tanboga20/turboprop-from-turboshaft/docs/figures/step310/access_en.png

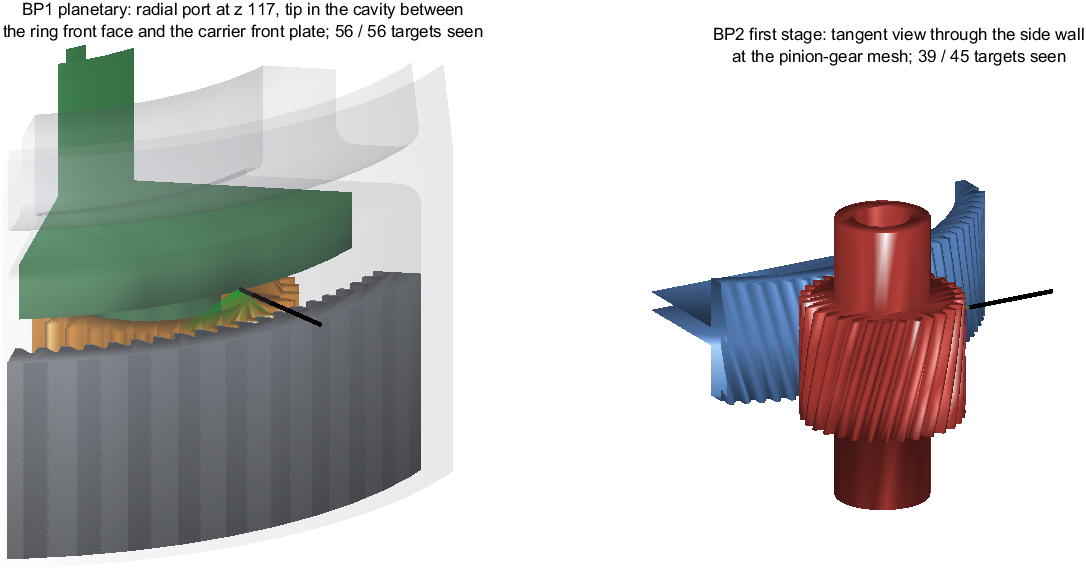
docs/figures/step310/access_en.png
