tanboga20/turboprop-from-turboshaft/cad/img/parts_strip.png

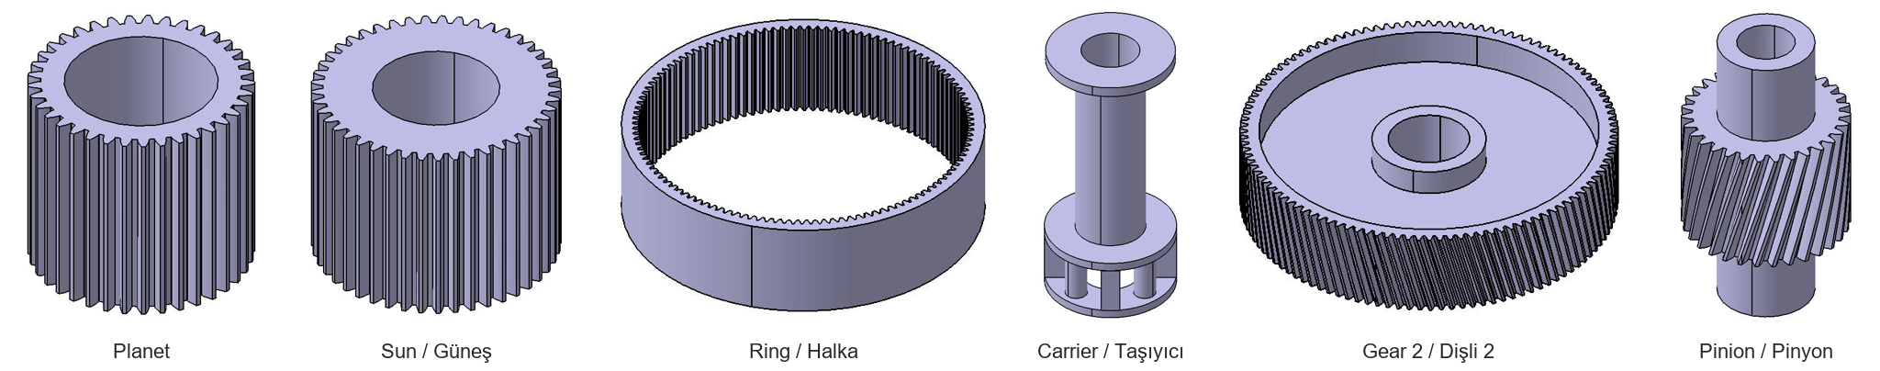
cad/img/parts_strip.png
