tanboga20/turboprop-from-turboshaft/safety/README.md

**EN.** Safety tables of step 3.7 (Phase 3): the fault tree of propeller release (SAF-01, CS-E 510), the FMEA of the RGB and its oil system, the critical parts list (SAF-02, CS-E 515), the damage tolerance results and the fire assessment (SAF-05, CS-E 130). `calc/safety/run_step37.m` writes the computed tables here; the FMEA is written by hand and checked by `calc/safety/sf_fmea.m`. The basis is Section 3.7 of the Phase 3 report.

| File | Content |
| --- | --- |
| `fta_cutsets_v1.csv` | Minimal cut sets of propeller release with their probability per engine flight hour (dual paths) or their kind (critical part, multi-fastener joint), the probability if the standby paths were never inspected and whether their inspection is an Airworthiness Limitations item |
| `fta_sensitivity_v1.csv` | Sensitivity of the fault tree: each assumed rate and demand failure x10 one at a time; the largest cut set and the inspection interval of the standby path that restores 1e-8 |
| `fta_common_cause_v1.csv` | Common-cause and zonal items with the design feature that covers each and why the independent product of the fault tree still holds (or the beta term that covers it) |
| `fta_lip_v1.csv` | Nose cover P116 with the catcher lip: LD-04 sizing of the lip (clamped annular plate) and bolts, mass, the 2-D run-down rub (shared and one-sided contact) against the hot yield, R7; the G1b QJ1024 follow-up (sf_qj): thrust floor, NJ1024 ratings, limp thrust, end play, the R4 branches, E7 p, the SYS-06 roll-up with and without the 3.9 offsets |
| `fta_e7_phases_v1.csv` | Total loss of oil (E7): the three phases (mist run, run-down to feathered, feathered) with the load path, load, QJ1024 state and probability |
| `ica_items_v1.csv` | Instructions for continued airworthiness that step 3.7 relies on (the 3.10 list): Airworthiness Limitations items, engine-manual items (CS-E 510(e)(1)) and maintenance tasks with their intervals |
| `fta_tube_check_v1.csv` | Retention tube P114 in the post-failure phase (axial anchors, no torque): stress at 1.5 x the limit thrust, and a bound with the propeller weight and the gyroscopic moment, with the reserve factors |
| `coupling_options_v1.csv`, `coupling_alignment_stack_v1.csv` | Diaphragm coupling options (H4) with the step 2.2 rules and the D4 result at the thinnest section, and the angular misalignment stack of the adopted option |
| `protection_coverage_v1.csv` | Shaft-break and load-loss protection: for each break location of the drive chain, the speed signal that detects it (3% mismatch of the core PT-rotor Np against Nr, or the absolute Np trip with a confirming cue), the PT-side inertia, the time to a closed fuel valve and the peak PT speed |
| `fta2_sensitivity_v1.csv`, `fta2_allowances_v1.csv` | D1b one-at-a-time x10 sensitivity, and the allowances (each from its own cut set) with the lowest value over the x10 cases |
| `fta2_cutsets_v1.csv` | Two dual-failure trees from the FMEA: PT overspeed (drive-chain break with the overspeed protection failed) and loss of propeller overspeed protection (PCU drive with the OSG drive failed; common cause gear 2 / intermediate shaft) |
| `fmea_v1.csv` | FMEA of the RGB and its oil system (written by hand): item, function, failure mode, cause, local / RGB / engine effect, CS-E 510 class with the design features and before them, critical part, design feature, detection, mitigation, 3.10 / 3.11 item, owner |
| `fmea_summary_v1.csv` | Failure modes per item group and class (written by `sf_fmea`) |
| `fmea_hazardous_v1.csv` | Failure modes hazardous before mitigation with the critical part or design feature that covers each |
| `fmea_major_rates_v1.csv` | Major engine effects (CS-E 510(a)(2), (a)(4)) with the FMEA rows, a rate per engine flight hour (TBR) and its source, against Remote (1e-5) |
| `critical_parts_v1.csv` | Critical parts (SAF-02, CS-E 515) and the parts judged not critical with the reason; D4 location, approved life and its basis, anomaly life, failure size on the initial shape (a/c = 1), the end point (a, c) of the growth from the governing NDT size, inspection interval, embedded-flaw margin, plan items (process controls, NDT at manufacture and at TBO, damage limits, recording loop, fixed processes, validation, life tracking, 3.11 tests) |
| `dt_v1.csv` | Damage tolerance per location (EASA CM-PIFS-007): crack plane, stress cycles on it, K at the initial flaw, threshold, anomaly life (growth from the first cycle), HCF threshold size, critical size, NDT method, the crack reached from the governing NDT size, inspection interval and NDT margin; base case and the sensitivity on C, the threshold, K_IC and a steel threshold of 2.0 at every R (reported) |
| `dt_thread_options_v1.csv` | P103 KM24 thread root: the drawing thread and the options (MJ thread, local 95 mm bore, both) against the rule a_HCF >= 1.25 x the NDT depth, with the added mass and the option adopted |
| `dt_carrier_boss_v1.csv` | P103 carrier pin bore: a_HCF, inspection interval and mass against the rim ligament with local bosses |
| `dt_m1p_v1.csv` | 1P moment sensitivity of the P103 seat, the thread, the case flange junction and the shoulder-ring groove (ICD-10 note) |
| `open_items_37.csv` | Open items of step 3.7 at the scope freeze: id, item, why open, carried to, status |
| `fire_joint_v1.csv` | The P101 / F201 joint in the fire (2-D r-z, with and without the partition): bolt-head seat on P101, insert in F201, F201 face, O-ring groove on both sides, hottest P101 and F201 temperatures; O-ring rating, hot yield at the seat and the insert, residual preload with and without the steel washer, residual clamp against the operating joint load |
| `fire_v1.csv` | Fire assessment of the A357 walls (cylindrical 1-D) in the ISO 2685 flame at its upper tolerance from the hot sink (170 degC): oil-side h of the drain film at the lowest flow (or the no-film value), 5 min with flow then the zero-flow phase; flame-side, mean and oil-side temperatures (molten: NaN), film rise, hot yield against the operating stress, secondary thermal stress, smallest passing h, oil-side temperature against the flash point and auto-ignition, times to the loss of strength and to the solidus after the flow stops |
| `nr_verification_v1.csv` | Newman-Raju K equations against the published finite-element values (NASA TP-1578 Table I, NASA TM-85793 Table 2, NASA TM-89070 Table 1) |

**TR.** 3.7 adımının (Faz 3) emniyet tabloları: pervanenin ayrılmasının hata ağacı (SAF-01, CS-E 510), RGB ve yağ sisteminin FMEA'sı, kritik parça listesi (SAF-02, CS-E 515), hasar toleransı sonuçları ve yangın değerlendirmesi (SAF-05, CS-E 130). `calc/safety/run_step37.m` hesaplanan tabloları buraya yazar; FMEA elle yazılır ve `calc/safety/sf_fmea.m` ile kontrol edilir. Esas, Faz 3 raporunun 3.7 bölümüdür.

| Dosya | İçerik |
| --- | --- |
| `fta_cutsets_v1.csv` | Pervanenin ayrılmasının en küçük kesim kümeleri; çift yollar için motor uçuş saati başına olasılık, diğerleri için türü (kritik parça, çok cıvatalı bağlantı), yedek yollar hiç muayene edilmeseydi olasılık ve muayenenin Uçuşa Elverişlilik Sınırlamaları maddesi olup olmadığı |
| `fta_sensitivity_v1.csv` | Hata ağacının duyarlılığı: her varsayılan oran ve devreye girme hasarı tek tek 10 kat; en büyük kesim kümesi ve 1e-8'i geri getiren yedek yol muayene aralığı |
| `fta_common_cause_v1.csv` | Ortak neden ve bölgesel maddeler, her birini karşılayan tasarım özelliği ve hata ağacının bağımsız çarpımının neden geçerli kaldığı (veya onu karşılayan beta terimi) |
| `fta_lip_v1.csv` | Yakalama dudaklı burun kapağı P116: dudağın (ankastre halka plak) ve cıvataların LD-04 boyutlandırması, kütle, sıcak akmaya karşı 2-B yavaşlama sürtünmesi (ortak ve tek taraflı temas), R7; G1b QJ1024 takibi (sf_qj): itki tabanı, NJ1024 kapasiteleri, topal mod itkisi, eksenel boşluk, R4 dalları, E7 p, 3.9 dengelemeleriyle ve dengelemesiz SYS-06 toplamı |
| `fta_e7_phases_v1.csv` | Tüm yağın kaybı (E7): üç evre (sis çalışması, tüylenene kadar yavaşlama, tüylenmiş) yük yolu, yük, QJ1024 durumu ve olasılıkla |
| `ica_items_v1.csv` | 3.7 adımının dayandığı sürekli uçuşa elverişlilik talimatları (3.10 listesi): Uçuşa Elverişlilik Sınırlamaları maddeleri, motor el kitabı maddeleri (CS-E 510(e)(1)) ve bakım görevleri, aralıklarıyla |
| `fta_tube_check_v1.csv` | Birincil hasardan sonra tutma tüpü P114 (eksenel bağlantılar, tork yok): 1,5 x sınır itkisinde gerilme ve pervane ağırlığı ile jiroskopik momenti de içeren üst sınır, emniyet katsayılarıyla |
| `coupling_options_v1.csv`, `coupling_alignment_stack_v1.csv` | Diyafram kavrama seçenekleri (H4), adım 2.2 kuralları ve en ince kesitte D4 sonucu, seçilen seçeneğin açısal kaçıklık zinciri |
| `protection_coverage_v1.csv` | Mil kopması ve yük kaybı koruması: tahrik zincirindeki her kırılma yeri için onu algılayan hız sinyali (çekirdek PT rotoru Np'sinin Nr ile %3 farkı veya teyitli mutlak Np kesmesi), PT tarafı ataleti, yakıt vanasının kapanma süresi ve PT tepe devri |
| `fta2_sensitivity_v1.csv`, `fta2_allowances_v1.csv` | D1b tek tek x10 duyarlılığı ve paylar (her biri kendi kesim kümesinden), x10 durumlarındaki en düşük değerle |
| `fta2_cutsets_v1.csv` | FMEA'dan iki çift hata ağacı: PT aşırı devri (tahrik zinciri kopması ve aşırı devir korumasının arızası) ve pervane aşırı devir korumasının kaybı (PCU tahriki ve OSG tahriki arızası; ortak neden dişli 2 / ara mil) |
| `fmea_v1.csv` | RGB ve yağ sisteminin FMEA'sı (elle yazılır): parça, işlev, hata modu, neden, yerel / RGB / motor etkisi, tasarım özellikleriyle ve onlarsız CS-E 510 sınıfı, kritik parça, tasarım özelliği, algılama, önlem, 3.10 / 3.11 maddesi, sahibi (İngilizce metin; madde ve mod adları Türkçe de var) |
| `fmea_summary_v1.csv` | Parça grubu ve sınıfa göre hata modu sayıları (`sf_fmea` yazar) |
| `fmea_hazardous_v1.csv` | Önlemsiz tehlikeli hata modları ve her birini karşılayan kritik parça veya tasarım özelliği |
| `fmea_major_rates_v1.csv` | Büyük motor etkileri (CS-E 510(a)(2), (a)(4)): FMEA satırları, motor uçuş saati başına oran (TBR) ve kaynağı, Remote (1e-5) sınırına göre |
| `critical_parts_v1.csv` | Kritik parçalar (SAF-02, CS-E 515) ve kritik sayılmayanlar ile gerekçesi; D4 konumu, onaylı ömür ve esası, kusur ömrü, ilk şekilde (a/c = 1) hasar boyu, belirleyici NDT boyundan büyümenin uç noktası (a, c), muayene aralığı, gömülü kusur payı, plan maddeleri (süreç kontrolleri, üretimde ve TBO'da NDT, hasar sınırları, kayıt döngüsü, sabit süreçler, doğrulama, ömür takibi, 3.11 deneyleri) |
| `dt_v1.csv` | Konum başına hasar toleransı (EASA CM-PIFS-007): çatlak düzlemi, o düzlemdeki gerilme çevrimleri, ilk kusurda K, eşik, kusur ömrü (ilk çevrimden büyüme), HCF eşik boyu, kritik boy, NDT yöntemi, belirleyici NDT boyundan ulaşılan çatlak, muayene aralığı ve NDT payı; temel durum ve C, eşik, K_IC ile her R'de 2,0 çelik eşiği (bilgi) duyarlılığı |
| `dt_thread_options_v1.csv` | P103 KM24 diş dibi: resimdeki diş ve seçenekler (MJ diş, yerel 95 mm delik, ikisi birden), a_HCF >= 1,25 x NDT derinliği kuralına göre; eklenen kütle ve seçilen seçenek |
| `dt_carrier_boss_v1.csv` | P103 taşıyıcı pim deliği: yerel çıkıntılarla dış bağ kalınlığına göre a_HCF, muayene aralığı ve kütle |
| `dt_m1p_v1.csv` | P103 yuvası, diş, gövde flanş birleşimi ve omuz halkası kanalının 1P momenti duyarlılığı (ICD-10 notu) |
| `open_items_37.csv` | 3.7'nin kapsam dondurmadaki açık maddeleri: kimlik, madde, neden açık, taşındığı yer, durum |
| `fire_joint_v1.csv` | Yangında P101 / F201 birleşimi (2-B r-z, bölmeli ve bölmesiz): P101'de cıvata başı yuvası, F201'de insert, F201 yüzü, iki taraftaki O-ring kanalı, en sıcak P101 ve F201 sıcaklıkları; O-ring sınırı, yuva ve insertte sıcak akma, çelik pulla ve pulsuz kalan ön yük, işletme bağlantı yüküne karşı kalan sıkma |
| `fire_v1.csv` | A357 duvarlarının (silindirik 1-B) üst toleranstaki ISO 2685 alevinde, sıcak batmadan (170 °C) yangın değerlendirmesi: en düşük akışta boşaltma filminin (ya da filmsiz değerin) yağ tarafı h'si, 5 dk akışla ve ardından akışsız evre; alev tarafı, ortalama ve yağ tarafı sıcaklıkları (eriyik: NaN), film ısınması, işletme gerilmesine karşı sıcak akma, ikincil ısıl gerilme, geçen en küçük h, yağ tarafı sıcaklığının parlama ve kendiliğinden tutuşma noktalarına göre durumu, akış durduktan sonra dayanım kaybına ve katılaşmaya kadar süreler |
| `nr_verification_v1.csv` | Newman-Raju K denklemlerinin yayımlanmış sonlu eleman değerleriyle karşılaştırması (NASA TP-1578 Tablo I, NASA TM-85793 Tablo 2, NASA TM-89070 Tablo 1) |

FMEA notes. Installation fire assumptions: the designated fire zone, fire detection and extinguishing are aircraft items declared under CS-E 30; the fuel shut-off at the firewall is the aircraft's; the RGB has no oil shut-off. Every row marked latent cites an ICA task with its interval (`ica_items_v1.csv`); the maintenance-error group names its error-proofing or ICA procedure.

FMEA notları. Kurulum yangın kabulleri: tanımlı yangın bölgesi, yangın algılama ve söndürme CS-E 30 kapsamında beyan edilen uçak maddeleri; güvenlik duvarındaki yakıt kesme uçağın; RGB'de yağ kesme valfi yok. Gizli işaretli her satır aralığıyla bir KTT görevine dayanır (`ica_items_v1.csv`); bakım hatası grubu hata önleyici tasarımını veya KTT prosedürünü belirtir.
