tanboga20/turboprop-from-turboshaft/docs/notes/phase3.md

# Phase notes: Phase 3 (manufacturing documents, verification)

- 3.1 Complete CATIA model: 57 instances, 3 modules, clash 0 interference (83 intended contacts); first CAD roll-up 114.6 kg; lightening package A -> 107.7 kg; SYS-06 limit raised to 110 kg TBR (author decision). Layout: first-stage gear centre z -76, offset 146 mm (PT axis below), accessory angles generator 43 deg, PCU 124 deg.
- 3.2 Oil hardware in CATIA, network re-solved: regulating valve 550 kPa, 32 jets 536-557 kPa (1.13-6.5 x design flow), idle 296 kPa (LUB-03 >= 34.5); -40 C start: jets dry until oil ~11 C (~9 min idle) -> minimum oil temperature before power; tank within 150 mm, 32 mm suction; pump inlet 50.3 kPa abs at 45,000 ft; neg-g 11 s. LUB-07 decision: >= 6 min at 75% MCP with emergency air-oil mist (2.78 kg); analysis 6.3-6.6 min. Mass 111.1 kg.
- 3.3 ICD v1: 34 items (aircraft 9, nacelle 3, propeller 5, core 10, suppliers 6, own 1); 7 watch items (planet bearing speed 0.997 at 110%, generator dia <= 201.6 mm, PT stop >= 0.22 s, bleed air <= ~180 C, mount stiffness >= 2.1e8, neg-g <= 11 s, 1P <= 4,900 N m). Oil decision: MIL-PRF-23699 only + ground preheat (Type I at 100 C inlet gives planet L10m 5,740 h < 12,000). SYS-11 input drive <= 6 kg (5.46 kg).
- 3.4 Materials/processes/BOM 78 lines: Pyrowear 53 carburized gears (case 0.5-0.7 mm, planet ring-side needs 0.43 at LD-02), nitrided 32CrMoV13 ring, AISI 4340 carrier + 120/100 shaft, separate carburized M50NiL planet pins, Ti-6Al-4V tube, A357-T6 cases; superfinish Ra <= 0.15 um; steel seat liners; manufacturing routes for planet, carrier, planetary case.
- 3.5 3-D FE (MATLAB PDE Toolbox, quadratic tets, CATIA STEP): planetary case limit 36 MPa (yield SF 5.4 incl casting factor), seat 1.0e8 N/m, 1P fatigue 5.2; carrier LD-08 yield 3.1 (2.53 with 10 mm plates); findings: PT-axis mount puts prop load through 6 mm first-stage walls (653 MPa, SF 0.29) -> mounts moved to planetary-case flange (author decision, mount card A, ICD-24) + rear wall 16 mm; flange 30 x M6 slip safety 0.52 -> 6 x d10 dowels; NU1024 boss +3.8 mm; 2.8 load-direction error corrected. Mass card B: carrier plates 10 mm -> roll-up 108.45 kg. Sun-planet S_H 1.28.
- 3.6 Forced response: TE design values 0.5/0.15/0.1 um planetary (STR-11 TE2 <= 0.15), planet modes 3,309/4,008/6,658/7,370 Hz (corrects 2.8), K_v,FE 1.11/1.37/1.14, S_F >= 1.55; planetary case coupled to planets (ring-seat receptance), steady 16.7 MPa + 12.2 MPa alternating, Goodman >= 1.19 at flange junction (hot 1.21) -> DYN-03 met TBR; design change flange PCD 290 -> 308, OD 325, R10/R5 fillets; first-stage gear web: friction damping ring 8 x 4 mm, 0.164 kg (rule s <= 0.6); first-stage case Goodman 2.54. Axisymmetric harmonic FE models (low RAM). Mass 109.24 kg.
- 3.7 Safety: FTA (AC 33.75-1A) propeller separation largest cut set 2.1e-9/h, sum 3.3e-9/h; FMEA 100 modes: 13 hazardous, 44 major, 43 minor (51 hazardous without features); 7 critical parts (PT output shaft, RGB input shaft, P103 carrier/prop shaft, P111 bearing housing, planetary case, P117 shoulder ring, two diaphragm couplings); damage tolerance CM-PIFS-007 (0.762 x 0.381 mm anomaly, Newman-Raju): shortest life 7,195 cycles vs 3,000 target; 3 locations rely on process control (HIP, CT/RT, 0.5 mm pores); fire ISO 2685 1100 C 116 kW/m2: oil-wetted walls pass 5 min, dry walls/O-rings/zero-flow open (SAF-05 open). Nose cover P116 catcher lip, NJ1024 standby, thrust floor CTL-04. 18 open items. Mass 110.10 -> 109.95 with 3.9 scallops.
- 3.8 Tolerances ASME Y14.5-2018, ISO 286, ISO 1328-1:2013 gear class, ISO 4156 splines; 5 thermal states; Monte Carlo stacks (+-3 sigma): K_gamma P99 1.257 (limit 1.35); backlash positive in cold start; ring seat closed to LD-02; 72 callouts; lip gap conflict -> 0.80-1.00 mm at 20 C on drawing (3.9).
- 3.9 Representative drawing set: planet P107, carrier/prop shaft P103, planetary case P101, RGB assembly (89-line parts list); 114-row drawing checklist; views from Phase 2 model (OI-16), tables govern.
- 3.10 HUMS synthetic signal; FM4/NA4 alarm at crack a 0.05; ENV at spall b 0.5 m/s2; SER weak (sequential phasing cancels order 45); thresholds log-normal pfa 1e-3/1e-6 from 50 records; borescope BP1 56/56, BP2 39/45; maintenance tasks: RGB off 2.6 h + on 4.7 h = 7.3 h; MNT-01 8 h TBR.
- 3.11 Verification: 69 reqs, 39 need test; 25 tests (2 coupon, 1 inspection, 11 rig, 10 engine, 1 demonstration); water-brake test cell 9 measuring point groups; 6-stage sequence.
- 3.12 Comparison (TCDS): ratio 12.93 vs 15.90 (CT7-9) vs 17.58 (PT6A-67A); gearbox mass derived CT7-9 170.5 kg (upper bound), PT6A-67A 57-72 kg; ours 109.95 at top of CT7-9 scaled band 95-110; 8.14 kW/kg vs 7.65; planetary module 66.4 kg in PT6A band; engine ~315 kg dry, +85.5 kg vs PT6A-67A (3.2% of 2,700 kg payload).
- v4: 69 req (3 new SYS-11, STR-11, CTL-04; 10 changed); Agreed 28 / TBR 34 / TBD 7; compliance met 34, partial 19, open 7, tbd 9, risk 0; closure test 52, shown 19, ICD 26.
- Scan findings (honest limits): mass margin 0.05 kg; OI-15 mount reaction 7.45-7.49 kN m vs 6.4 kN m in ICD-24 (flange clamp margin ~2.5x, not rechecked); SAF-05 fire seals; CAD still Phase 2 geometry for later changes (OI-16).
