tanboga20/turboprop-from-turboshaft/cad/assy/clash_report.csv

first | second | type | value_mm
i1_case | i2_ring | contact | 0.000
i1_case | i14_brg_NU1024 | contact | 0.000
i1_case | i15_brg_NU1024 | contact | 0.000
i1_case | i16_brg_QJ1024 | contact | 0.000
i1_case | i17_qj_housing | contact | 0.000
i1_case | i22_fs_case | contact | 0.000
i1_case | i1014_oil_jet_060 | clash | -9.833
i1_case | i1015_oil_jet_060 | clash | -9.833
i1_case | i1035_oil_route_11 | clash | -36.203
i1_case | i1036_oil_route_12 | clash | -71.106
i1_case | i1037_oil_transfer_sleeve | contact | 0.000
i1_case | i1043_oil_chip_detector | clash | -14.568
i2_ring | i6_planet | contact | 0.000
i2_ring | i8_planet | contact | 0.000
i2_ring | i10_planet | contact | 0.000
i2_ring | i12_planet | contact | 0.000
i3_carrier | i7_planet_rollers | contact | 0.000
i3_carrier | i9_planet_rollers | contact | 0.000
i3_carrier | i11_planet_rollers | contact | 0.000
i3_carrier | i13_planet_rollers | contact | 0.000
i3_carrier | i14_brg_NU1024 | contact | 0.000
i3_carrier | i15_brg_NU1024 | contact | 0.000
i3_carrier | i16_brg_QJ1024 | contact | 0.000
i3_carrier | i18_nut_KM24 | contact | 0.000
i3_carrier | i21_prop_flange | contact | 0.000
i3_carrier | i1017_oil_jet_066 | clash | -7.706
i3_carrier | i1018_oil_jet_066 | clash | -7.706
i3_carrier | i1019_oil_jet_066 | clash | -7.706
i3_carrier | i1020_oil_jet_066 | clash | -7.706
i3_carrier | i1021_oil_jet_066 | clash | -7.706
i3_carrier | i1022_oil_jet_066 | clash | -7.706
i3_carrier | i1023_oil_jet_066 | clash | -7.706
i3_carrier | i1024_oil_jet_066 | clash | -7.706
i3_carrier | i1036_oil_route_12 | clash | -53.103
i3_carrier | i1037_oil_transfer_sleeve | contact | 0.000
i4_sun | i5_sun_quill | contact | 0.000
i4_sun | i6_planet | contact | 0.000
i4_sun | i8_planet | contact | 0.000
i4_sun | i10_planet | contact | 0.000
i4_sun | i12_planet | contact | 0.000
i5_sun_quill | i25_mid_shaft | contact | 0.000
i6_planet | i7_planet_rollers | contact | 0.000
i7_planet_rollers | i1036_oil_route_12 | contact | 0.000
i8_planet | i9_planet_rollers | contact | 0.000
i9_planet_rollers | i1036_oil_route_12 | contact | 0.000
i10_planet | i11_planet_rollers | contact | 0.000
i11_planet_rollers | i1036_oil_route_12 | contact | 0.000
i12_planet | i13_planet_rollers | contact | 0.000
i13_planet_rollers | i1036_oil_route_12 | contact | 0.000
i14_brg_NU1024 | i1014_oil_jet_060 | contact | 0.000
i15_brg_NU1024 | i1015_oil_jet_060 | contact | 0.000
i16_brg_QJ1024 | i17_qj_housing | contact | 0.000
i16_brg_QJ1024 | i18_nut_KM24 | contact | 0.000
i16_brg_QJ1024 | i1016_oil_jet_060 | contact | 0.000
i17_qj_housing | i19_seal_prop | contact | 0.000
i17_qj_housing | i1016_oil_jet_060 | clash | -7.424
i17_qj_housing | i1035_oil_route_11 | clash | -14.073
i22_fs_case | i26_brg_NU2210 | contact | 0.000
i22_fs_case | i27_brg_NU2209 | contact | 0.000
i22_fs_case | i28_brg_NU2210 | contact | 0.000
i22_fs_case | i29_brg_NU2209 | contact | 0.000
i22_fs_case | i30_brg_QJ210 | contact | 0.000
i22_fs_case | i31_brg_QJ209 | contact | 0.000
i22_fs_case | i35_acc_cover | contact | 0.000
i22_fs_case | i38_gen_cartridge | contact | 0.000
i22_fs_case | i39_brg_6305 | contact | 0.000
i22_fs_case | i44_osg_adapter | contact | 0.000
i22_fs_case | i45_brg_6202 | contact | 0.000
i22_fs_case | i50_brg_6203 | contact | 0.000
i22_fs_case | i1003_oil_jet_084 | clash | -9.883
i22_fs_case | i1004_oil_jet_084 | clash | -9.883
i22_fs_case | i1005_oil_jet_084 | clash | -9.883
i22_fs_case | i1006_oil_jet_060 | clash | -8.600
i22_fs_case | i1007_oil_jet_060 | clash | -8.600
i22_fs_case | i1008_oil_jet_060 | clash | -8.600
i22_fs_case | i1012_oil_jet_060 | clash | -8.577
i22_fs_case | i1025_oil_route_01 | clash | -27.041
i22_fs_case | i1026_oil_route_02 | clash | -65.237
i22_fs_case | i1027_oil_route_03 | clash | -4.516
i22_fs_case | i1028_oil_route_04 | clash | -74.029
i22_fs_case | i1029_oil_route_05 | clash | -47.915
i22_fs_case | i1030_oil_route_06 | clash | -34.949
i22_fs_case | i1032_oil_route_08 | clash | -38.672
i22_fs_case | i1033_oil_route_09 | contact | 0.000
i22_fs_case | i1042_oil_chip_detector | clash | -14.419
i22_fs_case | i1045_oil_sample_valve | clash | -15.652
i23_gear2 | i24_pinion | contact | 0.000
i23_gear2 | i25_mid_shaft | contact | 0.000
i23_gear2 | i36_gen_gear | contact | 0.000
i24_pinion | i27_brg_NU2209 | contact | 0.000
i24_pinion | i29_brg_NU2209 | contact | 0.000
i24_pinion | i31_brg_QJ209 | contact | 0.000
i24_pinion | i33_nut_KM9 | contact | 0.000
i24_pinion | i34_seal_input | contact | 0.000
i25_mid_shaft | i26_brg_NU2210 | contact | 0.000
i25_mid_shaft | i28_brg_NU2210 | contact | 0.000
i25_mid_shaft | i30_brg_QJ210 | contact | 0.000
i25_mid_shaft | i32_nut_KM10 | contact | 0.000
i25_mid_shaft | i48_pcu_gear | contact | 0.000
i25_mid_shaft | i54_quill_pump | contact | 0.000
i26_brg_NU2210 | i1006_oil_jet_060 | contact | 0.000
i27_brg_NU2209 | i1003_oil_jet_084 | contact | 0.000
i27_brg_NU2209 | i1042_oil_chip_detector | contact | 0.000
i28_brg_NU2210 | i30_brg_QJ210 | contact | 0.000
i28_brg_NU2210 | i1007_oil_jet_060 | contact | 0.000
i29_brg_NU2209 | i31_brg_QJ209 | contact | 0.000
i29_brg_NU2209 | i1004_oil_jet_084 | contact | 0.000
i30_brg_QJ210 | i32_nut_KM10 | contact | 0.000
i30_brg_QJ210 | i1008_oil_jet_060 | contact | 0.000
i31_brg_QJ209 | i33_nut_KM9 | contact | 0.000
i31_brg_QJ209 | i1005_oil_jet_084 | contact | 0.000
i35_acc_cover | i49_pcu_adapter | contact | 0.000
i35_acc_cover | i51_brg_6203 | contact | 0.000
i35_acc_cover | i53_pump_pack | contact | 0.000
i35_acc_cover | i1031_oil_route_07 | clash | -22.037
i35_acc_cover | i1033_oil_route_09 | contact | 0.000
i35_acc_cover | i1034_oil_route_10 | clash | -16.805
i36_gen_gear | i37_gen_shaft | contact | 0.000
i37_gen_shaft | i39_brg_6305 | contact | 0.000
i37_gen_shaft | i40_brg_6305 | contact | 0.000
i37_gen_shaft | i42_quill_gen | contact | 0.000
i37_gen_shaft | i43_osg_gear | contact | 0.000
i38_gen_cartridge | i40_brg_6305 | contact | 0.000
i38_gen_cartridge | i55_unit_generator | contact | 0.000
i38_gen_cartridge | i1013_oil_jet_060 | clash | -9.850
i38_gen_cartridge | i1032_oil_route_08 | clash | -11.612
i38_gen_cartridge | i1033_oil_route_09 | clash | -7.565
i39_brg_6305 | i1012_oil_jet_060 | contact | 0.000
i40_brg_6305 | i1013_oil_jet_060 | contact | 0.000
i43_osg_gear | i45_brg_6202 | contact | 0.000
i43_osg_gear | i46_brg_6202 | contact | 0.000
i43_osg_gear | i47_quill_osg | contact | 0.000
i44_osg_adapter | i46_brg_6202 | contact | 0.000
i44_osg_adapter | i56_unit_OSG | contact | 0.000
i48_pcu_gear | i50_brg_6203 | contact | 0.000
i48_pcu_gear | i51_brg_6203 | contact | 0.000
i48_pcu_gear | i52_quill_pcu | contact | 0.000
i49_pcu_adapter | i51_brg_6203 | contact | 0.000
i49_pcu_adapter | i57_unit_PCU | contact | 0.000
i53_pump_pack | i54_quill_pump | contact | 0.000
i53_pump_pack | i1034_oil_route_10 | contact | 0.000
i55_unit_generator | i1033_oil_route_09 | contact | 0.000
i1001_oil_jet_102 | i1025_oil_route_01 | contact | 0.000
i1002_oil_jet_155 | i1026_oil_route_02 | contact | 0.000
i1003_oil_jet_084 | i1027_oil_route_03 | contact | 0.000
i1004_oil_jet_084 | i1027_oil_route_03 | contact | 0.000
i1005_oil_jet_084 | i1027_oil_route_03 | contact | 0.000
i1006_oil_jet_060 | i1028_oil_route_04 | contact | 0.000
i1007_oil_jet_060 | i1028_oil_route_04 | contact | 0.000
i1008_oil_jet_060 | i1028_oil_route_04 | contact | 0.000
i1009_oil_jet_060 | i1029_oil_route_05 | contact | 0.000
i1010_oil_jet_060 | i1030_oil_route_06 | contact | 0.000
i1011_oil_jet_060 | i1031_oil_route_07 | contact | 0.000
i1012_oil_jet_060 | i1032_oil_route_08 | contact | 0.000
i1013_oil_jet_060 | i1032_oil_route_08 | contact | 0.000
i1014_oil_jet_060 | i1035_oil_route_11 | contact | 0.000
i1015_oil_jet_060 | i1035_oil_route_11 | contact | 0.000
i1016_oil_jet_060 | i1035_oil_route_11 | clash | -3.498
i1017_oil_jet_066 | i1036_oil_route_12 | clash | -1.824
i1018_oil_jet_066 | i1036_oil_route_12 | clash | -1.824
i1019_oil_jet_066 | i1036_oil_route_12 | clash | -1.824
i1020_oil_jet_066 | i1036_oil_route_12 | clash | -1.824
i1021_oil_jet_066 | i1036_oil_route_12 | clash | -1.824
i1022_oil_jet_066 | i1036_oil_route_12 | clash | -1.824
i1023_oil_jet_066 | i1036_oil_route_12 | clash | -1.824
i1024_oil_jet_066 | i1036_oil_route_12 | clash | -1.824
i1025_oil_route_01 | i1026_oil_route_02 | clash | -7.800
i1025_oil_route_01 | i1027_oil_route_03 | clash | -7.447
i1025_oil_route_01 | i1028_oil_route_04 | clash | -7.424
i1025_oil_route_01 | i1029_oil_route_05 | clash | -7.447
i1025_oil_route_01 | i1030_oil_route_06 | clash | -7.447
i1025_oil_route_01 | i1031_oil_route_07 | contact | 0.000
i1025_oil_route_01 | i1032_oil_route_08 | clash | -7.447
i1025_oil_route_01 | i1033_oil_route_09 | contact | 0.000
i1025_oil_route_01 | i1034_oil_route_10 | contact | 0.000
i1025_oil_route_01 | i1035_oil_route_11 | clash | -7.353
i1025_oil_route_01 | i1036_oil_route_12 | clash | -7.353
i1025_oil_route_01 | i1039_oil_prv | clash | -3.594
i1026_oil_route_02 | i1027_oil_route_03 | clash | -7.471
i1026_oil_route_02 | i1028_oil_route_04 | clash | -7.424
i1026_oil_route_02 | i1029_oil_route_05 | clash | -7.400
i1026_oil_route_02 | i1030_oil_route_06 | clash | -7.424
i1026_oil_route_02 | i1031_oil_route_07 | contact | 0.000
i1026_oil_route_02 | i1032_oil_route_08 | clash | -7.447
i1026_oil_route_02 | i1033_oil_route_09 | contact | 0.000
i1026_oil_route_02 | i1034_oil_route_10 | contact | 0.000
i1026_oil_route_02 | i1035_oil_route_11 | clash | -7.353
i1026_oil_route_02 | i1036_oil_route_12 | clash | -7.353
i1026_oil_route_02 | i1039_oil_prv | clash | -3.594
i1027_oil_route_03 | i1028_oil_route_04 | clash | -7.400
i1027_oil_route_03 | i1029_oil_route_05 | clash | -7.400
i1027_oil_route_03 | i1030_oil_route_06 | clash | -7.447
i1027_oil_route_03 | i1031_oil_route_07 | contact | 0.000
i1027_oil_route_03 | i1032_oil_route_08 | clash | -7.377
i1027_oil_route_03 | i1033_oil_route_09 | contact | 0.000
i1027_oil_route_03 | i1034_oil_route_10 | contact | 0.000
i1027_oil_route_03 | i1035_oil_route_11 | clash | -7.330
i1027_oil_route_03 | i1036_oil_route_12 | clash | -7.330
i1027_oil_route_03 | i1039_oil_prv | clash | -3.498
i1027_oil_route_03 | i1040_oil_thermostat | clash | -3.594
i1028_oil_route_04 | i1029_oil_route_05 | clash | -7.377
i1028_oil_route_04 | i1030_oil_route_06 | clash | -7.377
i1028_oil_route_04 | i1031_oil_route_07 | contact | 0.000
i1028_oil_route_04 | i1032_oil_route_08 | clash | -7.306
i1028_oil_route_04 | i1033_oil_route_09 | contact | 0.000
i1028_oil_route_04 | i1034_oil_route_10 | contact | 0.000
i1028_oil_route_04 | i1035_oil_route_11 | clash | -7.235
i1028_oil_route_04 | i1036_oil_route_12 | clash | -7.235
i1028_oil_route_04 | i1039_oil_prv | clash | -3.450
i1028_oil_route_04 | i1040_oil_thermostat | clash | -3.450
i1029_oil_route_05 | i1030_oil_route_06 | clash | -7.424
i1029_oil_route_05 | i1031_oil_route_07 | contact | 0.000
i1029_oil_route_05 | i1032_oil_route_08 | clash | -7.400
i1029_oil_route_05 | i1033_oil_route_09 | contact | 0.000
i1029_oil_route_05 | i1034_oil_route_10 | contact | 0.000
i1029_oil_route_05 | i1035_oil_route_11 | clash | -7.377
i1029_oil_route_05 | i1036_oil_route_12 | clash | -7.377
i1029_oil_route_05 | i1039_oil_prv | clash | -3.594
i1030_oil_route_06 | i1031_oil_route_07 | contact | 0.000
i1030_oil_route_06 | i1032_oil_route_08 | clash | -7.447
i1030_oil_route_06 | i1033_oil_route_09 | contact | 0.000
i1030_oil_route_06 | i1034_oil_route_10 | contact | 0.000
i1030_oil_route_06 | i1035_oil_route_11 | clash | -7.377
i1030_oil_route_06 | i1036_oil_route_12 | clash | -7.377
i1030_oil_route_06 | i1039_oil_prv | clash | -3.498
i1030_oil_route_06 | i1040_oil_thermostat | clash | -3.594
i1031_oil_route_07 | i1032_oil_route_08 | contact | 0.000
i1031_oil_route_07 | i1033_oil_route_09 | clash | -7.353
i1031_oil_route_07 | i1034_oil_route_10 | clash | -7.471
i1031_oil_route_07 | i1035_oil_route_11 | contact | 0.000
i1031_oil_route_07 | i1036_oil_route_12 | contact | 0.000
i1031_oil_route_07 | i1039_oil_prv | clash | -3.450
i1031_oil_route_07 | i1041_oil_filter | clash | -3.594
i1032_oil_route_08 | i1033_oil_route_09 | contact | 0.000
i1032_oil_route_08 | i1034_oil_route_10 | contact | 0.000
i1032_oil_route_08 | i1035_oil_route_11 | clash | -7.377
i1032_oil_route_08 | i1036_oil_route_12 | clash | -7.377
i1032_oil_route_08 | i1039_oil_prv | clash | -3.498
i1032_oil_route_08 | i1040_oil_thermostat | clash | -3.594
i1033_oil_route_09 | i1034_oil_route_10 | clash | -7.400
i1033_oil_route_09 | i1035_oil_route_11 | contact | 0.000
i1033_oil_route_09 | i1036_oil_route_12 | contact | 0.000
i1033_oil_route_09 | i1039_oil_prv | clash | -3.498
i1033_oil_route_09 | i1041_oil_filter | clash | -3.594
i1034_oil_route_10 | i1035_oil_route_11 | contact | 0.000
i1034_oil_route_10 | i1036_oil_route_12 | contact | 0.000
i1034_oil_route_10 | i1039_oil_prv | clash | -3.450
i1034_oil_route_10 | i1041_oil_filter | clash | -3.546
i1035_oil_route_11 | i1036_oil_route_12 | clash | -7.612
i1035_oil_route_11 | i1039_oil_prv | clash | -3.498
i1035_oil_route_11 | i1040_oil_thermostat | clash | -3.642
i1036_oil_route_12 | i1037_oil_transfer_sleeve | clash | -12.106
i1036_oil_route_12 | i1039_oil_prv | clash | -3.498
i1036_oil_route_12 | i1040_oil_thermostat | clash | -3.642
i1039_oil_prv | i1041_oil_filter | contact | 0.000
i1039_oil_prv | i1049_lub07_lines | clash | -2.634
i1047_lub07_valve | i1049_lub07_lines | clash | -20.028
i1048_lub07_accumulator | i1049_lub07_lines | contact | 0.000
