tanboga20/turboprop-from-turboshaft/cad/img/acc_cover_back.png

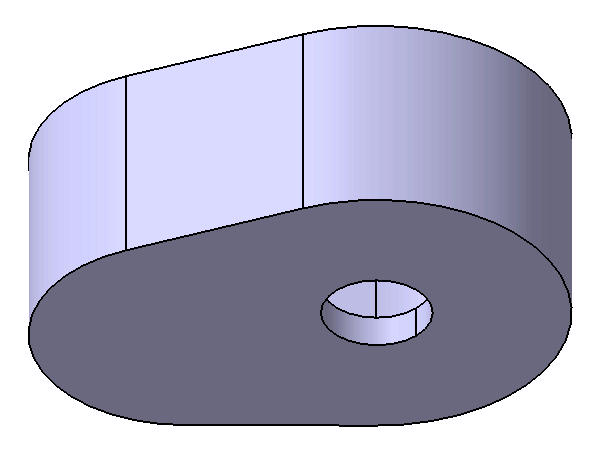
cad/img/acc_cover_back.png
