tanboga20/turboprop-from-turboshaft/cad/img/acc_cover_iso.png

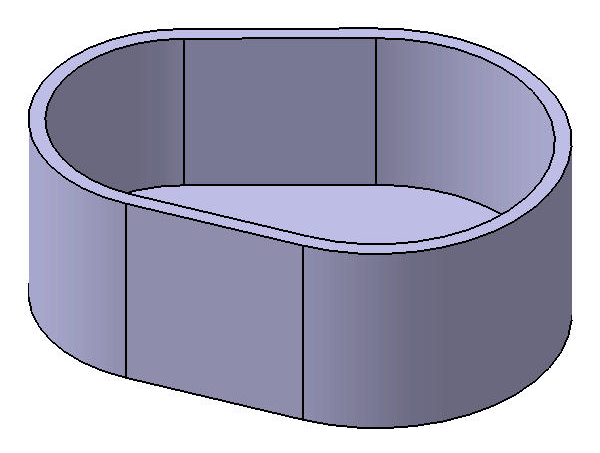
cad/img/acc_cover_iso.png
