tanboga20/turboprop-from-turboshaft/cad/img/carrier_iso.png

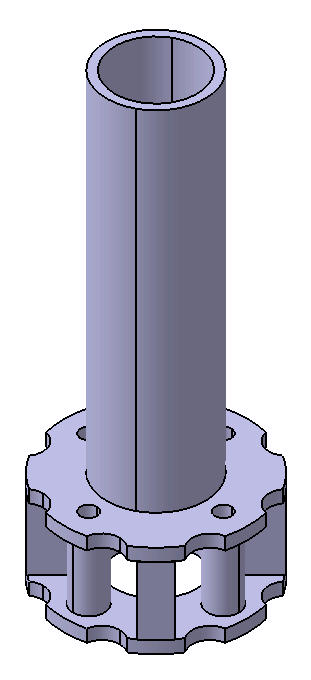
cad/img/carrier_iso.png
