tanboga20/turboprop-from-turboshaft/cad/img/case_back.png

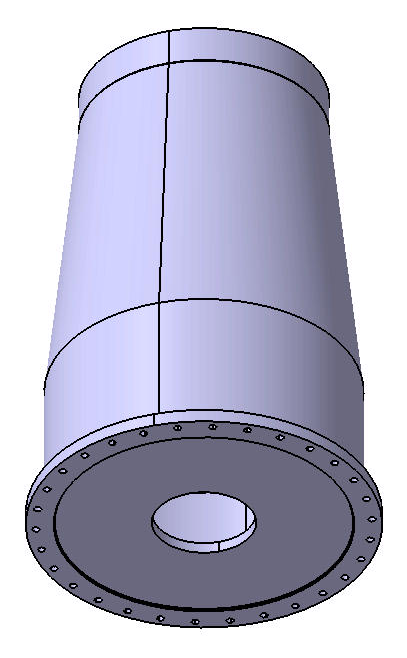
cad/img/case_back.png
