tanboga20/turboprop-from-turboshaft/cad/img/case_iso.png

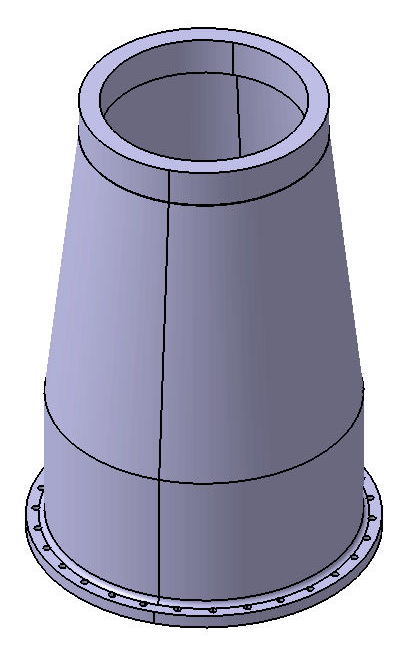
cad/img/case_iso.png
