tanboga20/turboprop-from-turboshaft/cad/img/case_side.png

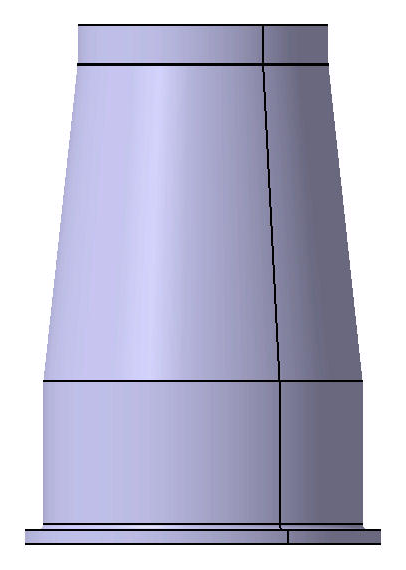
cad/img/case_side.png
