tanboga20/turboprop-from-turboshaft/cad/img/fs_case_back.png

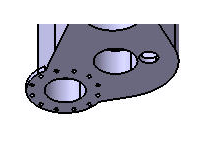
cad/img/fs_case_back.png
