tanboga20/turboprop-from-turboshaft/cad/img/fs_case_iso.png

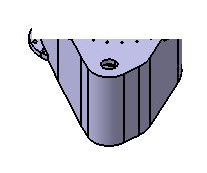
cad/img/fs_case_iso.png
