tanboga20/turboprop-from-turboshaft/cad/img/gear2_iso.png

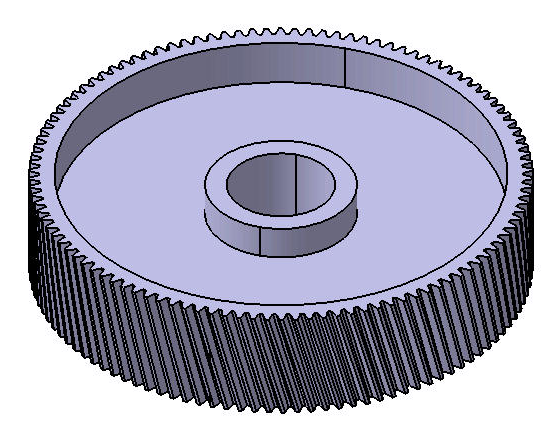
cad/img/gear2_iso.png
