tanboga20/turboprop-from-turboshaft/cad/img/gen_gear_iso.png

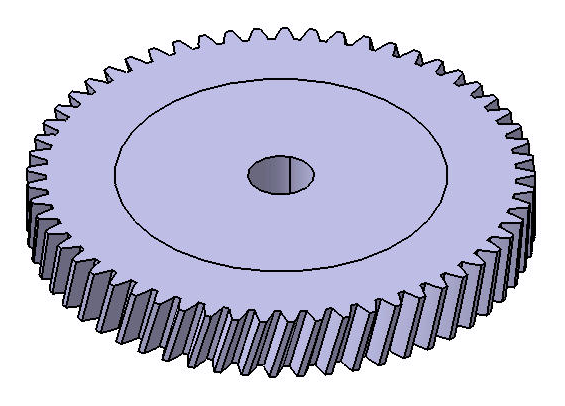
cad/img/gen_gear_iso.png
