tanboga20/turboprop-from-turboshaft/cad/img/pinion_iso.png

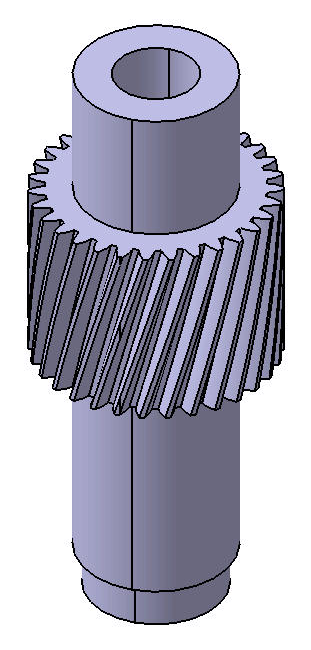
cad/img/pinion_iso.png
