tanboga20/turboprop-from-turboshaft/cad/img/planet_iso.png

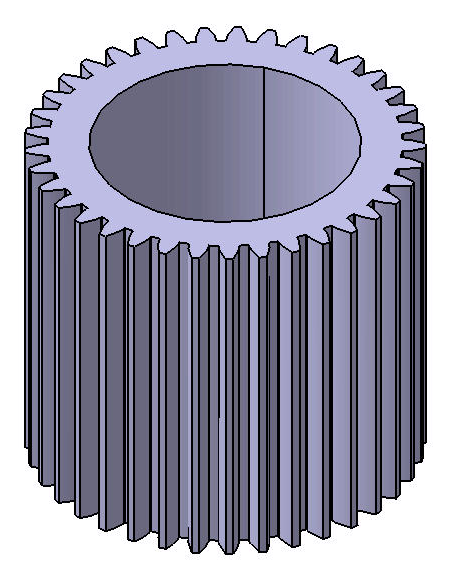
cad/img/planet_iso.png
