tanboga20/turboprop-from-turboshaft/cad/img/rgb3_back.png

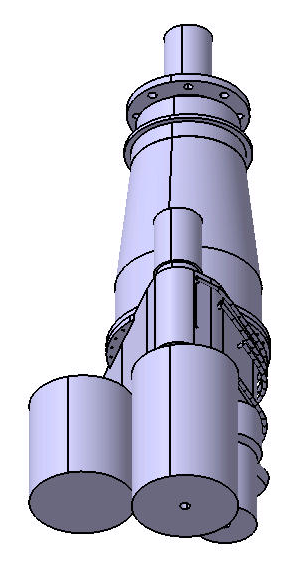
cad/img/rgb3_back.png
