tanboga20/turboprop-from-turboshaft/cad/img/rgb3_internals_back.png

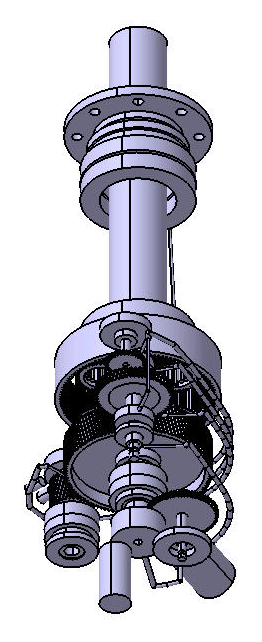
cad/img/rgb3_internals_back.png
