tanboga20/turboprop-from-turboshaft/cad/img/rgb3_internals_iso.png

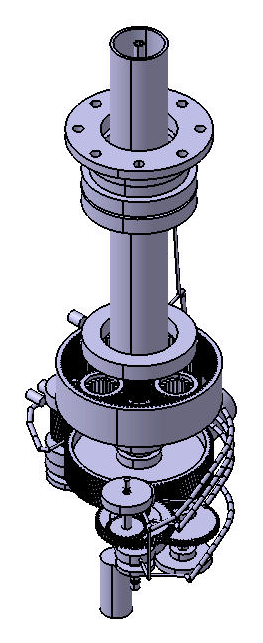
cad/img/rgb3_internals_iso.png
