tanboga20/turboprop-from-turboshaft/cad/img/rgb3_internals_side.png

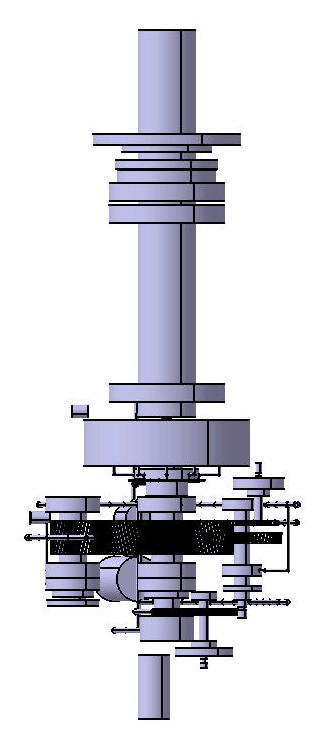
cad/img/rgb3_internals_side.png
