tanboga20/turboprop-from-turboshaft/cad/img/rgb3_iso.png

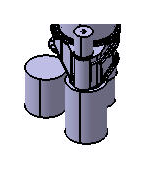
cad/img/rgb3_iso.png
