tanboga20/turboprop-from-turboshaft/cad/img/rgb3_noequip_front.png

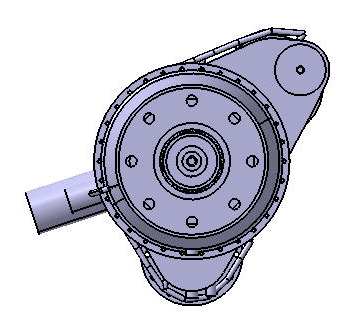
cad/img/rgb3_noequip_front.png
