tanboga20/turboprop-from-turboshaft/cad/img/rgb3_noequip_iso.png

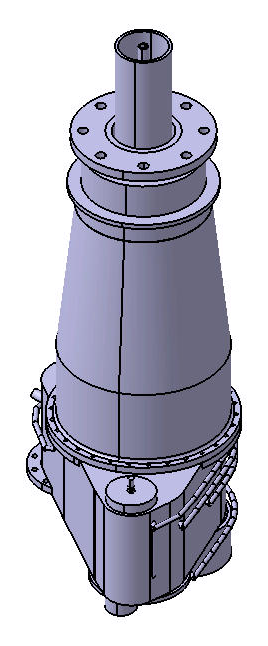
cad/img/rgb3_noequip_iso.png
