tanboga20/turboprop-from-turboshaft/cad/img/rgb3_noequip_side.png

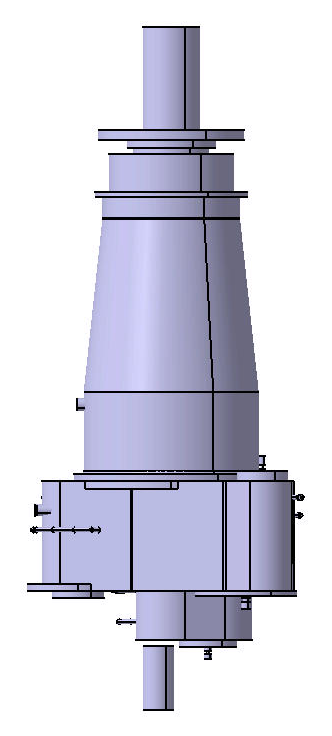
cad/img/rgb3_noequip_side.png
