tanboga20/turboprop-from-turboshaft/cad/img/ring_iso.png

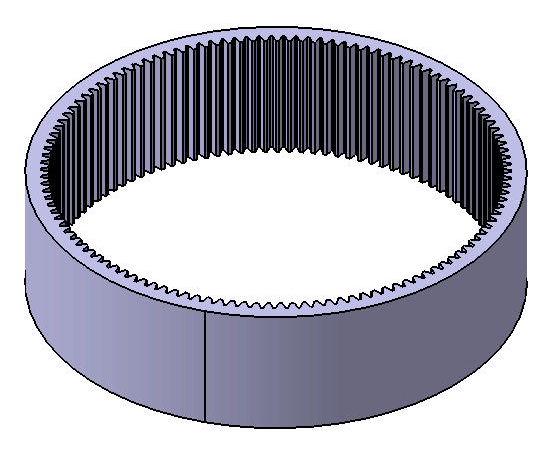
cad/img/ring_iso.png
