tanboga20/turboprop-from-turboshaft/cad/img/sun_iso.png

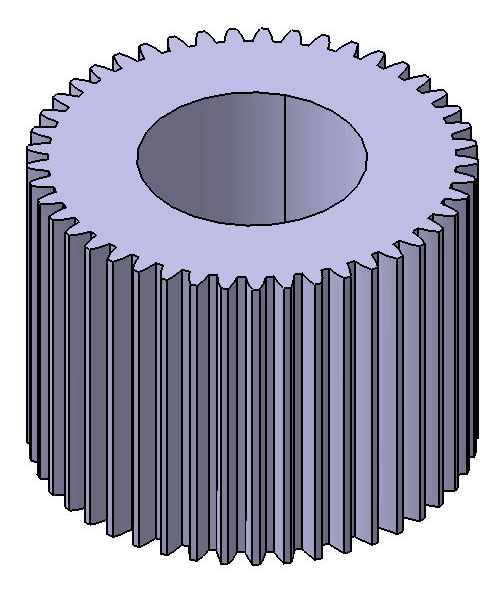
cad/img/sun_iso.png
