tanboga20/turboprop-from-turboshaft/docs/figures/overview/compliance_en.png

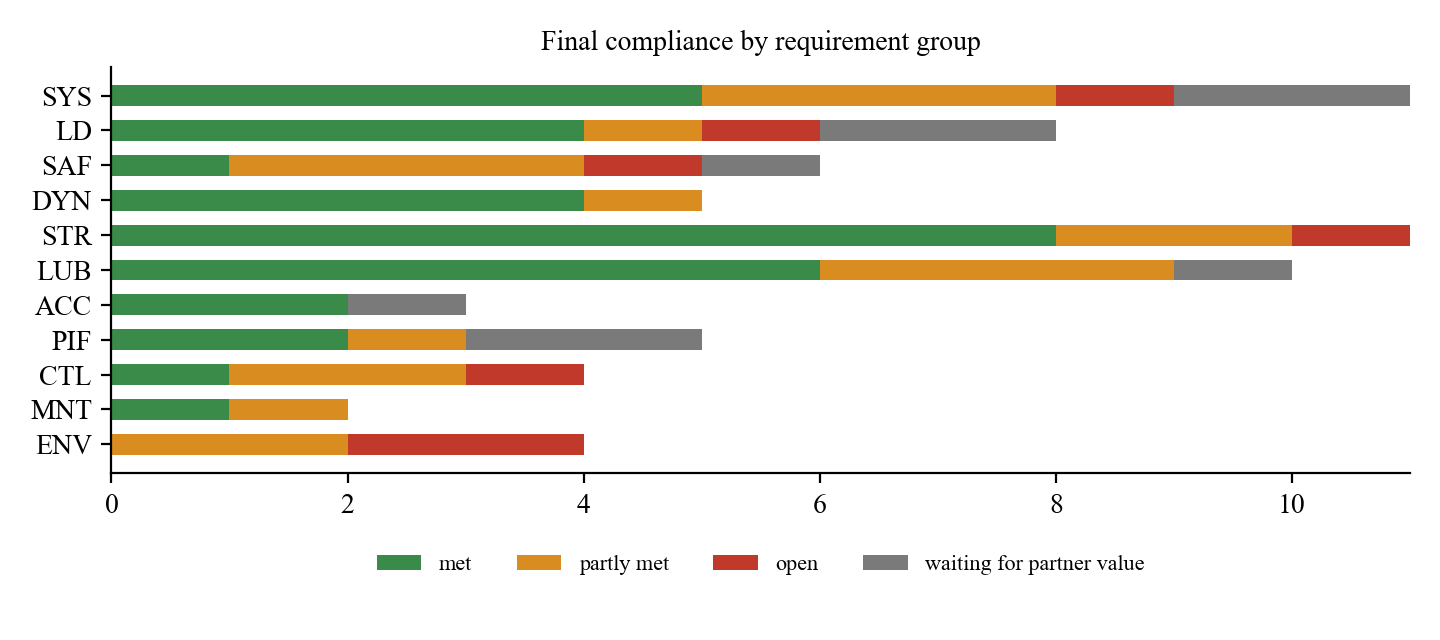
docs/figures/overview/compliance_en.png
