tanboga20/turboprop-from-turboshaft/docs/figures/overview/masshist_tr.png

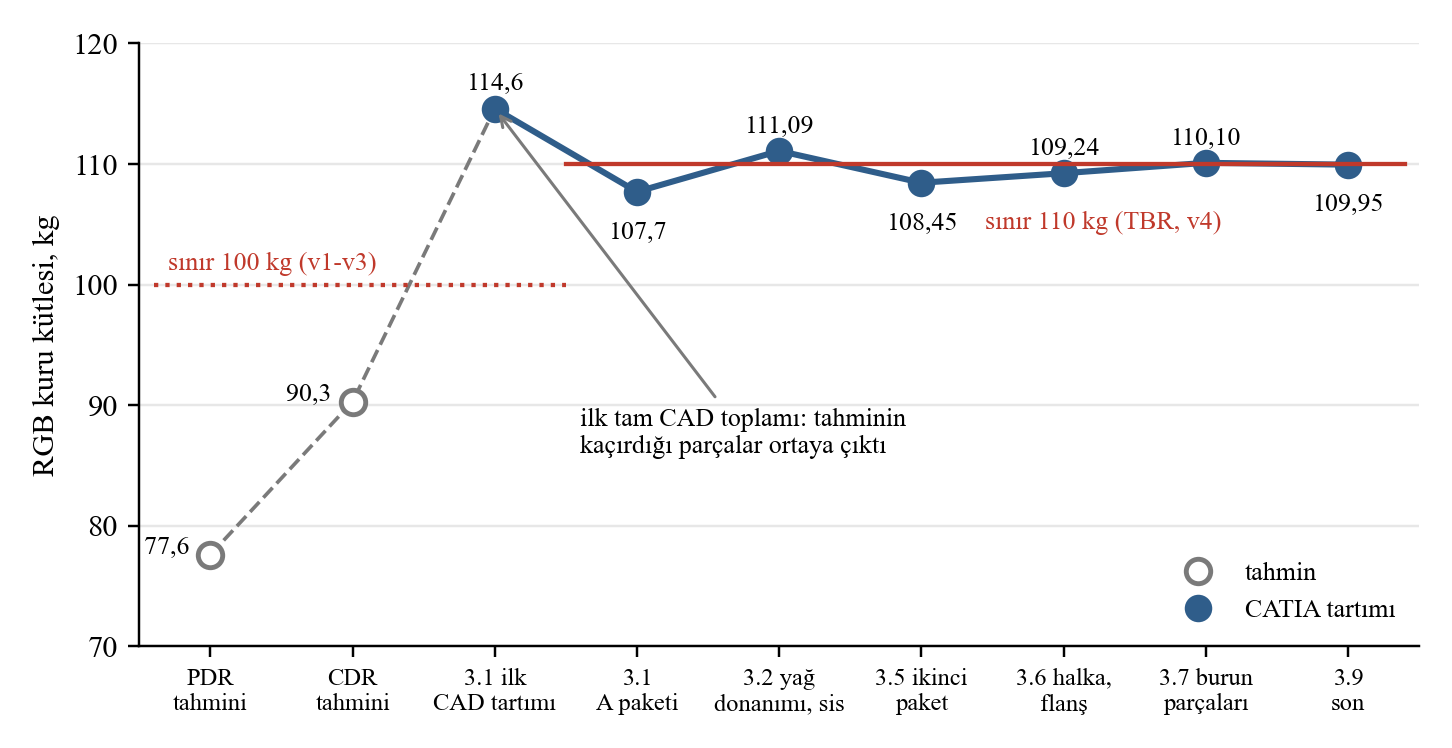
docs/figures/overview/masshist_tr.png
