tanboga20/turboprop-from-turboshaft/docs/figures/phases/en/p0_cert_chain.png

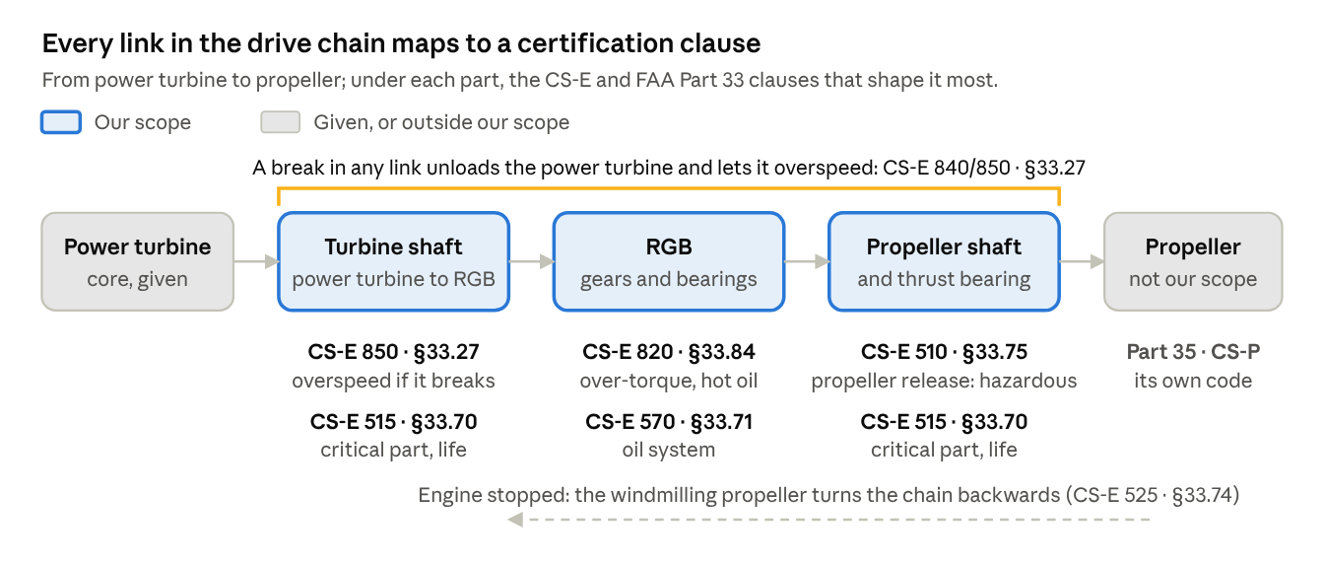
docs/figures/phases/en/p0_cert_chain.png
