tanboga20/turboprop-from-turboshaft/docs/figures/phases/en/p1_loss_range.png

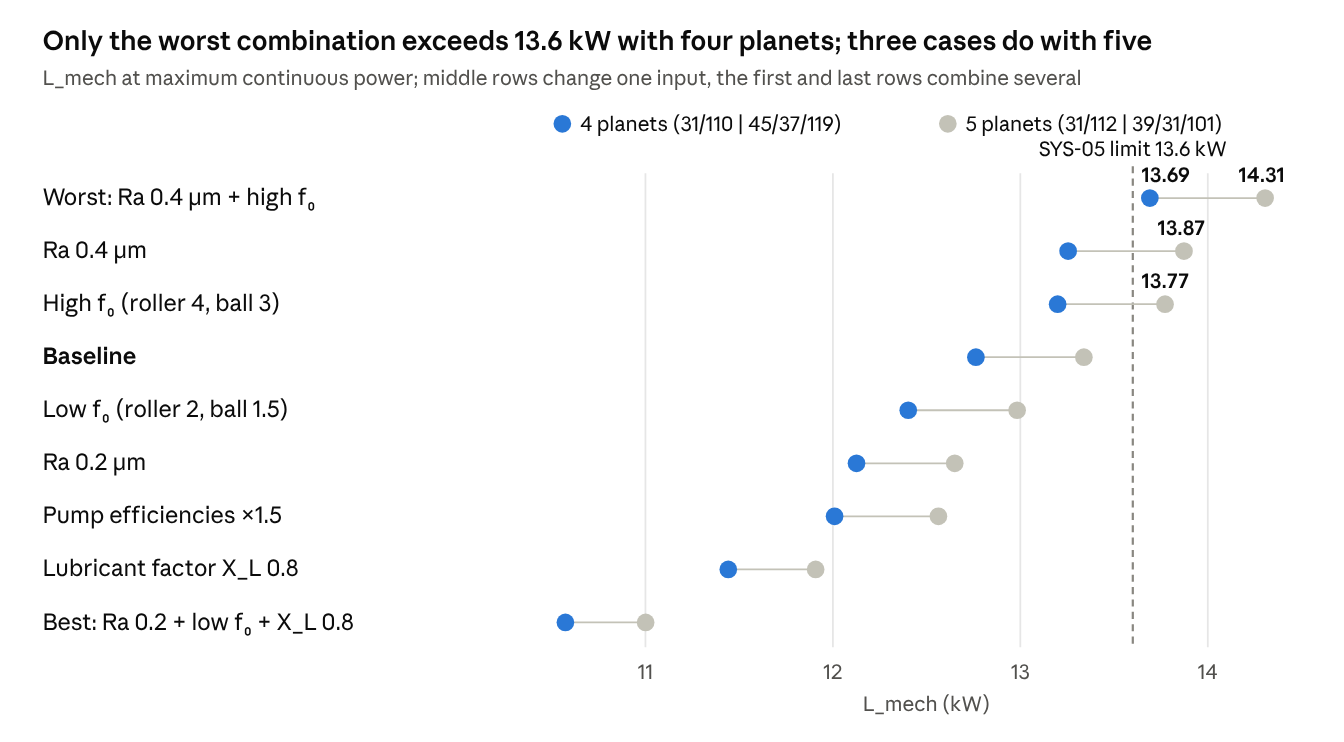
docs/figures/phases/en/p1_loss_range.png
