tanboga20/turboprop-from-turboshaft/docs/figures/phases/en/p1_pads.png

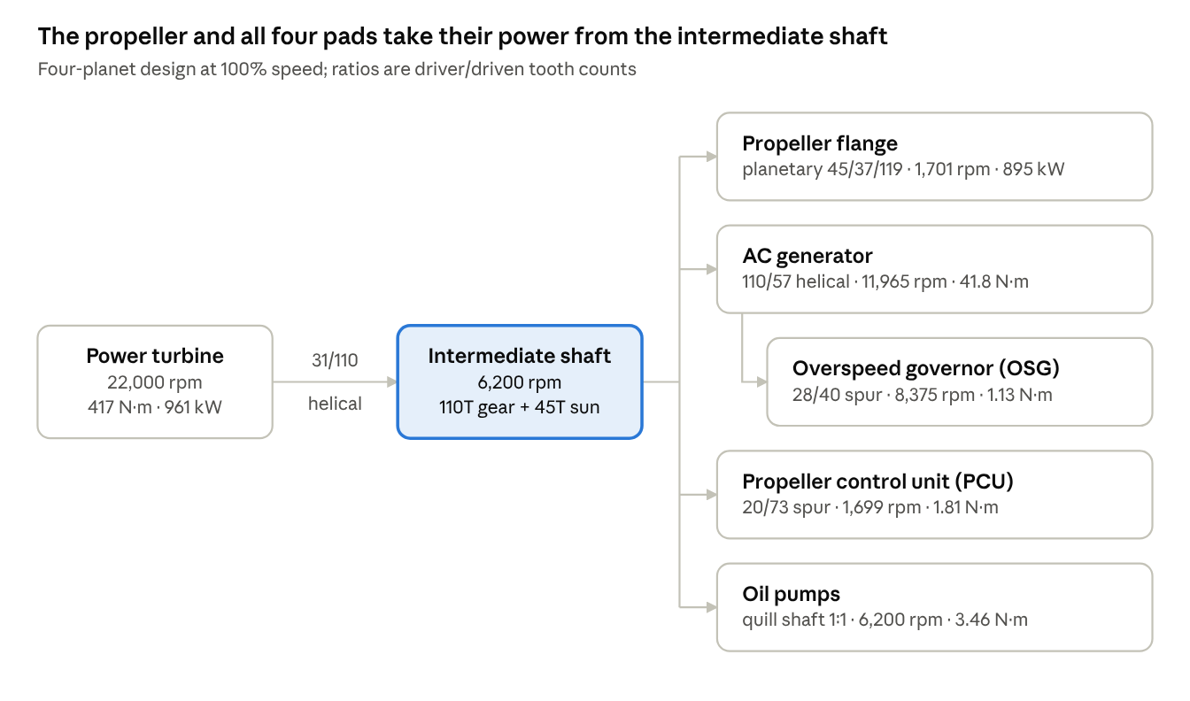
docs/figures/phases/en/p1_pads.png
