tanboga20/turboprop-from-turboshaft/docs/figures/phases/en/p2_dyn04.png

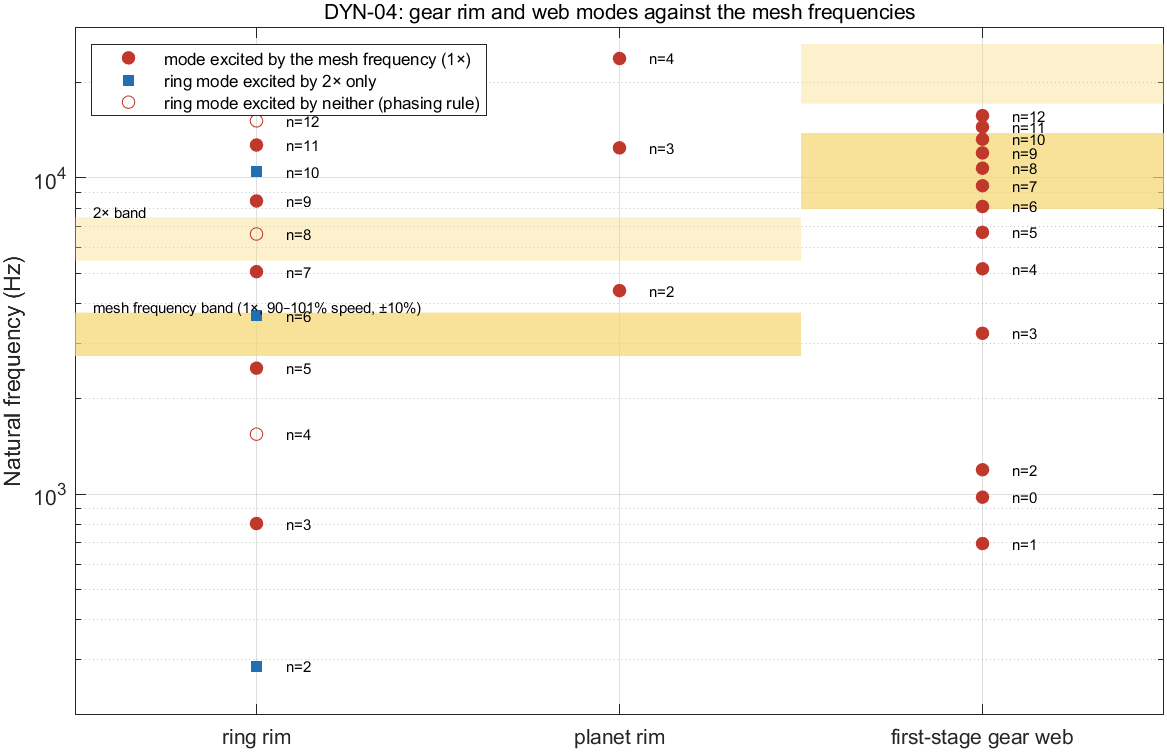
docs/figures/phases/en/p2_dyn04.png
