tanboga20/turboprop-from-turboshaft/docs/figures/phases/en/p2_gear_sf.png

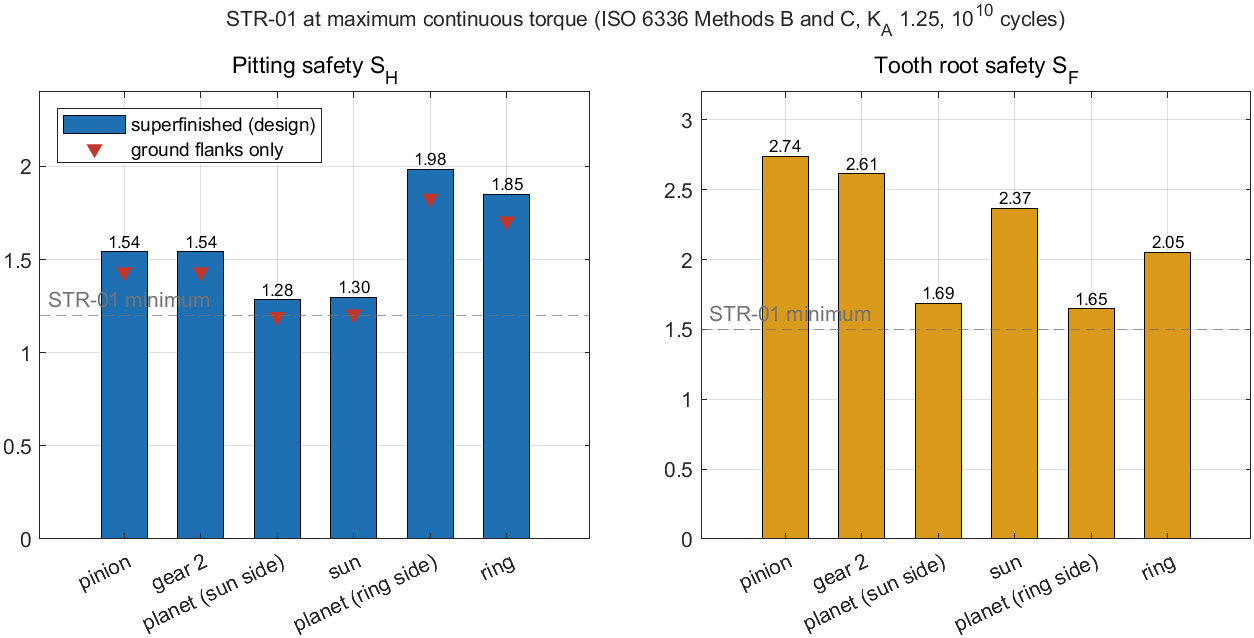
docs/figures/phases/en/p2_gear_sf.png
