tanboga20/turboprop-from-turboshaft/docs/figures/phases/en/p2_options.png

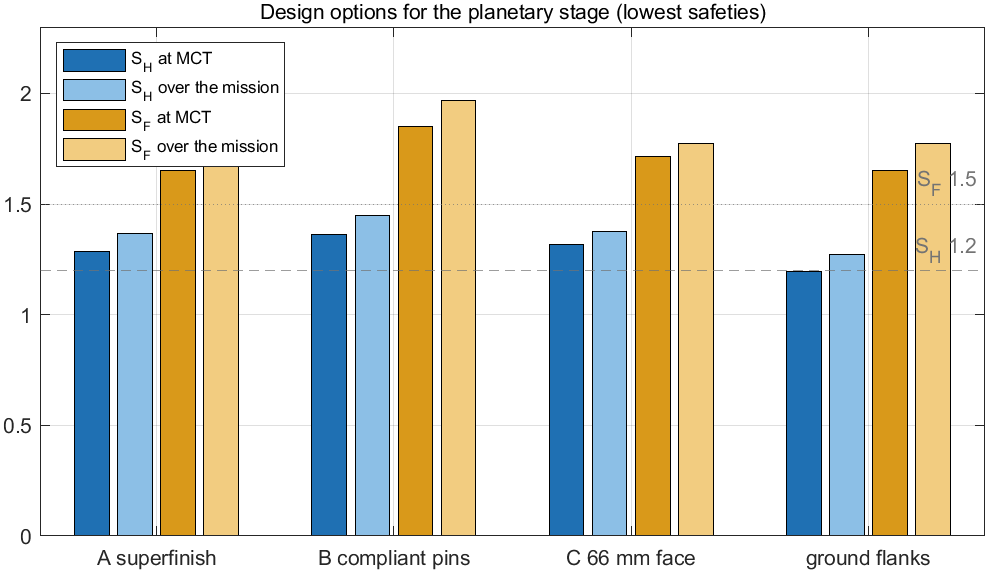
docs/figures/phases/en/p2_options.png
