tanboga20/turboprop-from-turboshaft/docs/figures/phases/en/p2_planet_mode.png

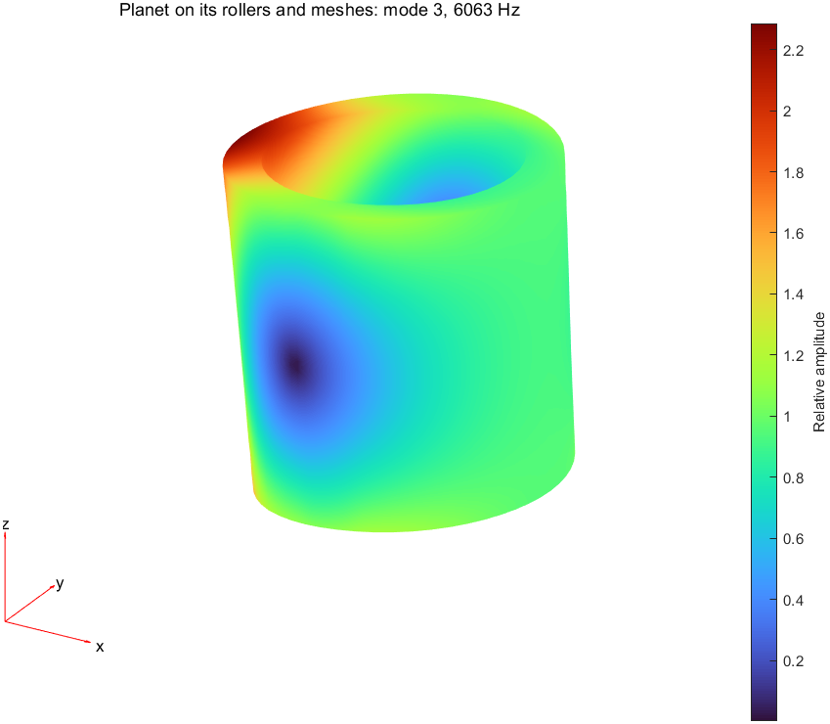
docs/figures/phases/en/p2_planet_mode.png
