tanboga20/turboprop-from-turboshaft/docs/figures/phases/en/p2_scuffing.png

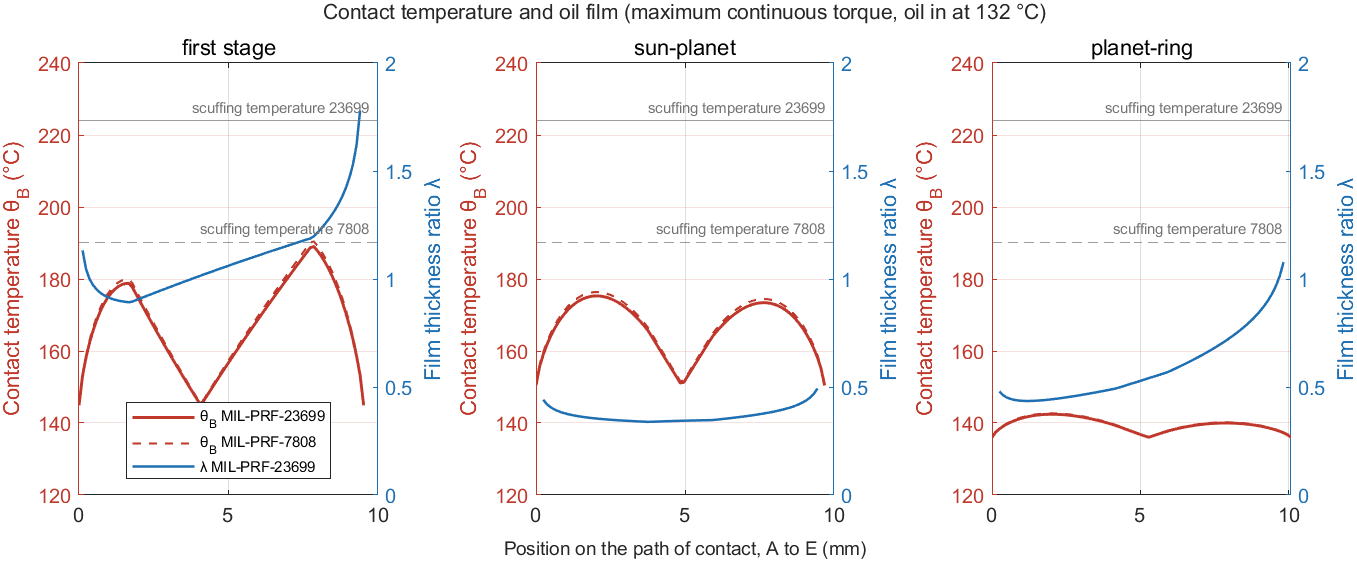
docs/figures/phases/en/p2_scuffing.png
