tanboga20/turboprop-from-turboshaft/docs/figures/phases/en/p2_sensors.png

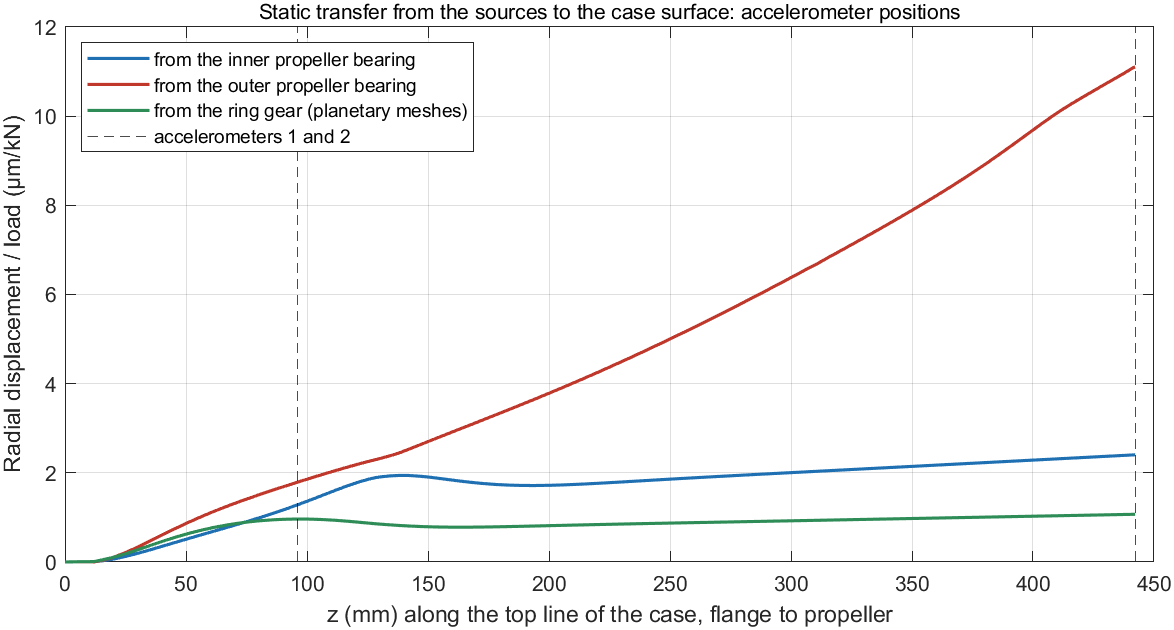
docs/figures/phases/en/p2_sensors.png
