tanboga20/turboprop-from-turboshaft/docs/figures/phases/en/p2_web_modes.png

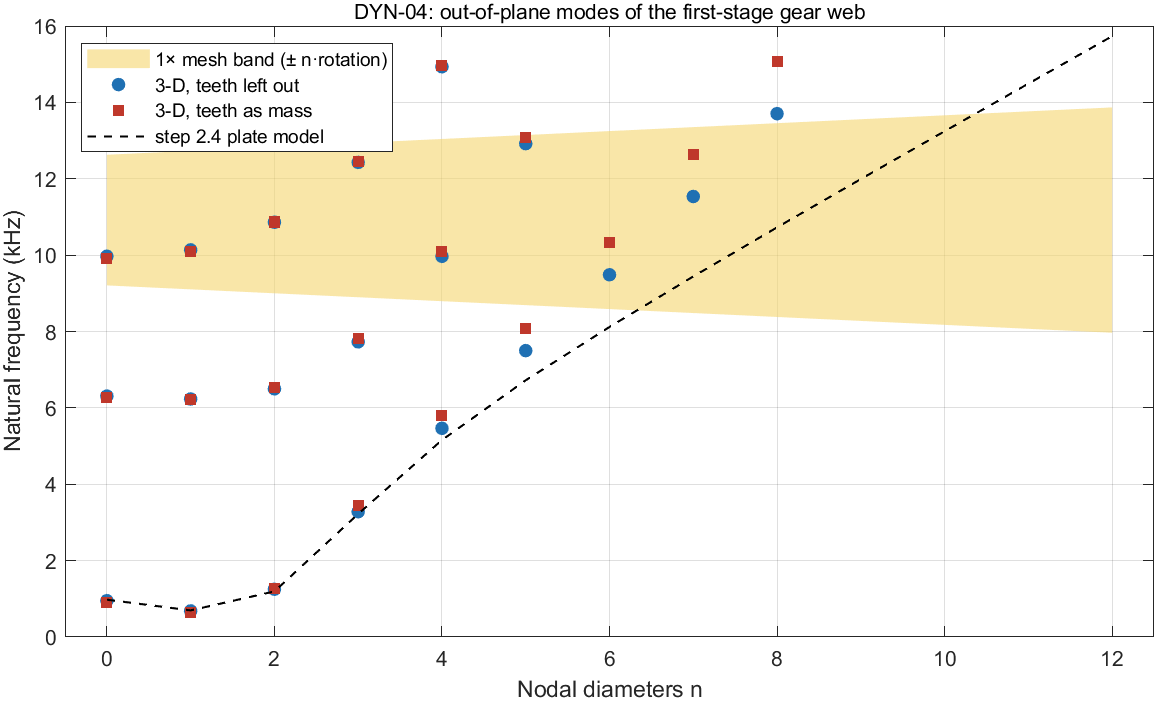
docs/figures/phases/en/p2_web_modes.png
