tanboga20/turboprop-from-turboshaft/docs/figures/phases/en/p3_layout.png

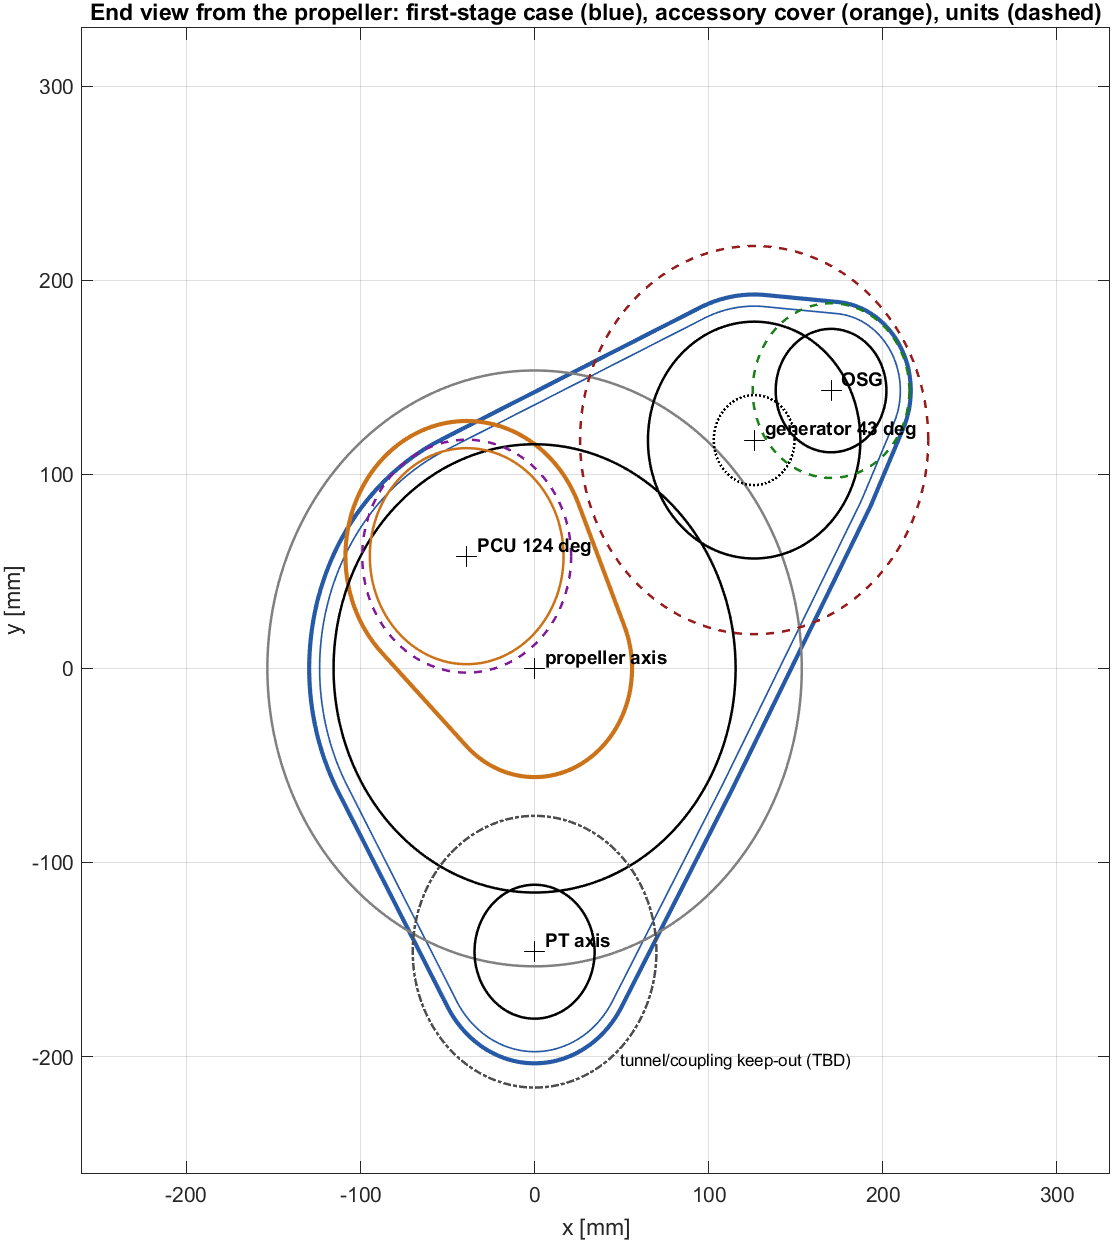
docs/figures/phases/en/p3_layout.png
