tanboga20/turboprop-from-turboshaft/docs/figures/phases/en/p3_rgb_render.png

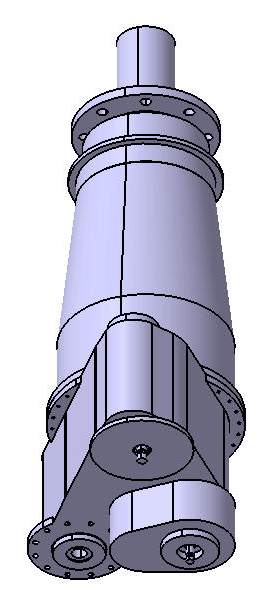
docs/figures/phases/en/p3_rgb_render.png
