tanboga20/turboprop-from-turboshaft/docs/figures/phases/tr/p0_cert_chain.png

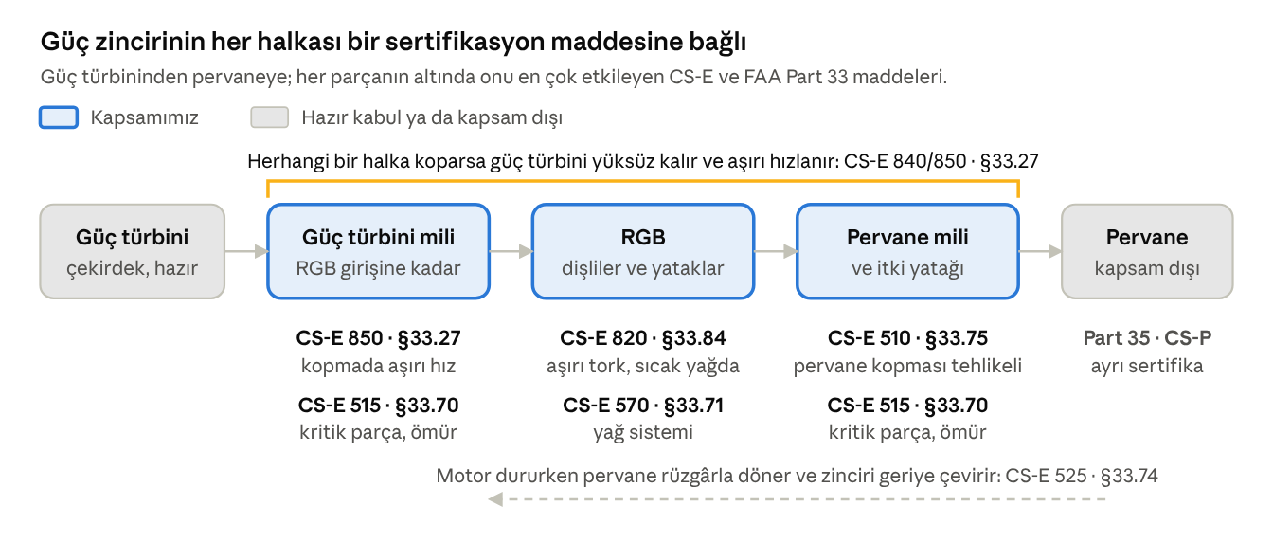
docs/figures/phases/tr/p0_cert_chain.png
