tanboga20/turboprop-from-turboshaft/docs/figures/phases/tr/p0_t700.png

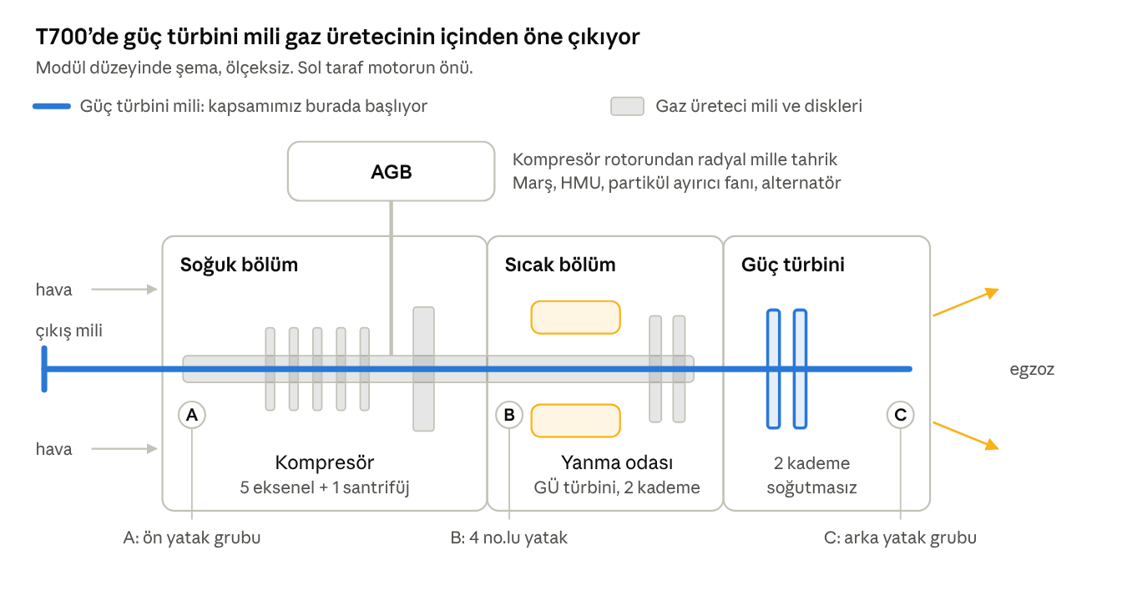
docs/figures/phases/tr/p0_t700.png
