tanboga20/turboprop-from-turboshaft/docs/figures/phases/tr/p1_loss_range.png

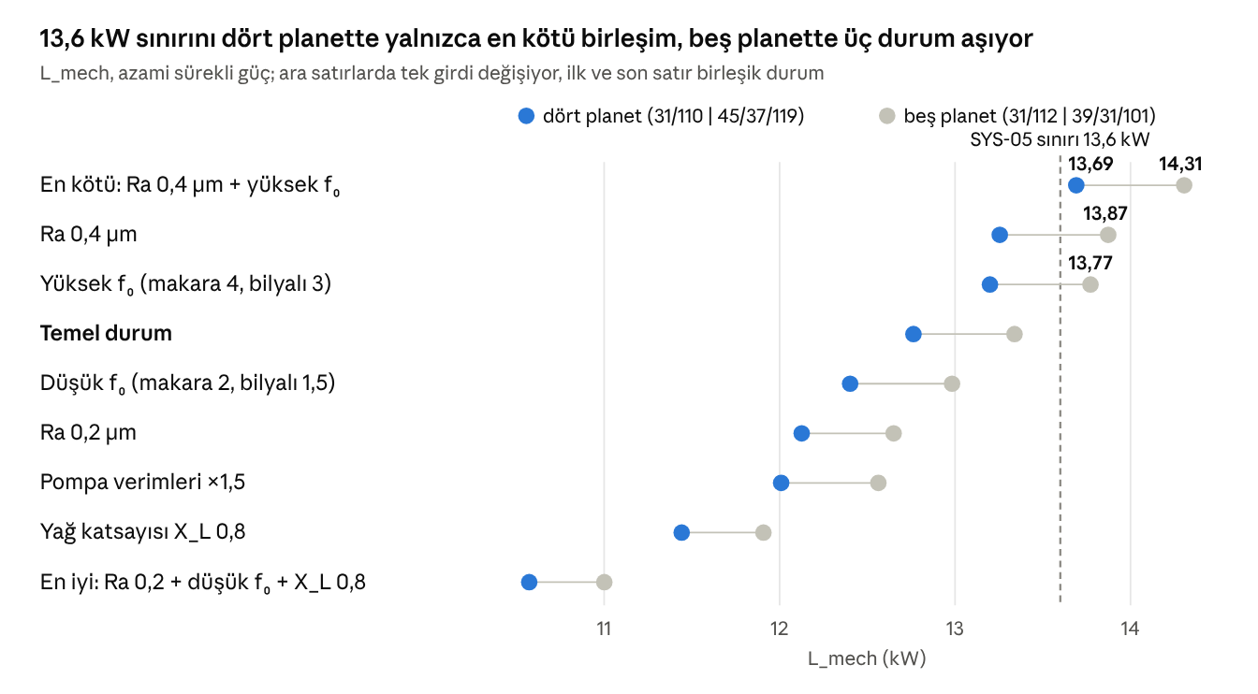
docs/figures/phases/tr/p1_loss_range.png
