tanboga20/turboprop-from-turboshaft/docs/figures/phases/tr/p1_pads.png

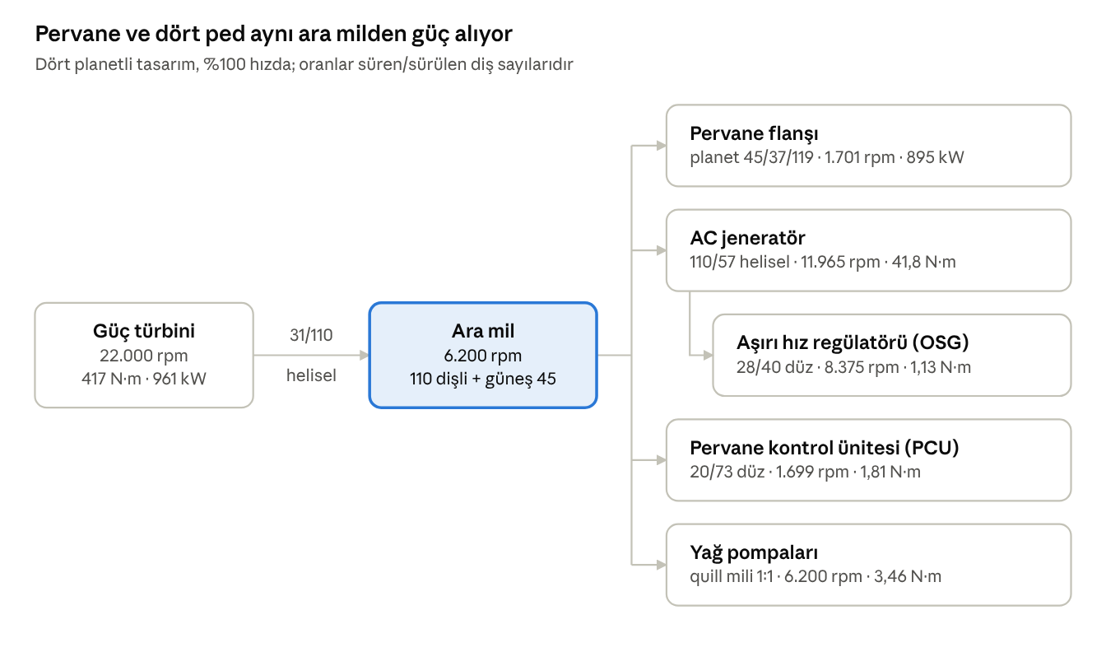
docs/figures/phases/tr/p1_pads.png
