tanboga20/turboprop-from-turboshaft/docs/figures/phases/tr/p2_scuffing.png

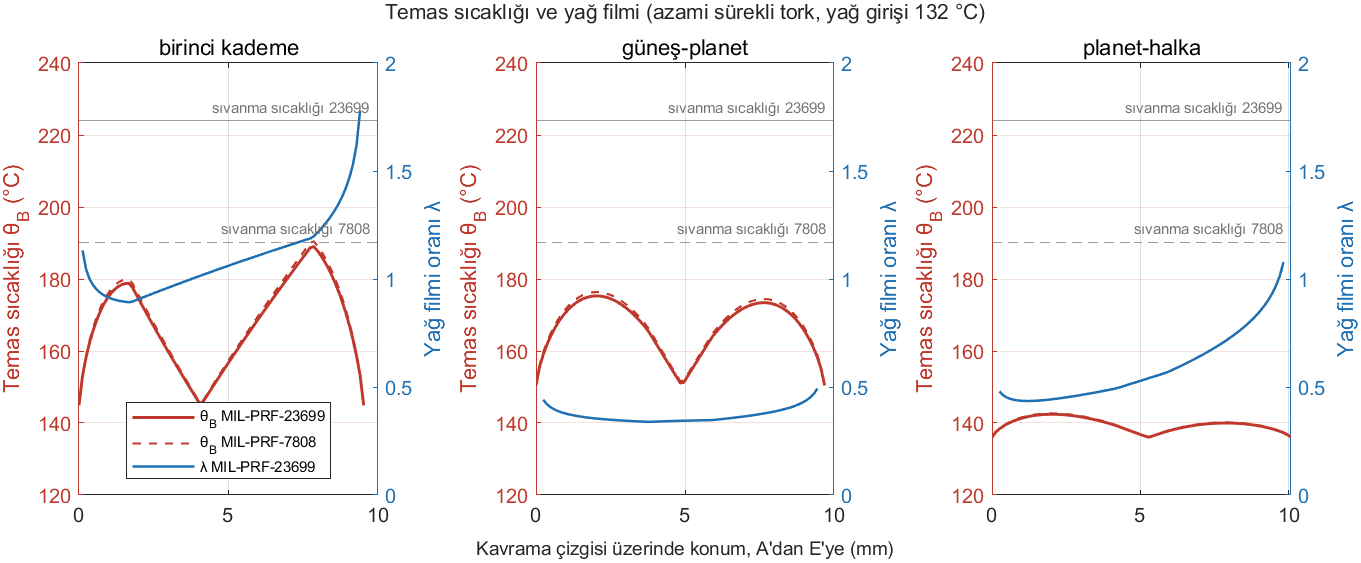
docs/figures/phases/tr/p2_scuffing.png
