tanboga20/turboprop-from-turboshaft/docs/figures/phases/tr/p2_shafts.png

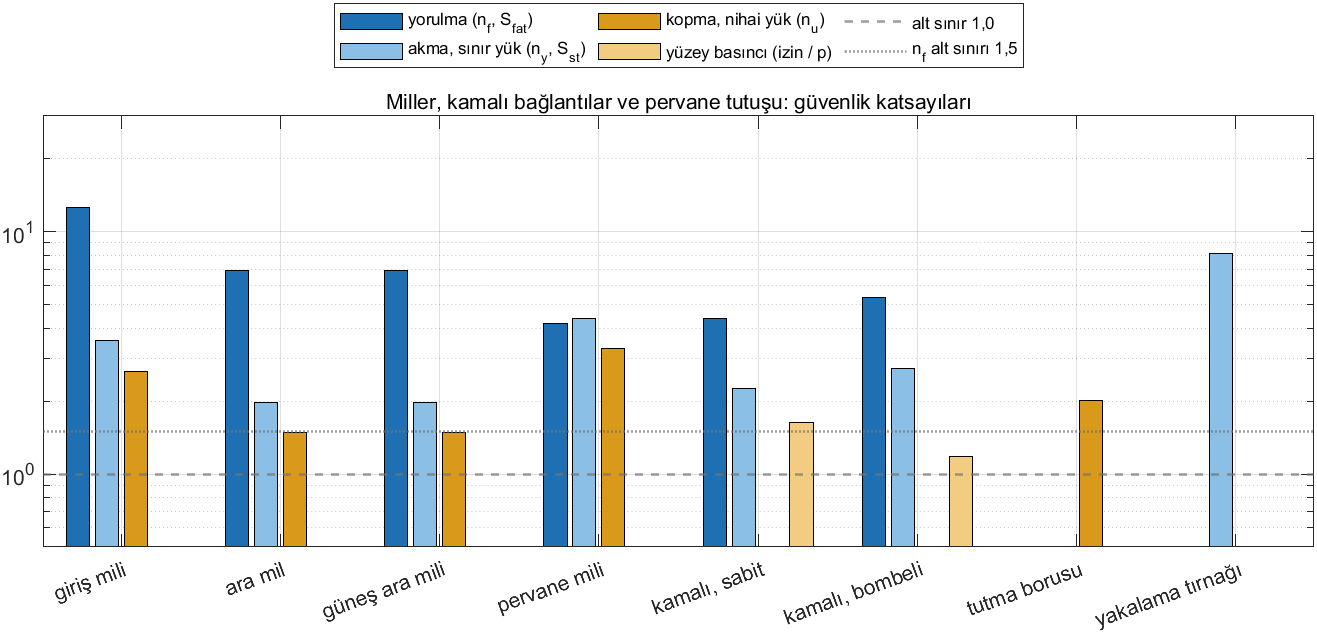
docs/figures/phases/tr/p2_shafts.png
