tanboga20/turboprop-from-turboshaft/docs/figures/phases/tr/p3_layout.png

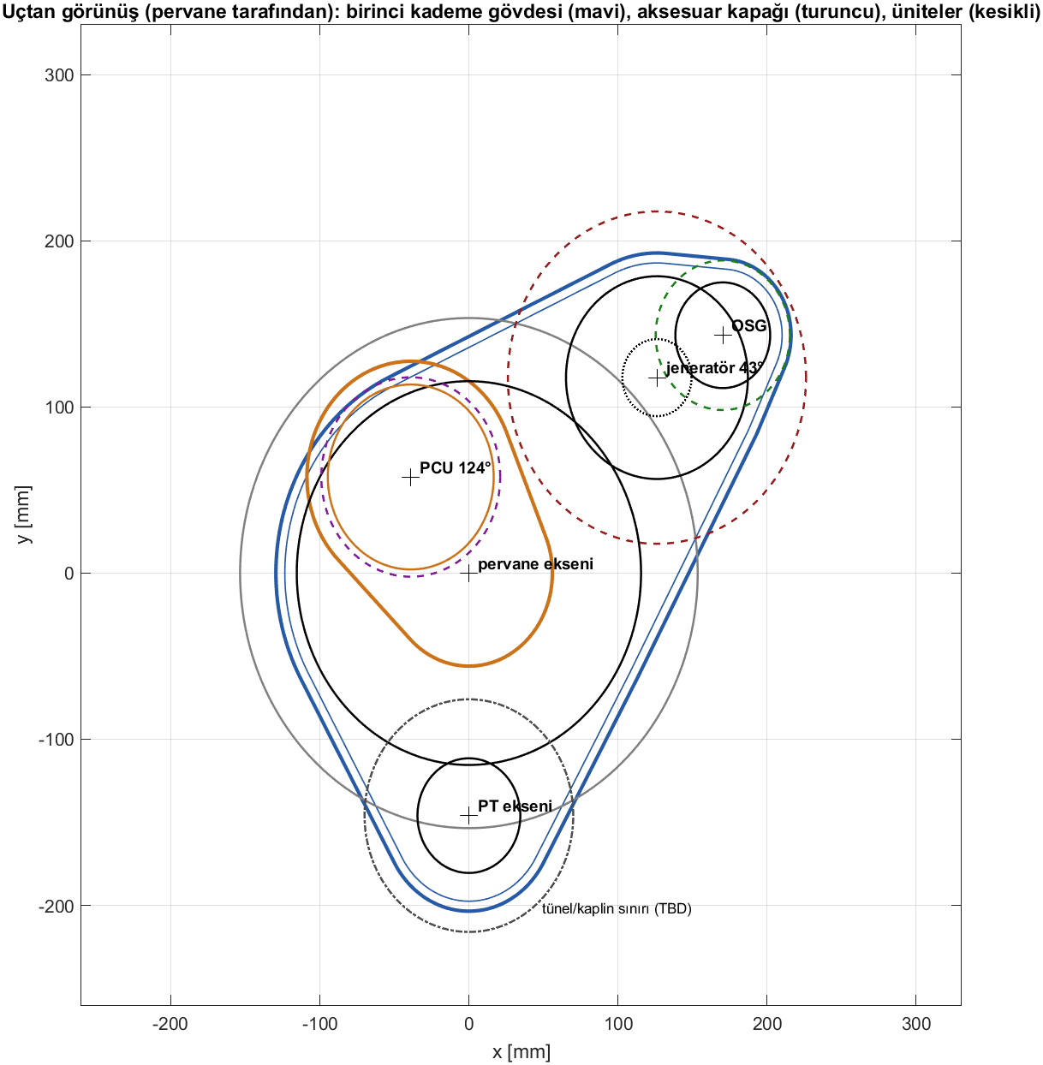
docs/figures/phases/tr/p3_layout.png
