tanboga20/turboprop-from-turboshaft/docs/figures/step37/dt_design_en.png

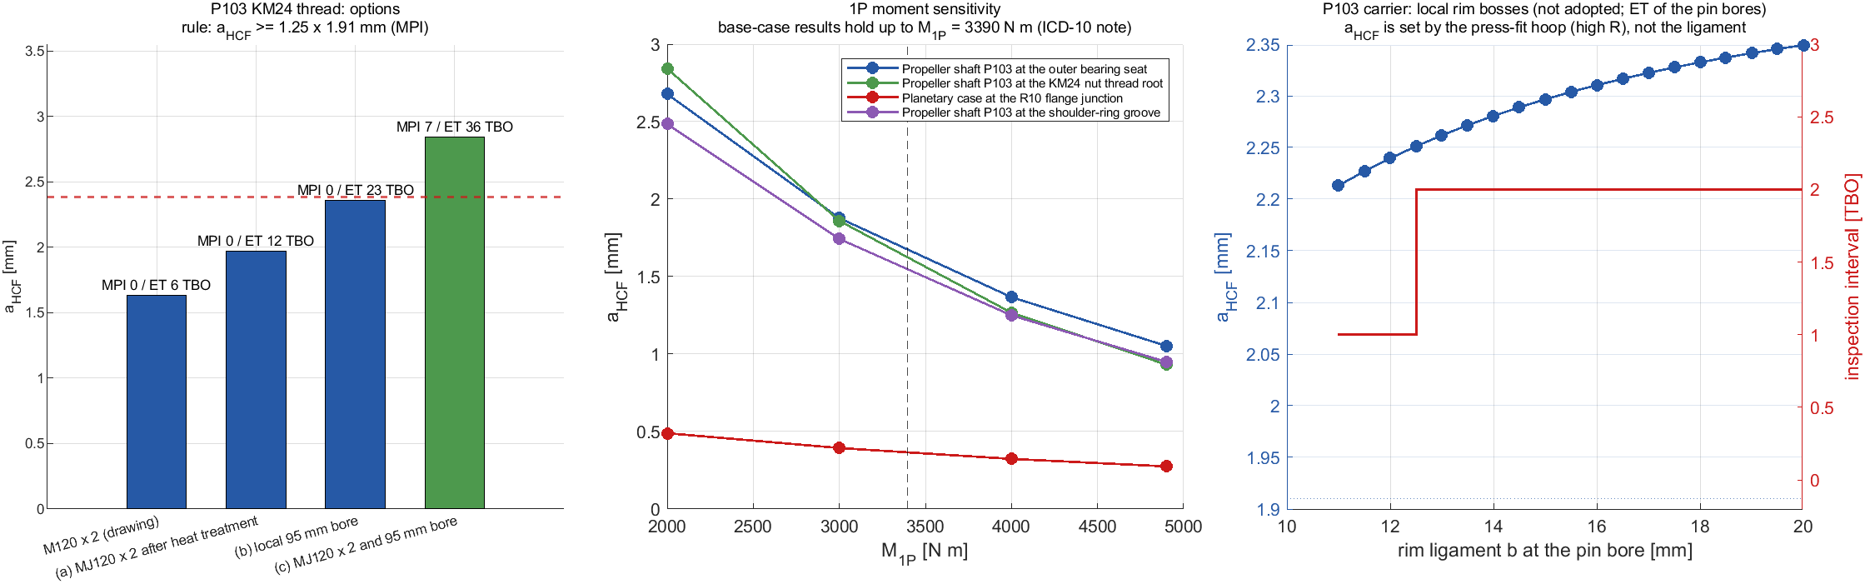
docs/figures/step37/dt_design_en.png
