tanboga20/turboprop-from-turboshaft/manufacturing/components_v1.csv

id | component_en | component_tr | requirement | key_values | status
C-01 | Rolling bearings (NU1024 x2, QJ1024, NU2209 x2, NU2210 x2, QJ209, QJ210, 6305 x2, 6202 x2, 6203 x2) and the planet roller sets | Rulmanlar (NU1024 x2, QJ1024, NU2209 x2, NU2210 x2, QJ209, QJ210, 6305 x2, 6202 x2, 6203 x2) ve planet makara setleri | STR-02 | aerospace grade, M50 VIM-VAR (AMS 6491) rings and rolling elements, M50NiL (AMS 6278) for the propeller bearings (hoop stress of the fits); silver-plated machined cages; the internal geometry of step 2.5; planet set speed limit at least 6,020 rpm at 110% (ICD) | TBR (supplier)
C-02 | Carbon face seals: propeller shaft, input, generator pad | Karbon yüz contaları: pervane mili, giriş, jeneratör pedi | ENV-03, LUB-05 | mating ring with a hard coating (tungsten carbide, HVOF, TBR); dust excluder lip on the propeller seal (ENV-03); leakage at most 2 cm3/h (TBR) | TBR (supplier)
C-03 | O-rings | O-halkalar | LUB-01, ENV-01 | low-temperature fluorocarbon (AMS 7287 type, -40 degC with MIL-PRF-23699), AS568 sizes | TBR
C-04 | Magnetic chip detectors (2) with self-closing valves and electrical indication | Kendinden kapanan valfli ve elektrik uyarılı manyetik talaş dedektörleri (2) | LUB-05, MNT-02 | in the planetary and first-stage sumps, reachable without removing the RGB | TBR
C-05 | Speed pickups: Np x2 on the input pinion (control and cross-check), Nr x2 on the propeller shaft P103 at z 400 (TBR), with two phonic wheels; the protection Np is the core PT-rotor signal (ICD-36) | Hız algılayıcılar: giriş pinyonunda Np x2 (kontrol ve çapraz kontrol), pervane mili P103 üzerinde z 400'de Nr x2 (TBR), iki dişli tekerle; koruma Np'si çekirdeğin PT rotoru sinyali (ICD-36) | CTL-02, SAF-03 | variable reluctance; separate connectors and harness routes for the control and protection channels; control and protection read different phonic wheels; phonic wheels in 4340 (TBR); qualified with the harness for EMI and lightning (14 CFR 33.28(b)(2)) | TBR
C-06 | Condition monitoring: accelerometers A1-A3, inline oil debris monitor, oil pressure and temperature, filter differential pressure, the PT-shaft tunnel air temperature sensor (step 2.2) | Durum izleme: A1-A3 ivmeölçerleri, hat içi yağ talaş izleyicisi, yağ basıncı ve sıcaklığı, filtre fark basıncı, PT mili tüneli hava sıcaklığı algılayıcısı (adım 2.2) | CTL-03, LUB-05 | positions of step 2.10; tunnel sensor of step 2.2 | TBR
C-07 | Thermostatic valve at the RGB inlet | RGB girişindeki termostatik valf | LUB-02, LUB-04 | modulating (wax element), starts to open at 60 degC and full flow through the cooler by about 70 degC (band TBR); it sets the inlet on cold days (about 60 degC at -20 and -40 degC ambient at maximum continuous power); the 3.2 model treats it as on/off, so a valve with a stated band is required; fails to the cooler-open position | TBR
C-08 | Oil filter 3 um with bypass valve (170 kPa) and impending-bypass indication (120 kPa) | 3 um yağ filtresi, baypas valfi (170 kPa) ve tıkanma öncesi uyarısı (120 kPa) | LUB-05 | clean drop 35 kPa at 30 L/min, 100 degC (step 3.2) | TBR (supplier)
C-09 | Pressure regulating valve (550 kPa) and pump relief valve (1100 kPa) | Basınç ayar valfi (550 kPa) ve pompa emniyet valfi (1100 kPa) | LUB-03 | step 3.2 values | TBR
C-10 | Low-oil-pressure switch: opens the mist valve and sends the 75% MCP limit to the FADEC | Düşük yağ basıncı anahtarı: sis valfini açar ve FADEC'e %75 MCP sınırını gönderir | LUB-07 | set point TBR (3.10); redundant contacts (TBR) | TBR
C-11 | Mist shut-off and mixing valve | Sis kesme ve karışım valfi | LUB-07 | opened by the C-10 switch; bleed air 10-20 SCFM at <= 100 degC | TBR (supplier)
C-12 | Fasteners and inserts | Bağlantı elemanları ve insertler | STR-04 | 170 fasteners in 12 joints, 1.31 kg bottom-up (A286; 1.96 kg with x1.5) against the 5.21 kg allowance; self-locking helical coil inserts (NASM21209) in the castings; lockwire or self-locking nuts | TBR (3.9)
C-13 | Steel seat liners for the bearing outer rings in the castings | Dökümlerde rulman dış bilezikleri için çelik yuva gömlekleri | STR-04, DYN-05 | 13 liners, +1.28 kg not in the roll-up; the shrink fit loosens by 0.19 mm (NU1024 liner) from 20 to 132 degC and tightens by 0.10 mm at -40 degC: fit and hoop stress in 3.5 | TBR (3.5)
C-14 | External hoses to the cooler | Soğutucuya giden dış hortumlar | SAF-05 | PTFE hose with CRES braid and fire sleeve, fire resistant (AS1055) | TBR
C-15 | Oil tank (airframe side) | Yağ tankı (uçak tarafı) | SAF-05, LUB-06 | fireproof by construction (CRES or titanium sheet) or by a fire blanket; 6.8 L | TBR
