tanboga20/turboprop-from-turboshaft/safety/critical_parts_v1.csv

part | critical | reason_en | reason_tr | governing_location | material | s_lcf_MPa | s_lcf_min_MPa | N_lcf_min | approved_life_cycles | N_anomaly_cycles | a_fail_initial_shape_mm | a_end_det_mm | c_end_det_mm | interval_tbo | embedded_hcf_margin | life_limit | process_controls | ndt_manufacture | ndt_tbo | damage_limits | recording_loop | fixed_processes | process_validation | life_tracking | tests_311
PT output shaft F212 | yes | SAF-02; a primary failure unloads the PT (overspeed; SAF-03 limits it) and the shaft flails in the tunnel (FMEA FM29) | SAF-02; birincil hasar PT'yi yüksüz bırakır (aşırı devir; SAF-03 sınırlar) | PT output shaft at the tube-to-flange transition | AISI 4340 (1240 MPa) | 112.643492210442 | 0 | 6.03010991318459e+16 | 20000 | 292945.179348836 | 1.2 | 1.20058877319548 | 2.85404155470043 | 7 | 6.03537881259046 | 20,000 flight cycles declared; basis: the GAG stress range at each governing feature is below the -3 sigma crack-initiation endurance of that material and process (cited data; A357: validated casting quality) | PT output shaft F212: integral flanges machined from a forged hollow (no welds), VAR 4340, Q&T, finish machine, shot peen the tube-to-flange transitions (PR-04), zinc-nickel outside | UT of the forged hollow (AMS 2630 class AA), eddy current of the tube and the tube-to-flange transitions (ET, NASA-STD-5009C sizes); open NDE item: demonstration of the ET procedure on a 1.5 mm wall (3.10) | ET of the tube-to-flange transitions at each TBO (the 1.27 x 1.27 mm pair is a through crack in the 1.5 mm wall); NDT at TBO after stripping the coating (NASA-STD-5009C sizes credited only under NER 12, 13 and 21, otherwise a demonstrated POD) | serviceable and repairable damage limits by zone (the D4 locations and the rest) and damage type (nicks, dents, scratches, corrosion pits, fretting) in the ICA (3.10) | every finding recorded against the part serial number and assessed by the type certificate holder (the recording and assessment loop); fleet findings feed the D4 inputs | fixed-process designation of the melt, forging or casting (foundry and technique for P101), heat treatment, peening, finishing and NDT, with change control | process validation on first articles: microstructure, properties, residual stress and NDT capability | serial number on the part, flight cycles and hours counted by the engine monitoring unit (1 cycle per flight, plus each LD-01 exceedance), life limit in the ICA airworthiness limitations section | 3.11: specimen fatigue (-3 sigma endurance) of each material and process at the GAG ratio, 4340 threshold (ASTM E647, R 0.1-0.9, two heats), MJ120 x 2 thread-root fatigue, coupling diaphragm fatigue, A357 HIP coupons and pore-seeded specimens, component tests of P103 and the couplings
RGB input shaft | yes | SAF-02; a primary failure unloads the PT (overspeed; SAF-03 limits it) | SAF-02; birincil hasar PT'yi yüksüz bırakır (aşırı devir; SAF-03 sınırlar) | RGB input shaft at the bearing seat shoulder | Pyrowear 53 core | 91.9880055560113 | 0 | 9.43380844526839e+17 | 20000 | 979463.167581839 | 3.67287738519081 | 3.51458173095759 | 4.74136924383086 | 23 | 3.55077752640394 | 20,000 flight cycles declared; basis: the GAG stress range at each governing feature is below the -3 sigma crack-initiation endurance of that material and process (cited data; A357: validated casting quality) | Pyrowear 53 VIM-VAR (AMS 6308), carburize, harden and temper (PR-01), temper etch (PR-06), case-depth and core coupons per heat-treat lot, no coating; the D4 shoulder of the input shaft is masked from carburizing (core properties at the fillet) and shot peened (PR-04 extended to the shoulder) | UT of the bar or forging (AMS 2630 class AA), MPI after final machining (wet fluorescent, NER 21) | MPI (NER 21) of the bearing seat shoulder and the coupling end at each TBO; NDT at TBO after stripping the coating (NASA-STD-5009C sizes credited only under NER 12, 13 and 21, otherwise a demonstrated POD) | serviceable and repairable damage limits by zone (the D4 locations and the rest) and damage type (nicks, dents, scratches, corrosion pits, fretting) in the ICA (3.10) | every finding recorded against the part serial number and assessed by the type certificate holder (the recording and assessment loop); fleet findings feed the D4 inputs | fixed-process designation of the melt, forging or casting (foundry and technique for P101), heat treatment, peening, finishing and NDT, with change control | process validation on first articles: microstructure, properties, residual stress and NDT capability | serial number on the part, flight cycles and hours counted by the engine monitoring unit (1 cycle per flight, plus each LD-01 exceedance), life limit in the ICA airworthiness limitations section | 3.11: specimen fatigue (-3 sigma endurance) of each material and process at the GAG ratio, 4340 threshold (ASTM E647, R 0.1-0.9, two heats), MJ120 x 2 thread-root fatigue, coupling diaphragm fatigue, A357 HIP coupons and pore-seeded specimens, component tests of P103 and the couplings
RGB input shaft | yes | SAF-02; a primary failure unloads the PT (overspeed; SAF-03 limits it) | SAF-02; birincil hasar PT'yi yüksüz bırakır (aşırı devir; SAF-03 sınırlar) | RGB input shaft at the coupling end | Pyrowear 53 core | 78.1439068011861 | 0 | 8.5363413633353e+18 | 20000 | 1689783.45740302 | 6.4 | 6.40864829610282 | 9.14888468037855 | 65 | 7.77056817835713 | 20,000 flight cycles declared; basis: the GAG stress range at each governing feature is below the -3 sigma crack-initiation endurance of that material and process (cited data; A357: validated casting quality) | Pyrowear 53 VIM-VAR (AMS 6308), carburize, harden and temper (PR-01), temper etch (PR-06), case-depth and core coupons per heat-treat lot, no coating; the D4 shoulder of the input shaft is masked from carburizing (core properties at the fillet) and shot peened (PR-04 extended to the shoulder) | UT of the bar or forging (AMS 2630 class AA), MPI after final machining (wet fluorescent, NER 21) | MPI (NER 21) of the bearing seat shoulder and the coupling end at each TBO; NDT at TBO after stripping the coating (NASA-STD-5009C sizes credited only under NER 12, 13 and 21, otherwise a demonstrated POD) | serviceable and repairable damage limits by zone (the D4 locations and the rest) and damage type (nicks, dents, scratches, corrosion pits, fretting) in the ICA (3.10) | every finding recorded against the part serial number and assessed by the type certificate holder (the recording and assessment loop); fleet findings feed the D4 inputs | fixed-process designation of the melt, forging or casting (foundry and technique for P101), heat treatment, peening, finishing and NDT, with change control | process validation on first articles: microstructure, properties, residual stress and NDT capability | serial number on the part, flight cycles and hours counted by the engine monitoring unit (1 cycle per flight, plus each LD-01 exceedance), life limit in the ICA airworthiness limitations section | 3.11: specimen fatigue (-3 sigma endurance) of each material and process at the GAG ratio, 4340 threshold (ASTM E647, R 0.1-0.9, two heats), MJ120 x 2 thread-root fatigue, coupling diaphragm fatigue, A357 HIP coupons and pore-seeded specimens, component tests of P103 and the couplings
P103 | yes | critical by decision (design decision, delegated by Hamit), not by the derivation rule (its FMEA rows are major with the tube and lip): conservative; the D1 E1 rate (1e-7 per hour) and the G2 coverage table rely on the CS-E 515 programme; the major class of its FMEA rows relies on the tube and lip with their TBO inspection | karar gereği kritik (tasarım kararı, Hamit'in yetkisiyle), türetme kuralıyla değil (FMEA satırları tüp ve dudakla büyük): emniyetli; D1 E1 oranı (saatte 1e-7) ve G2 kapsama tablosu CS-E 515 programına dayanır; FMEA satırlarının büyük sınıfı tüp, dudak ve onların TBO muayenesine dayanır | Propeller shaft P103 at the outer bearing seat | AISI 4340 (1240 MPa) | 100.753502689682 | 0 | 2.7477845035911e+17 | 20000 | 707519.50105525 | 2.6780277560425 | 2.63364051221044 | 2.93020269053529 | 32 | 3.03952982932402 | 20,000 flight cycles declared; basis: the GAG stress range at each governing feature is below the -3 sigma crack-initiation endurance of that material and process (cited data; A357: validated casting quality) | VAR melt, forging with grain flow along the shaft, Q&T to AMS 2759/1, shot peen of the D4 locations (PR-04), no grinding burns (temper etch PR-06), zinc-nickel with bake outside (PR-14); KM24 thread MJ120 x 2 (ISO 5855) rolled after heat treatment, local 95 mm bore under it | UT of the forging (AMS 2630 class AA), MPI after final machining as the general surface check (NER 21); eddy current (ET, NASA-STD-5009C sizes) of the bearing seat, the thread root and the pin bore corners | ET of the bearing seat, the thread root and the pin bore corners at each TBO; the pin bores with the pins pressed out (new pins fitted after) or by a face-corner procedure with the pins in place; open NDE item: demonstration of the procedures, probability of detection at the thread root and the pin bore corners (3.10, 3.11); NDT at TBO after stripping the coating (NASA-STD-5009C sizes credited only under NER 12, 13 and 21, otherwise a demonstrated POD) | serviceable and repairable damage limits by zone (the D4 locations and the rest) and damage type (nicks, dents, scratches, corrosion pits, fretting) in the ICA (3.10) | every finding recorded against the part serial number and assessed by the type certificate holder (the recording and assessment loop); fleet findings feed the D4 inputs | fixed-process designation of the melt, forging or casting (foundry and technique for P101), heat treatment, peening, finishing and NDT, with change control | process validation on first articles: microstructure, properties, residual stress and NDT capability | serial number on the part, flight cycles and hours counted by the engine monitoring unit (1 cycle per flight, plus each LD-01 exceedance), life limit in the ICA airworthiness limitations section | 3.11: specimen fatigue (-3 sigma endurance) of each material and process at the GAG ratio, 4340 threshold (ASTM E647, R 0.1-0.9, two heats), MJ120 x 2 thread-root fatigue, coupling diaphragm fatigue, A357 HIP coupons and pore-seeded specimens, component tests of P103 and the couplings
P103 | yes | critical by decision (design decision, delegated by Hamit), not by the derivation rule (its FMEA rows are major with the tube and lip): conservative; the D1 E1 rate (1e-7 per hour) and the G2 coverage table rely on the CS-E 515 programme; the major class of its FMEA rows relies on the tube and lip with their TBO inspection | karar gereği kritik (tasarım kararı, Hamit'in yetkisiyle), türetme kuralıyla değil (FMEA satırları tüp ve dudakla büyük): emniyetli; D1 E1 oranı (saatte 1e-7) ve G2 kapsama tablosu CS-E 515 programına dayanır; FMEA satırlarının büyük sınıfı tüp, dudak ve onların TBO muayenesine dayanır | Propeller shaft P103 at the KM24 nut thread root | AISI 4340 (1240 MPa) | 96.5490633784314 | 0 | 4.89828810185518e+17 | 20000 | 771841.881316036 | 2.84228381270714 | 2.79527548182944 | 3.11761905582645 | 36 | 3.11626413908265 | 20,000 flight cycles declared; basis: the GAG stress range at each governing feature is below the -3 sigma crack-initiation endurance of that material and process (cited data; A357: validated casting quality) | VAR melt, forging with grain flow along the shaft, Q&T to AMS 2759/1, shot peen of the D4 locations (PR-04), no grinding burns (temper etch PR-06), zinc-nickel with bake outside (PR-14); KM24 thread MJ120 x 2 (ISO 5855) rolled after heat treatment, local 95 mm bore under it | UT of the forging (AMS 2630 class AA), MPI after final machining as the general surface check (NER 21); eddy current (ET, NASA-STD-5009C sizes) of the bearing seat, the thread root and the pin bore corners | ET of the bearing seat, the thread root and the pin bore corners at each TBO; the pin bores with the pins pressed out (new pins fitted after) or by a face-corner procedure with the pins in place; open NDE item: demonstration of the procedures, probability of detection at the thread root and the pin bore corners (3.10, 3.11); NDT at TBO after stripping the coating (NASA-STD-5009C sizes credited only under NER 12, 13 and 21, otherwise a demonstrated POD) | serviceable and repairable damage limits by zone (the D4 locations and the rest) and damage type (nicks, dents, scratches, corrosion pits, fretting) in the ICA (3.10) | every finding recorded against the part serial number and assessed by the type certificate holder (the recording and assessment loop); fleet findings feed the D4 inputs | fixed-process designation of the melt, forging or casting (foundry and technique for P101), heat treatment, peening, finishing and NDT, with change control | process validation on first articles: microstructure, properties, residual stress and NDT capability | serial number on the part, flight cycles and hours counted by the engine monitoring unit (1 cycle per flight, plus each LD-01 exceedance), life limit in the ICA airworthiness limitations section | 3.11: specimen fatigue (-3 sigma endurance) of each material and process at the GAG ratio, 4340 threshold (ASTM E647, R 0.1-0.9, two heats), MJ120 x 2 thread-root fatigue, coupling diaphragm fatigue, A357 HIP coupons and pore-seeded specimens, component tests of P103 and the couplings
P103 | yes | critical by decision (design decision, delegated by Hamit), not by the derivation rule (its FMEA rows are major with the tube and lip): conservative; the D1 E1 rate (1e-7 per hour) and the G2 coverage table rely on the CS-E 515 programme; the major class of its FMEA rows relies on the tube and lip with their TBO inspection | karar gereği kritik (tasarım kararı, Hamit'in yetkisiyle), türetme kuralıyla değil (FMEA satırları tüp ve dudakla büyük): emniyetli; D1 E1 oranı (saatte 1e-7) ve G2 kapsama tablosu CS-E 515 programına dayanır; FMEA satırlarının büyük sınıfı tüp, dudak ve onların TBO muayenesine dayanır | Carrier of P103 at a pin bore edge | AISI 4340 (1240 MPa) | 304.460559594489 | 150 | 213863062534427 | 20000 | 206944.507931584 | 2.21312832421558 | 2.21305487152718 | 2.21927702518896 | 1 | 2.90464828059605 | 20,000 flight cycles declared; basis: the GAG stress range at each governing feature is below the -3 sigma crack-initiation endurance of that material and process (cited data; A357: validated casting quality) | VAR melt, forging with grain flow along the shaft, Q&T to AMS 2759/1, shot peen of the D4 locations (PR-04), no grinding burns (temper etch PR-06), zinc-nickel with bake outside (PR-14); KM24 thread MJ120 x 2 (ISO 5855) rolled after heat treatment, local 95 mm bore under it | UT of the forging (AMS 2630 class AA), MPI after final machining as the general surface check (NER 21); eddy current (ET, NASA-STD-5009C sizes) of the bearing seat, the thread root and the pin bore corners | ET of the bearing seat, the thread root and the pin bore corners at each TBO; the pin bores with the pins pressed out (new pins fitted after) or by a face-corner procedure with the pins in place; open NDE item: demonstration of the procedures, probability of detection at the thread root and the pin bore corners (3.10, 3.11); NDT at TBO after stripping the coating (NASA-STD-5009C sizes credited only under NER 12, 13 and 21, otherwise a demonstrated POD) | serviceable and repairable damage limits by zone (the D4 locations and the rest) and damage type (nicks, dents, scratches, corrosion pits, fretting) in the ICA (3.10) | every finding recorded against the part serial number and assessed by the type certificate holder (the recording and assessment loop); fleet findings feed the D4 inputs | fixed-process designation of the melt, forging or casting (foundry and technique for P101), heat treatment, peening, finishing and NDT, with change control | process validation on first articles: microstructure, properties, residual stress and NDT capability | serial number on the part, flight cycles and hours counted by the engine monitoring unit (1 cycle per flight, plus each LD-01 exceedance), life limit in the ICA airworthiness limitations section | 3.11: specimen fatigue (-3 sigma endurance) of each material and process at the GAG ratio, 4340 threshold (ASTM E647, R 0.1-0.9, two heats), MJ120 x 2 thread-root fatigue, coupling diaphragm fatigue, A357 HIP coupons and pore-seeded specimens, component tests of P103 and the couplings
P103 | yes | critical by decision (design decision, delegated by Hamit), not by the derivation rule (its FMEA rows are major with the tube and lip): conservative; the D1 E1 rate (1e-7 per hour) and the G2 coverage table rely on the CS-E 515 programme; the major class of its FMEA rows relies on the tube and lip with their TBO inspection | karar gereği kritik (tasarım kararı, Hamit'in yetkisiyle), türetme kuralıyla değil (FMEA satırları tüp ve dudakla büyük): emniyetli; D1 E1 oranı (saatte 1e-7) ve G2 kapsama tablosu CS-E 515 programına dayanır; FMEA satırlarının büyük sınıfı tüp, dudak ve onların TBO muayenesine dayanır | Propeller shaft P103 at the shoulder-ring groove | AISI 4340 (1240 MPa) | 113.275751794115 | 0 | 5.58740684535258e+16 | 20000 | 500604.416625501 | 2.48452623851627 | 2.44094774596313 | 2.70490760586312 | 21 | 2.93574679457751 | 20,000 flight cycles declared; basis: the GAG stress range at each governing feature is below the -3 sigma crack-initiation endurance of that material and process (cited data; A357: validated casting quality) | VAR melt, forging with grain flow along the shaft, Q&T to AMS 2759/1, shot peen of the D4 locations (PR-04), no grinding burns (temper etch PR-06), zinc-nickel with bake outside (PR-14); KM24 thread MJ120 x 2 (ISO 5855) rolled after heat treatment, local 95 mm bore under it | UT of the forging (AMS 2630 class AA), MPI after final machining as the general surface check (NER 21); eddy current (ET, NASA-STD-5009C sizes) of the bearing seat, the thread root and the pin bore corners | ET of the bearing seat, the thread root and the pin bore corners at each TBO; the pin bores with the pins pressed out (new pins fitted after) or by a face-corner procedure with the pins in place; open NDE item: demonstration of the procedures, probability of detection at the thread root and the pin bore corners (3.10, 3.11); NDT at TBO after stripping the coating (NASA-STD-5009C sizes credited only under NER 12, 13 and 21, otherwise a demonstrated POD) | serviceable and repairable damage limits by zone (the D4 locations and the rest) and damage type (nicks, dents, scratches, corrosion pits, fretting) in the ICA (3.10) | every finding recorded against the part serial number and assessed by the type certificate holder (the recording and assessment loop); fleet findings feed the D4 inputs | fixed-process designation of the melt, forging or casting (foundry and technique for P101), heat treatment, peening, finishing and NDT, with change control | process validation on first articles: microstructure, properties, residual stress and NDT capability | serial number on the part, flight cycles and hours counted by the engine monitoring unit (1 cycle per flight, plus each LD-01 exceedance), life limit in the ICA airworthiness limitations section | 3.11: specimen fatigue (-3 sigma endurance) of each material and process at the GAG ratio, 4340 threshold (ASTM E647, R 0.1-0.9, two heats), MJ120 x 2 thread-root fatigue, coupling diaphragm fatigue, A357 HIP coupons and pore-seeded specimens, component tests of P103 and the couplings
P111 | yes | single load path of the thrust from the QJ to the case nose: a primary failure releases the propeller (D1 C2) | itkinin QJ'den gövde burnuna tek yük yolu: birincil hasar pervaneyi bırakır (D1 C2) | Bearing housing P111 at the flange fillet | Ti-6Al-4V annealed | 120 | 0 | 393736457512.565 | 20000 | 309172.623824506 | 6.4 | 5.27723690140747 | 12.5469780998909 | 12 | 4.51319267591682 | 20,000 flight cycles declared; basis: the GAG stress range at each governing feature is below the -3 sigma crack-initiation endurance of that material and process (cited data; A357: validated casting quality) | premium (rotating-grade) Ti-6Al-4V for P111: triple VAR or cold hearth plus VAR, AMS 4928 forging, annealed, machined; anodized fits and threads | UT of the forging (AMS 2631 class AA), FPI level 4 after etch (NER 12, 13; ASTM E1417) | FPI level 4 of the flange fillet at each TBO after etch (NER 13); NDT at TBO after stripping the coating (NASA-STD-5009C sizes credited only under NER 12, 13 and 21, otherwise a demonstrated POD) | serviceable and repairable damage limits by zone (the D4 locations and the rest) and damage type (nicks, dents, scratches, corrosion pits, fretting) in the ICA (3.10) | every finding recorded against the part serial number and assessed by the type certificate holder (the recording and assessment loop); fleet findings feed the D4 inputs | fixed-process designation of the melt, forging or casting (foundry and technique for P101), heat treatment, peening, finishing and NDT, with change control | process validation on first articles: microstructure, properties, residual stress and NDT capability | serial number on the part, flight cycles and hours counted by the engine monitoring unit (1 cycle per flight, plus each LD-01 exceedance), life limit in the ICA airworthiness limitations section | 3.11: specimen fatigue (-3 sigma endurance) of each material and process at the GAG ratio, 4340 threshold (ASTM E647, R 0.1-0.9, two heats), MJ120 x 2 thread-root fatigue, coupling diaphragm fatigue, A357 HIP coupons and pore-seeded specimens, component tests of P103 and the couplings
planetary case | yes | carries the propeller loads to the mounts on its flange (mount card A): a primary failure of the nose or mount flange releases the propeller and RGB (D1 C3) | pervane yüklerini flanşındaki bağlantılara taşır (bağlantı kartı A): burun veya bağlantı flanşının birincil hasarı pervaneyi ve RGB'yi bırakır (D1 C3) | Planetary case at the R10 flange junction | A357.0-T6 sand casting (HIP) | 45.4125 | 0 | 48705018256.1074 | 20000 | 13515504.1241783 | 0.489230210409364 | 0.64 | 3.18 | 0 | 1.26847784540444 | 20,000 flight cycles declared; basis: the GAG stress range at each governing feature is below the -3 sigma crack-initiation endurance of that material and process (cited data; A357: validated casting quality) | premium-quality A357-T6 casting (AMS-A-21180) from a fixed foundry and technique, chills at the critical zones, HIP of the whole casting, T6 (AMS 2771), test bars and coupons per melt; critical-zone pore limit 0.5 mm diameter (0.8 mm elsewhere); zone note on the 3.9 drawing | critical zones of every P101 casting (R10 flange junction, nose, mount flange and pads) at the 0.5 mm pore limit by CT (preferred) or radiography at quality level 1-2T or better (ASTM E1742 with E1025 IQIs, POD of 0.5 mm demonstrated); elsewhere 100% radiography at 0.8 mm (PR-10); FPI level 3 after etch (NER 12, 13) | FPI and visual of the flange junction and the nose at each TBO; HUMS A1 trend; NDT at TBO after stripping the coating (NASA-STD-5009C sizes credited only under NER 12, 13 and 21, otherwise a demonstrated POD) | serviceable and repairable damage limits by zone (the D4 locations and the rest) and damage type (nicks, dents, scratches, corrosion pits, fretting) in the ICA (3.10) | every finding recorded against the part serial number and assessed by the type certificate holder (the recording and assessment loop); fleet findings feed the D4 inputs | fixed-process designation of the melt, forging or casting (foundry and technique for P101), heat treatment, peening, finishing and NDT, with change control | process validation on first articles: microstructure, properties, residual stress and NDT capability | serial number on the part, flight cycles and hours counted by the engine monitoring unit (1 cycle per flight, plus each LD-01 exceedance), life limit in the ICA airworthiness limitations section | 3.11: specimen fatigue (-3 sigma endurance) of each material and process at the GAG ratio, 4340 threshold (ASTM E647, R 0.1-0.9, two heats), MJ120 x 2 thread-root fatigue, coupling diaphragm fatigue, A357 HIP coupons and pore-seeded specimens, component tests of P103 and the couplings
planetary case | yes | carries the propeller loads to the mounts on its flange (mount card A): a primary failure of the nose or mount flange releases the propeller and RGB (D1 C3) | pervane yüklerini flanşındaki bağlantılara taşır (bağlantı kartı A): burun veya bağlantı flanşının birincil hasarı pervaneyi ve RGB'yi bırakır (D1 C3) | Planetary case nose at the NJ1024 thermocouple boss | A357.0-T6 sand casting (HIP) | 60.2083333333333 | 0 | 2416312486.11923 | 20000 | 3152109.81823702 | 0.391520907437839 | 0.64 | 3.18 | 0 | 1.13320819975926 | 20,000 flight cycles declared; basis: the GAG stress range at each governing feature is below the -3 sigma crack-initiation endurance of that material and process (cited data; A357: validated casting quality) | premium-quality A357-T6 casting (AMS-A-21180) from a fixed foundry and technique, chills at the critical zones, HIP of the whole casting, T6 (AMS 2771), test bars and coupons per melt; critical-zone pore limit 0.5 mm diameter (0.8 mm elsewhere); zone note on the 3.9 drawing | critical zones of every P101 casting (R10 flange junction, nose, mount flange and pads) at the 0.5 mm pore limit by CT (preferred) or radiography at quality level 1-2T or better (ASTM E1742 with E1025 IQIs, POD of 0.5 mm demonstrated); elsewhere 100% radiography at 0.8 mm (PR-10); FPI level 3 after etch (NER 12, 13) | FPI and visual of the flange junction and the nose at each TBO; HUMS A1 trend; NDT at TBO after stripping the coating (NASA-STD-5009C sizes credited only under NER 12, 13 and 21, otherwise a demonstrated POD) | serviceable and repairable damage limits by zone (the D4 locations and the rest) and damage type (nicks, dents, scratches, corrosion pits, fretting) in the ICA (3.10) | every finding recorded against the part serial number and assessed by the type certificate holder (the recording and assessment loop); fleet findings feed the D4 inputs | fixed-process designation of the melt, forging or casting (foundry and technique for P101), heat treatment, peening, finishing and NDT, with change control | process validation on first articles: microstructure, properties, residual stress and NDT capability | serial number on the part, flight cycles and hours counted by the engine monitoring unit (1 cycle per flight, plus each LD-01 exceedance), life limit in the ICA airworthiness limitations section | 3.11: specimen fatigue (-3 sigma endurance) of each material and process at the GAG ratio, 4340 threshold (ASTM E647, R 0.1-0.9, two heats), MJ120 x 2 thread-root fatigue, coupling diaphragm fatigue, A357 HIP coupons and pore-seeded specimens, component tests of P103 and the couplings
P117 QJ pull-out shoulder ring | yes | critical by decision: it carries the primary pull-out from P103 to the QJ1024 (a split ring in a P103 groove with a retaining sleeve, G1b); its failure leaves the lip to catch the collar (D1 E8 + E5) | karar gereği kritik: birincil çekme yükünü P103'ten QJ1024'e taşır (P103 kanalında bölünmüş halka ve tutucu kovan, G1b); hasarında yakayı dudak yakalar (D1 E8 + E5) | D4 in 3.9 (solid ring in shear) |  | NaN | NaN | NaN | NaN | NaN | NaN | NaN | NaN | NaN | NaN | 20,000 flight cycles declared; basis: the GAG stress range at each governing feature is below the -3 sigma crack-initiation endurance of that material and process (cited data; A357: validated casting quality) | VAR melt, forging with grain flow along the shaft, Q&T to AMS 2759/1, shot peen of the D4 locations (PR-04), no grinding burns (temper etch PR-06), zinc-nickel with bake outside (PR-14) | UT of the forging (AMS 2630 class AA), MPI after final machining (ASTM E1444, wet fluorescent, continuous or multidirectional: NER 21) | MPI (NER 21) or ET of the D4 locations at each TBO; visual and dimensional check of seats and threads; NDT at TBO after stripping the coating (NASA-STD-5009C sizes credited only under NER 12, 13 and 21, otherwise a demonstrated POD) | serviceable and repairable damage limits by zone (the D4 locations and the rest) and damage type (nicks, dents, scratches, corrosion pits, fretting) in the ICA (3.10) | every finding recorded against the part serial number and assessed by the type certificate holder (the recording and assessment loop); fleet findings feed the D4 inputs | fixed-process designation of the melt, forging or casting (foundry and technique for P101), heat treatment, peening, finishing and NDT, with change control | process validation on first articles: microstructure, properties, residual stress and NDT capability | serial number on the part, flight cycles and hours counted by the engine monitoring unit (1 cycle per flight, plus each LD-01 exceedance), life limit in the ICA airworthiness limitations section | 3.11: specimen fatigue (-3 sigma endurance) of each material and process at the GAG ratio, 4340 threshold (ASTM E647, R 0.1-0.9, two heats), MJ120 x 2 thread-root fatigue, coupling diaphragm fatigue, A357 HIP coupons and pore-seeded specimens, component tests of P103 and the couplings
P115 propeller flange and bolts | no | backed by the retention tube P114 anchored in the propeller hub (D1 E6 + E2) | pervane hubına bağlanan tutma tüpü P114 ile yedekli (D1 E6 + E2) |  |  | NaN | NaN | NaN | NaN | NaN | NaN | NaN | NaN | NaN | NaN
P114 retention tube | no | standby path, no load in normal running; latent failure covered in D1 (inspected at each TBO, Airworthiness Limitations item) | yedek yol, normal çalışmada yüksüz; gizli hasarı D1'de (her TBO'da muayene, Uçuşa Elverişlilik Sınırlamaları maddesi) |  |  | NaN | NaN | NaN | NaN | NaN | NaN | NaN | NaN | NaN | NaN
P112 KM24 nut | no | outboard of the QJ1024: carries only the push-in thrust, not in the pull-out path (D1, FMEA FM24: a failure leads to gear damage, not release); locking and thread safety in 3.9 | QJ1024'ün dışında: yalnız itme yönündeki itkiyi taşır, çekme yolunda değil (D1, FMEA FM24: hasarı dişli hasarına yol açar, ayrılmaya değil); kilitleme ve diş emniyeti 3.9'da |  |  | NaN | NaN | NaN | NaN | NaN | NaN | NaN | NaN | NaN | NaN
P116 nose cover with the catcher lip | no | standby path, no load in normal running; latent failure covered in D1 (inspected at each TBO, Airworthiness Limitations item) | yedek yol, normal çalışmada yüksüz; gizli hasarı D1'de (her TBO'da muayene, Uçuşa Elverişlilik Sınırlamaları maddesi) |  |  | NaN | NaN | NaN | NaN | NaN | NaN | NaN | NaN | NaN | NaN
P104 planet pins | no | outside the propeller retention path: a failure jams the drive (loss of power, LD-08), not a release | pervane tutma yolunun dışında: hasar tahriki kilitler (güç kaybı, LD-08), bırakma değil |  |  | NaN | NaN | NaN | NaN | NaN | NaN | NaN | NaN | NaN | NaN
Diaphragm couplings F213, F214 | yes | CS-E 515 critical (design decision, delegated by Hamit; CS-E 850 and CM-PIFS-017 Table 1 name torque-coupling features): a diaphragm crack lets the PT shaft flail in the tunnel (FMEA FM30) | CS-E 515 kritik (tasarım kararı, Hamit'in yetkisiyle; CS-E 850 ve CM-PIFS-017 Tablo 1 tork kavrama unsurlarını sayar): diyafram çatlağı PT milinin tünelde savrulmasına yol açar (FMEA FM30) | Diaphragm coupling at the thinnest section (hub radius) | 15-5PH H1025 sheet and forging | 431.16902625335 | 0 | 45563222.546871 | 20000 | 7195.39160499418 | 0.935043764040195 | 0.3 | 2.54 | 0 | 2.40162862043424 | 20,000 flight cycles declared; basis: the GAG stress range at each governing feature is below the -3 sigma crack-initiation endurance of that material and process (cited data; A357: validated casting quality) | Diaphragm couplings F213, F214: 15-5PH (AMS 5659) H1025, diaphragms from controlled sheet with polished faces and peened hub transitions, fixed supplier and process | FPI level 4 of every diaphragm after etch (NER 12, 13), dimensional and flatness check | FPI of the diaphragms and ET of the hub transitions at each TBO, alignment check at installation; NDT at TBO after stripping the coating (NASA-STD-5009C sizes credited only under NER 12, 13 and 21, otherwise a demonstrated POD) | serviceable and repairable damage limits by zone (the D4 locations and the rest) and damage type (nicks, dents, scratches, corrosion pits, fretting) in the ICA (3.10) | every finding recorded against the part serial number and assessed by the type certificate holder (the recording and assessment loop); fleet findings feed the D4 inputs | fixed-process designation of the melt, forging or casting (foundry and technique for P101), heat treatment, peening, finishing and NDT, with change control | process validation on first articles: microstructure, properties, residual stress and NDT capability | serial number on the part, flight cycles and hours counted by the engine monitoring unit (1 cycle per flight, plus each LD-01 exceedance), life limit in the ICA airworthiness limitations section | 3.11: specimen fatigue (-3 sigma endurance) of each material and process at the GAG ratio, 4340 threshold (ASTM E647, R 0.1-0.9, two heats), MJ120 x 2 thread-root fatigue, coupling diaphragm fatigue, A357 HIP coupons and pore-seeded specimens, component tests of P103 and the couplings
Diaphragm couplings F213, F214 | yes | CS-E 515 critical (design decision, delegated by Hamit; CS-E 850 and CM-PIFS-017 Table 1 name torque-coupling features): a diaphragm crack lets the PT shaft flail in the tunnel (FMEA FM30) | CS-E 515 kritik (tasarım kararı, Hamit'in yetkisiyle; CS-E 850 ve CM-PIFS-017 Tablo 1 tork kavrama unsurlarını sayar): diyafram çatlağı PT milinin tünelde savrulmasına yol açar (FMEA FM30) | Diaphragm coupling at the hub transition | 15-5PH H1025 sheet and forging | 70.7118641750807 | 0 | 1.44810222297875e+18 | 20000 | 1335095.72749167 | 2.4 | 2.40178540767564 | 2.96652031594656 | 51 | 8.58727969635103 | 20,000 flight cycles declared; basis: the GAG stress range at each governing feature is below the -3 sigma crack-initiation endurance of that material and process (cited data; A357: validated casting quality) | Diaphragm couplings F213, F214: 15-5PH (AMS 5659) H1025, diaphragms from controlled sheet with polished faces and peened hub transitions, fixed supplier and process | FPI level 4 of every diaphragm after etch (NER 12, 13), dimensional and flatness check | FPI of the diaphragms and ET of the hub transitions at each TBO, alignment check at installation; NDT at TBO after stripping the coating (NASA-STD-5009C sizes credited only under NER 12, 13 and 21, otherwise a demonstrated POD) | serviceable and repairable damage limits by zone (the D4 locations and the rest) and damage type (nicks, dents, scratches, corrosion pits, fretting) in the ICA (3.10) | every finding recorded against the part serial number and assessed by the type certificate holder (the recording and assessment loop); fleet findings feed the D4 inputs | fixed-process designation of the melt, forging or casting (foundry and technique for P101), heat treatment, peening, finishing and NDT, with change control | process validation on first articles: microstructure, properties, residual stress and NDT capability | serial number on the part, flight cycles and hours counted by the engine monitoring unit (1 cycle per flight, plus each LD-01 exceedance), life limit in the ICA airworthiness limitations section | 3.11: specimen fatigue (-3 sigma endurance) of each material and process at the GAG ratio, 4340 threshold (ASTM E647, R 0.1-0.9, two heats), MJ120 x 2 thread-root fatigue, coupling diaphragm fatigue, A357 HIP coupons and pore-seeded specimens, component tests of P103 and the couplings
Intermediate shaft, sun quill | no | a failure unloads the PT like any drive-chain break; SAF-03 / SAF-06 limit the overspeed (FMEA FM31, FM18) | hasar, her tahrik zinciri kopması gibi PT'yi yüksüz bırakır; aşırı devri SAF-03 / SAF-06 sınırlar (FMEA FM31, FM18) |  |  | NaN | NaN | NaN | NaN | NaN | NaN | NaN | NaN | NaN | NaN
Bolted joints (P111 to nose, mounts, case flange) | no | multiple fasteners: one lost is not hazardous (D1 M1); preload, locking, torque check | çok cıvatalı: birinin kaybı tehlikeli değil (D1 M1); ön yük, kilitleme, tork kontrolü |  |  | NaN | NaN | NaN | NaN | NaN | NaN | NaN | NaN | NaN | NaN
First-stage case F201 | no | not in the propeller load path (mounts on the planetary case flange); a crack leaks oil (major, D5) | pervane yük yolunda değil (bağlantılar planet gövdesi flanşında); çatlak yağ kaçırır (büyük, D5) |  |  | NaN | NaN | NaN | NaN | NaN | NaN | NaN | NaN | NaN | NaN
