tanboga20/turboprop-from-turboshaft/maintenance/mnt_tasks_v1.csv

task | task_en | task_tr | level | step | step_en | step_tr | fasteners | connectors | lines | remove_min | install_min | people | rgb_installed | ica | requirement
T01 | RGB module removal and installation on the engine (MNT-01) | RGB modülünün motordan sökülüp takılması (MNT-01) | line | 1 | Open cowls, drain RGB oil system | Kaportaları aç, RGB yağ sistemini boşalt | 0 | 0 | 0 | 50.0 | 0.0 | 1 | yes |  | MNT-01
T01 | RGB module removal and installation on the engine (MNT-01) | RGB modülünün motordan sökülüp takılması (MNT-01) | line | 2 | Disconnect the RGB harness (chip detectors, ODM, pressure, temperature, filter, switch, mist valve) and the 3 accelerometer leads (7 connectors, TBD) | RGB kablo demetini (talaş dedektörleri, ODM, basınç, sıcaklık, filtre, anahtar, sis valfi) ve 3 ivmeölçer kablosunu ayır (7 konektör, TBD) | 0 | 7 | 0 | 7.0 | 21.0 | 1 | yes |  | MNT-01
T01 | RGB module removal and installation on the engine (MNT-01) | RGB modülünün motordan sökülüp takılması (MNT-01) | line | 3 | Disconnect the oil lines (cooler in and out, tank supply, tank vent, PT rear sump scavenge) and the mist bleed-air line (6 lines) | Yağ hatlarını (soğutucu giriş ve çıkış, tank besleme, tank havalandırma, PT arka karter emiş) ve sis hava hattını ayır (6 hat) | 0 | 0 | 6 | 30.0 | 60.0 | 1 | yes |  | MNT-01
T01 | RGB module removal and installation on the engine (MNT-01) | RGB modülünün motordan sökülüp takılması (MNT-01) | line | 4 | Fit the core support cradle and rig the RGB hoist (the engine mounts are on the RGB flange, ICD-24) | Çekirdek destek beşiğini tak, RGB vincini bağla (motor bağlantıları RGB flanşında, ICD-24) | 0 | 0 | 0 | 35.0 | 35.0 | 2 | yes |  | MNT-01
T01 | RGB module removal and installation on the engine (MNT-01) | RGB modülünün motordan sökülüp takılması (MNT-01) | line | 5 | Disconnect the input drive at the RGB-end diaphragm coupling (8 bolts, TBR) | Giriş tahrikini RGB tarafı diyafram kaplinden ayır (8 cıvata, TBR) | 8 | 0 | 0 | 4.0 | 12.0 | 1 | yes |  | MNT-01
T01 | RGB module removal and installation on the engine (MNT-01) | RGB modülünün motordan sökülüp takılması (MNT-01) | line | 6 | Release the aircraft mount links at the RGB flange (3 bolts, TBD airframer) and the RGB to PT-tunnel flange (12 bolts, TBD core maker) | RGB flanşındaki uçak bağlantı çubuklarını (3 cıvata, TBD) ve RGB-PT tüneli flanşını (12 cıvata, TBD) çöz | 15 | 0 | 0 | 7.5 | 22.5 | 2 | yes |  | MNT-01
T01 | RGB module removal and installation on the engine (MNT-01) | RGB modülünün motordan sökülüp takılması (MNT-01) | line | 7 | Draw the RGB forward on the hoist and set it on its stand (about 110 kg) | RGB'yi vinçle öne çek ve sehpasına koy (yaklaşık 110 kg) | 0 | 0 | 0 | 25.0 | 25.0 | 2 | yes |  | MNT-01
T01 | RGB module removal and installation on the engine (MNT-01) | RGB modülünün motordan sökülüp takılması (MNT-01) | line | 8 | Measure and set the coupling pre-stretch with the selective shim (0.75 mm) | Kaplin ön gerdirmesini seçmeli şimle ölç ve ayarla (0,75 mm) | 0 | 0 | 0 | 0.0 | 30.0 | 1 | yes | ICA-22 | MNT-01
T01 | RGB module removal and installation on the engine (MNT-01) | RGB modülünün motordan sökülüp takılması (MNT-01) | line | 9 | Independent inspection of the coupling, mount and flange joints; fill oil, check level | Kaplin, bağlantı ve flanş birleşimlerinin bağımsız muayenesi; yağ doldur, seviyeyi kontrol et | 0 | 0 | 0 | 0.0 | 45.0 | 2 | yes | ICA-06 | MNT-01
T01 | RGB module removal and installation on the engine (MNT-01) | RGB modülünün motordan sökülüp takılması (MNT-01) | line | 10 | Ground run: leak check, HUMS baseline record, chip detectors clean | Yer çalıştırması: kaçak kontrolü, HUMS temel kaydı, talaş dedektörleri temiz | 0 | 0 | 0 | 0.0 | 30.0 | 2 | yes | ICA-14 | MNT-01, CTL-03
T02 | Planetary module change (shop) | Planet modülü değişimi (atölye) | shop | 1 | Remove the propeller bearing housing from the nose (12 x M6) and the nose cover (8 x M5) | Pervane yatak yuvasını burundan (12 x M6) ve burun kapağını (8 x M5) sök | 20 | 0 | 0 | 40.0 | 60.0 | 1 | no | ICA-02, ICA-04 | MNT-01
T02 | Planetary module change (shop) | Planet modülü değişimi (atölye) | shop | 2 | Separate the planetary case from the first-stage case at the flange (30 x M6, 6 dowels) and lift the planetary module off (sun stays on its quill) | Planet gövdesini birinci kademe gövdesinden flanştan ayır (30 x M6, 6 pim) ve planet modülünü kaldır (güneş milinde kalır) | 30 | 0 | 0 | 50.0 | 80.0 | 2 | no |  | MNT-01
T02 | Planetary module change (shop) | Planet modülü değişimi (atölye) | shop | 3 | Withdraw the carrier with the planets from the ring and case (ring retention plate 12 x M6); inspect planet bearings and the ring | Taşıyıcıyı planetlerle halkadan ve gövdeden çek (halka tutma plakası 12 x M6); planet rulmanlarını ve halkayı muayene et | 12 | 0 | 0 | 66.0 | 78.0 | 2 | no | ICA-07 | STR-05
T03 | First-stage and accessory module (shop) | Birinci kademe ve aksesuar modülü (atölye) | shop | 1 | Remove the accessory cover from the first-stage case (24 x M5) and the pump pack (4 x M6) | Aksesuar kapağını birinci kademe gövdesinden (24 x M5) ve pompa paketini (4 x M6) sök | 28 | 0 | 0 | 44.0 | 72.0 | 1 | no |  | MNT-01
T03 | First-stage and accessory module (shop) | Birinci kademe ve aksesuar modülü (atölye) | shop | 2 | Remove the generator cartridge (8 x M6) and draw out the intermediate and input shafts with their bearings; inspect gear 2, its damping ring and the shear necks | Jeneratör kartuşunu (8 x M6) sök, ara ve giriş millerini rulmanlarıyla çek; dişli 2'yi, sönüm halkasını ve kesme boyunlarını muayene et | 8 | 0 | 0 | 79.0 | 87.0 | 2 | no | ICA-09, ICA-15 | STR-05
T04 | Line tasks with the RGB installed (MNT-02) | RGB takılıyken hat görevleri (MNT-02) | line | 1 | Borescope the ring-planet mesh through port BP1 (z 117), turning the propeller by hand to bring each planet under the port, and the pinion-gear mesh through BP2 | BP1 deliğinden (z 117) halka-planet kavramasını, pervaneyi elle çevirip her planeti deliğin altına getirerek, ve BP2'den pinyon-dişli kavramasını boroskopla incele | 2 | 0 | 0 | 71.0 | 73.0 | 2 | yes | ICA-04 | MNT-02
T04 | Line tasks with the RGB installed (MNT-02) | RGB takılıyken hat görevleri (MNT-02) | line | 2 | Pull and check the chip detectors (self-closing valves), take the oil sample | Talaş dedektörlerini çıkar ve kontrol et (kendinden kapanan valfler), yağ numunesi al | 0 | 2 | 0 | 22.0 | 26.0 | 1 | yes | ICA-14 | MNT-02
T04 | Line tasks with the RGB installed (MNT-02) | RGB takılıyken hat görevleri (MNT-02) | line | 3 | Change the filter element, test the bypass valve and the impending-bypass indicator | Filtre elemanını değiştir, baypas valfini ve baypas öncesi göstergesini test et | 0 | 1 | 0 | 31.0 | 33.0 | 1 | yes | ICA-13 | MNT-02
T04 | Line tasks with the RGB installed (MNT-02) | RGB takılıyken hat görevleri (MNT-02) | line | 4 | Check the oil level, the mist accumulator pre-charge and the low-oil-pressure switch | Yağ seviyesini, sis akümülatörü ön dolumunu ve düşük yağ basıncı anahtarını kontrol et | 0 | 1 | 0 | 31.0 | 33.0 | 1 | yes | ICA-17, ICA-19 | MNT-02, LUB-07
T04 | Line tasks with the RGB installed (MNT-02) | RGB takılıyken hat görevleri (MNT-02) | line | 5 | Replace an accelerometer or the ODM sensor (2 x M5 each) | Bir ivmeölçeri ya da ODM algılayıcısını değiştir (her biri 2 x M5) | 2 | 1 | 0 | 12.0 | 16.0 | 1 | yes |  | MNT-02, CTL-03
T04 | Line tasks with the RGB installed (MNT-02) | RGB takılıyken hat görevleri (MNT-02) | line | 6 | Replace the generator on its pad (6 stud nuts, 3 connectors), OSG (8) or PCU (10) | Jeneratörü pedinde (6 saplama somunu, 3 konektör), OSG'yi (8) ya da PCU'yu (10) değiştir | 6 | 3 | 0 | 36.0 | 48.0 | 2 | yes | ICA-11 | MNT-02
