tanboga20/turboprop-from-turboshaft/requirements/test_cell_v1.csv

id | location_en | location_tr | quantity | sensor | rate | tests
MP-01 | PT shaft torque meter (phase shift) and dynamometer load cell | PT mili tork ölçer (faz kayması) ve dinamometre yük hücresi | torque | engine torque meter + dyno load cell (reference) | 1 kHz | ET-02;ET-03;ET-04;RT-09
MP-02 | Np (two protection probes) and Nr (two pickups), once-per-rev tachometers on the intermediate shaft and the carrier | Np (iki koruma algılayıcısı) ve Nr (iki algılayıcı), ara mil ve taşıyıcıda tur başına bir darbeli takometreler | speed, phase | magnetic pickups | 100 kHz (pulse timing) | ET-01;ET-03;ET-04;ET-09
MP-03 | Accelerometers: case wall over the ring gear (z 96), outer propeller bearing boss (z 442), first-stage case at the input bearings | İvmeölçerler: halka dişli üstü gövde duvarı (z 96), dış pervane yatağı göbeği (z 442), giriş yatakları yanında birinci kademe gövdesi | acceleration | triaxial ICP accelerometers, 0-25 kHz | 51.2 kHz | ET-01;ET-03;RT-09
MP-04 | Strain gauges: gear 2 web (telemetry), ring gear roots, P101 R10 flange junction and the 3.5 / 3.6 hot spots | Gerinim ölçerler: dişli 2 gövdesi (telemetri), halka dişli dip noktaları, P101 R10 flanş birleşimi ve 3.5 / 3.6 sıcak noktaları | strain | foil gauges; slip ring or telemetry on rotating parts | 20 kHz | ET-01;ET-02
MP-05 | Oil: pressure at the manifold and two jets, pump inlet, scavenge; temperature in and out of the RGB and of the cooler; flow | Yağ: manifold ve iki memede basınç, pompa girişi, emiş; RGB ve soğutucu giriş-çıkış sıcaklığı; debi | pressure, temperature, flow | transducers, RTDs, turbine flow meter | 10 Hz | ET-03;ET-05;ET-06;ET-08
MP-06 | Bearing outer rings: NJ1024, QJ1024, planet pins (telemetry), input QJ; P116 skirt | Rulman dış bilezikleri: NJ1024, QJ1024, planet pimleri (telemetri), giriş QJ; P116 eteği | temperature | thermocouples type K | 10 Hz | ET-03;ET-06;RT-07
MP-07 | Chip detectors, oil debris monitor, filter delta-p, oil samples every 10 h | Talaş dedektörleri, yağ kalıntısı izleyicisi, filtre basınç farkı, her 10 saatte yağ numunesi | debris | engine sensors + spectrometric oil analysis | event / 1 Hz | ET-03;ET-06
MP-08 | Pitch oil pressure at the transfer sleeve, feather solenoid, mist valve and accumulator pressure | Transfer manşonunda hatve yağı basıncı, tüyleme solenoidi, sis valfi ve akümülatör basıncı | pressure, discrete | transducers, FADEC data bus | 100 Hz | ET-05;ET-06;ET-07;ET-09;ET-10
MP-09 | Cell: inlet air temperature and pressure, cold-soak chamber, altitude cell pressure | Hücre: giriş havası sıcaklığı ve basıncı, soğuk bekletme odası, irtifa hücresi basıncı | ambient | cell instrumentation | 1 Hz | ET-03;ET-08
