tanboga20/turboprop-from-turboshaft/requirements/test_plan_v1.csv

id | sequence | level_en | level_tr | name_en | name_tr | rule | article | measured | pass_criterion_en | pass_criterion_tr | requirements | measuring_points
CT-01 | 1 | coupon | numune | A357-T6 coupons: hot yield and fatigue | A357-T6 numuneleri: sıcak akma ve yorulma | CS-E 70; CS-E 515 | test bars cut from the first P101 / F201 castings | yield at 20-350 degC (1/2 h), S-N at R = -1 and 0.1 | casting factor 1.25 and the 3.7 hot yield shown | 1,25 döküm katsayısı ve 3.7 sıcak akma değerleri gösterildi | STR-10;SAF-05
CT-02 | 1 | coupon | numune | Damping ring friction coupon | Sönüm halkası sürtünme numunesi | - | ring segment on an A357 groove coupon, oil-wetted | friction coefficient, wear | mu >= 0.15 (3.6 basis) | mu >= 0,15 (3.6 esası) | DYN-03
IN-01 | 2 | inspection | muayene | First article inspection | İlk parça muayenesi | CS-E 515; AS9102 | first P101, F201, P103, gears | CMM to the 3.8 callouts, CT / RT of castings, case depth coupons, Ra | all callouts of tolerances_v1.csv met; pores <= 0.5 mm in critical zones | tolerances_v1.csv'deki bütün işaretler sağlandı; kritik bölgelerde gözenek <= 0,5 mm | STR-06;STR-09;STR-10;SAF-02
RT-01 | 3 | rig | düzenek | Back-to-back gear rig (stage 1 + planetary) | Sırt sırta dişli test düzeneği (1. kademe + planet) | AGMA 925 / ISO 6336 practice | one RGB gear set in a back-to-back rig, MIL-PRF-23699 | strain gauges at the ring roots (load sharing), loaded TE, micropitting and scuffing inspection, losses | K_gamma <= 1.35; TE2 <= 0.15 um; no scuffing at 110% torque; losses <= SYS-05 | K_gamma <= 1,35; TE2 <= 0,15 um; %110 torkta tutukluk yok; kayıplar <= SYS-05 | STR-06;STR-07;STR-11;SYS-05
RT-02 | 3 | rig | düzenek | Planet bearing speed and load rig | Planet rulmanı hız ve yük düzeneği | - | planet with its integral outer race on the M50NiL pin | outer race temperature, cage slip, vibration | no skidding damage; temperature within the 2.5 limit | kayma hasarı yok; sıcaklık 2.5 sınırı içinde | STR-02
RT-03 | 3 | rig | düzenek | Static test of the cases (limit and ultimate) | Gövdelerin statik testi (sınır ve nihai) | STANAG 4671 USAR.305, USAR.307 | first P101 + F201 with the mounts | strain gauges at the 3.5 / 3.6 hot spots, deflection at the ring seat | no yield at limit (LD-03 to LD-05, LD-08), no failure at 1.5 x limit; stiffness within 10% of the FE | sınır yükte akma yok (LD-03 - LD-05, LD-08), 1,5 x sınırda kırılma yok; direngenlik sonlu elemanın %10'u içinde | STR-04;STR-10;LD-03;LD-04;LD-05;LD-08
RT-04 | 3 | rig | düzenek | Modal tap test and damping-ring ring-down | Modal vurma testi ve sönüm halkası sönümlenme testi | - | P101 with the ring gear, gear 2 web with and without the ring | accelerometers, impact hammer | case and web modes within 5% of 3.6; damping with the ring at or above the 3.6 value | gövde ve gövde-dişli modları 3.6'nın %5'i içinde; halkayla sönüm 3.6 değerinde ya da üstünde | DYN-03;DYN-04
RT-05 | 3 | rig | düzenek | Accessory pad and shear-neck test | Aksesuar yuvası ve kesme boynu testi | CS-E 80 (equipment) | generator pad with its quill | pad torque to the shear neck, overhung moment | shear neck fails within its band; pad holds 1.5 x limit | kesme boynu kendi bandında kırılır; yuva 1,5 x sınırı taşır | ACC-01;ACC-03
RT-06 | 3 | rig | düzenek | Fire test of F201 and the P101 / F201 joint | F201 ve P101 / F201 birleşiminin yangın testi | ISO 2685; AC 20-135 / AS6826; CS-E 130 | F201 with the joint and seals, oil flowing at the lowest flow | flame calibration, wall and seal temperatures, leakage | fire resistant 5 min with no leak that feeds the fire (SAF-05) | 5 dk yangına dayanıklı, yangını besleyen sızıntı yok (SAF-05) | SAF-05
RT-07 | 3 | rig | düzenek | NJ1024 standby rib test | NJ1024 yedek kenar testi | - | NJ1024 in the nose housing, push-in load | outer ring thermocouples, rib wear | carries the limp thrust (3.0 kN) to landing; thermocouple alert works | topal itkiyi (3,0 kN) inişe kadar taşır; termokupl uyarısı çalışır | SAF-01;CTL-04 | MP-06
RT-08 | 3 | rig | düzenek | Catcher-lip rub test (Ti on 4340) | Yakalama dudağı sürtünme testi (4340 üzerinde Ti) | - | P116 lip segment against a 4340 collar | temperature, wear depth | lip holds the run-down and feathered drag (3.7 basis) | dudak, dönüp durmayı ve tüylenmiş sürüklemeyi taşır (3.7 esası) | SAF-01
RT-09 | 3 | rig | düzenek | Torque meter calibration and HUMS baseline | Tork ölçer kalibrasyonu ve HUMS temel çizgisi | - | torque meter on a calibrated rig; HUMS on the first engine | torque signal against a reference, vibration baselines | torque error within the CTL-01 limit; HUMS baselines recorded | tork hatası CTL-01 sınırı içinde; HUMS temel kayıtları alındı | CTL-01;CTL-03 | MP-01;MP-03
RT-10 | 3 | rig | düzenek | Sand, dust and salt fog | Kum, toz ve tuz sisi | MIL-STD-810H 509, 510 | seals, breather and the nose air gap | ingress, corrosion, seal leakage | no ingress past the seals; no corrosion beyond the limits | keçeleri geçen giriş yok; sınırların ötesinde korozyon yok | ENV-03
RT-11 | 3 | rig | düzenek | Spline wear: crowned sun spline and accessory quills | Kama aşınması: bombeli güneş kaması ve aksesuar milleri | - | sun quill P106 in the intermediate shaft with the 3.8 misalignment; generator quill | wear depth and pattern, oil flow at the spline | wear after the TBO equivalent within the 3.8 spline fit allowance; lubricated contact pattern | TBO eşdeğerinden sonra aşınma 3.8 kama geçmesi payı içinde; yağlanmış temas izi | STR-05;ACC-03
ET-01 | 4 | engine | motor | Vibration survey | Titreşim taraması | CS-E 650; 14 CFR 33.83 | engine on a water-brake dynamometer (no propeller), then with the propeller | strain gauges on the case and the gear 2 web, accelerometers, speed sweep | all stresses within the endurance limits with margin (DYN-01 to DYN-05) | bütün gerilmeler yorulma sınırlarının altında, payla (DYN-01 - DYN-05) | DYN-01;DYN-02;DYN-03;DYN-04;DYN-05;ENV-04 | MP-02;MP-03;MP-04
ET-02 | 4 | engine | motor | Over-torque and transient torque | Aşırı tork ve geçici tork | CS-E 820; 14 CFR 33.84 | engine on the dynamometer | torque, speed, case strain | LD-01 transient and LD-02 over-torque run without damage; teardown clean | LD-01 geçici ve LD-02 aşırı tork hasarsız; sökümde temiz | LD-01;LD-02;SYS-08 | MP-01;MP-04
ET-04 | 4 | engine | motor | Overspeed and 110% transient speed | Aşırı hız ve %110 geçici hız | CS-E 830 | engine on the dynamometer | speeds, vibration | 110% transient run without damage | %110 geçici hız hasarsız | SYS-04 | MP-01;MP-02
ET-05 | 4 | engine | motor | Oil system: attitude and negative g | Yağ sistemi: duruş açısı ve negatif g | CS-E 570; 14 CFR 33.71 (lubrication system) | RGB oil system on a tilt rig, then the engine | pressures at the jets, scavenge, pitch oil pressure | jet pressure held at the attitudes and for the negative-g time | duruş açılarında ve negatif g süresince meme basıncı tutuldu | LUB-03;LUB-08;PIF-02 | MP-05;MP-08
ET-09 | 4 | engine | motor | Shaft-break protection (FADEC hardware-in-the-loop + engine trip) | Mil kopması koruması (FADEC donanım döngüsü + motor kesme) | CS-E 510; AMC E 510 | FADEC on a hardware-in-the-loop bench, then engine trips | detection time, valve closure time, peak PT speed | detection and closure within SAF-03; peak PT speed below the burst margin | algılama ve kapanma SAF-03 içinde; en yüksek PT hızı patlama payının altında | SAF-03;SAF-06;CTL-02;CTL-04 | MP-02;MP-08
ET-03 | 5 | engine | motor | Endurance test and teardown | Dayanıklılık testi ve söküm | CS-E 740; 14 CFR 33.87, 33.93 | engine on the dynamometer, 150 h schedule | power, losses, oil temperatures and pressures, chips, HUMS | rated power held; oil limits met; no distress at teardown | anma gücü tutuldu; yağ sınırları sağlandı; sökümde hasar yok | SYS-01;SYS-03;SYS-05;LUB-02;LUB-03;LUB-05;LUB-09;LUB-10;STR-06;CTL-03 | MP-01;MP-02;MP-03;MP-05;MP-06;MP-07;MP-09
ET-06 | 5 | engine | motor | Loss-of-oil run with the emergency mist | Acil sisle yağsız çalışma | LUB-07 (Hamit's decision) | engine on the dynamometer at 75% MCP | bearing and gear temperatures, mist flow | >= 6 min at 75% MCP after total oil-pressure loss | toplam yağ basıncı kaybından sonra %75 MCP'de >= 6 dk | LUB-07 | MP-05;MP-06;MP-07;MP-08
ET-07 | 5 | engine | motor | Windmilling | Rüzgârla dönme | CS-E 525 | engine with propeller, motored by the propeller | oil pressure, temperatures | lubrication held while windmilling (intact drive chain) | rüzgârla dönerken yağlama sürdü (sağlam tahrik zinciri) | SAF-04 | MP-08
ET-08 | 5 | engine | motor | Cold start and altitude | Soğuk kalkış ve irtifa | test cell (cold soak, altitude) | engine cold-soaked to -40 degC; altitude cell | oil temperature rise, jet pressure, pump inlet pressure | start and power within the 3.2 limits; no pump cavitation at altitude | kalkış ve güç 3.2 sınırları içinde; irtifada pompa kavitasyonu yok | ENV-01;ENV-02;LUB-02 | MP-05;MP-09
ET-10 | 5 | engine | motor | Feathering and propeller overspeed governor | Tüyleme ve pervane aşırı devir regülatörü | CS-P (propeller) with the propeller maker | engine with propeller | pitch oil pressure, propeller speed, feather time | feathers on loss of pitch oil; overspeed governor holds the limit | pervane yağı kaybında tüyler; aşırı devir regülatörü sınırı tutar | PIF-02;PIF-03;PIF-05 | MP-08
MD-01 | 6 | demonstration | gösterim | Maintenance demonstration | Bakım gösterimi | - | RGB modules (3.10) | removal and installation times | MNT-01 and MNT-02 met | MNT-01 ve MNT-02 sağlandı | MNT-01;MNT-02
