tanboga20/turboprop-from-turboshaft/cad/step/rgb_assembly.stp

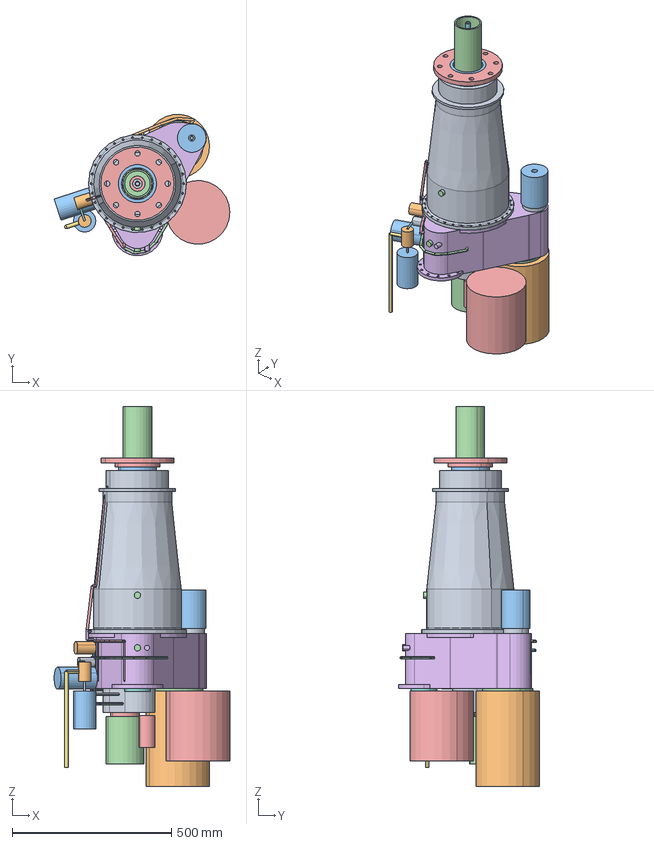
[picture p199: CAD file, 2026-11-03]
cad/step/rgb_assembly.stp
551.4 x 442.5 x 1192.0 mm
