tanboga20/turboprop-from-turboshaft/cad/step/oil_prv.stp

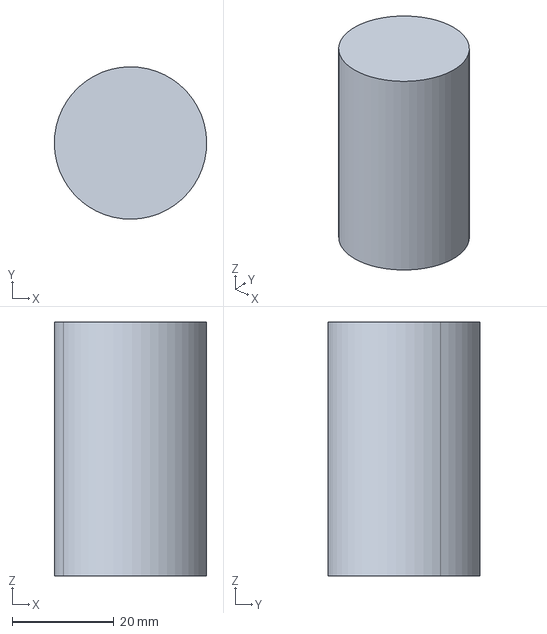
[picture p200: CAD file, 2026-11-03]
cad/step/oil_prv.stp
30.0 x 30.0 x 50.0 mm
