tanboga20/turboprop-from-turboshaft/cad/step/gen_cartridge.stp

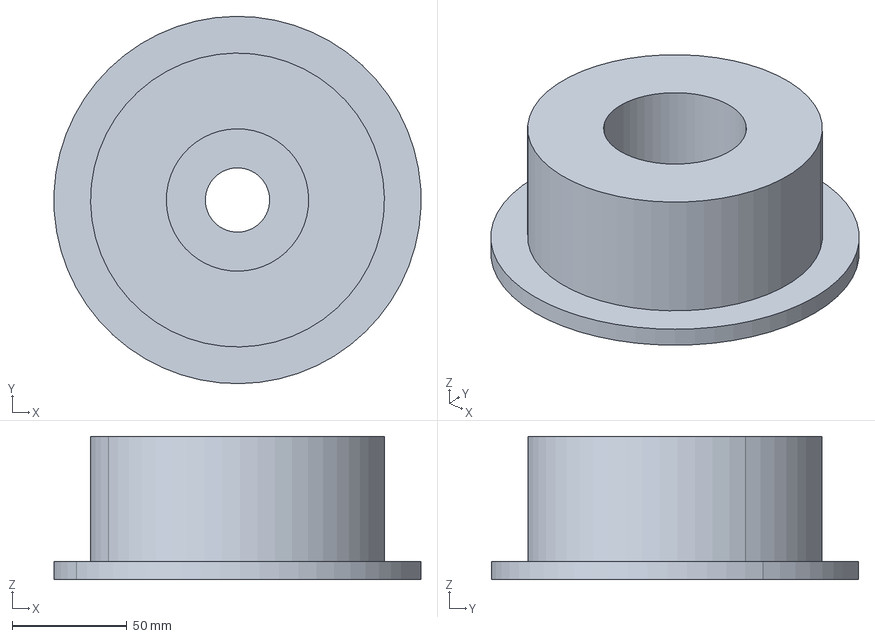
[picture p201: CAD file, 2026-11-03]
cad/step/gen_cartridge.stp
159.9 x 160.0 x 62.5 mm
