tanboga20/turboprop-from-turboshaft/cad/step/pcu_gear.stp

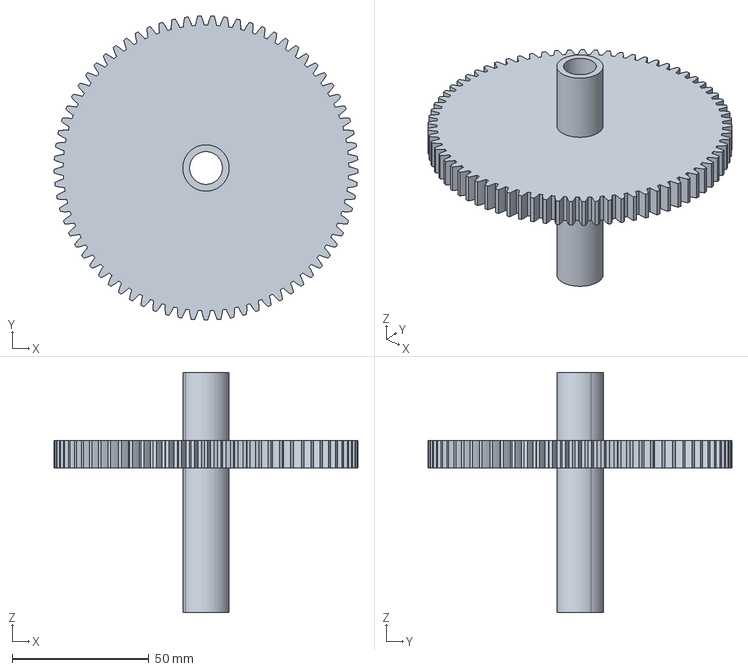
[picture p202: CAD file, 2026-11-03]
cad/step/pcu_gear.stp
111.3 x 111.3 x 88.0 mm
