tanboga20/turboprop-from-turboshaft/cad/step/planet_rollers.stp

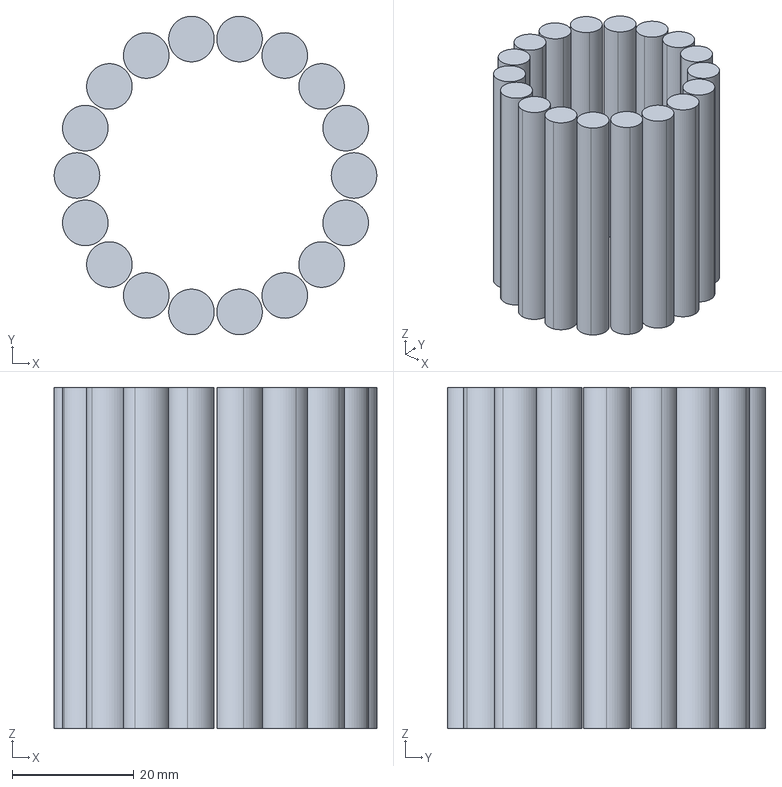
[picture p203: CAD file, 2026-11-03]
cad/step/planet_rollers.stp
53.0 x 52.3 x 56.0 mm
