tanboga20/turboprop-from-turboshaft/cad/step/gear2.stp

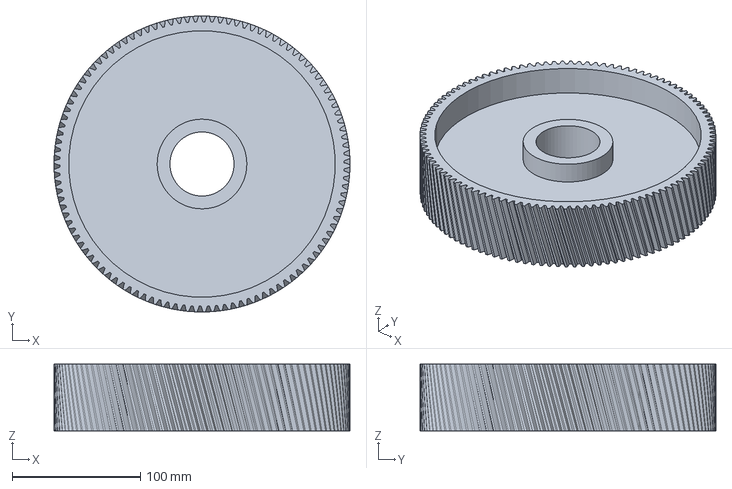
[picture p204: CAD file, 2026-11-03]
cad/step/gear2.stp
231.0 x 231.0 x 52.0 mm
