tanboga20/turboprop-from-turboshaft/cad/step/prop_flange.stp

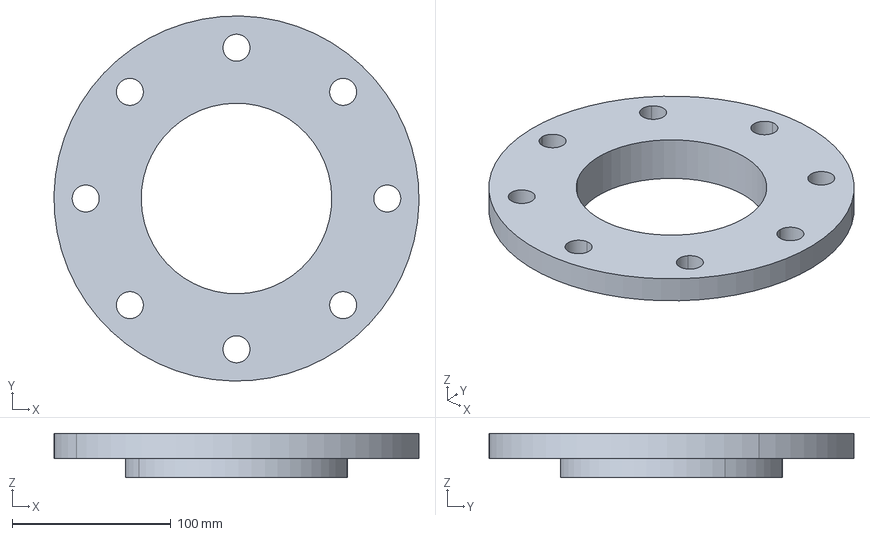
[picture p205: CAD file, 2026-11-03]
cad/step/prop_flange.stp
229.9 x 229.9 x 28.0 mm
