tanboga20/turboprop-from-turboshaft/cad/step/pinion.stp

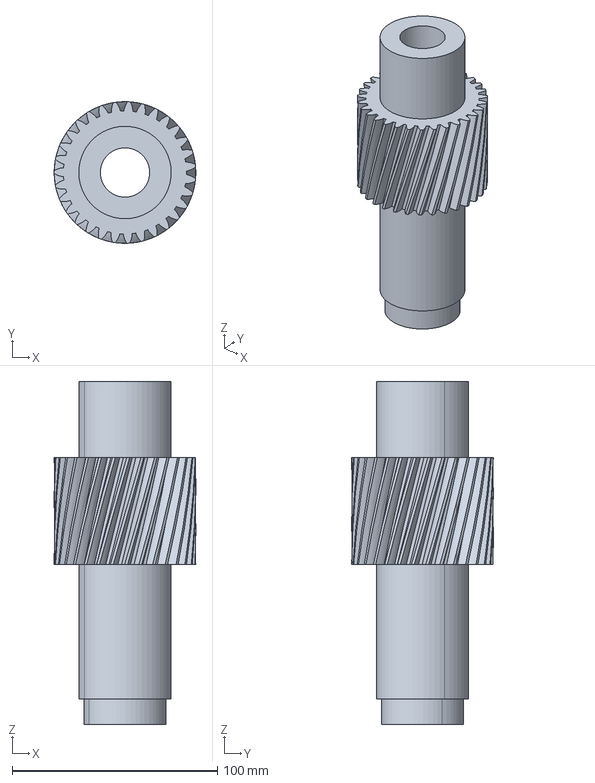
[picture p206: CAD file, 2026-11-03]
cad/step/pinion.stp
69.0 x 69.0 x 167.0 mm
