tanboga20/turboprop-from-turboshaft/cad/step/oil_route_07.stp

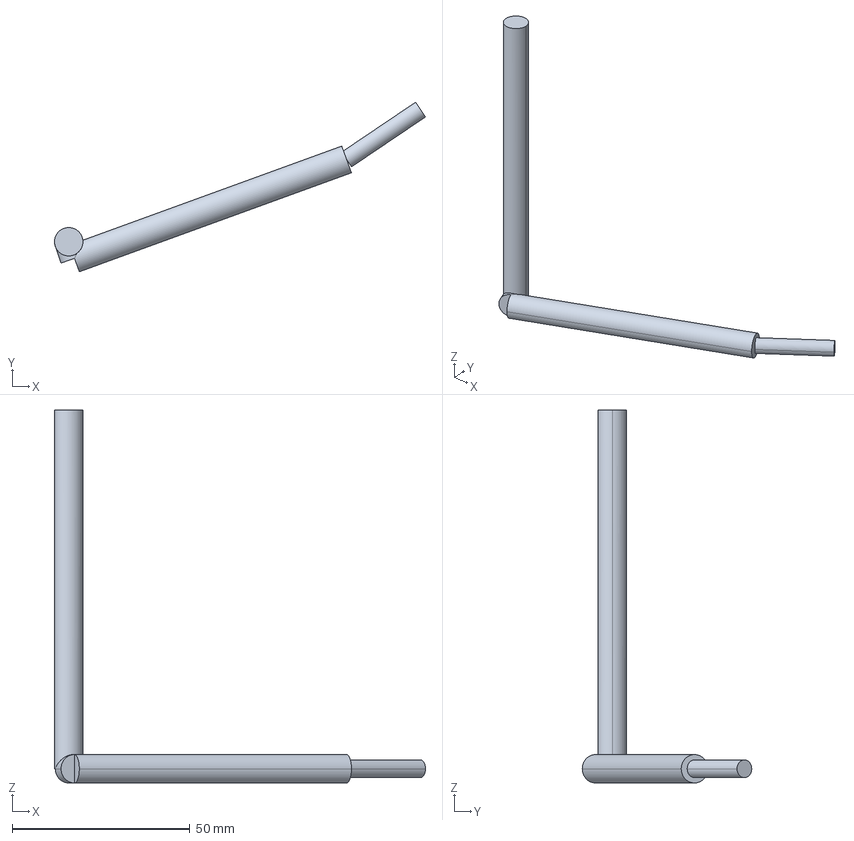
[picture p207: CAD file, 2026-11-03]
cad/step/oil_route_07.stp
104.5 x 47.7 x 105.0 mm
