tanboga20/turboprop-from-turboshaft/cad/step/pump_pack.stp

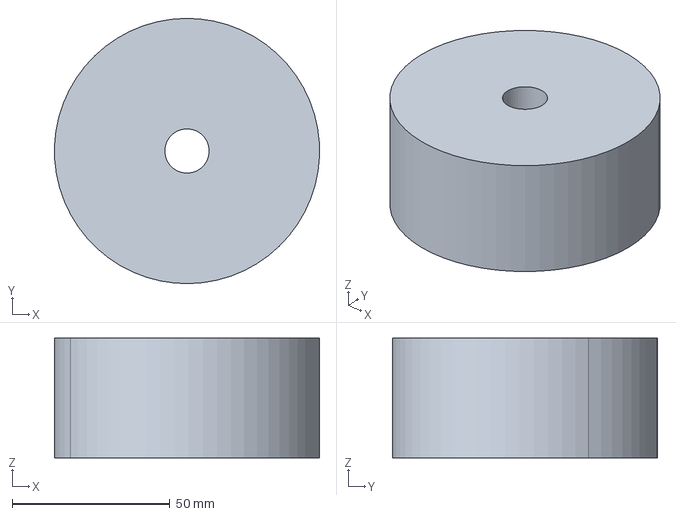
[picture p208: CAD file, 2026-11-03]
cad/step/pump_pack.stp
83.9 x 84.0 x 38.0 mm
