tanboga20/turboprop-from-turboshaft/cad/step/quill_osg.stp

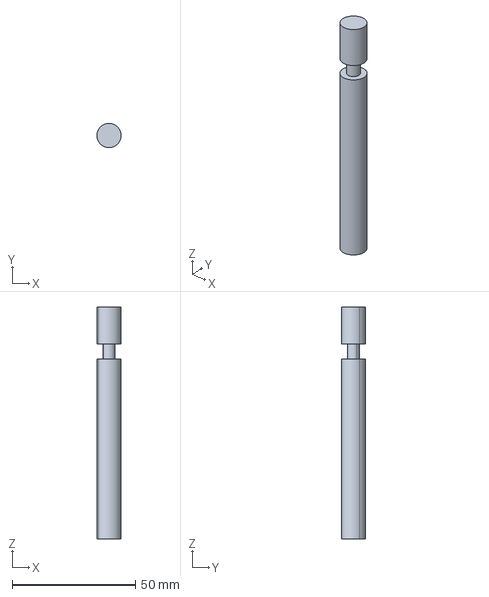
[picture p209: CAD file, 2026-11-03]
cad/step/quill_osg.stp
9.80 x 9.80 x 94.0 mm
