tanboga20/turboprop-from-turboshaft/cad/step/oil_filter.stp

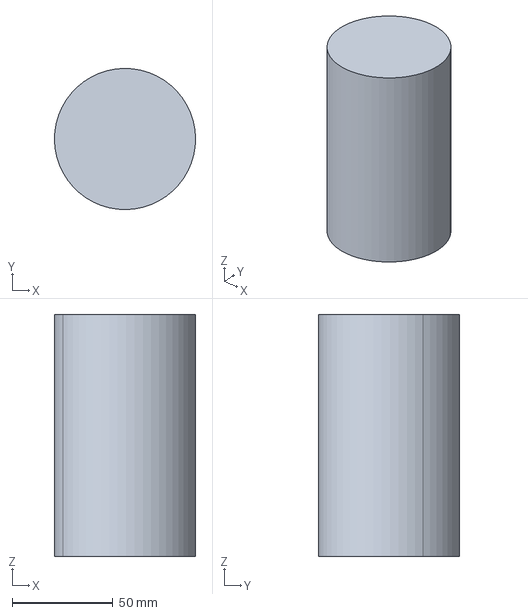
[picture p210: CAD file, 2026-11-03]
cad/step/oil_filter.stp
70.0 x 70.0 x 120.0 mm
