tanboga20/turboprop-from-turboshaft/cad/step/oil_route_05.stp

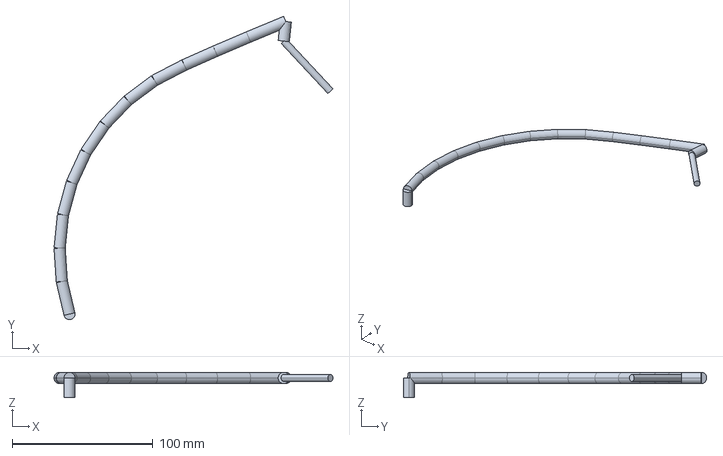
[picture p211: CAD file, 2026-11-03]
cad/step/oil_route_05.stp
198.3 x 215.6 x 18.0 mm
