tanboga20/turboprop-from-turboshaft/cad/step/seal_input.stp

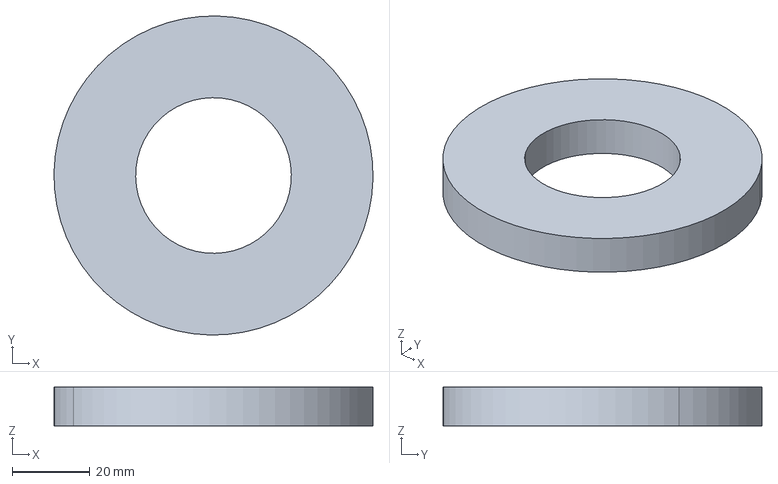
[picture p212: CAD file, 2026-11-03]
cad/step/seal_input.stp
82.0 x 82.0 x 10.0 mm
