tanboga20/turboprop-from-turboshaft/cad/step/oil_pitch_tube.stp

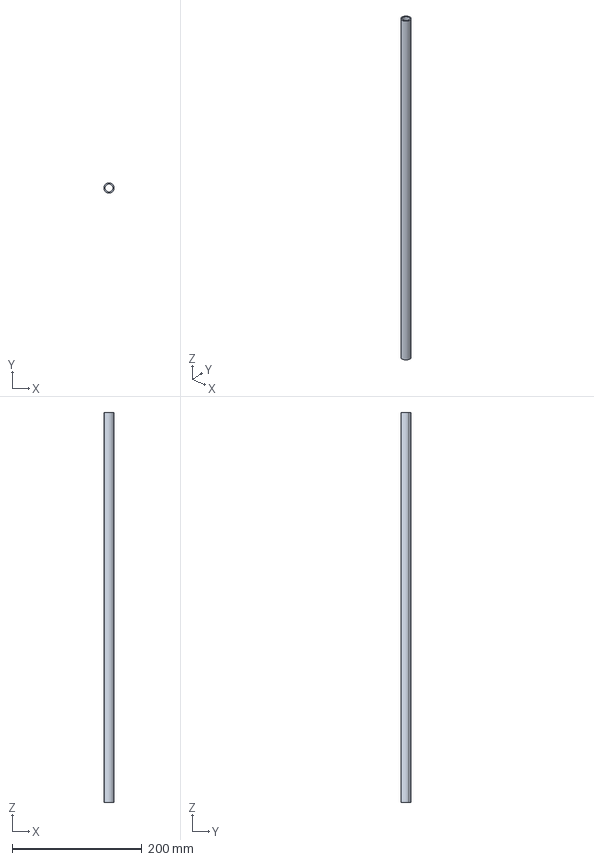
[picture p213: CAD file, 2026-11-03]
cad/step/oil_pitch_tube.stp
16.0 x 16.0 x 602.0 mm
