tanboga20/turboprop-from-turboshaft/cad/step/acc_cover.stp

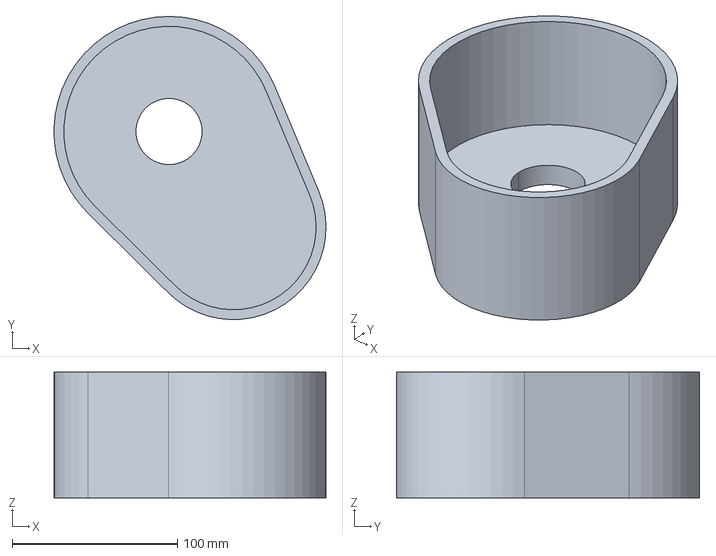
[picture p215: CAD file, 2026-11-03]
cad/step/acc_cover.stp
164.6 x 183.4 x 76.0 mm
