tanboga20/turboprop-from-turboshaft/cad/step/oil_route_08.stp

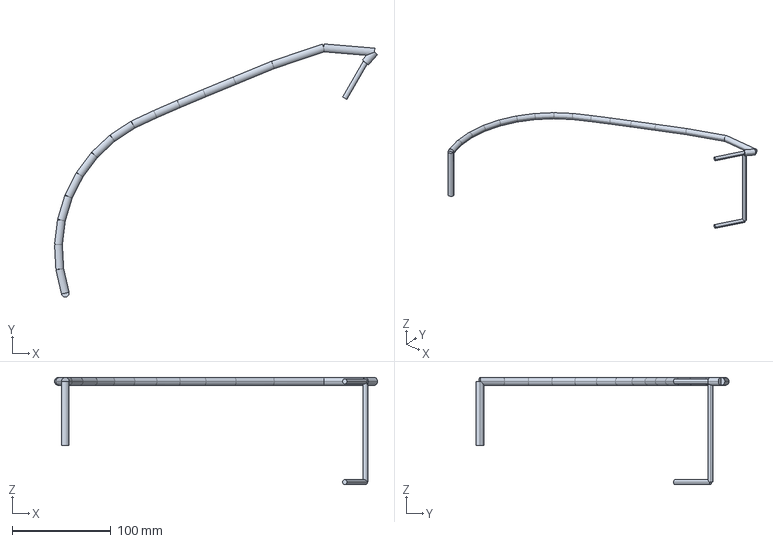
[picture p216: CAD file, 2026-11-03]
cad/step/oil_route_08.stp
327.2 x 256.4 x 108.5 mm
