tanboga20/turboprop-from-turboshaft/cad/step/pcu_adapter.stp

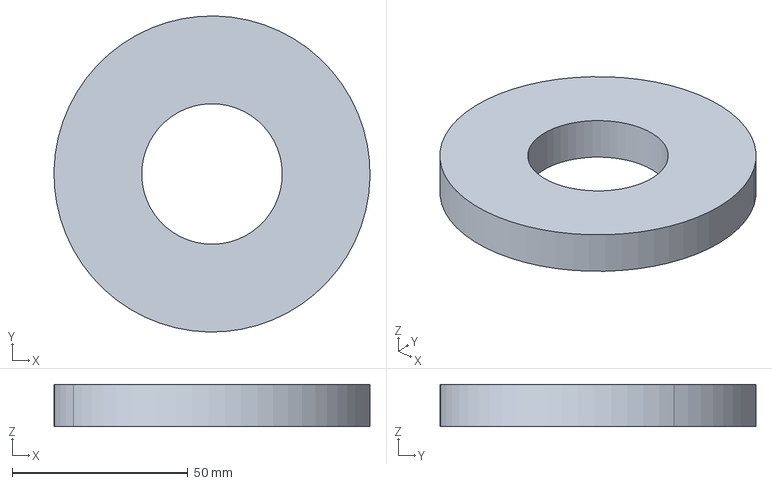
[picture p217: CAD file, 2026-11-03]
cad/step/pcu_adapter.stp
90.0 x 90.0 x 12.0 mm
