tanboga20/turboprop-from-turboshaft/cad/step/oil_route_03.stp

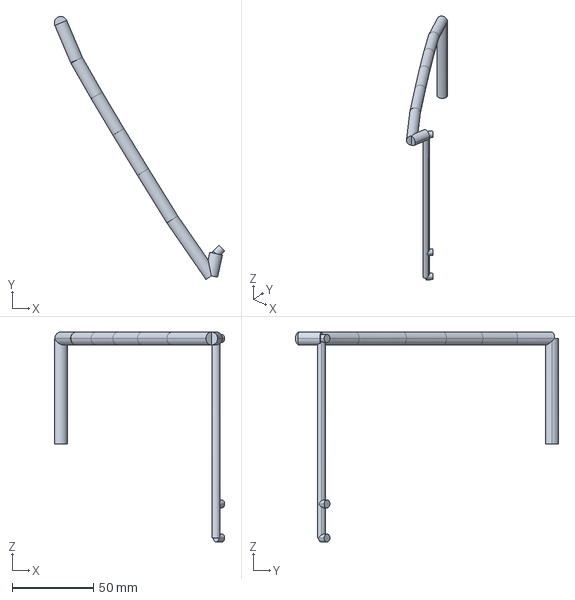
[picture p218: CAD file, 2026-11-03]
cad/step/oil_route_03.stp
105.1 x 162.2 x 129.5 mm
