tanboga20/turboprop-from-turboshaft/cad/step/brg_QJ1024.stp

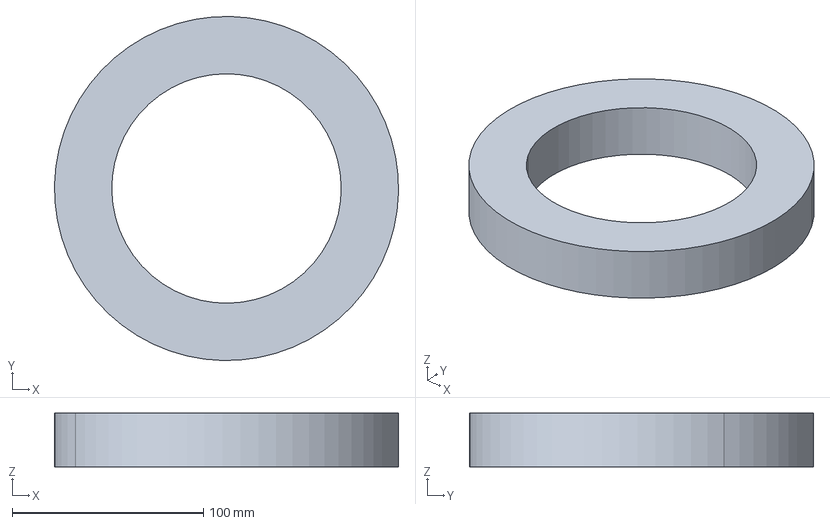
[picture p220: CAD file, 2026-11-03]
cad/step/brg_QJ1024.stp
179.9 x 179.9 x 28.0 mm
