tanboga20/turboprop-from-turboshaft/cad/step/ring.stp

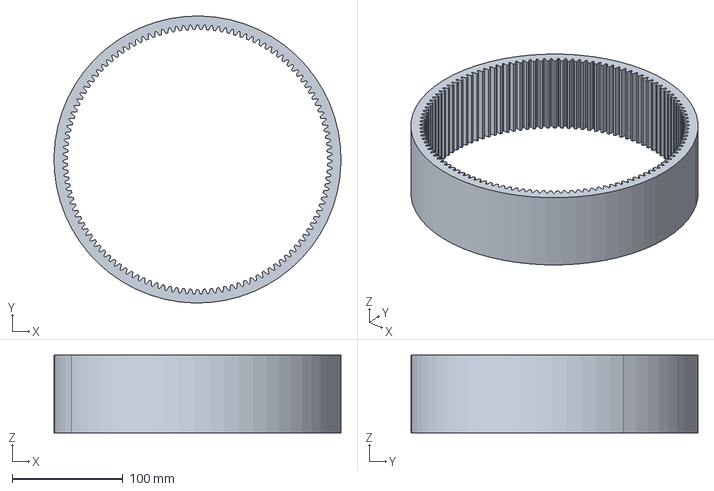
[picture p221: CAD file, 2026-11-03]
cad/step/ring.stp
258.9 x 258.9 x 70.0 mm
