tanboga20/turboprop-from-turboshaft/cad/step/quill_pump.stp

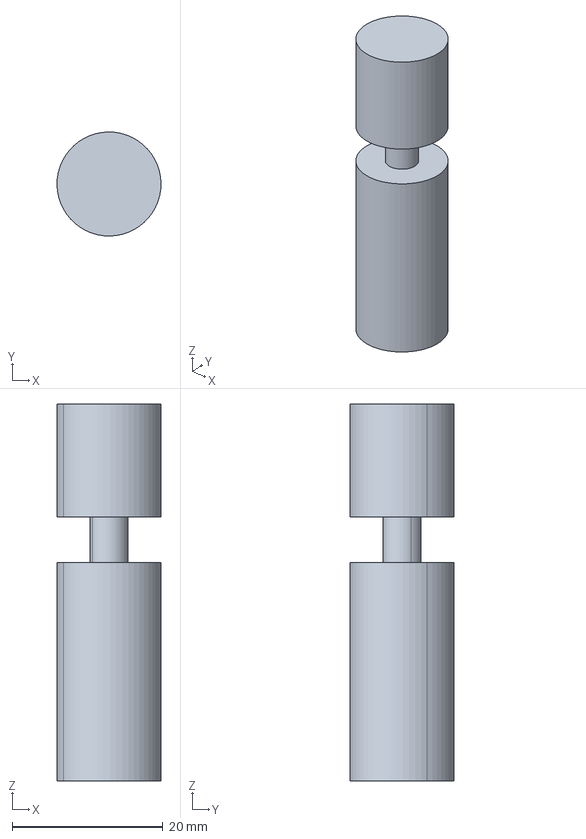
[picture p223: CAD file, 2026-11-03]
cad/step/quill_pump.stp
13.8 x 13.8 x 50.0 mm
