tanboga20/turboprop-from-turboshaft/cad/step/case.stp

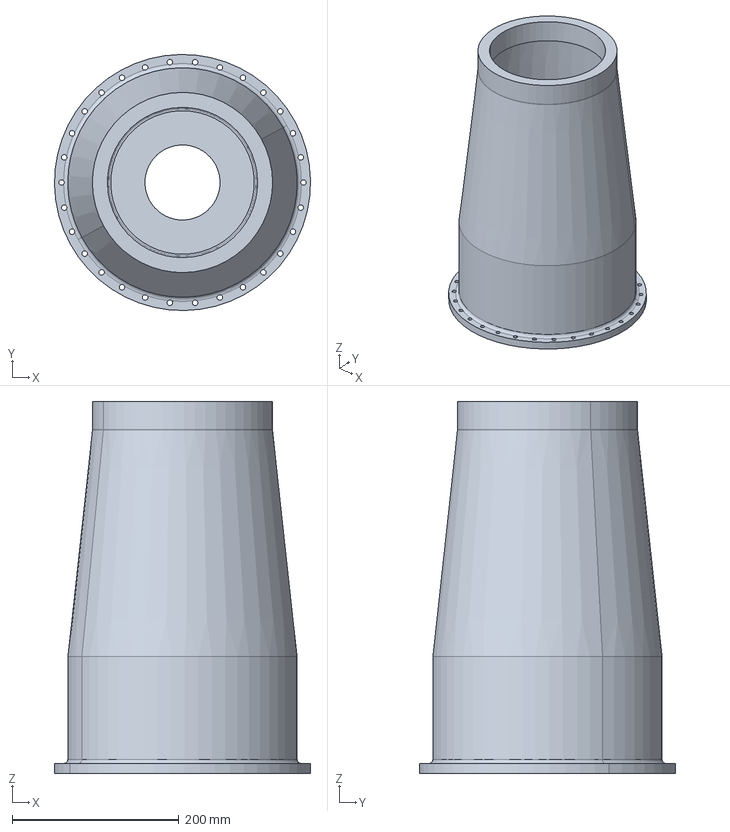
[picture p224: CAD file, 2026-11-03]
cad/step/case.stp
307.0 x 307.0 x 446.0 mm
