tanboga20/turboprop-from-turboshaft/cad/step/osg_gear.stp

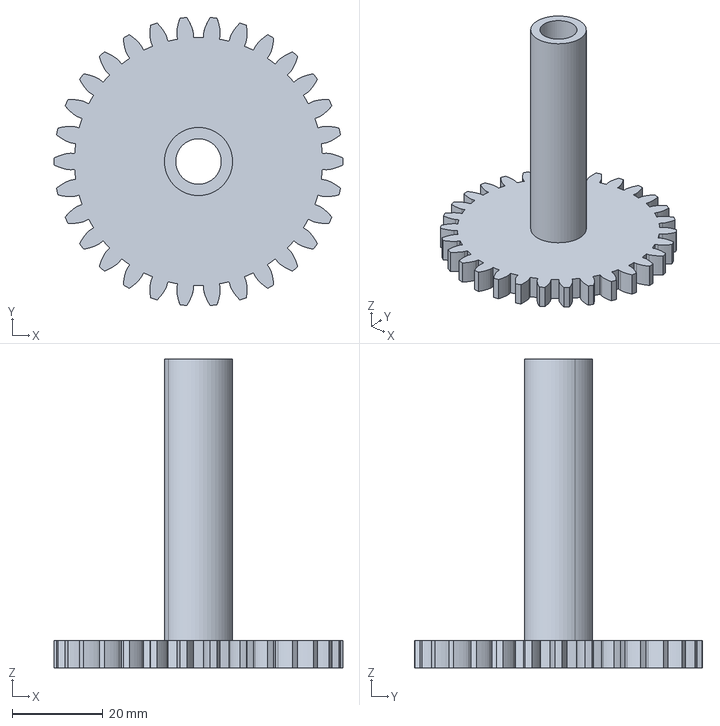
[picture p225: CAD file, 2026-11-03]
cad/step/osg_gear.stp
63.6 x 63.4 x 68.0 mm
