tanboga20/turboprop-from-turboshaft/cad/step/unit_generator.stp

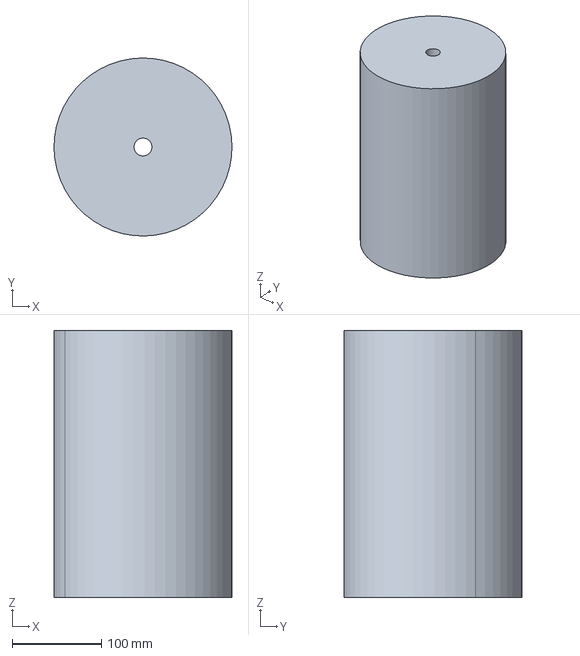
[picture p226: CAD file, 2026-11-03]
cad/step/unit_generator.stp
200.0 x 200.0 x 300.0 mm
