tanboga20/turboprop-from-turboshaft/cad/step/brg_QJ210.stp

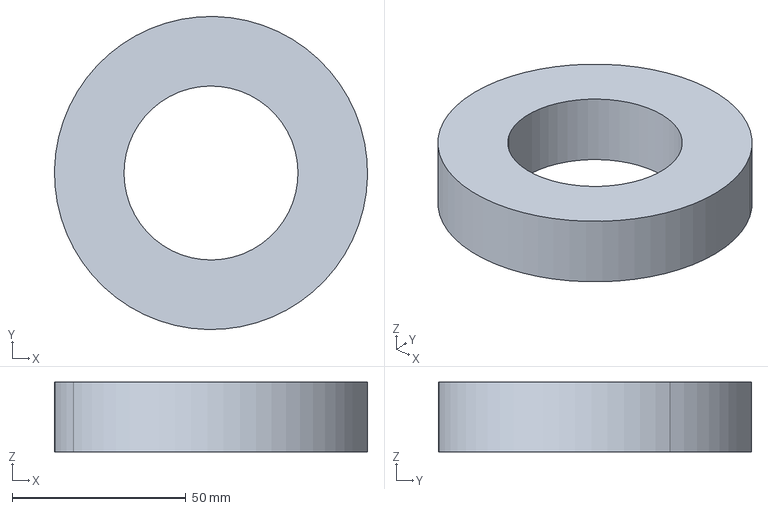
[picture p227: CAD file, 2026-11-03]
cad/step/brg_QJ210.stp
90.0 x 90.0 x 20.0 mm
