tanboga20/turboprop-from-turboshaft/cad/step/mid_shaft.stp

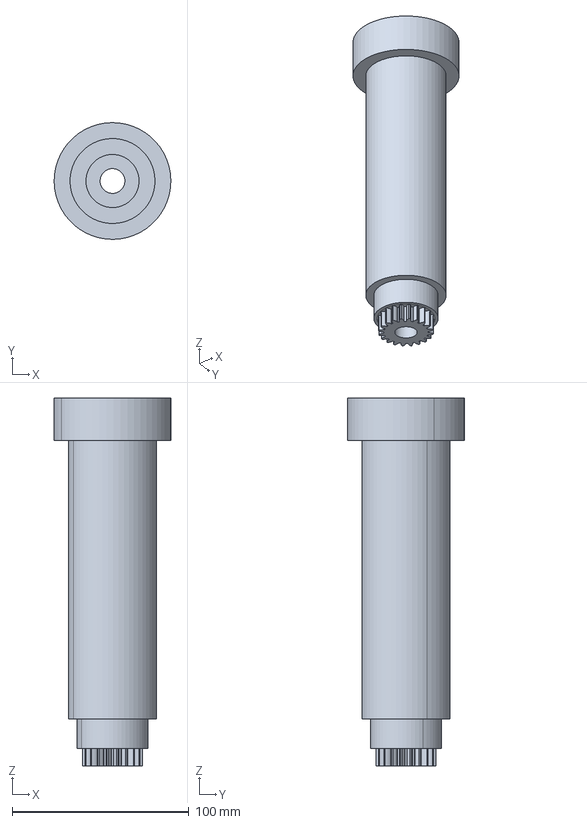
[picture p228: CAD file, 2026-11-03]
cad/step/mid_shaft.stp
66.0 x 66.0 x 208.0 mm
