tanboga20/turboprop-from-turboshaft/cad/step/oil_route_02.stp

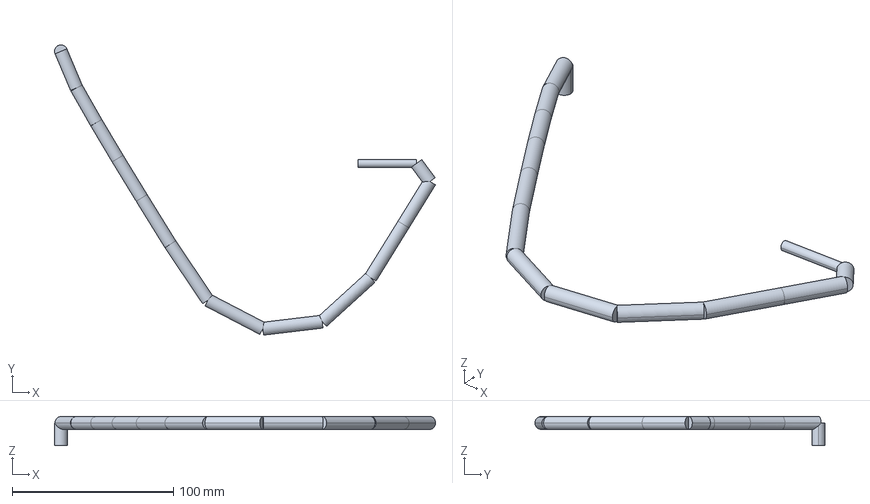
[picture p229: CAD file, 2026-11-03]
cad/step/oil_route_02.stp
236.5 x 180.1 x 18.0 mm
