tanboga20/turboprop-from-turboshaft/cad/step/osg_adapter.stp

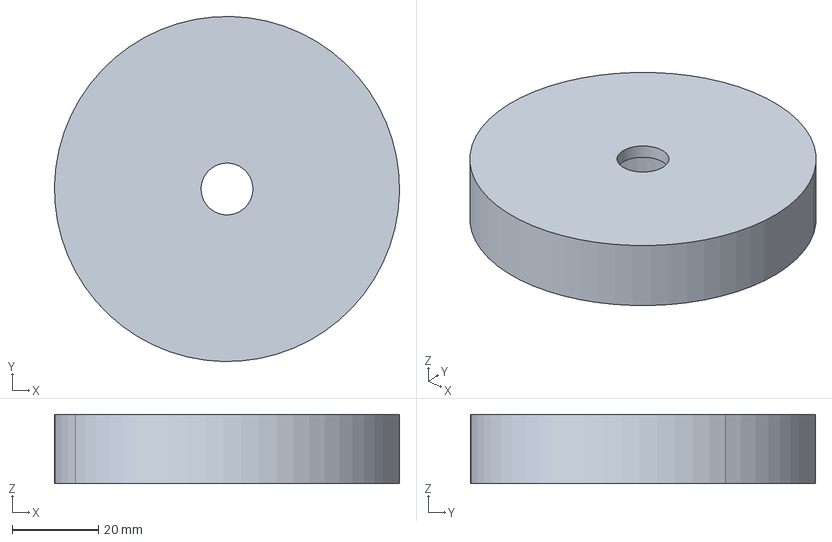
[picture p230: CAD file, 2026-11-03]
cad/step/osg_adapter.stp
80.0 x 80.0 x 16.0 mm
