tanboga20/turboprop-from-turboshaft/cad/step/brg_NU2210.stp

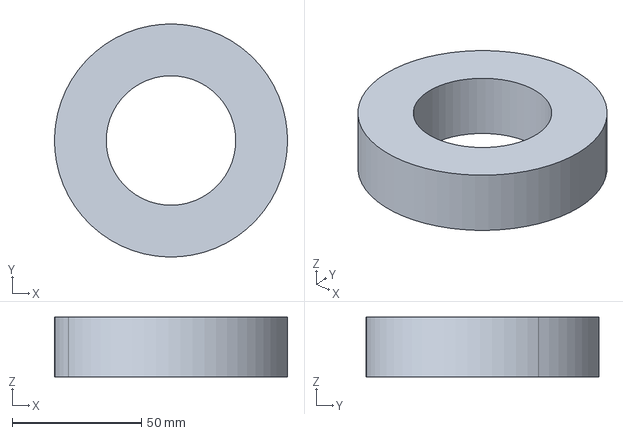
[picture p231: CAD file, 2026-11-03]
cad/step/brg_NU2210.stp
90.0 x 90.0 x 23.0 mm
