tanboga20/turboprop-from-turboshaft/cad/step/oil_transfer_sleeve.stp

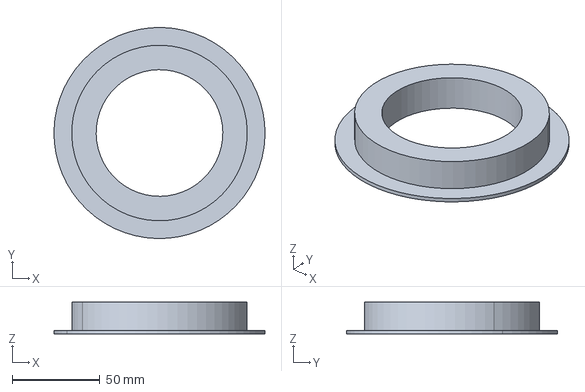
[picture p232: CAD file, 2026-11-03]
cad/step/oil_transfer_sleeve.stp
120.0 x 120.0 x 18.0 mm
