tanboga20/turboprop-from-turboshaft/cad/step/unit_OSG.stp

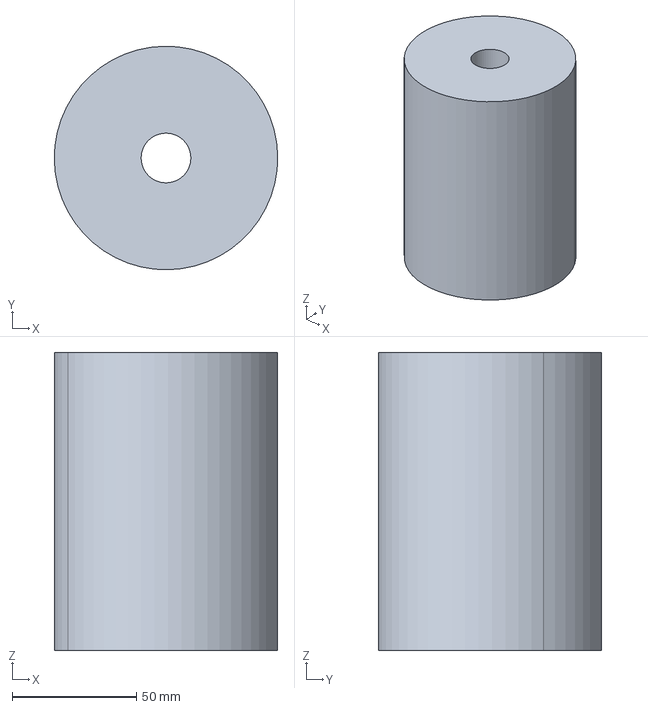
[picture p233: CAD file, 2026-11-03]
cad/step/unit_OSG.stp
90.0 x 90.0 x 120.0 mm
