tanboga20/turboprop-from-turboshaft/cad/step/oil_thermostat.stp

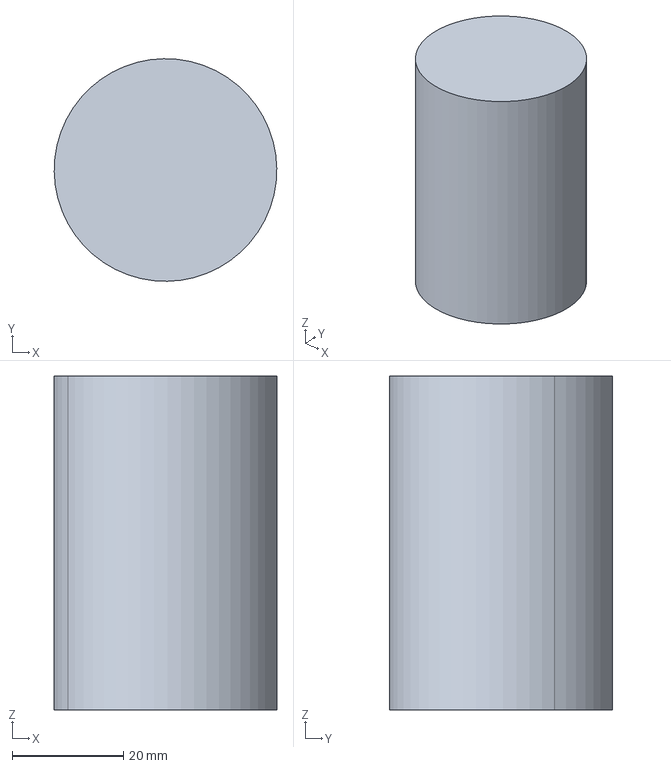
[picture p234: CAD file, 2026-11-03]
cad/step/oil_thermostat.stp
40.0 x 40.0 x 60.0 mm
