tanboga20/turboprop-from-turboshaft/cad/step/seal_gen.stp

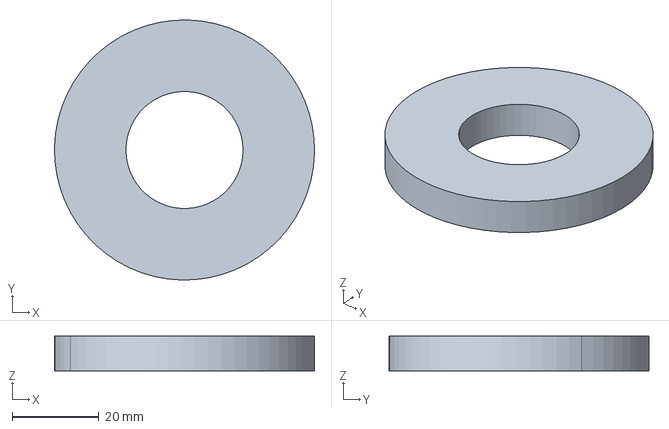
[picture p235: CAD file, 2026-11-03]
cad/step/seal_gen.stp
60.0 x 60.0 x 8.00 mm
