tanboga20/turboprop-from-turboshaft/cad/step/oil_jet_102.stp

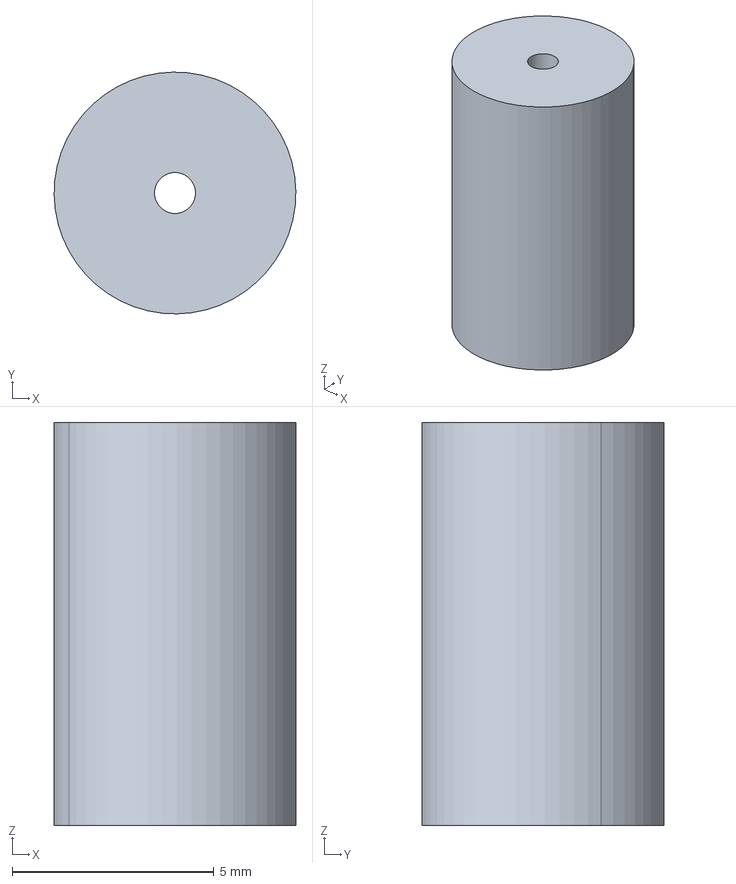
[picture p236: CAD file, 2026-11-03]
cad/step/oil_jet_102.stp
6.00 x 6.00 x 10.0 mm
