tanboga20/turboprop-from-turboshaft/cad/step/oil_route_10.stp

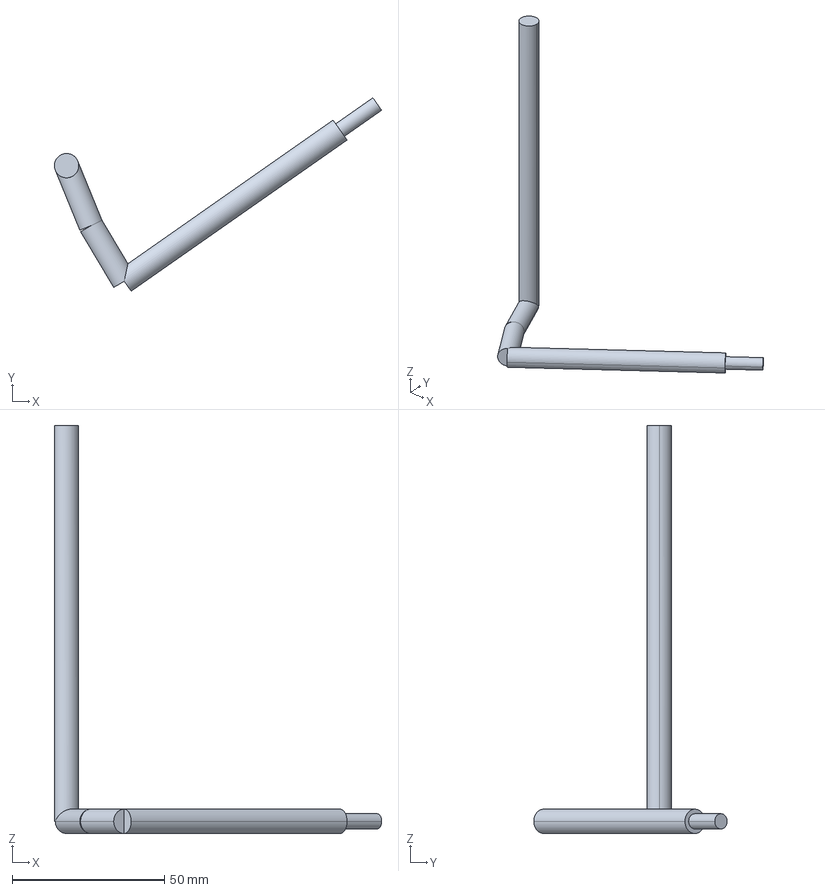
[picture p237: CAD file, 2026-11-03]
cad/step/oil_route_10.stp
107.5 x 63.5 x 134.0 mm
