tanboga20/turboprop-from-turboshaft/cad/step/oil_route_11.stp

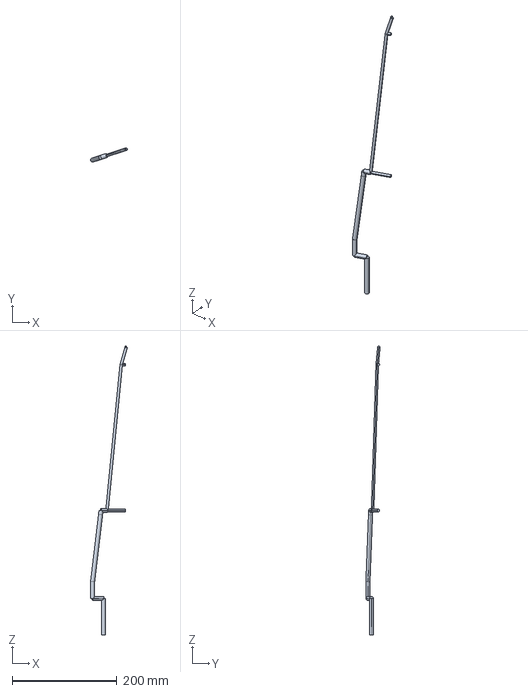
[picture p238: CAD file, 2026-11-03]
cad/step/oil_route_11.stp
70.6 x 27.3 x 552.5 mm
