tanboga20/turboprop-from-turboshaft/cad/step/brg_6202.stp

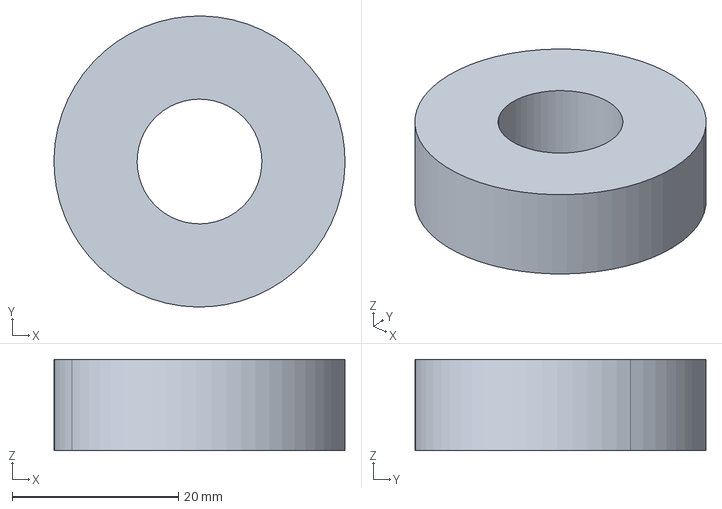
[picture p239: CAD file, 2026-11-03]
cad/step/brg_6202.stp
35.0 x 35.0 x 11.0 mm
