tanboga20/turboprop-from-turboshaft/cad/step/qj_housing.stp

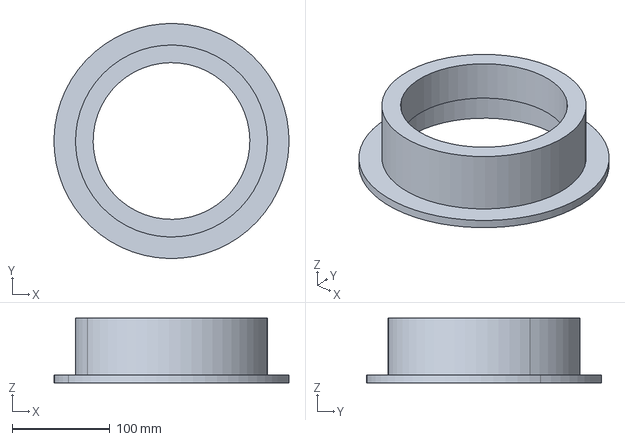
[picture p240: CAD file, 2026-11-03]
cad/step/qj_housing.stp
239.9 x 239.9 x 66.0 mm
