tanboga20/turboprop-from-turboshaft/cad/step/gen_gear.stp

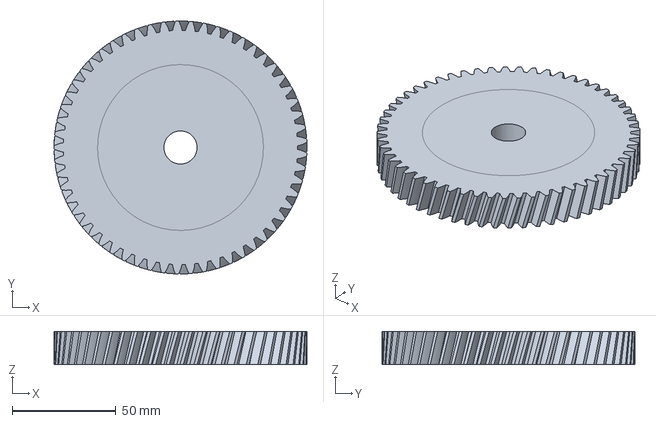
[picture p241: CAD file, 2026-11-03]
cad/step/gen_gear.stp
122.0 x 122.0 x 16.0 mm
