tanboga20/turboprop-from-turboshaft/cad/step/brg_QJ209.stp

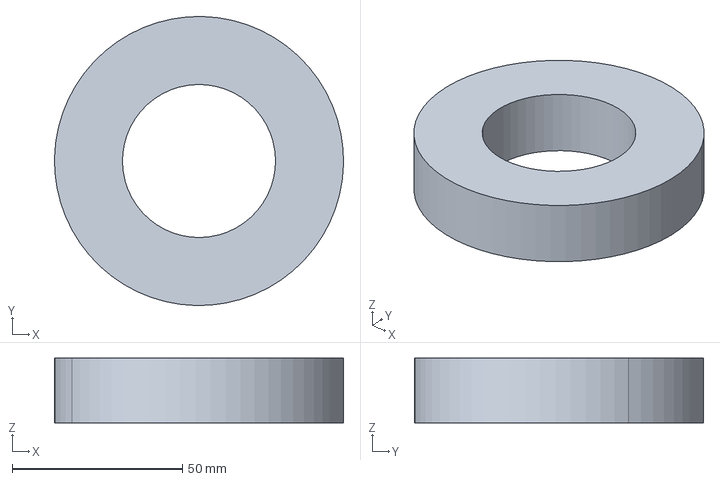
[picture p242: CAD file, 2026-11-03]
cad/step/brg_QJ209.stp
85.0 x 85.0 x 19.0 mm
