tanboga20/turboprop-from-turboshaft/cad/step/unit_PCU.stp

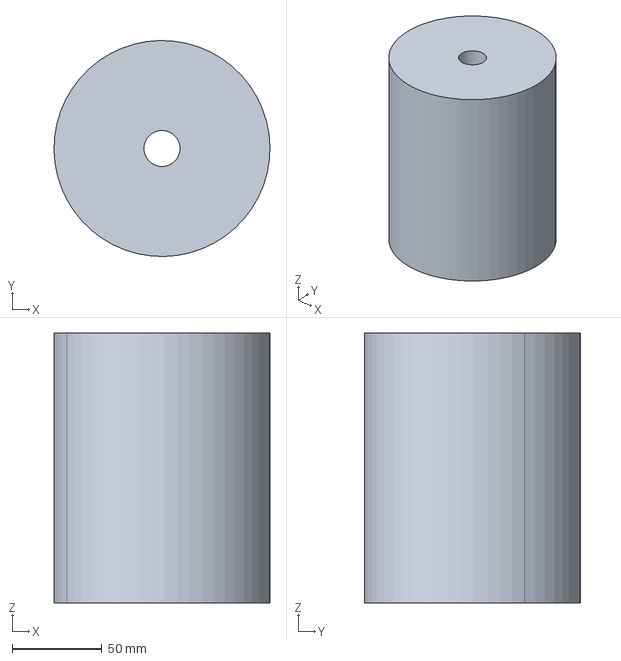
[picture p243: CAD file, 2026-11-03]
cad/step/unit_PCU.stp
120.0 x 120.0 x 150.0 mm
