tanboga20/turboprop-from-turboshaft/cad/step/brg_6203.stp

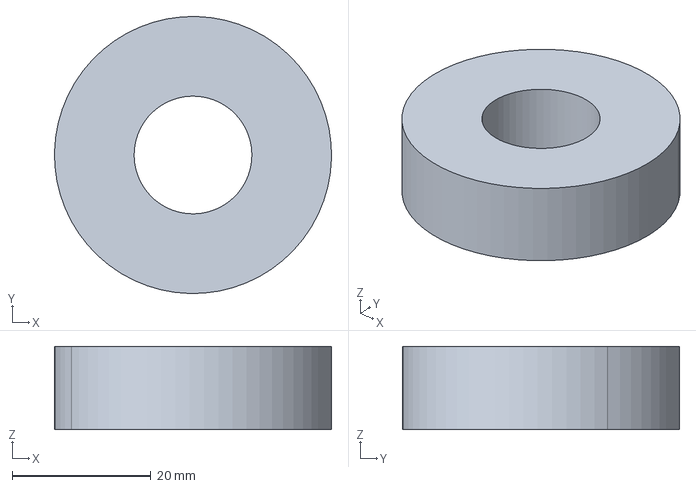
[picture p244: CAD file, 2026-11-03]
cad/step/brg_6203.stp
40.0 x 40.0 x 12.0 mm
