tanboga20/turboprop-from-turboshaft/cad/step/oil_route_12.stp

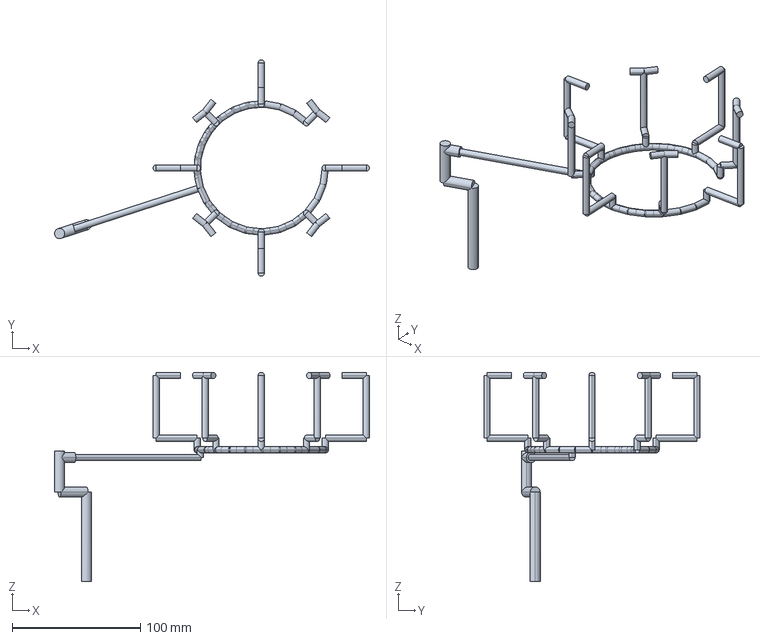
[picture p245: CAD file, 2026-11-03]
cad/step/oil_route_12.stp
245.9 x 169.0 x 163.5 mm
