tanboga20/turboprop-from-turboshaft/cad/step/oil_route_01.stp

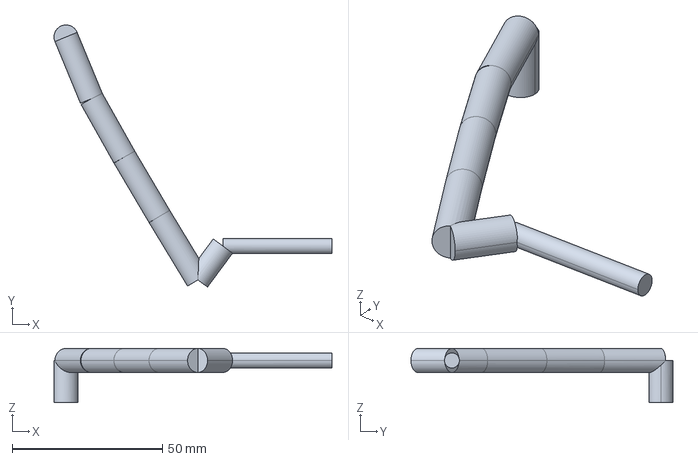
[picture p246: CAD file, 2026-11-03]
cad/step/oil_route_01.stp
92.5 x 87.2 x 18.0 mm
