tanboga20/turboprop-from-turboshaft/cad/step/brg_6305.stp

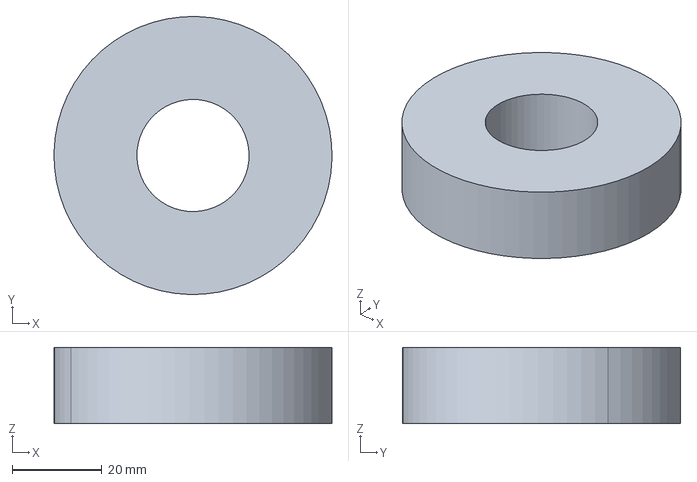
[picture p247: CAD file, 2026-11-03]
cad/step/brg_6305.stp
62.0 x 62.0 x 17.0 mm
