tanboga20/turboprop-from-turboshaft/cad/step/brg_NU2209.stp

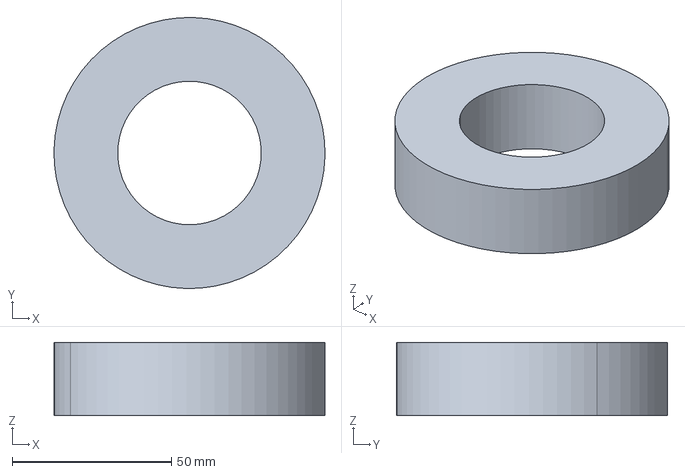
[picture p248: CAD file, 2026-11-03]
cad/step/brg_NU2209.stp
85.0 x 85.0 x 23.0 mm
