tanboga20/turboprop-from-turboshaft/cad/step/quill_pcu.stp

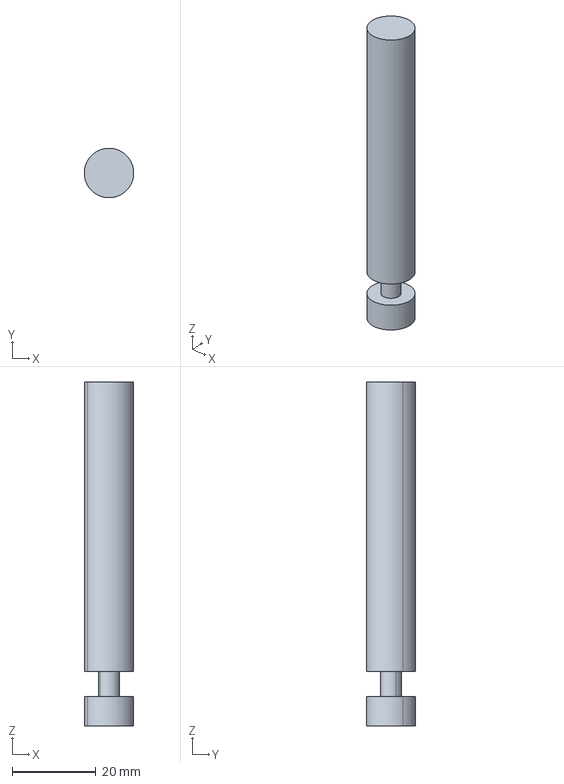
[picture p249: CAD file, 2026-11-03]
cad/step/quill_pcu.stp
11.8 x 11.8 x 82.0 mm
