tanboga20/turboprop-from-turboshaft/cad/step/carrier.stp

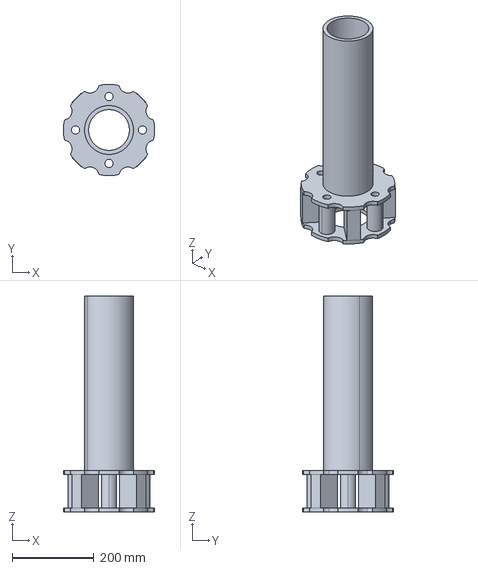
[picture p250: CAD file, 2026-11-03]
cad/step/carrier.stp
224.0 x 224.0 x 530.0 mm
