tanboga20/turboprop-from-turboshaft/cad/step/gen_shaft.stp

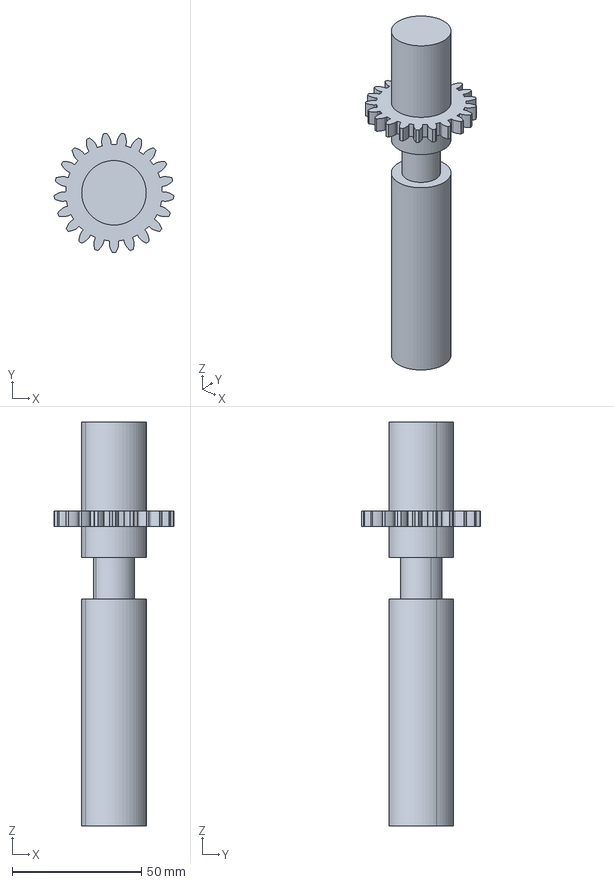
[picture p251: CAD file, 2026-11-03]
cad/step/gen_shaft.stp
46.4 x 46.2 x 156.5 mm
