tanboga20/turboprop-from-turboshaft/cad/step/quill_gen.stp

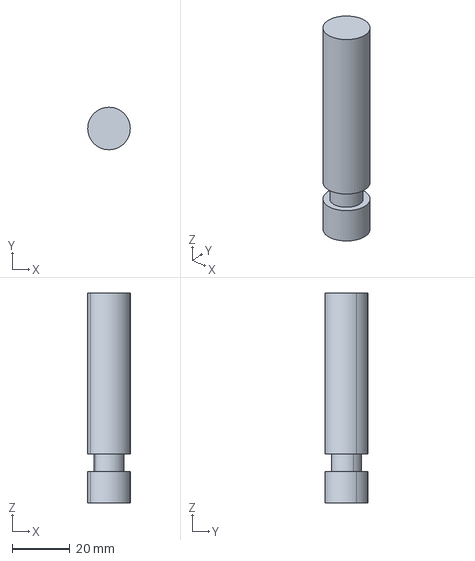
[picture p252: CAD file, 2026-11-03]
cad/step/quill_gen.stp
14.8 x 14.8 x 73.0 mm
