tanboga20/turboprop-from-turboshaft/cad/step/oil_tank.stp

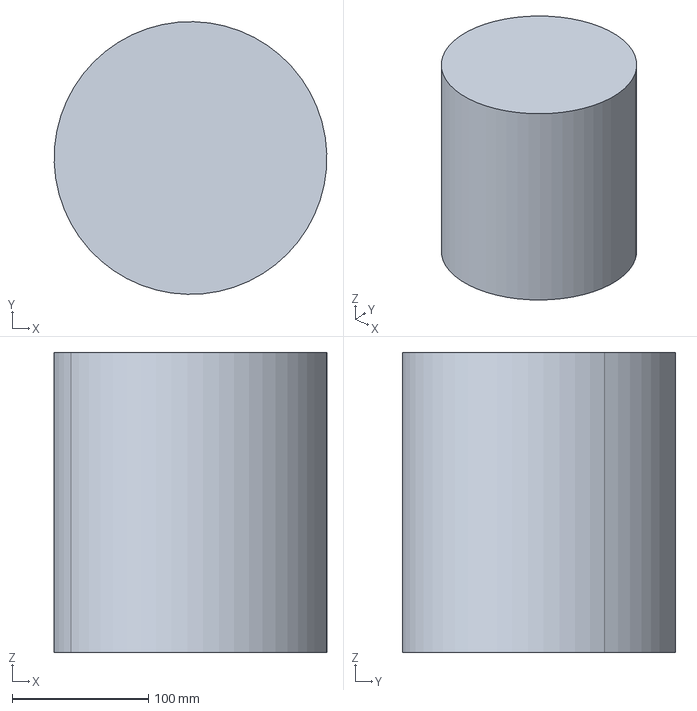
[picture p253: CAD file, 2026-11-03]
cad/step/oil_tank.stp
199.9 x 199.9 x 220.0 mm
