tanboga20/turboprop-from-turboshaft/cad/step/planet.stp

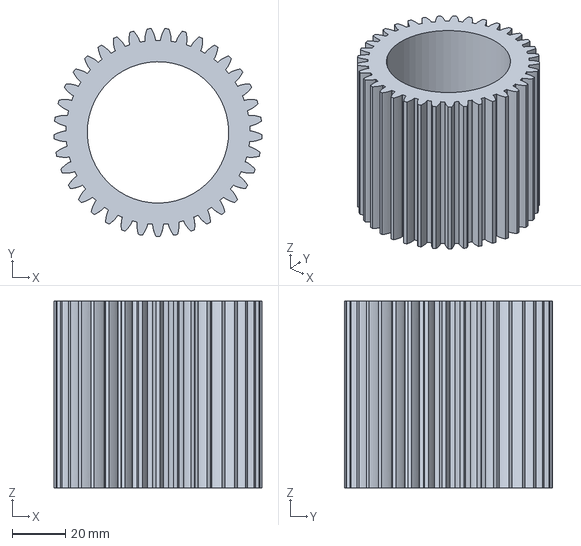
[picture p254: CAD file, 2026-11-03]
cad/step/planet.stp
78.0 x 77.9 x 70.0 mm
