tanboga20/turboprop-from-turboshaft/cad/step/ret_tube.stp

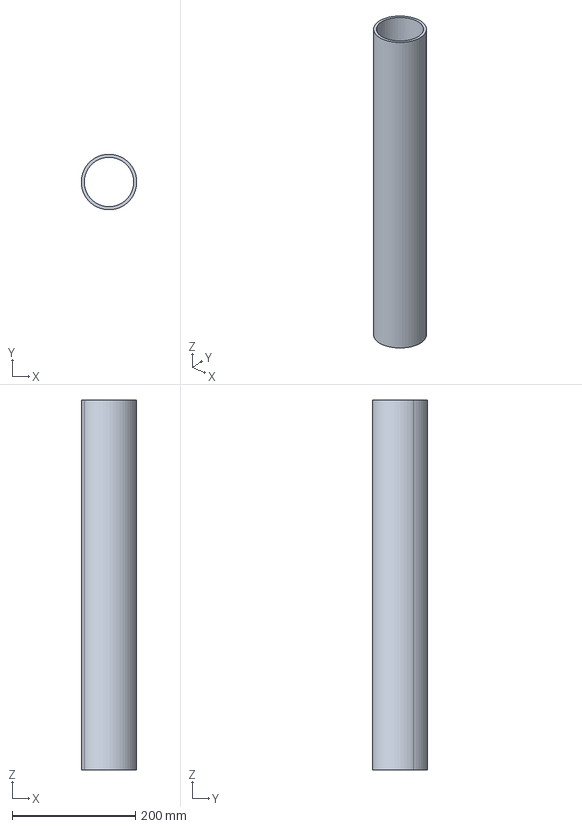
[picture p255: CAD file, 2026-11-03]
cad/step/ret_tube.stp
90.0 x 90.0 x 600.0 mm
