tanboga20/turboprop-from-turboshaft/cad/step/sun.stp

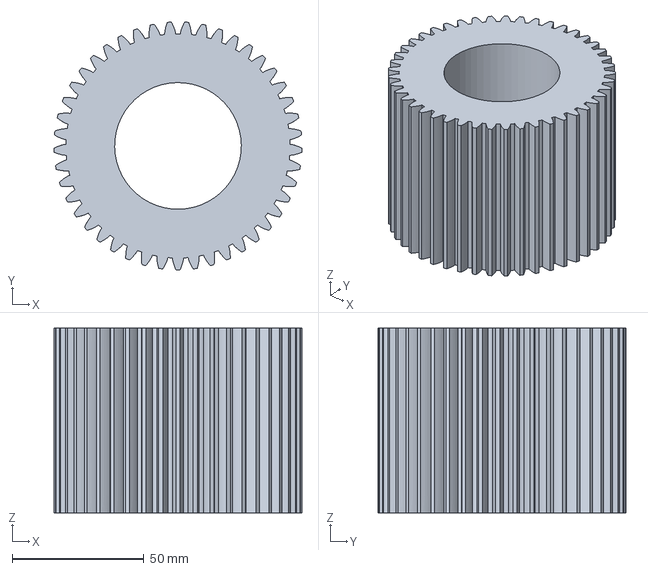
[picture p256: CAD file, 2026-11-03]
cad/step/sun.stp
94.0 x 93.9 x 70.0 mm
