tanboga20/turboprop-from-turboshaft/cad/step/oil_route_06.stp

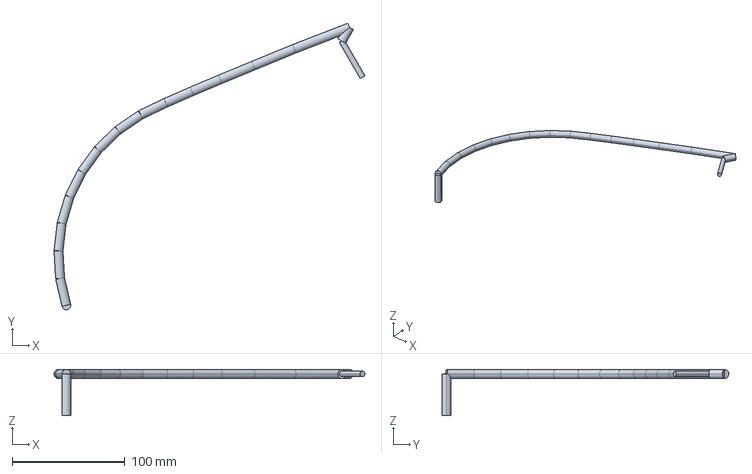
[picture p257: CAD file, 2026-11-03]
cad/step/oil_route_06.stp
276.4 x 254.7 x 41.0 mm
