tanboga20/turboprop-from-turboshaft/cad/step/oil_chip_detector.stp

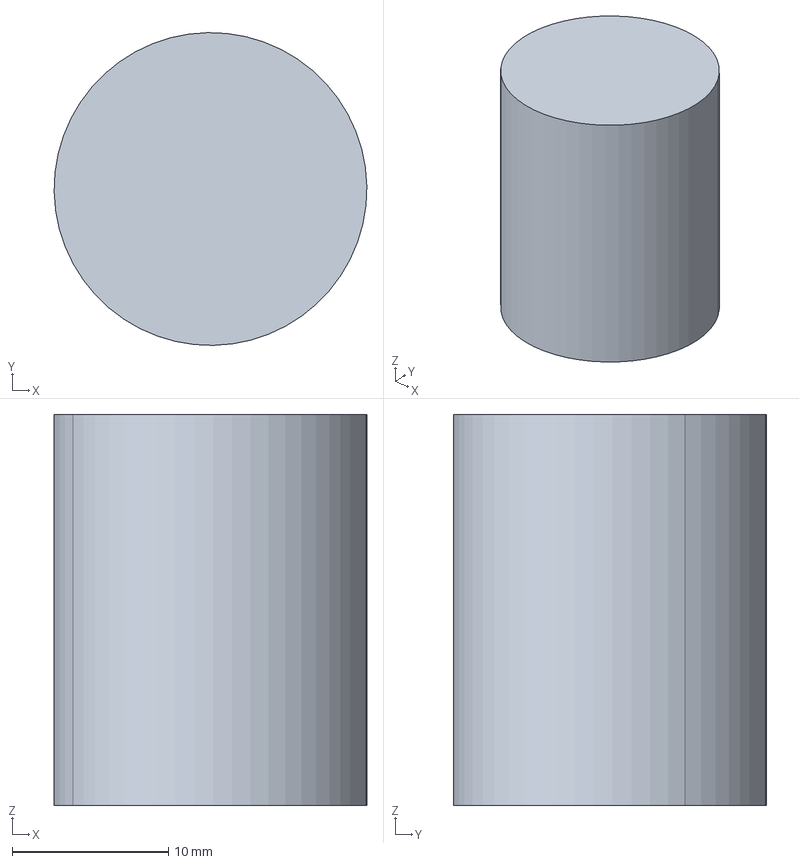
[picture p258: CAD file, 2026-11-03]
cad/step/oil_chip_detector.stp
20.0 x 20.0 x 25.0 mm
