tanboga20/turboprop-from-turboshaft/cad/step/oil_route_09.stp

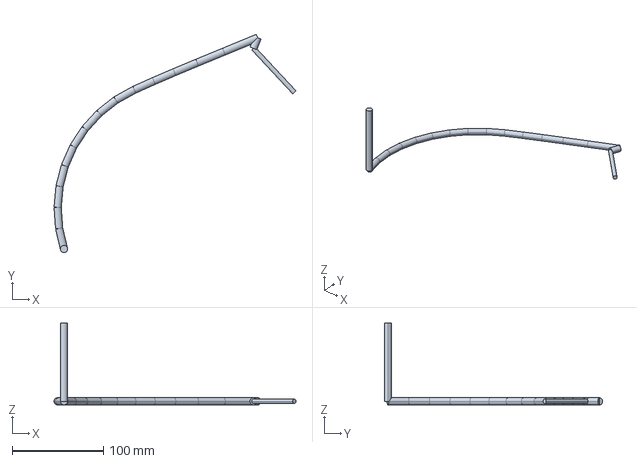
[picture p259: CAD file, 2026-11-03]
cad/step/oil_route_09.stp
265.9 x 239.9 x 90.0 mm
