tanboga20/turboprop-from-turboshaft/cad/step/oil_odm.stp

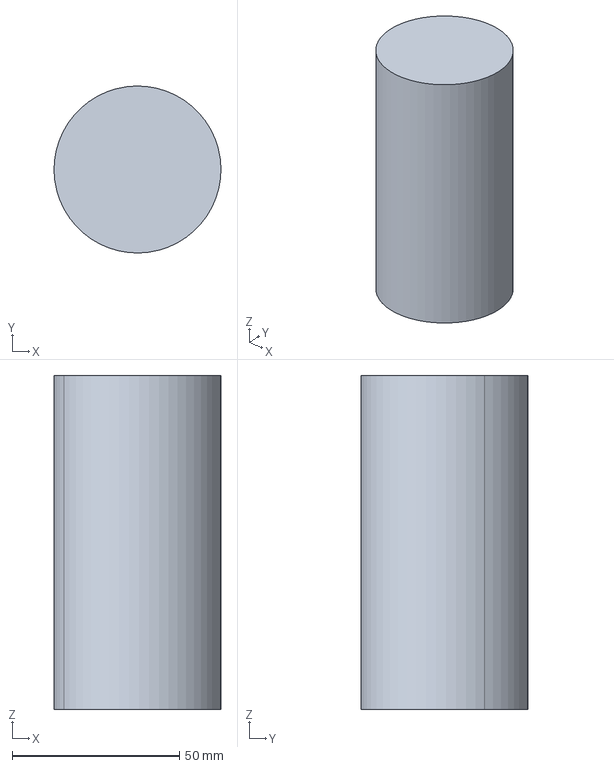
[picture p260: CAD file, 2026-11-03]
cad/step/oil_odm.stp
50.0 x 50.0 x 100.0 mm
