tanboga20/turboprop-from-turboshaft/cad/step/oil_route_04.stp

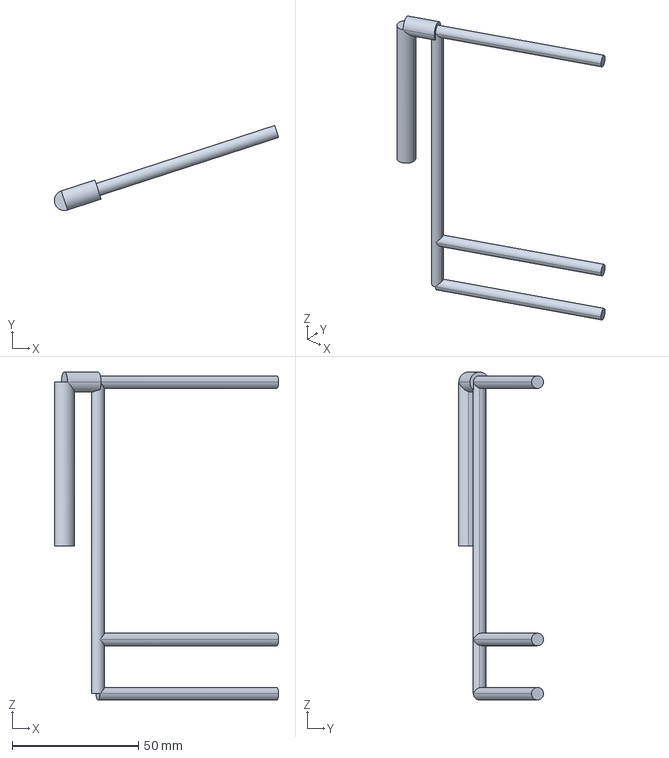
[picture p261: CAD file, 2026-11-03]
cad/step/oil_route_04.stp
88.9 x 33.7 x 130.0 mm
