tanboga20/turboprop-from-turboshaft/cad/step/seal_prop.stp

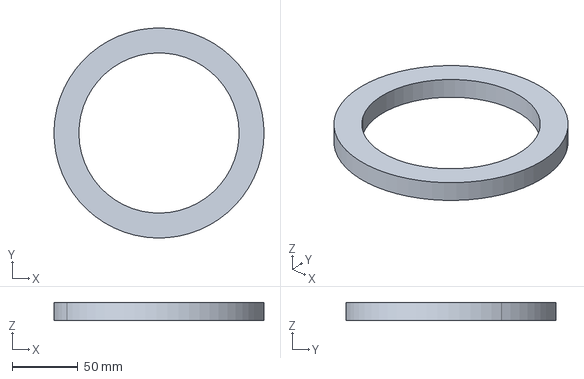
[picture p262: CAD file, 2026-11-03]
cad/step/seal_prop.stp
160.0 x 160.0 x 14.0 mm
