tanboga20/turboprop-from-turboshaft/cad/step/sun_quill.stp

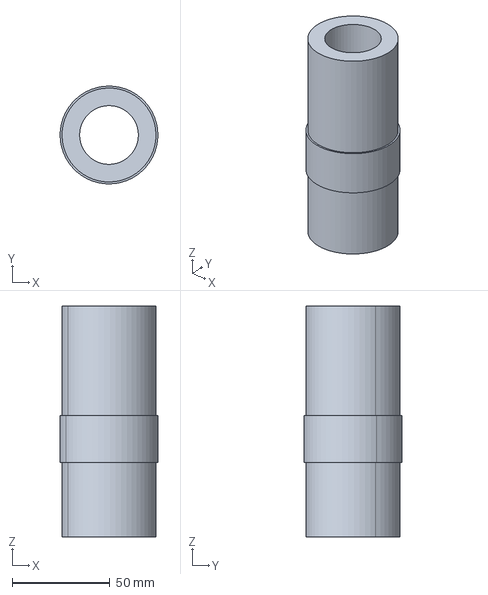
[picture p263: CAD file, 2026-11-03]
cad/step/sun_quill.stp
50.0 x 50.0 x 118.0 mm
