tanboga20/turboprop-from-turboshaft/cad/step/oil_sample_valve.stp

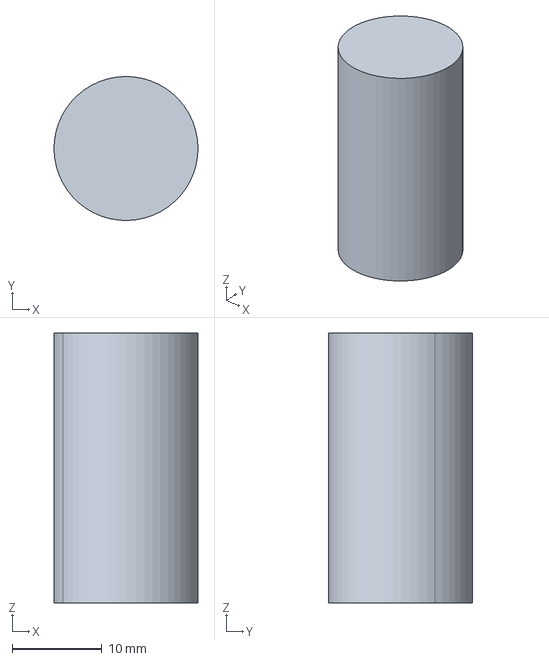
[picture p264: CAD file, 2026-11-03]
cad/step/oil_sample_valve.stp
16.0 x 16.0 x 30.0 mm
