tanboga20/turboprop-from-turboshaft/cad/step/lub07_lines.stp

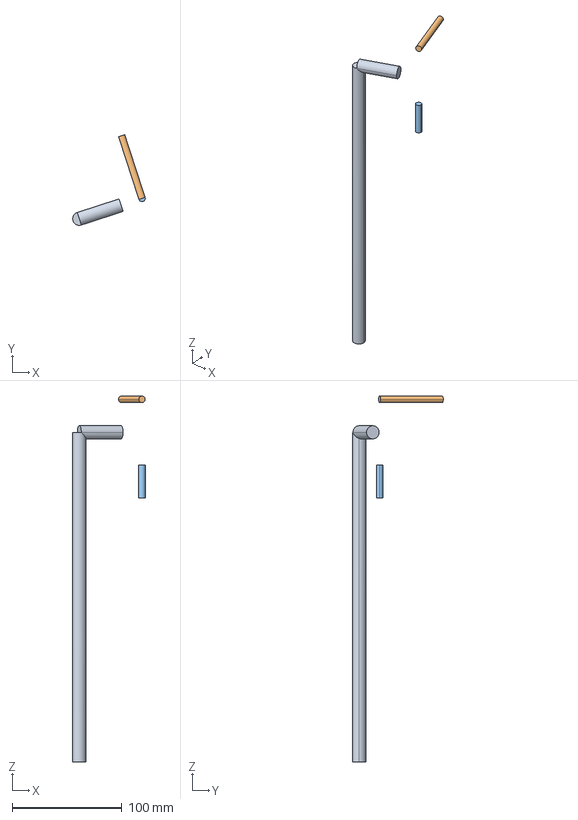
[picture p265: CAD file, 2026-11-03]
cad/step/lub07_lines.stp
66.1 x 82.5 x 333.0 mm
