tanboga20/turboprop-from-turboshaft/cad/step/fs_case.stp

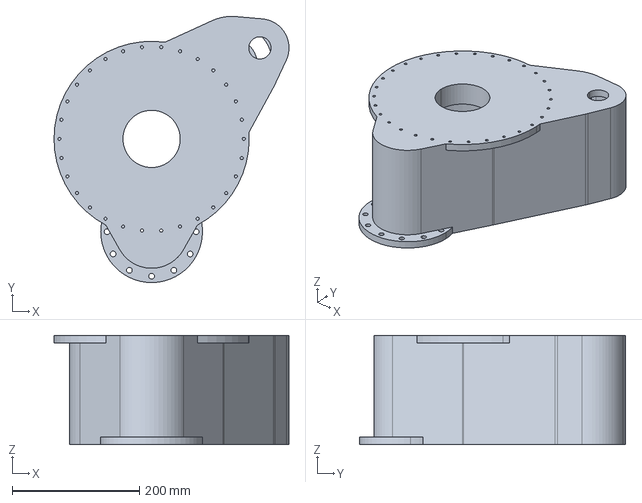
[picture p266: CAD file, 2026-11-03]
cad/step/fs_case.stp
369.6 x 418.6 x 172.0 mm
