tanboga20/turboprop-from-turboshaft/(list of files, cad)

Other CAD files:
cad/step/oil_jet_060.stp
cad/step/lub07_valve.stp
cad/step/lub07_accumulator.stp
cad/step/brg_NU1024.stp
cad/assy/mod_accessories.CATProduct
cad/assy/mod_equipment.CATProduct
cad/assy/mod_first_stage.CATProduct
cad/assy/mod_lub07_mist.CATProduct
cad/assy/mod_lubrication.CATProduct
cad/assy/mod_planetary.CATProduct
cad/assy/rgb_assembly.CATProduct
cad/parts/acc_cover.CATPart
cad/parts/brg_6202.CATPart
cad/parts/brg_6203.CATPart
cad/parts/brg_6305.CATPart
cad/parts/brg_NU1024.CATPart
cad/parts/brg_NU2209.CATPart
cad/parts/brg_NU2210.CATPart
cad/parts/brg_QJ1024.CATPart
cad/parts/brg_QJ209.CATPart
cad/parts/brg_QJ210.CATPart
cad/parts/carrier.CATPart
cad/parts/case.CATPart
cad/parts/fs_case.CATPart
cad/parts/gear2.CATPart
cad/parts/gen_cartridge.CATPart
cad/parts/gen_gear.CATPart
cad/parts/gen_shaft.CATPart
cad/parts/lub07_accumulator.CATPart
cad/parts/lub07_lines.CATPart
cad/parts/lub07_valve.CATPart
cad/parts/mid_shaft.CATPart
cad/parts/nut_KM10.CATPart
cad/parts/nut_KM24.CATPart
cad/parts/nut_KM9.CATPart
cad/parts/oil_chip_detector.CATPart
cad/parts/oil_filter.CATPart
cad/parts/oil_jet_060.CATPart
cad/parts/oil_jet_066.CATPart
cad/parts/oil_jet_084.CATPart
cad/parts/oil_jet_102.CATPart
cad/parts/oil_jet_155.CATPart
cad/parts/oil_odm.CATPart
cad/parts/oil_pitch_tube.CATPart
cad/parts/oil_prv.CATPart
cad/parts/oil_route_01.CATPart
cad/parts/oil_route_02.CATPart
cad/parts/oil_route_03.CATPart
cad/parts/oil_route_04.CATPart
cad/parts/oil_route_05.CATPart
cad/parts/oil_route_06.CATPart
cad/parts/oil_route_07.CATPart
cad/parts/oil_route_08.CATPart
cad/parts/oil_route_09.CATPart
cad/parts/oil_route_10.CATPart
cad/parts/oil_route_11.CATPart
cad/parts/oil_route_12.CATPart
cad/parts/oil_sample_valve.CATPart
cad/parts/oil_tank.CATPart
cad/parts/oil_thermostat.CATPart
cad/parts/oil_transfer_sleeve.CATPart
cad/parts/osg_adapter.CATPart
cad/parts/osg_gear.CATPart
cad/parts/pcu_adapter.CATPart
cad/parts/pcu_gear.CATPart
cad/parts/pinion.CATPart
cad/parts/planet.CATPart
cad/parts/planet_rollers.CATPart
cad/parts/prop_flange.CATPart
cad/parts/pump_pack.CATPart
cad/parts/qj_housing.CATPart
cad/parts/quill_gen.CATPart
cad/parts/quill_osg.CATPart
cad/parts/quill_pcu.CATPart
cad/parts/quill_pump.CATPart
cad/parts/ret_tube.CATPart
cad/parts/ring.CATPart
cad/parts/seal_gen.CATPart
cad/parts/seal_input.CATPart
cad/parts/seal_prop.CATPart
cad/parts/sun.CATPart
cad/parts/sun_quill.CATPart
cad/parts/unit_OSG.CATPart
cad/parts/unit_PCU.CATPart
cad/parts/unit_generator.CATPart
cad/step/nut_KM10.stp
cad/step/nut_KM24.stp
cad/step/nut_KM9.stp
