tanboga20/turboprop-from-turboshaft/cad/params/assembly.txt

# assembly: written by calc/cad_export/cx_export.m (calc/assembly/as_export.m), do not edit
# i<k> = part module rotation[deg] x y z [mm]
n = 57
i1 = case planetary 0 0 0 0
i2 = ring planetary 0.756 0 0 36
i3 = carrier planetary 0 0 0 20
i4 = sun planetary 2 0 0 36
i5 = sun_quill planetary 0 0 0 0
i6 = planet planetary 2.432 82 0 36
i7 = planet_rollers planetary 0 82 0 36
i8 = planet planetary 7.29686 0 82 36
i9 = planet_rollers planetary 0 0 82 36
i10 = planet planetary 2.432 -82 0 36
i11 = planet_rollers planetary 0 -82 0 36
i12 = planet planetary 7.29686 0 -82 36
i13 = planet_rollers planetary 0 0 -82 36
i14 = brg_NU1024 planetary 0 0 0 134
i15 = brg_NU1024 planetary 0 0 0 413
i16 = brg_QJ1024 planetary 0 0 0 446
i17 = qj_housing planetary 0 0 0 0
i18 = nut_KM24 planetary 0 0 0 474
i19 = seal_prop planetary 0 0 0 496
i20 = ret_tube planetary 0 0 0 0
i21 = prop_flange planetary 0 0 0 0
i22 = fs_case first_stage 0 0 0 0
i23 = gear2 first_stage 0 0 0 -102
i24 = pinion first_stage 5.80645 0 -145.974 -102
i25 = mid_shaft first_stage 0 0 0 0
i26 = brg_NU2210 first_stage 0 0 0 -36.5
i27 = brg_NU2209 first_stage 0 0 -145.974 -36.5
i28 = brg_NU2210 first_stage 0 0 0 -138.5
i29 = brg_NU2209 first_stage 0 0 -145.974 -138.5
i30 = brg_QJ210 first_stage 0 0 0 -158.5
i31 = brg_QJ209 first_stage 0 0 -145.974 -157.5
i32 = nut_KM10 first_stage 0 0 0 -169.5
i33 = nut_KM9 first_stage 0 0 -145.974 -167.5
i34 = seal_input first_stage 0 0 -145.974 -182
i35 = acc_cover accessories 0 0 0 0
i36 = gen_gear accessories -0.387258 126.15 117.636 -84
i37 = gen_shaft accessories -0.387258 126.15 117.636 0
i38 = gen_cartridge accessories 0 126.15 117.636 0
i39 = brg_6305 accessories 0 126.15 117.636 -33.5
i40 = brg_6305 accessories 0 126.15 117.636 -135.5
i41 = seal_gen accessories 0 126.15 117.636 -158.5
i42 = quill_gen accessories 0 126.15 117.636 0
i43 = osg_gear accessories 0.271081 170.317 143.136 0
i44 = osg_adapter accessories 0 170.317 143.136 0
i45 = brg_6202 accessories 0 170.317 143.136 -11.5
i46 = brg_6202 accessories 0 170.317 143.136 2
i47 = quill_osg accessories 0 170.317 143.136 0
i48 = pcu_gear accessories 3.86301 -39.0037 57.8254 0
i49 = pcu_adapter accessories 0 -39.0037 57.8254 0
i50 = brg_6203 accessories 0 -39.0037 57.8254 -172
i51 = brg_6203 accessories 0 -39.0037 57.8254 -248
i52 = quill_pcu accessories 0 -39.0037 57.8254 0
i53 = pump_pack accessories 0 0 0 0
i54 = quill_pump accessories 0 0 0 0
i55 = unit_generator equipment 0 126.15 117.636 0
i56 = unit_OSG equipment 0 170.317 143.136 0
i57 = unit_PCU equipment 0 -39.0037 57.8254 0
