tanboga20/turboprop-from-turboshaft/cad/params/oil_assembly.txt

# oil_assembly: written by calc/oil_system/os_export.m, do not edit
# i<k> = part module rotation x y z, then the part axes X, Y, Z in the RGB frame
n = 49
i1 = oil_jet_102 lubrication 0 -48 -113.88 -76 0 -1 0 0 0 -1 1 0 0
i2 = oil_jet_155 lubrication 0 48 -113.88 -76 0 1 -0 -0 0 -1 -1 0 0
i3 = oil_jet_084 lubrication 0 -37.1231 -183.097 -25 0.707107 -0.707107 0 0 0 -1 0.707107 0.707107 0
i4 = oil_jet_084 lubrication 0 -37.1231 -183.097 -127 0.707107 -0.707107 0 0 0 -1 0.707107 0.707107 0
i5 = oil_jet_084 lubrication 0 -37.1231 -183.097 -148 0.707107 -0.707107 0 0 0 -1 0.707107 0.707107 0
i6 = oil_jet_060 lubrication 0 -52.3081 -16.9959 -25 0.309017 -0.951057 0 0 0 -1 0.951057 0.309017 0
i7 = oil_jet_060 lubrication 0 -52.3081 -16.9959 -127 0.309017 -0.951057 0 0 0 -1 0.951057 0.309017 0
i8 = oil_jet_060 lubrication 0 -52.3081 -16.9959 -148.5 0.309017 -0.951057 0 0 0 -1 0.951057 0.309017 0
i9 = oil_jet_060 lubrication 0 48.9926 114.053 -76 -0.731354 -0.681998 0 0 -0 -1 0.681998 -0.731354 0
i10 = oil_jet_060 lubrication 0 126.836 158.447 -53 -0.866025 -0.5 0 0 -0 -1 0.5 -0.866025 0
i11 = oil_jet_060 lubrication 0 -37.4042 -7.13619 -191 0.559193 -0.829038 0 0 0 -1 0.829038 0.559193 0
i12 = oil_jet_060 lubrication 0 146.65 153.143 -25 -0.866025 0.5 0 -0 0 -1 -0.5 -0.866025 0
i13 = oil_jet_060 lubrication 0 146.65 153.143 -127 -0.866025 0.5 0 -0 0 -1 -0.5 -0.866025 0
i14 = oil_jet_060 lubrication 0 -95.1057 -30.9017 148 0.309017 -0.951057 0 0 0 -1 0.951057 0.309017 0
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
i46 = oil_tank equipment 0 190 -90 -400 1 0 0 0 1 0 0 0 1
i47 = lub07_valve lub07_mist 0 -165.469 -116.852 -150 1 0 0 0 1 0 0 0 1
i48 = lub07_accumulator lub07_mist 0 -165.469 -116.852 -300 1 0 0 0 1 0 0 0 1
i49 = lub07_lines lub07_mist 0 0 0 0 1 0 0 0 1 0 0 0 1
