tanboga20/turboprop-from-turboshaft/cad/img/assembly_back.png

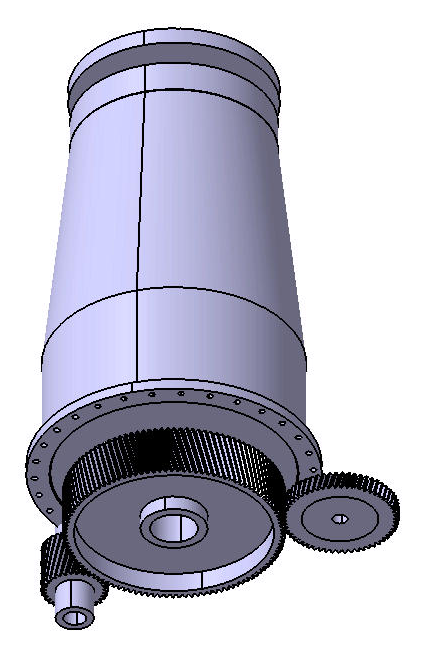
cad/img/assembly_back.png
