tanboga20/turboprop-from-turboshaft/cad/img/assembly_iso.png

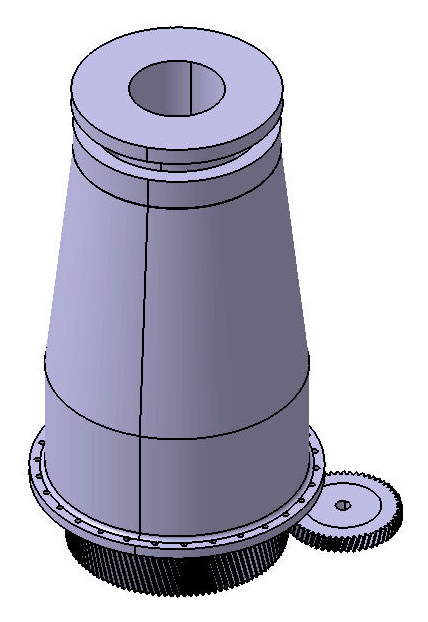
cad/img/assembly_iso.png
