tanboga20/turboprop-from-turboshaft/docs/figures/step37/fire_en.png

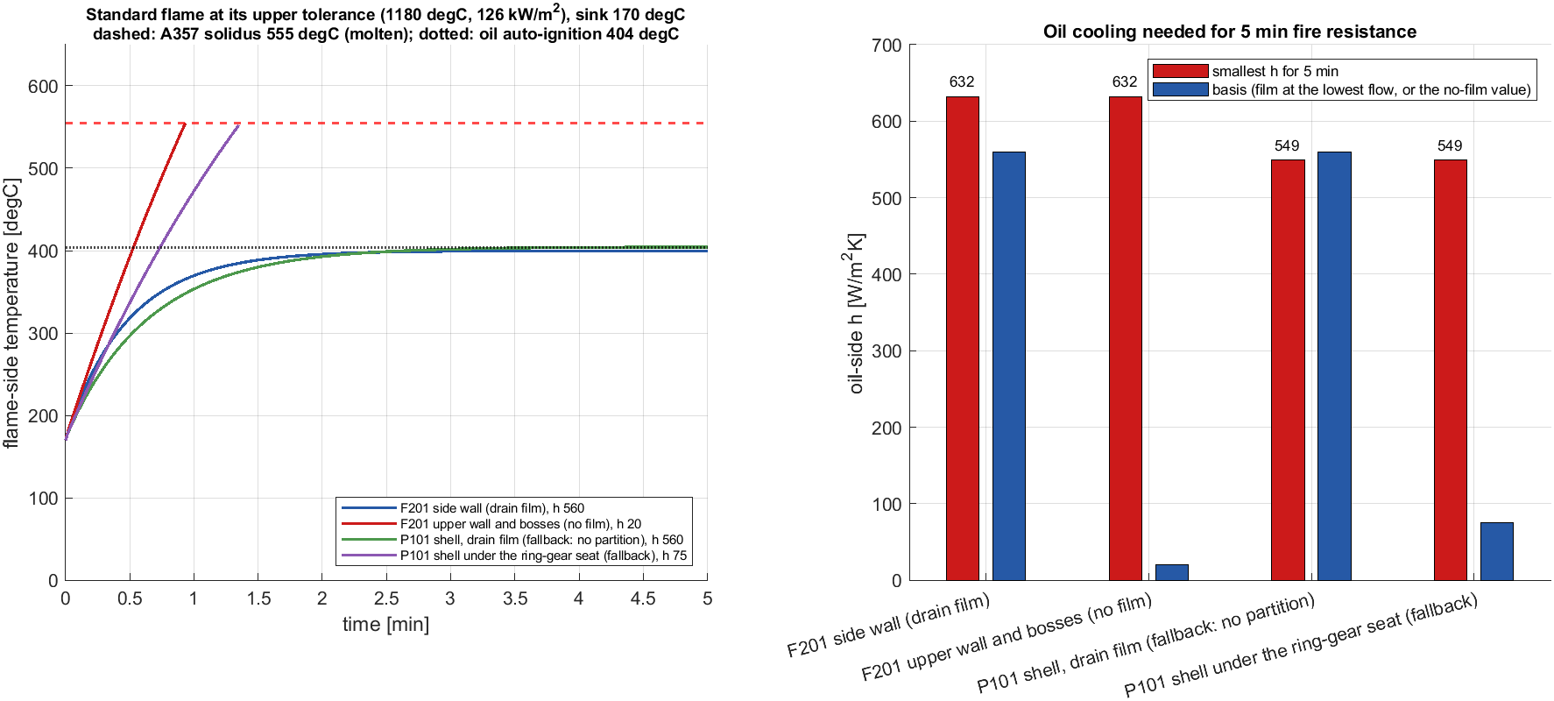
docs/figures/step37/fire_en.png
