tanboga20/turboprop-from-turboshaft/docs/figures/step37/fta2_en.png

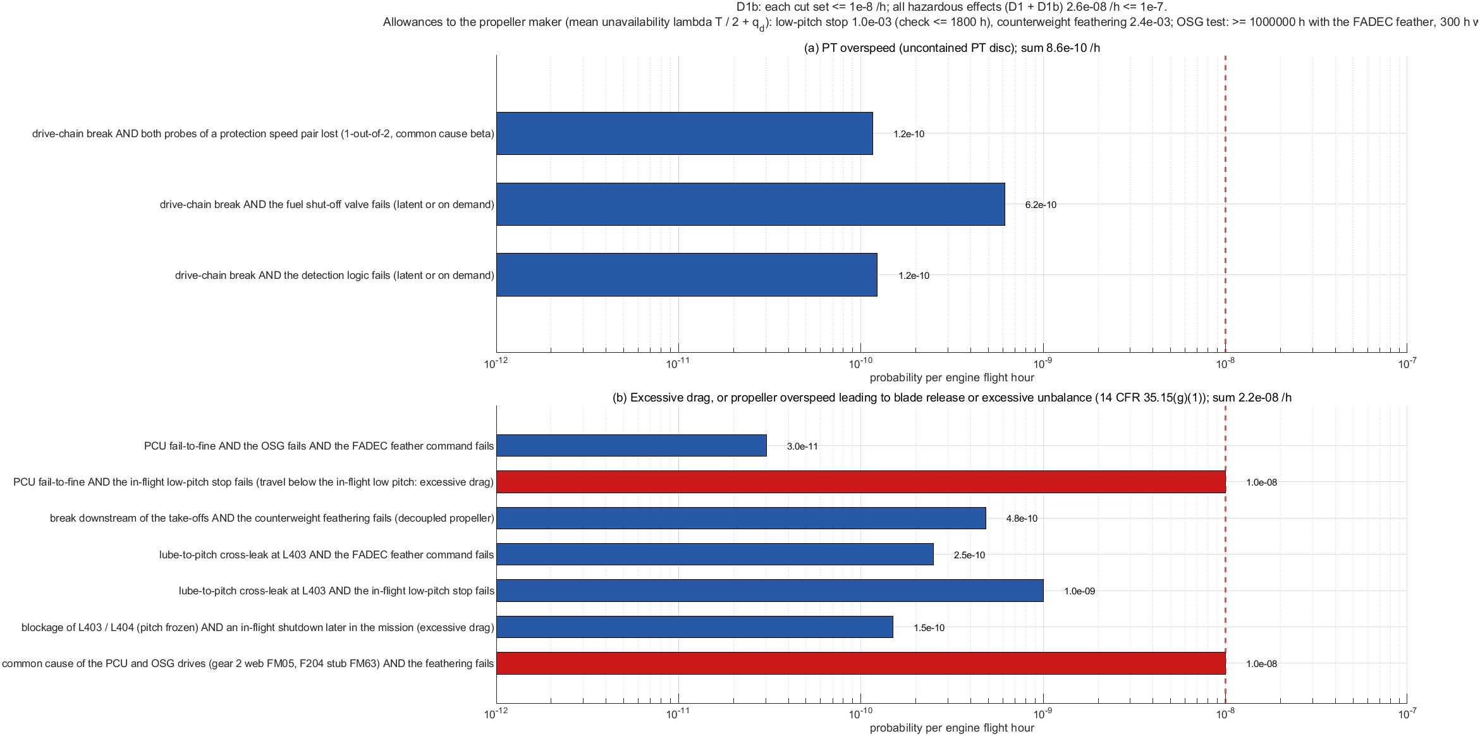
docs/figures/step37/fta2_en.png
