tanboga20/turboprop-from-turboshaft/docs/figures/step38/fits_tr.png

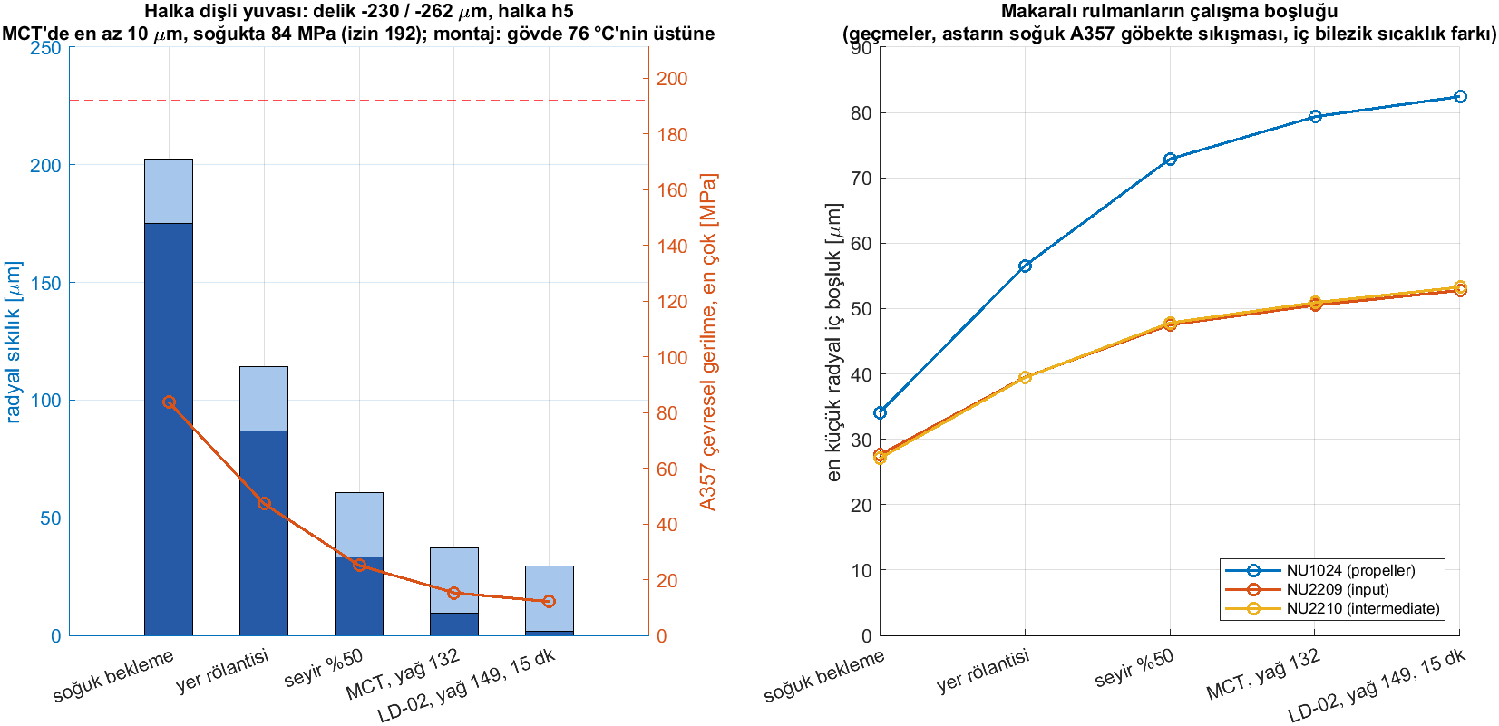
docs/figures/step38/fits_tr.png
