tanboga20/turboprop-from-turboshaft/docs/figures/step38/stack_tr.png

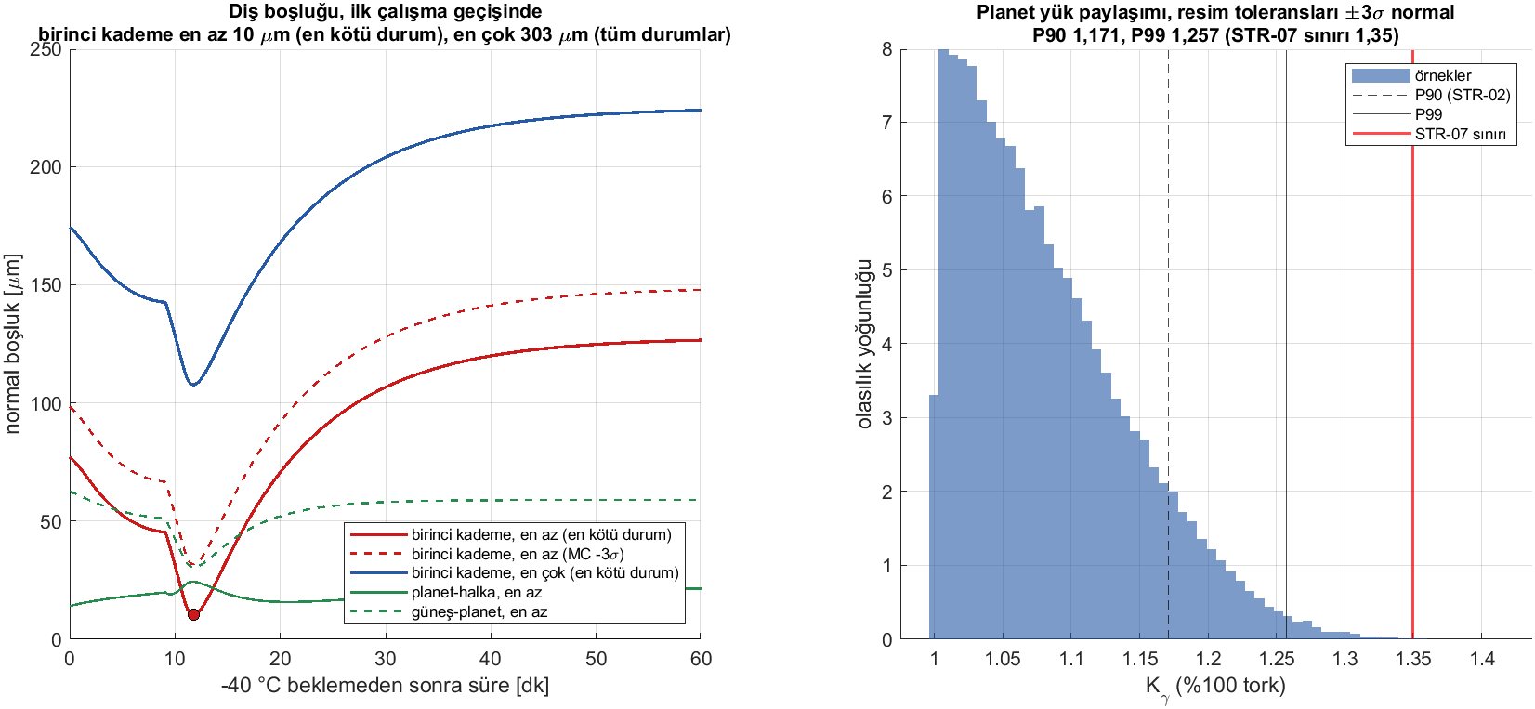
docs/figures/step38/stack_tr.png
