tanboga20/turboprop-from-turboshaft/docs/figures/step38/thermal_en.png

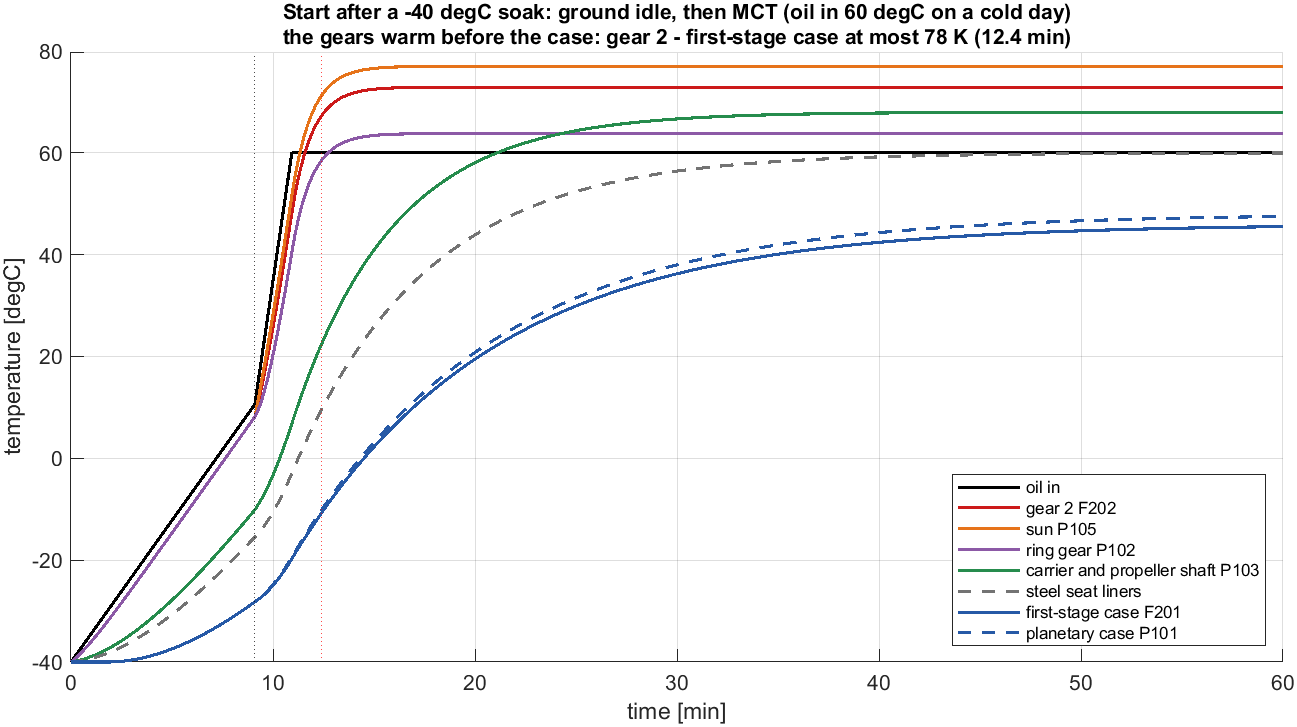
docs/figures/step38/thermal_en.png
