tanboga20/turboprop-from-turboshaft/requirements/verification_v1.csv

id | group | title_en | title_tr | methods | planned_tests | status_after_phase3 | evidence_en | evidence_tr | phase3_steps
SYS-01 | SYS | Power delivery | Güç iletimi | A;T | ET-03 | met | The RGB gears, shafts and bearings (2.4–2.6) and the power turbine output shaft with its diaphragm couplings (2.2) are shown at 895 kW. Power and efficiency test in Phase 3. | RGB'nin dişlileri, milleri ve yatakları (2.4–2.6) ve güç türbini çıkış mili ile diyafram kaplinleri (2.2) 895 kW için gösterildi. Güç ve verim testi Faz 3'te. | -
SYS-02 | SYS | Speeds and ratio | Hızlar ve oran | A;I |  | met | i = 12.932: error −0.07% (limit ±0.5%); the tooth numbers did not change in Phase 2. | i = 12,932: hata −%0,07 (sınır ±%0,5); Faz 2'de diş sayıları değişmedi. | -
SYS-03 | SYS | Steady speed range | Sürekli hız aralığı | A;T | ET-03 | partial | All dynamic checks (DYN-01, DYN-02, DYN-04, DYN-05) used the 90–101% range; running over it is shown in the Phase 3 test. | Bütün dinamik kontroller (DYN-01, DYN-02, DYN-04, DYN-05) %90–101 aralığında yapıldı; aralıkta çalışma Faz 3 testinde gösterilecek. | -
SYS-04 | SYS | 110% transient speed | %110 geçici hız | A;T | ET-04 | partial | At 110% the first-stage pitch-line velocity is 81 m/s (STR-08) and the hoop stress of the power turbine shaft at the post-break peak speed 152.6 MPa. The full-complement planet bearing runs at the speed limit of a similar catalogue bearing (6,000 rpm) at 110%: to be confirmed with the bearing maker. | %110'da birinci kademe çevre hızı 81 m/s (STR-08), güç türbini milinin mil kopmasındaki tepe hızda çevresel gerilmesi 152,6 MPa. Tam dolu makaralı planet yatağı %110'da benzer katalog yatağının hız sınırında (6.000 rpm): yatak üreticisiyle doğrulanacak. | -
SYS-05 | SYS | RGB losses | RGB kayıpları | A;T | RT-01;ET-03 | met | Losses at maximum continuous power 12.39 kW (limit 13.6 kW, efficiency 98.71%), with superfinishing (STR-09). Efficiency test in Phase 3. | Azami sürekli güçte kayıplar 12,39 kW (sınır 13,6 kW, verim %98,71); süper bitirme koşuluyla (STR-09). Verim testi Faz 3'te. | -
SYS-06 | SYS | RGB mass | RGB kütlesi | A |  | met | 109.95 kg against 110 kg TBR (3.7, with the 3.9 P115 hub scallops) | 110 kg TBR sınırına karşı 109,95 kg (3.7, 3.9'daki P115 göbek oyuklarıyla) | 3.1;3.5;3.6;3.7
SYS-07 | SYS | Propeller rotation | Pervane dönüş yönü | I |  | tbd | In the base design the propeller turns opposite to the power turbine; the other hand needs two idlers (offset at least 153 mm). The direction comes from the aircraft maker. | Temel tasarımda pervane güç türbininin tersine dönüyor; diğer yön iki avara dişliyle (eksen kaçıklığı en az 153 mm). Yön uçak üreticisinden gelecek. | -
SYS-08 | SYS | Rating definition and torque limit | Güç tanımı ve tork sınırı | A;T | ET-02 | open | The definition was set at the PDR; torque limiting uses the CTL-01 torque meter. Control logic and test in Phase 3. | Tanım PDR'de kondu; tork sınırlaması CTL-01 tork ölçeriyle yapılıyor. Kontrol mantığı ve test Faz 3'te. | -
SYS-09 | SYS | Propeller axis position | Pervane ekseninin konumu | I |  | tbd | Offset about 146 mm; its direction and agreement come from the aircraft maker. | Kaçıklık yaklaşık 146 mm; yönü ve kabulü uçak üreticisinden gelecek. | -
SYS-10 | SYS | Exhaust duct interface | Egzoz kanalı arayüzü | A;I |  | partial | The shaft tunnel is designed (2.2): with 15 mm of insulation and 7.5 g/s of buffer air the shaft stays at or below 124.5 °C. Interface condition: at most 0.60 m from diaphragm to diaphragm. Exhaust duct dimensions and temperatures come from the core maker. | Mil tüneli tasarlandı (2.2): 15 mm yalıtım ve 7,5 g/s tampon havayla mil en fazla 124,5 °C. Arayüz koşulu: diyaframdan diyaframa en fazla 0,60 m. Egzoz kanalı ölçüleri ve sıcaklıkları çekirdek üreticisinden. | -
LD-01 | LD | Transient torque 137.5% | Geçici tork %137,5 | A;T | ET-02 | met | The static check of the gears, the yield check of the shafts and the power turbine shaft with its couplings (shear stress 124.9 MPa at LD-01, static safety 1.17) pass. | Dişlilerin statik kontrolü, millerin akma kontrolü ve güç türbini mili ile kaplinler (LD-01'de kayma gerilmesi 124,9 MPa, statik güvenlik 1,17) geçiyor. | -
LD-02 | LD | Over-torque test | Aşırı tork testi | A;T | ET-02 | open | The design uses the LD-01 torque; the overtorque test is in Phase 3. | Tasarım LD-01 torkunu kullanıyor; aşırı tork testi Faz 3'te. | -
LD-03 | LD | Positive thrust | Pozitif itki | A | RT-03 | met | With 20 kN of thrust the four-point contact bearing of the propeller shaft reaches 35,000 h (STR-02) and the case stays at or below 81 MPa at limit load (2.8). | 20 kN itkiyle pervane milinin dört noktalı bilyalı yatağı 35.000 saat (STR-02) ve gövde sınır yükte en fazla 81 MPa (2.8). | -
LD-04 | LD | Negative thrust, retention | Negatif itki, tutuş | A | RT-03 | met | The four-point contact bearing carries load in both directions; as a second load path there is a titanium retention tube inside the propeller shaft and a catcher lip in the nose cover (Decision 4, SAF-01). | Dört noktalı bilyalı yatak iki yönde de yük taşıyor; ikinci yük yolu olarak pervane milinin içinde titanyum tutma borusu ve burun kapağında yakalama dudağı var (Karar 4, SAF-01). | -
LD-05 | LD | Gyroscopic load | Jiroskobik yük | A | RT-03 | met | The propeller shaft (PDR), the bearings (2.5, static safety and life) and the case (2.8: most loaded fillet 81 MPa, 165 MPa allowed) carry the gyroscopic limit load. | Pervane mili (PDR), yataklar (2.5, statik güvenlik ve ömür) ve gövde (2.8: en yüklü yuvarlatma 81 MPa, izin verilen 165 MPa) jiroskopik sınır yükü taşıyor. | -
LD-06 | LD | Manoeuvre loads | Manevra yükleri | A |  | tbd | The vertical load factors are used (generator pad at 3.17 g); the lateral and fore-aft factors come from the aircraft maker. | Düşey yük katsayıları kullanıldı (jeneratör pedi 3,17 g'de); yanal ve ileri-geri katsayılar uçak üreticisinden gelecek. | -
LD-07 | LD | 1P and nP moments | 1P ve nP momentleri | A |  | tbd | The values come from the propeller maker; the housing fatigue check uses them in Phase 3. | Değerler pervane üreticisinden gelecek; gövde yorulması bu değerlerle Faz 3'te hesaplanacak. | -
LD-08 | LD | Sudden stoppage | Ani durma | A | RT-03 | partial | The gears take 24,386 N·m at the propeller; condition: the power turbine takes at least 0.22 s to stop (interface condition on the core maker). | Dişliler pervanede 24.386 N·m taşıyor; koşul, güç türbininin en az 0,22 s'de durması (çekirdek üreticisine arayüz koşulu). | -
SAF-01 | SAF | Propeller release | Pervane ayrılması | A | RT-07;RT-08 | met | fault tree: largest cut set 2.1e-9 /h, sum 3.3e-9 /h (3.7) | hata ağacı: en büyük kesim kümesi 2,1e-9 /sa, toplam 3,3e-9 /sa (3.7) | 3.7;3.8;3.9
SAF-02 | SAF | Critical parts | Kritik parçalar | A;I | IN-01 | partial | 7 critical parts with plans; lives TBR (3.7) | planlarıyla 7 kritik parça; ömürler TBR (3.7) | 3.7
SAF-03 | SAF | Shaft-failure overspeed | Mil kopmasında aşırı hız | A;T | ET-09 | partial | all break locations detected; peak speed TBR (3.7) | bütün kopma yerleri algılanıyor; en yüksek hız TBR (3.7) | 3.7
SAF-04 | SAF | Windmilling | Rüzgârla dönme | A;T | ET-07 | partial | met for an intact drive chain only (3.7) | yalnız sağlam tahrik zinciri için sağlanıyor (3.7) | 3.7
SAF-05 | SAF | Fire protection | Yangın | A;T | CT-01;RT-06 | open | oil-wetted walls pass; dry walls, seals, zero flow open (3.7) | yağla ıslanan duvarlar geçiyor; kuru duvarlar, keçeler, sıfır debi açık (3.7) | 3.7
SAF-06 | SAF | Core torque decay | Çekirdeğin tork sönümü | A;T | ET-09 | tbd | Passed to the core maker. | Çekirdek üreticisine aktarıldı. | -
DYN-01 | DYN | Bending critical speeds (forward whirl) | Eğilme kritik hızları (ileri yönlü) | A;T | ET-01 | met | Power turbine shaft 34,443 rpm (limit 26,640 rpm); RGB shafts as at the PDR; the forward-whirl criticals of the 120/100 mm propeller shaft lie above 110% (2.1). | Güç türbini mili 34.443 rpm (sınır 26.640 rpm); RGB milleri PDR'deki gibi; 120/100 mm pervane milinin ileri yönlü kritik hızları %110'un üstünde (2.1). | -
DYN-02 | DYN | Torsional vibration | Burulma titreşimi | A;T | ET-01 | met | The torsional modes stay at least 11.7% away from every excitation order (2.3); updated when the propeller blade flexibility is known. | Burulma modları uyarı mertebelerinden en az %11,7 ayrık (2.3); pervane kanadının esnekliği gelince güncellenecek. | -
DYN-03 | DYN | Vibration survey | Titreşim taraması | A;T | CT-02;RT-04;ET-01 | met | planetary case Goodman 1.19 at the R10 flange junction (3.6) | planet gövdesi R10 flanş birleşiminde Goodman 1,19 (3.6) | 3.6;3.8
DYN-04 | DYN | Gear mesh frequencies | Kavrama frekansları | A;T | RT-04;ET-01 | partial | Ring and planet rims and the accessory gears are clear (at least 63%). Planet: 1× band clear by 27%, its third mode at the edge of the 2× band (open). First-stage gear web in the band: damping ring, test in Phase 3. Housing panels: forced response in Phase 3 (v3 text). | Halka ve planet jantları ile aksesuar dişlileri açık (en az %63). Planet: 1× bandı %27 açık, 3. mod 2× bandın kıyısında (açık). Birinci kademe dişlisinin gövdesi bantta: sönüm halkası, test Faz 3'te. Gövde panelleri: zorlanmış titreşim cevabı Faz 3'te (v3 metni). | 3.6
DYN-05 | DYN | Backward whirl and support anisotropy | Geri yönlü modlar ve yatak anizotropisi | A;T | ET-01 | met | Without a damper the ratio is 1.67 in the worst case (limit 2.5), on condition of at least 5×10⁷ N/m in every direction at the seats (2.1). The case gives 5.04×10⁸ N/m at the inner seat and 9.47×10⁷ N/m at the outer seat, still 6.56×10⁷ N/m with an opened bolted joint (2.8). The PDR risk is removed. | Sönümleyicisiz pervane milinde oran en kötü durumda 1,67 (sınır 2,5), koşulu yuvalarda her yönde en az 5×10⁷ N/m (2.1). Gövde iç yuvada 5,04×10⁸, dış yuvada 9,47×10⁷ N/m veriyor; cıvatalı bağlantı açılsa bile 6,56×10⁷ N/m (2.8). PDR'deki risk kalktı. | -
STR-01 | STR | Gear rating | Dişli dayanımı | A |  | met | By ISO 6336 Methods B and C the lowest S_H is 1.34 and the lowest S_F 1.77 (after 2.5); the static check at overtorque passes. Scuffing by the published form of the ISO/TS 6336-20 method gives S_S ≥ 1.61 with MIL-PRF-23699 (TBR). | ISO 6336 Yöntem B ve C ile en düşük S_H 1,34, S_F 1,77 (2.5'ten sonra); aşırı torkta statik kontrol geçiyor. Sıvanma, ISO/TS 6336-20'nin yayımlanmış yöntemiyle MIL-PRF-23699'da S_S ≥ 1,61 (TBR). | 3.8
STR-02 | STR | Bearing life | Yatak ömrü | A | RT-02 | met | Every bearing is above 12,000 h at 110 °C: the lowest is the planet bearing at 14,500 h, among the main bearings the four-point contact bearing of the propeller shaft at 35,000 h, and the accessory bearings are above too. b_m, e_C and the a_ISO coefficients are TBR until ISO 281 is available. | Bütün yataklar 110 °C'de 12.000 saatin üstünde: en düşüğü planet yatağı 14.500 saat, ana yataklarda pervane milinin dört noktalı yatağı 35.000 saat, aksesuar yatakları da üstünde. b_m, e_C ve a_ISO katsayıları ISO 281 gelene kadar TBR. | 3.8
STR-03 | STR | Shaft strength | Mil dayanımı | A |  | met | The shafts and splines meet it (2.5); power turbine shaft fatigue safety 7.32 (2.2). The spline pressure limits are TBR until the Phase 3 wear tests. | Miller ve kamalı bağlantılar sağlıyor (2.5); güç türbini mili yorulma güvenliği 7,32 (2.2). Kamalı bağlantı basınç sınırları Faz 3 aşınma testlerine kadar TBR. | -
STR-04 | STR | Housing stiffness | Gövde rijitliği | A | RT-03 | partial | The seat stiffness is met: inner seat 5.04×10⁸, outer seat 9.47×10⁷ N/m, 6.56×10⁷ N/m with an opened bolted joint (2.8). The misalignment of the ring gear under load and the engine-side flexibility follow in Phase 3. | Yuva direngenliği sağlanıyor: iç yuva 5,04×10⁸, dış yuva 9,47×10⁷ N/m, cıvatalı bağlantı açıldığında 6,56×10⁷ N/m (2.8). Halka dişlinin yük altındaki eksen kaçıklığı ve motor tarafının esnekliği Faz 3'te. | -
STR-05 | STR | TBO and service life | TBO ve hizmet ömrü | A | RT-11 | met | The calculations use this basis: gears for 10¹⁰ cycles, shafts for infinite life, bearings for 3 × TBO. | Hesaplar bu esasa göre: dişliler 10¹⁰ çevrim, miller sonsuz ömür, yataklar 3 × TBO. | -
STR-06 | STR | Gear materials | Dişli malzemeleri | I;T | IN-01;RT-01;ET-03 | partial | Gears in carburized Pyrowear 53 (AMS 6308), the ring in nitrided 32CrMoV13 (2.4); material specifications and hardness checks with the drawings in Phase 3. | Dişliler Pyrowear 53 (AMS 6308) sementasyon, halka 32CrMoV13 nitrürleme (2.4); malzeme şartnameleri ve sertlik kontrolleri teknik resimlerle Faz 3'te. | -
STR-07 | STR | Planetary load sharing | Planet kademesinde yük paylaşımı | A;T | RT-01 | met | K_gamma P99 1.257 with the drawing tolerances (3.8) | resim toleranslarıyla K_gamma P99 1,257 (3.8) | 3.8
STR-08 | STR | First stage | Birinci kademe | A;I |  | met | The helix corrections and tip reliefs of the first stage were set by 3D load distribution (2.4); pitch-line velocity at 110% 81 m/s (limit 100 m/s). | Birinci kademenin helis düzeltmeleri ve uç kırmaları 3B yük dağılımıyla belirlendi (2.4); %110'da çevre hızı 81 m/s (sınır 100 m/s). | -
STR-09 | STR | Flank roughness (superfinishing) | Diş yüzeyi pürüzlülüğü (süper bitirme) | I | IN-01 | met | All gears are superfinished (Decision 1); written on the drawings, inspection in Phase 3. | Bütün dişliler süper bitirme (Karar 1); teknik resimlere yazıldı, muayene Faz 3'te. | -
STR-10 | STR | Housing casting | Gövde dökümü | A;I | CT-01;IN-01;RT-03 | met | A357-T6 case with the 1.25 casting factor: most loaded fillet 81 MPa at limit load (165 MPa allowed), 128 MPa with a spring-supported flange (2.8). Radiographic inspection class TBR. | A357-T6 gövde 1,25 döküm katsayısıyla: en yüklü yuvarlatma sınır yükte 81 MPa (izin 165 MPa), yaylı flanşta 128 MPa (2.8). Radyografik muayene sınıfı TBR. | 3.9
LUB-01 | LUB | Oil type | Yağ tipi | I |  | met | The calculations use MIL-PRF-23699 oil; the temperature limit for MIL-PRF-7808 is in LUB-02. | Hesaplar MIL-PRF-23699 yağıyla; MIL-PRF-7808 için sıcaklık sınırı LUB-02'de. | 3.3
LUB-02 | LUB | Oil temperature | Yağ sıcaklığı | A;T | ET-03;ET-08 | partial | The gears and bearings are rated at 132 °C oil inlet; in normal operation the cooler holds the oil at 100 °C (2.7). 15 minutes at 149 °C and cold starts in Phase 3. | 132 °C yağ girişinde dişliler ve yataklar hesaplandı; normal çalışmada soğutucu yağı 100 °C'de tutuyor (2.7). 15 dakika 149 °C ve soğuk çalıştırma Faz 3'te. | 3.3
LUB-03 | LUB | Oil pressure | Yağ basıncı | A;T | ET-03;ET-05 | partial | Jets at 400 kPa, supply at 550 kPa, both inside 172–965 kPa. Pressure at ground idle in Phase 3. | Memeler 400 kPa, besleme 550 kPa: ikisi de 172–965 kPa içinde. Rölantide basınç Faz 3'te. | -
LUB-04 | LUB | Heat rejection | Isı atımı | A |  | met | Heat into the oil 14.9 kW (PT rear sump included); the cooler is sized for 18 kW on a 53 °C day (2.7). | Yağa giren ısı 14,9 kW (PT arka yatak bölmesi dahil); soğutucu 53 °C'lik günde 18 kW için boyutlandı (2.7). | -
LUB-05 | LUB | Filter, chip detector | Filtre, talaş dedektörü | I;T | ET-03 | partial | 3 µm filter and two chip detectors in the circuit; last-chance strainers for the 0.6 mm jets TBR. Part selection in Phase 3. | 3 µm filtre ve iki talaş dedektörü devrede; 0,6 mm memeler için son çare süzgeçleri TBR. Parça seçimi Faz 3'te. | -
LUB-06 | LUB | Tank and oil quantity | Tank ve yağ miktarı | A;I |  | met | 6.8 L tank (2.7): usable oil, 10% expansion space and the feathering reserve included. | 6,8 L tank (2.7): kullanılabilir yağ, %10 genleşme payı ve tüy açma rezervi dahil. | 3.7
LUB-07 | LUB | Run-dry (goal) | Yağsız çalışma (hedef) | A;T | ET-06 | met | 6.3-6.6 min at 75% MCP with the emergency mist, by analysis (3.2) | acil sisle %75 MCP'de 6,3-6,6 dk, analizle (3.2) | 3.2
LUB-08 | LUB | Attitude and negative g | Duruş ve negatif g | A;T | ET-05 | tbd | The negative-g duration comes from the aircraft maker; Phase 3. | Negatif g süresi uçak üreticisinden gelecek; Faz 3'te. | -
LUB-09 | LUB | Cooling air | Soğutma havası | A;T | ET-03 | met | Closed by Decision 5: an electric fan on the ground (about 0.5 kW), ram air in flight. | Karar 5 ile kapandı: yerde elektrikli fan (yaklaşık 0,5 kW), uçuşta dinamik hava. | -
LUB-10 | LUB | Rear bearing lubrication | Arka yatağın yağlanması | A;T | ET-03 | met | The PT rear sump is fed by two jets and scavenged by its own element; 1.27 L/min (2.2, 2.7). | PT arka yatak bölmesi iki memeyle besleniyor, kendi emme elemanıyla boşaltılıyor; 1,27 L/dk (2.2, 2.7). | -
ACC-01 | ACC | Starter-generator pad | Marş-jeneratör pedi | A;T | RT-05 | tbd | Interface requirement on the core supplier; starting time TBD. | Çekirdek tedarikçisine arayüz gereksinimi; marş süresi TBD. | -
ACC-02 | ACC | RGB accessory pads | RGB aksesuar pedleri | A;I |  | met | The four pads (generator, OSG, PCU, oil pump) are designed with their torques and speeds (2.6). | Dört ped (jeneratör, OSG, PCU, yağ pompası) torkları ve hızlarıyla tasarlandı (2.6). | -
ACC-03 | ACC | Pad safety | Ped emniyeti | A;T | RT-05;RT-11 | met | Fatigue at 1.5 times the torque, the shear necks and necks that break before the gears are shown (2.6). The generator's short-circuit torque is compared with the bottom of the shear band (169 N·m) once the generator is chosen (TBR). | 1,5 kat torkta yorulma, kesme boyunları ve boyunların dişlilerden önce koptuğu gösterildi (2.6). Jeneratörün kısa devre torku seçimden sonra kesme bandının altıyla (169 N·m) karşılaştırılacak (TBR). | -
PIF-01 | PIF | Propeller flange | Pervane flanşı | I |  | tbd | The flange dimensions come from the propeller maker; the CATIA model has a placeholder flange. | Flanş ölçüleri pervane üreticisinden gelecek; CATIA modelinde yer tutucu flanş var. | 3.7
PIF-02 | PIF | Pitch oil transfer | Hatve yağı aktarımı | A;T | ET-05;ET-10 | tbd | The route is through the 100 mm bore of the propeller shaft (2.1); flow and pressure come from the propeller maker. | Yol, 100 mm delikli pervane milinin içinden (2.1); debi ve basınç pervane üreticisinden gelecek. | -
PIF-03 | PIF | Feathering | Tüyleme | T | ET-10 | met | counterweight feathering, by design (3.7) | karşı ağırlıkla tüyleme, tasarımla (3.7) | 3.7
PIF-04 | PIF | No reverse thrust | Ters itki yok | I |  | met | The design has no beta mode; the gears and bearings are not rated for reversing cycles (inspection). | Tasarımda beta modu yok; dişliler ve yataklar ters itki çevrimi için hesaplanmadı (inceleme). | -
PIF-05 | PIF | Overspeed governor | Aşırı hız regülatörü | T | ET-10 | tbd | The governor pad is there (ACC-02); the setting comes from the propeller maker. | Regülatör pedi var (ACC-02); ayar pervane üreticisinden gelecek. | 3.7
CTL-01 | CTL | Torque signal | Tork sinyali | T | RT-09 | met | The phase-shift torque meter meets ±2% with a 20 ns timing resolution and temperature correction (2.2); accuracy test in Phase 3. | Faz kaydırmalı tork ölçer 20 ns zaman çözünürlüğü ve sıcaklık düzeltmesiyle ±%2'yi sağlıyor (2.2); doğruluk testi Faz 3'te. | -
CTL-02 | CTL | Dual speed signals | Çift hız sinyali | I;T | ET-09 | partial | The places of the Np × 2 and Nr × 2 sensors are set (step 1.4); part selection and test in Phase 3. | Np × 2 ve Nr × 2 sensörlerinin yerleri belli (adım 1.4); parça seçimi ve test Faz 3'te. | 3.7
CTL-03 | CTL | Monitoring signals | İzleme sinyalleri | A;I;T | RT-09;ET-03 | partial | indicators FM4, NA4, ENV and log-normal thresholds set on a synthetic signal (3.10); baselines in RT-09 / ET-03 | FM4, NA4, ENV göstergeleri ve log-normal eşikler sentetik sinyalde kuruldu (3.10); temel kayıtlar RT-09 / ET-03'te | 3.10
MNT-01 | MNT | Modular RGB | Modüler RGB | D | MD-01 | partial | target 8 h TBR set; standard-time estimate 7.3 h (3.10); timed in MD-01 | 8 sa TBR hedefi kondu; standart zaman tahmini 7,3 sa (3.10); MD-01'de ölçülecek | 3.10
MNT-02 | MNT | Maintenance access | Bakım erişimi | I;D | MD-01 | met | borescope line of sight to both meshes and line access to the service points shown (3.10); confirmed in MD-01 | iki kavramaya boroskop görüş hattı ve servis noktalarına hat erişimi gösterildi (3.10); MD-01'de doğrulanacak | -
ENV-01 | ENV | Ambient temperature | Ortam sıcaklığı | A;T | ET-08 | partial | The cooler is sized on a 53 °C day; cold starts at −40 °C in Phase 3. | Soğutucu 53 °C'lik günde boyutlandı; −40 °C soğuk çalıştırma Faz 3'te. | -
ENV-02 | ENV | Altitude | İrtifa | A;T | ET-08 | open | Pump inlet, venting and de-aeration at altitude in Phase 3. | Yükseklikte pompa girişi, havalandırma ve hava ayırma Faz 3'te. | -
ENV-03 | ENV | Sand, dust, corrosion | Kum, toz, korozyon | A;T | RT-10 | open | The case is A357-T6 (STR-10); coatings and test methods in Phase 3. | Gövde A357-T6 (STR-10); kaplama ve test yöntemleri Faz 3'te. | -
ENV-04 | ENV | RGB thermal environment | RGB'nin ısıl ortamı | A;T | ET-01 | partial | The tunnel temperatures are computed with 700 °C gas (2.2); updated with the real gas temperatures from the core maker. | Tünel sıcaklıkları 700 °C gazla hesaplandı (2.2); gerçek gaz sıcaklıkları çekirdek üreticisinden gelince güncellenecek. | -
SYS-11 | SYS | Input drive mass | Giriş tahriki kütlesi | A;I |  | met | 5.46 kg against 6 kg TBR (3.3) | 6 kg TBR sınırına karşı 5,46 kg (3.3) | 3.3
STR-11 | STR | Loaded transmission error | Yüklü iletim hatası | A;T | RT-01 | open | TE2 <= 0.15 um set as the design value (3.6); LTCA and loaded TE test open | TE2 <= 0,15 um tasarım değeri olarak kondu (3.6); LTCA ve yüklü TE testi açık | 3.6;3.8
CTL-04 | CTL | Thrust floor and limp mode | İtki tabanı ve topal mod | A;T | RT-07;ET-09 | open | new in 3.7: thrust floor 1.5 kN and limp mode 3.0 kN, FADEC owner | 3.7'de yeni: itki tabanı 1,5 kN ve topal mod 3,0 kN, sahibi FADEC | 3.7
