tanboga20/turboprop-from-turboshaft/safety/nr_verification_v1.csv

crack | load | a_c | a_t | phi_2_pi | FE | equation | diff_pct | in_D4_range | source
surface | tension | 0.2 | 0.2 | 0 | 0.617 | 0.589999715391676 | -4.37605909373161 | 1 | TP-1578 Table I
surface | tension | 0.2 | 0.2 | 1 | 1.173 | 1.18427241501016 | 0.9609901969444 | 1 | TP-1578 Table I
surface | tension | 0.2 | 0.8 | 0 | 1.19 | 1.17214565737247 | -1.5003649266831 | 1 | TP-1578 Table I
surface | tension | 0.2 | 0.8 | 1 | 1.851 | 1.97960526390938 | 6.94788027603364 | 1 | TP-1578 Table I
surface | tension | 0.4 | 0.4 | 0 | 0.896 | 0.91073163487482 | 1.6441556779933 | 1 | TP-1578 Table I
surface | tension | 0.4 | 0.4 | 1 | 1.225 | 1.24566881633792 | 1.68725031329946 | 1 | TP-1578 Table I
surface | tension | 1 | 0.2 | 0 | 1.174 | 1.17315128518754 | -0.072292573463173 | 1 | TP-1578 Table I
surface | tension | 1 | 0.2 | 1 | 1.049 | 1.05309810160462 | 0.390667455158811 | 1 | TP-1578 Table I
surface | tension | 1 | 0.8 | 0 | 1.464 | 1.52044003791574 | 3.85519384670343 | 1 | TP-1578 Table I
surface | tension | 1 | 0.8 | 1 | 1.112 | 1.14836860869769 | 3.27055833612293 | 1 | TP-1578 Table I
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
