tanboga20/turboprop-from-turboshaft/docs/figures/phases/en/p2_benchmark.png

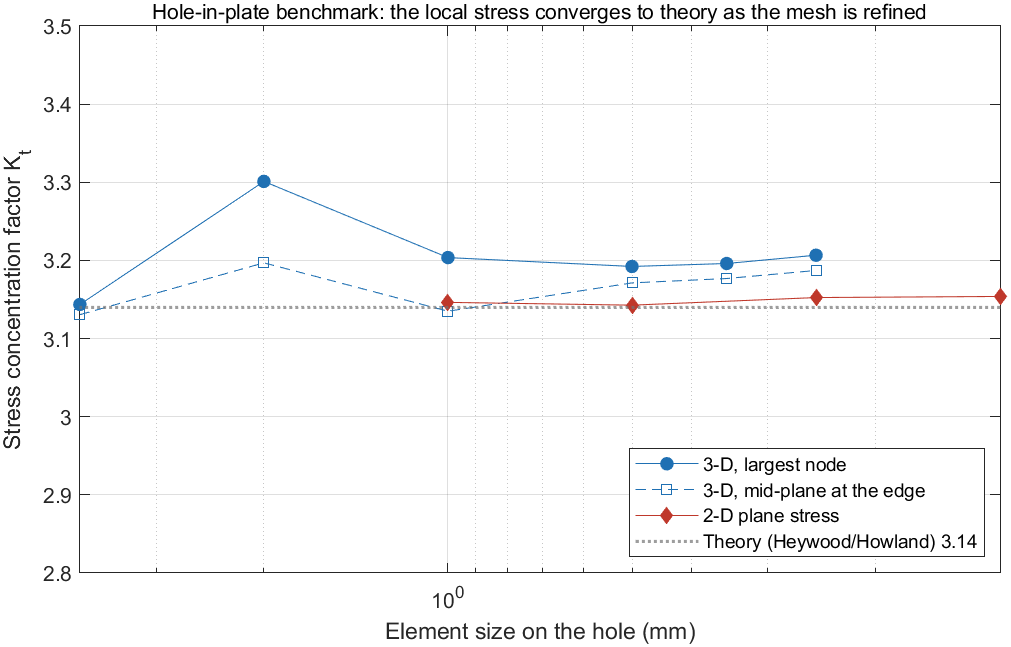
docs/figures/phases/en/p2_benchmark.png
