tanboga20/turboprop-from-turboshaft/docs/figures/phases/tr/p2_benchmark.png

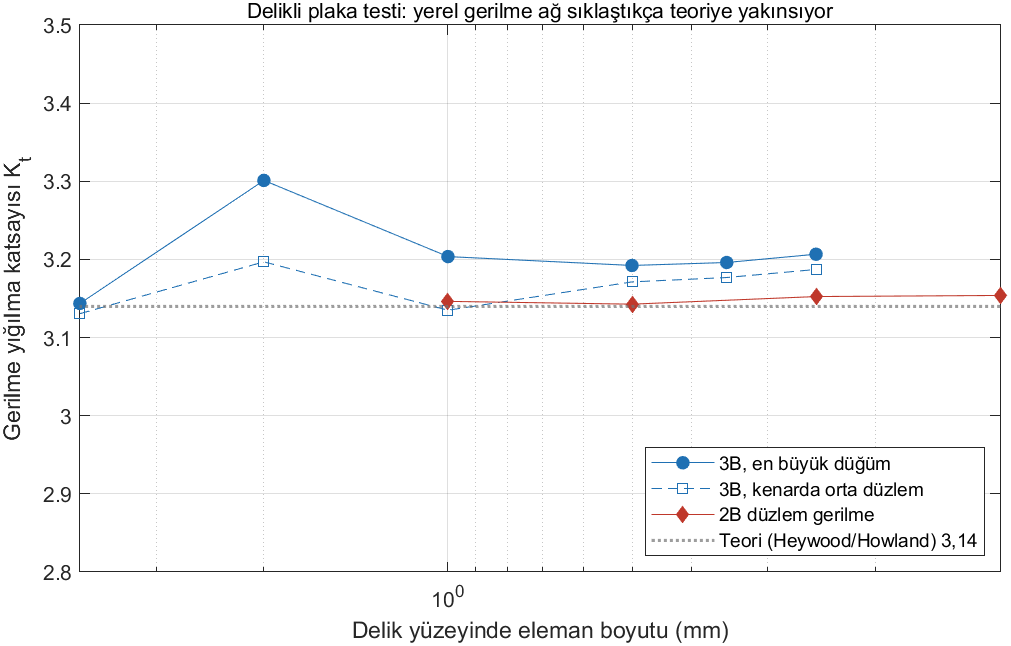
docs/figures/phases/tr/p2_benchmark.png
