tanboga20/turboprop-from-turboshaft/cad/drawings/assembly_39.pdf

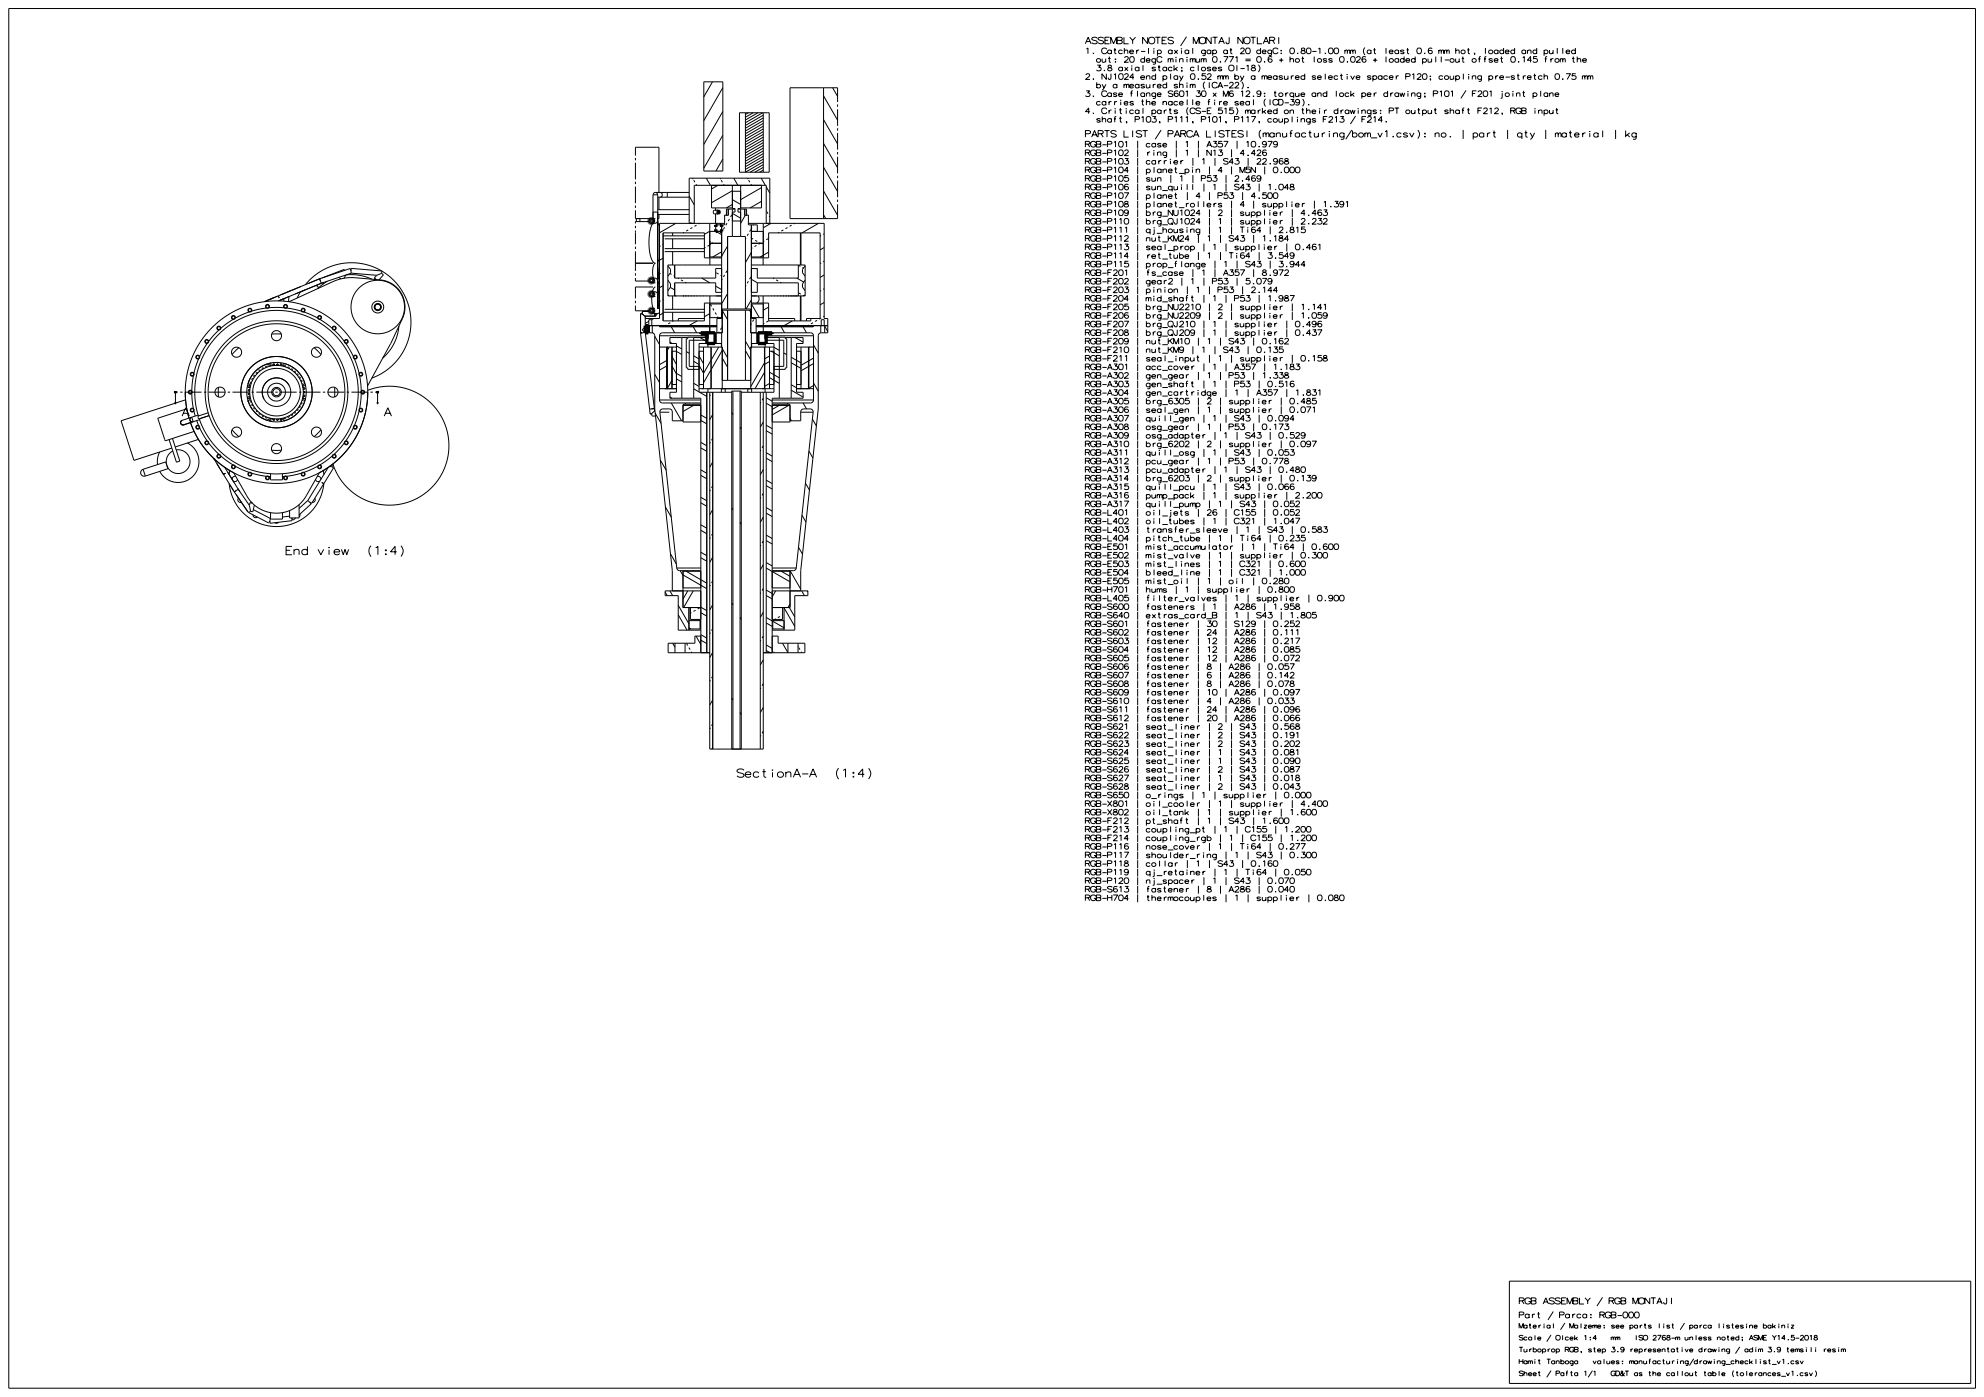
[picture p277: page 1]
