tanboga20/turboprop-from-turboshaft/cad/drawings/carrier.pdf

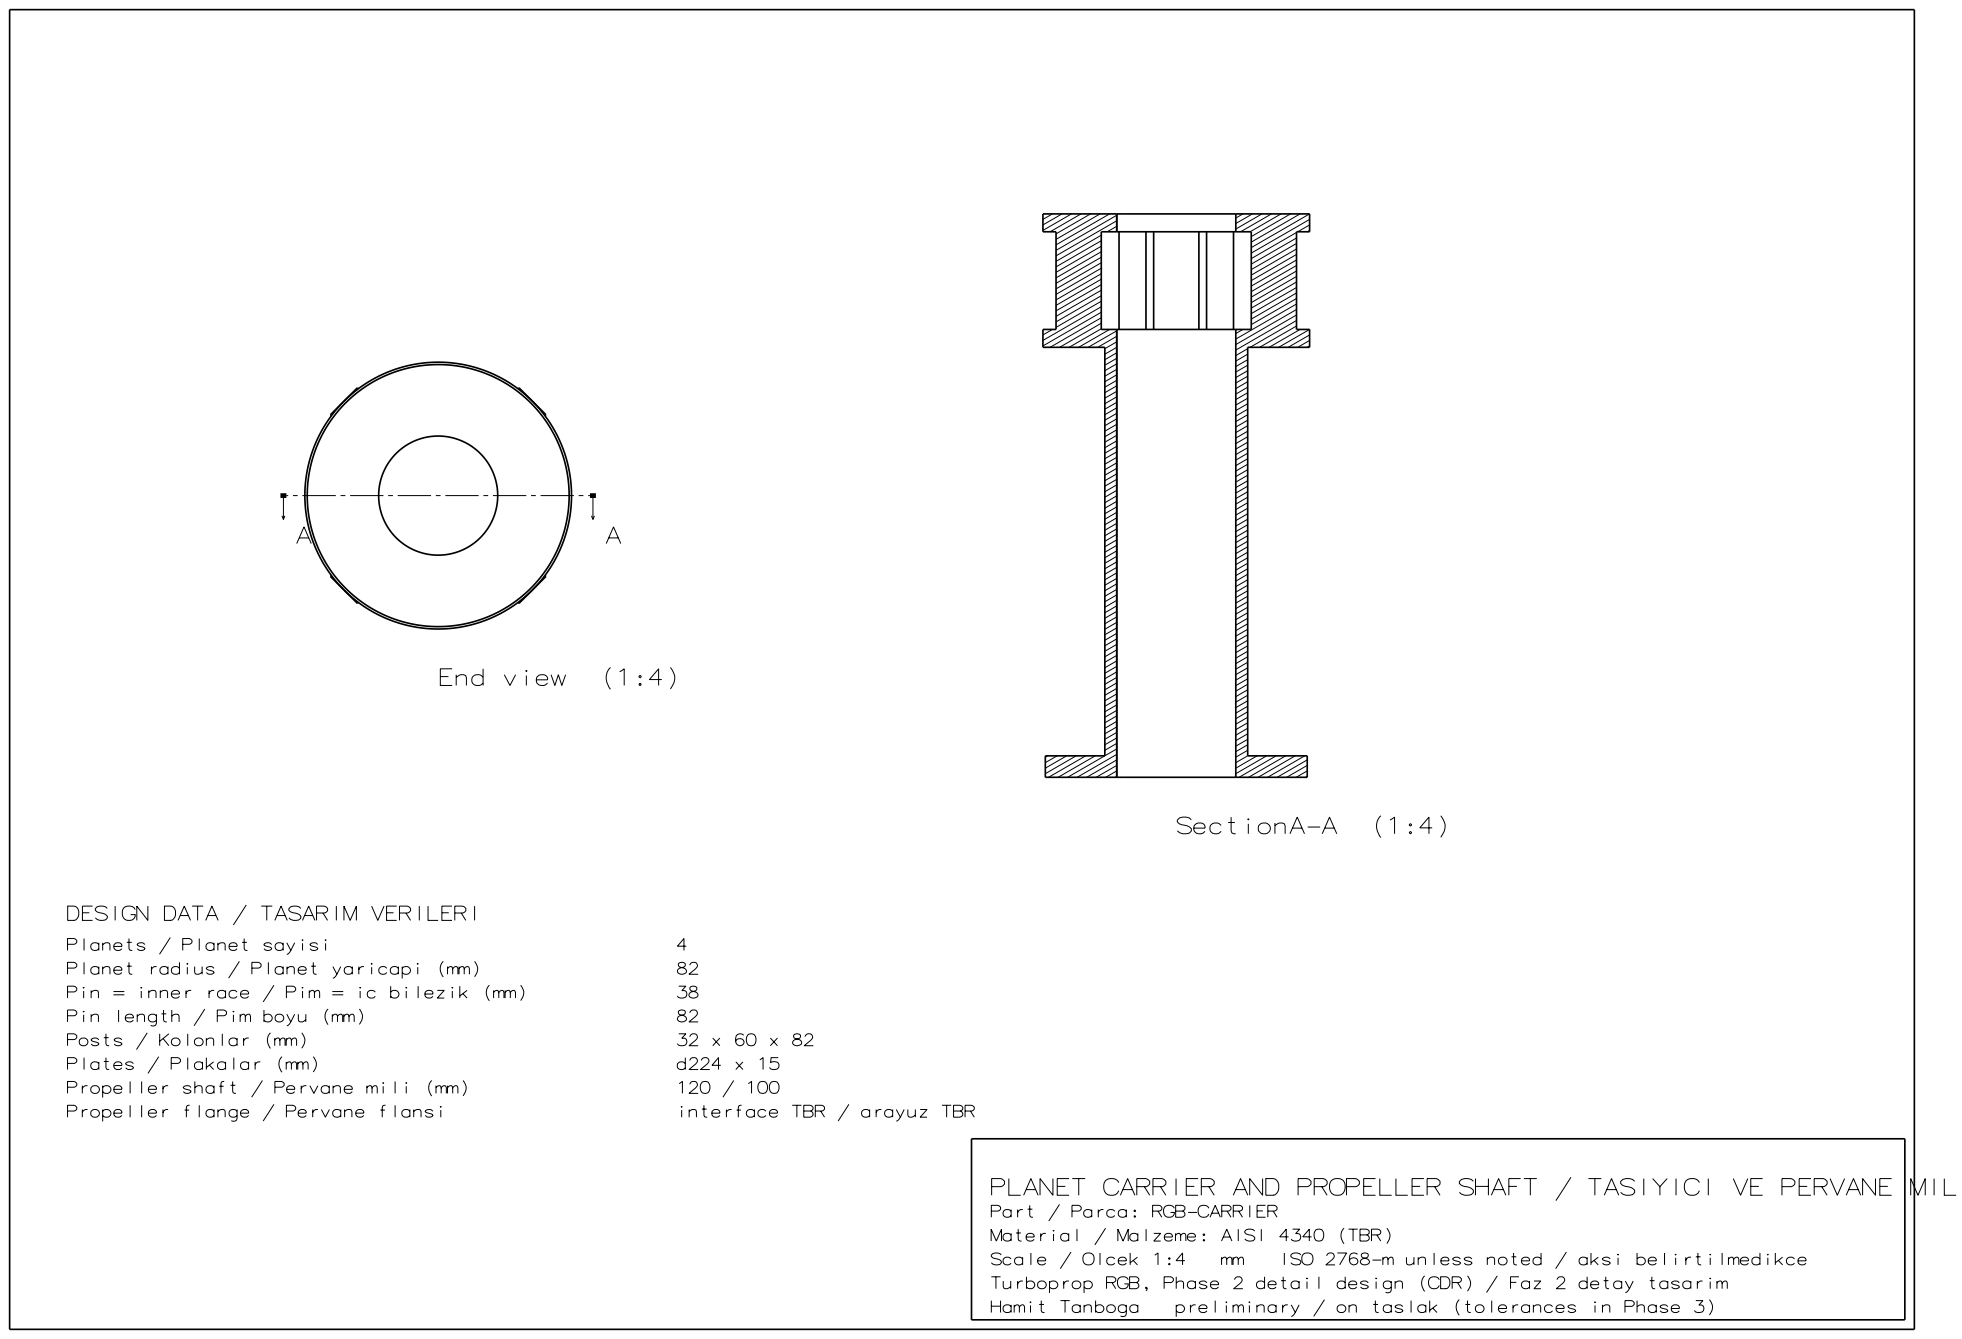
[picture p278: page 1]
