tanboga20/turboprop-from-turboshaft/cad/drawings/carrier_39.pdf

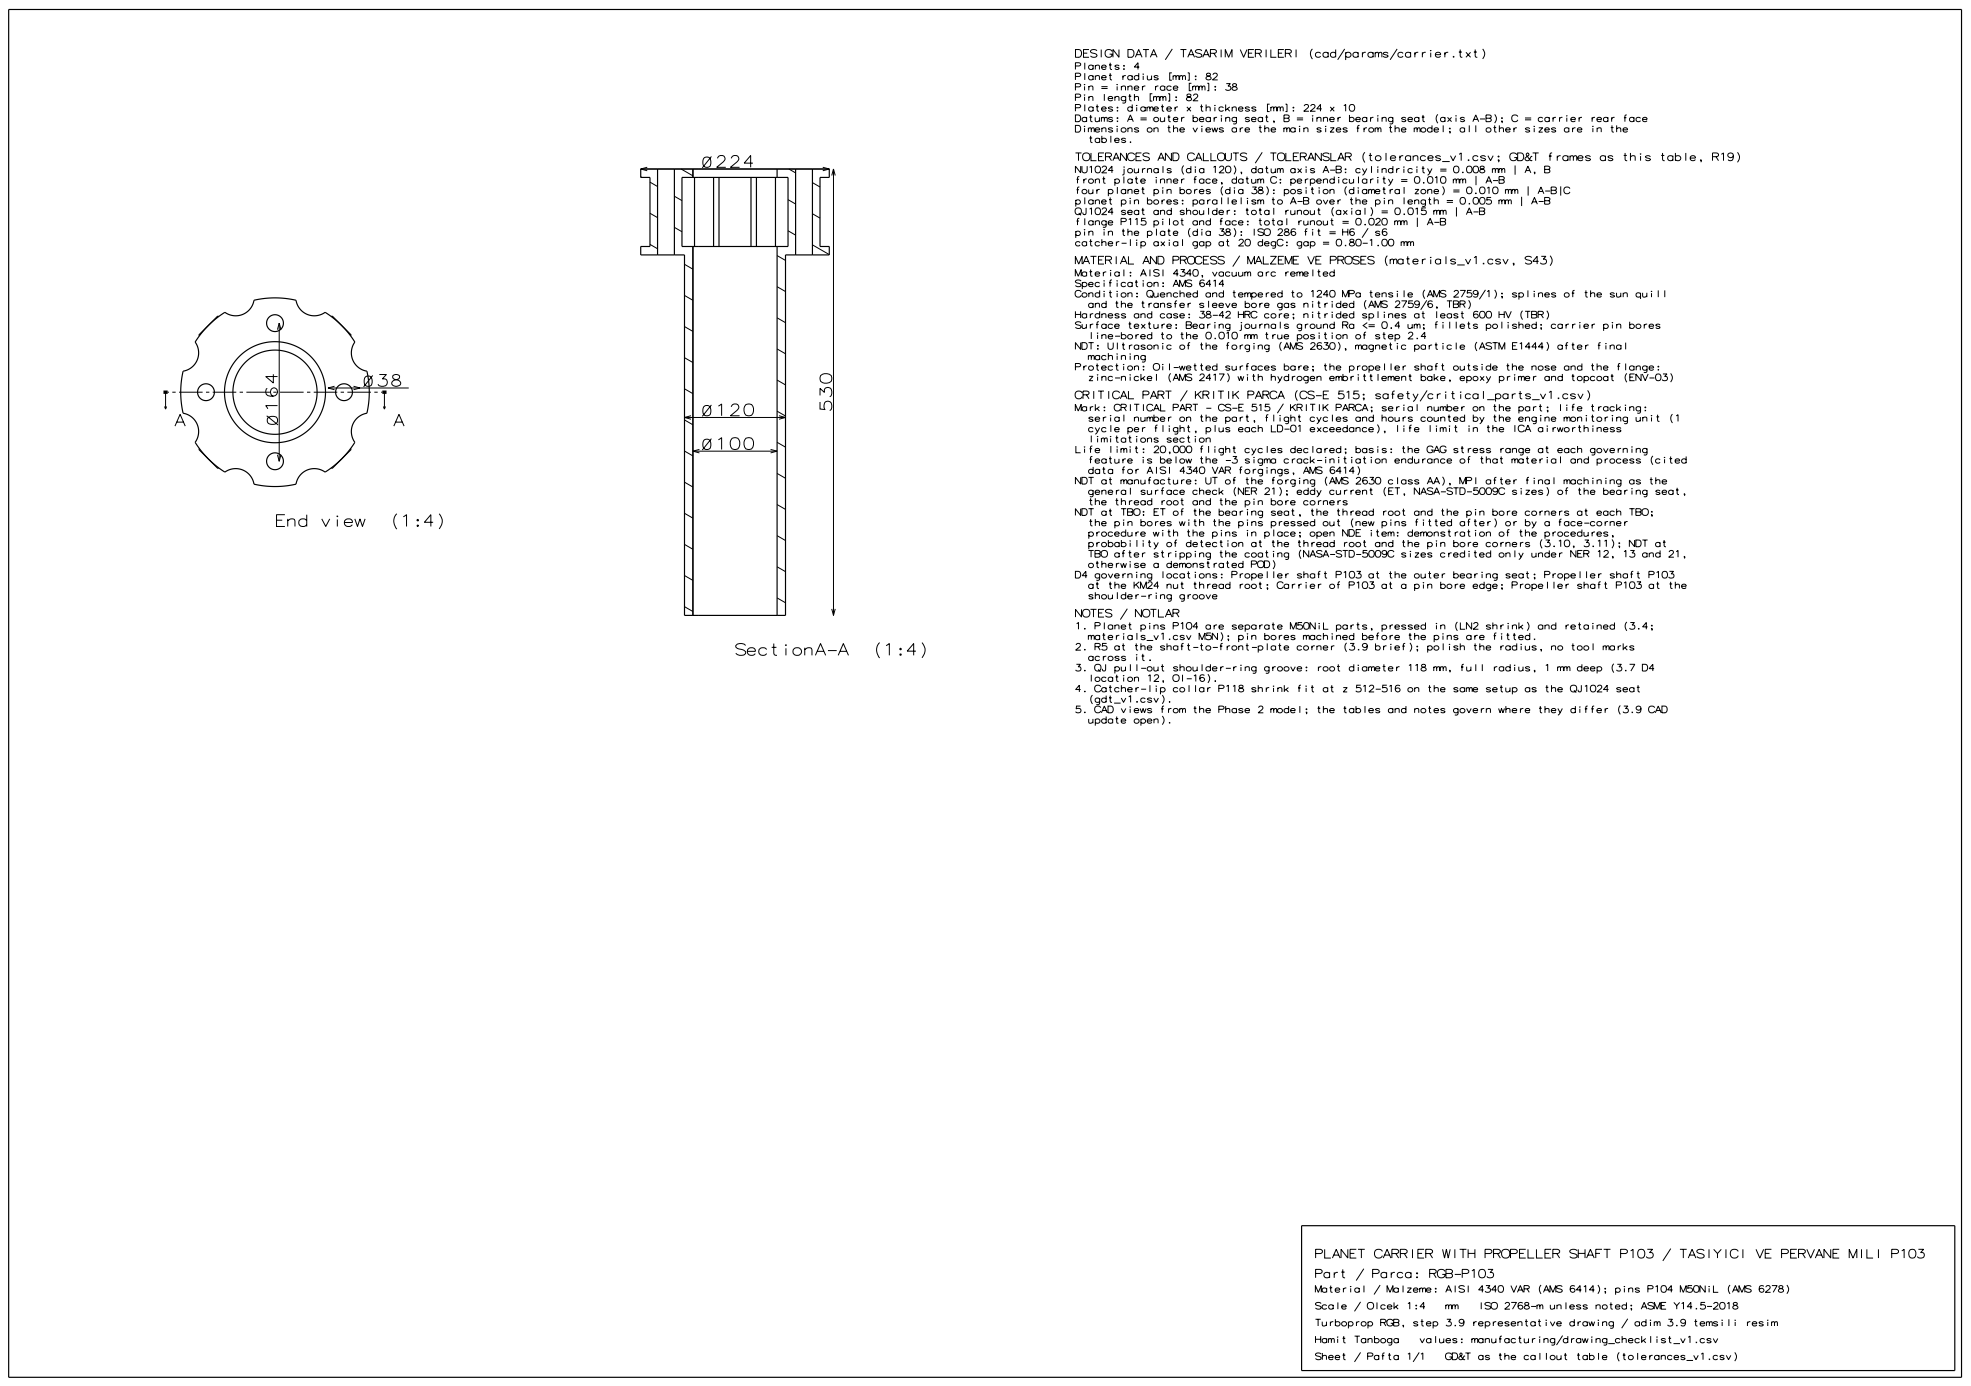
[picture p279: page 1]
