tanboga20/turboprop-from-turboshaft/cad/drawings/case.pdf

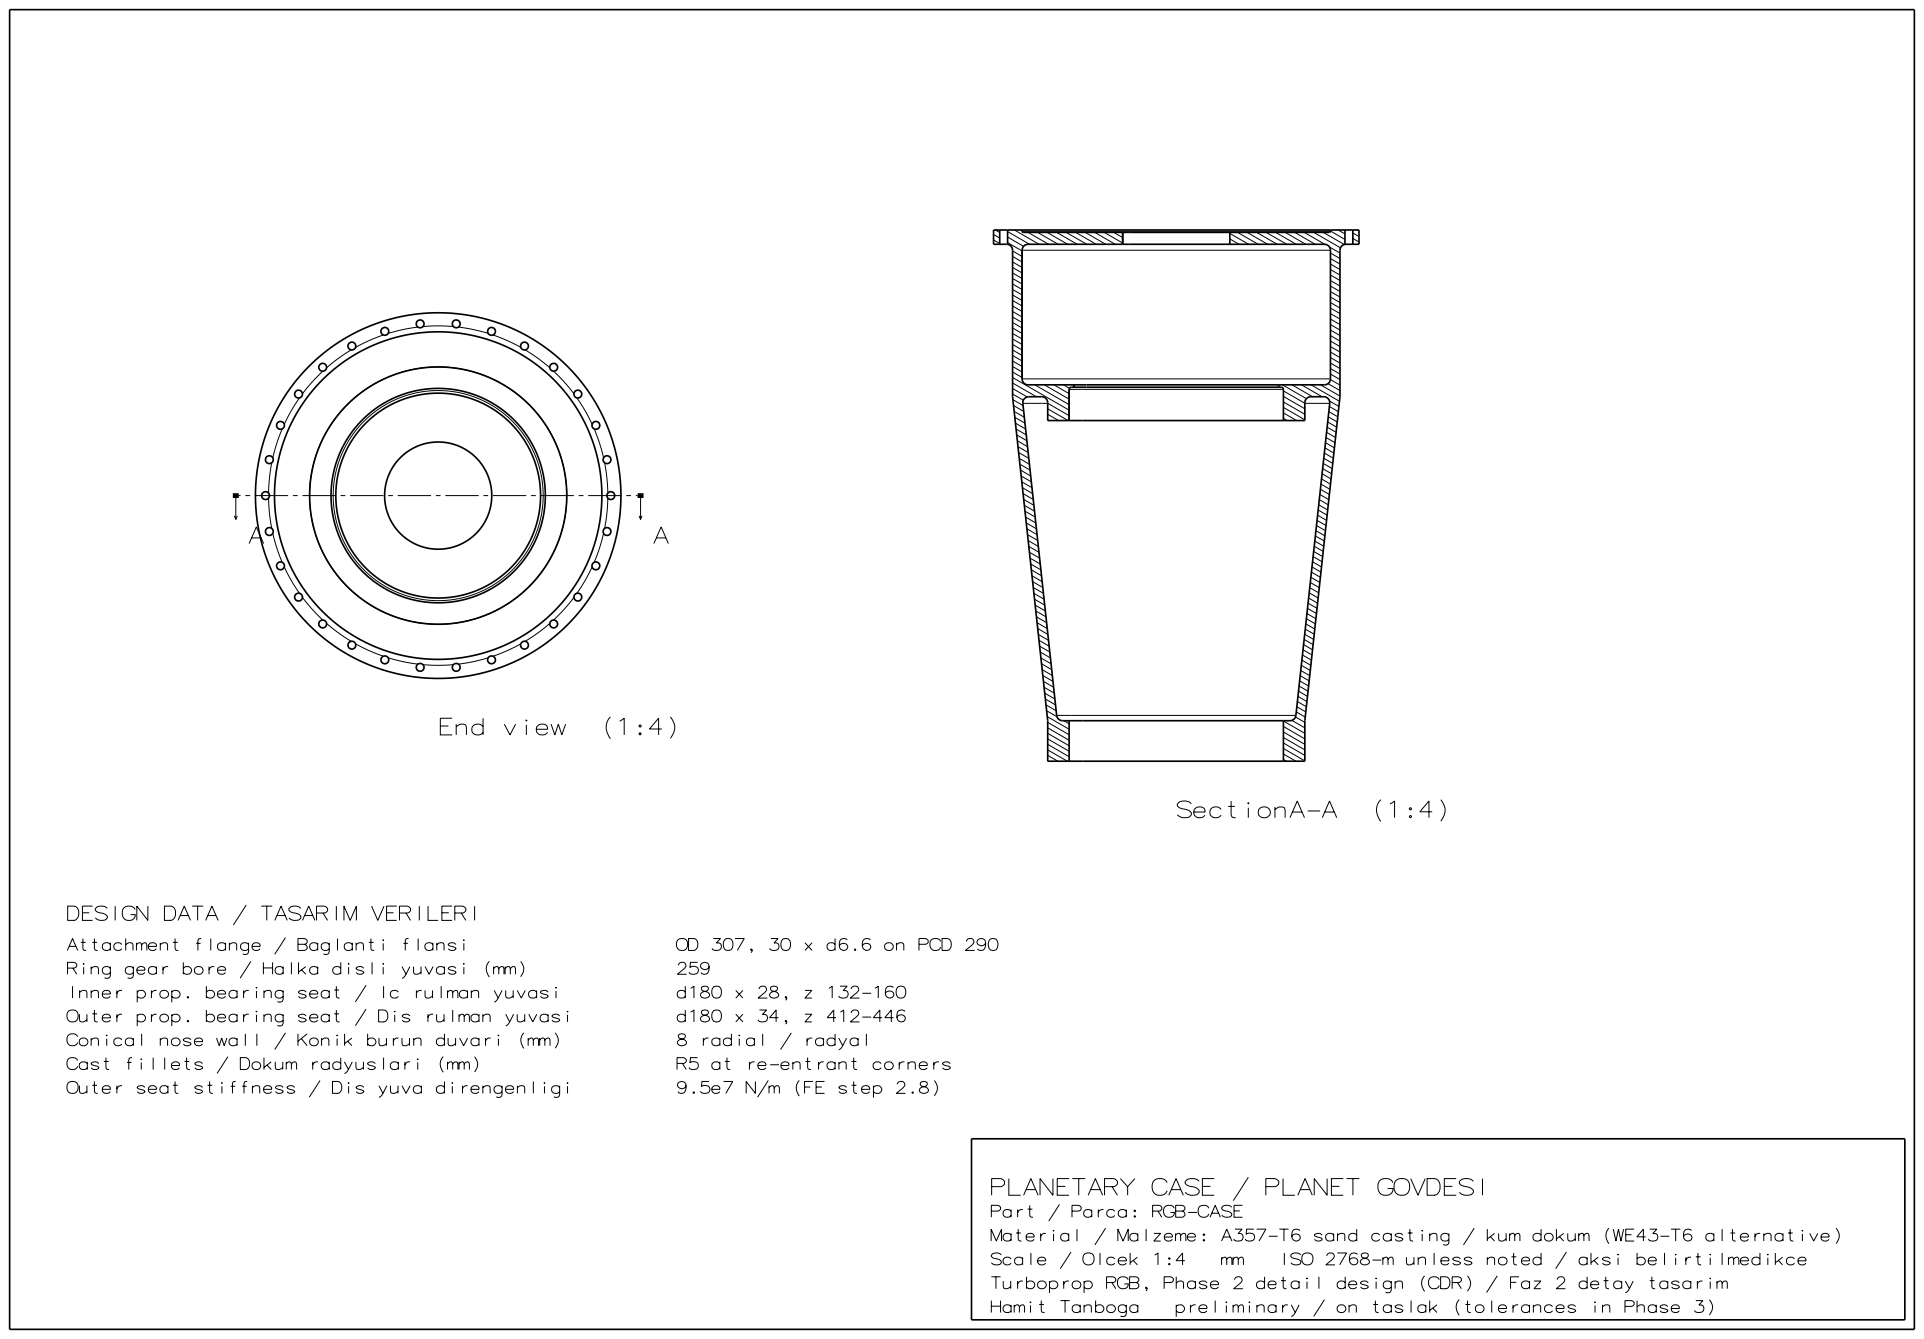
[picture p280: page 1]
