tanboga20/turboprop-from-turboshaft/cad/drawings/case_39.pdf

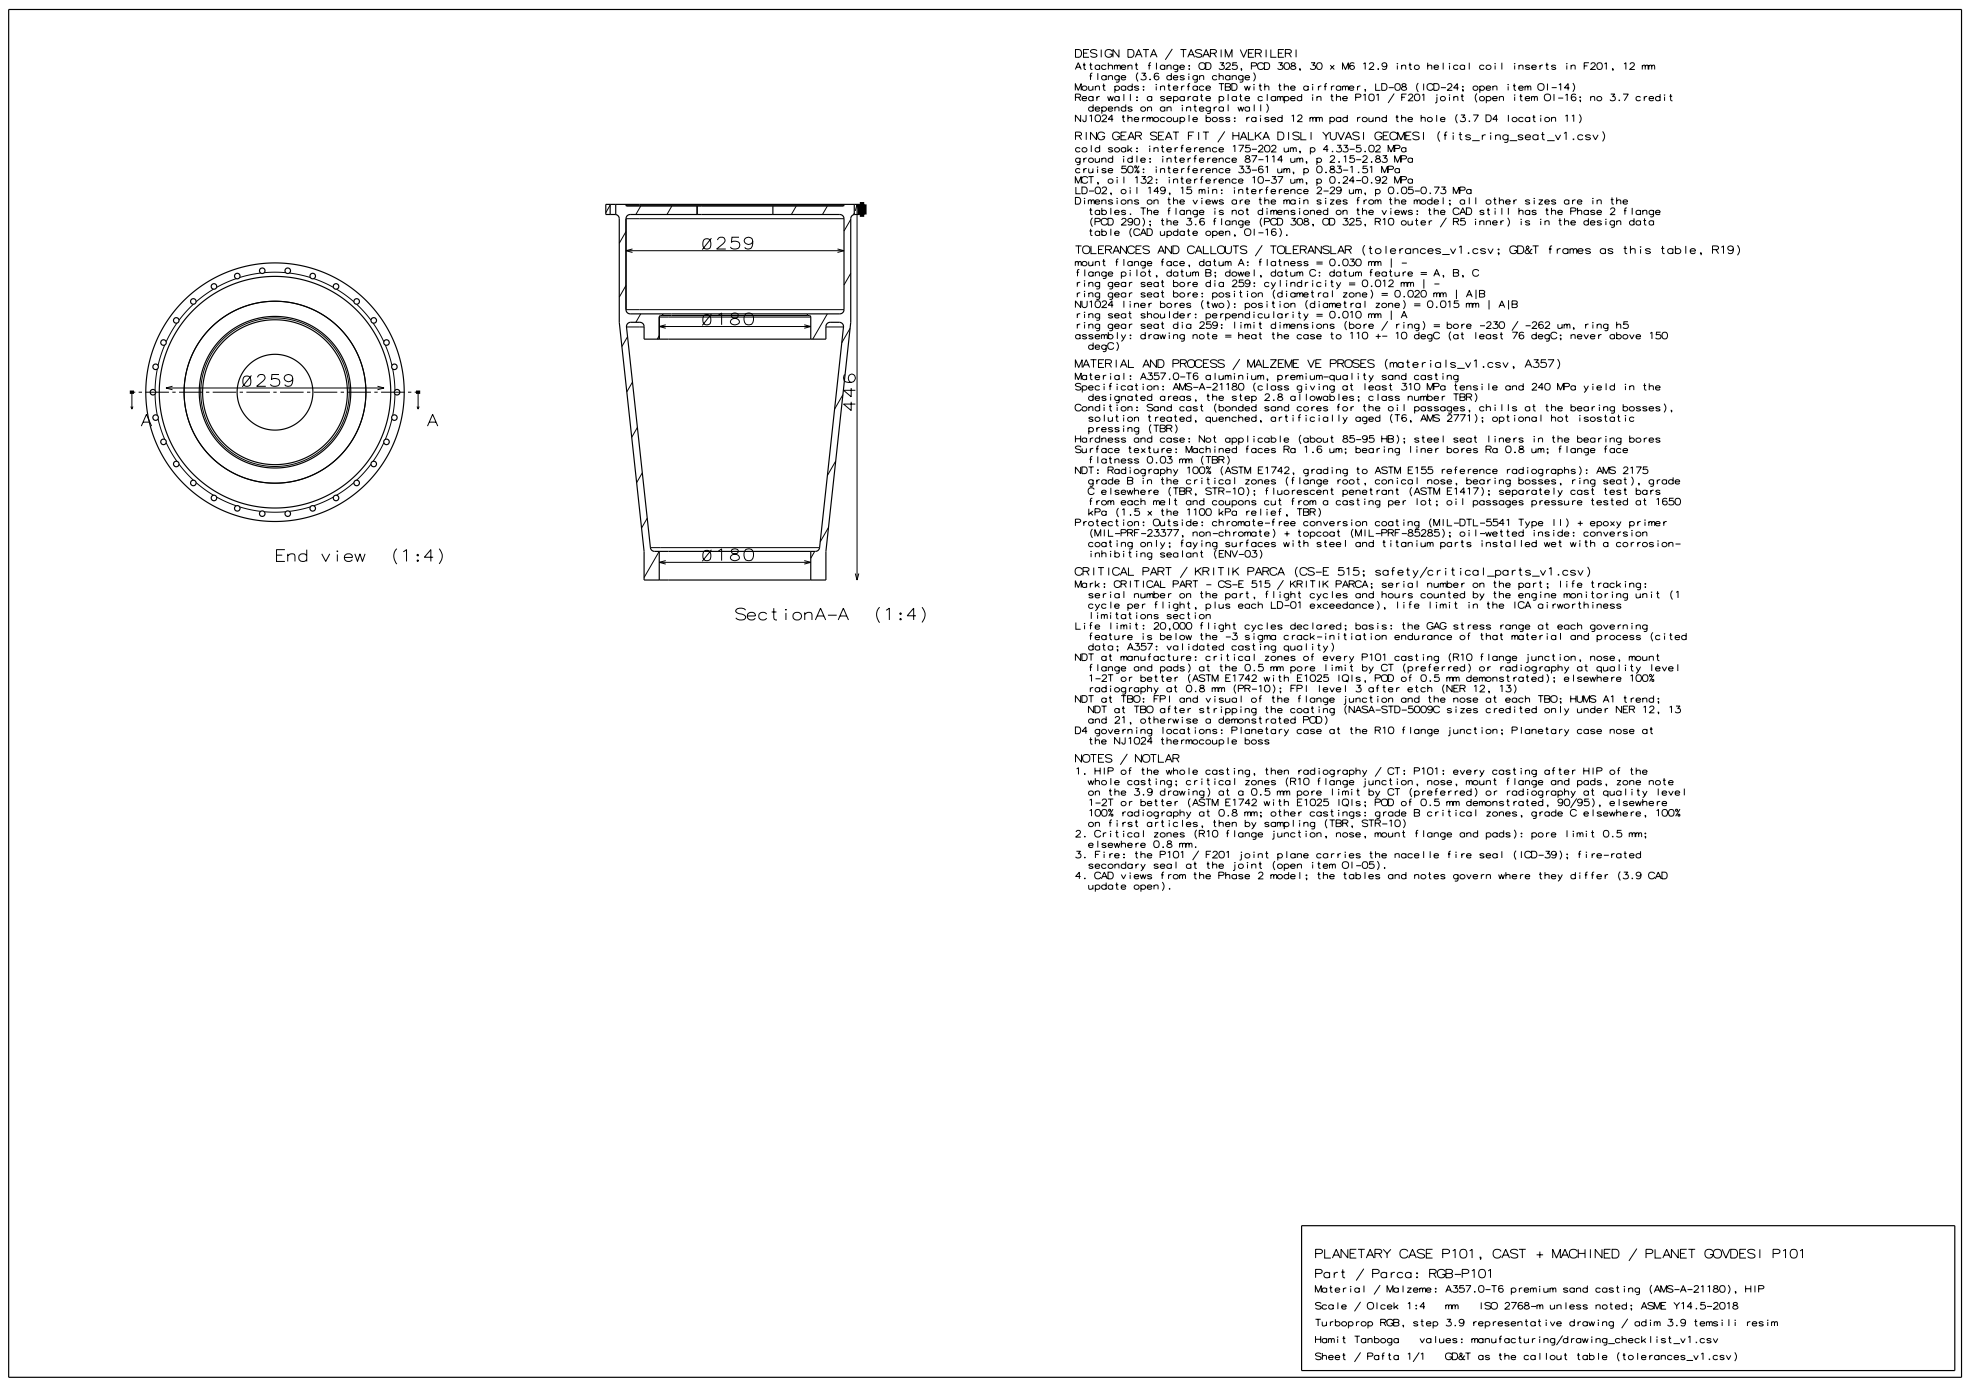
[picture p281: page 1]
