tanboga20/turboprop-from-turboshaft/cad/drawings/gear2.pdf

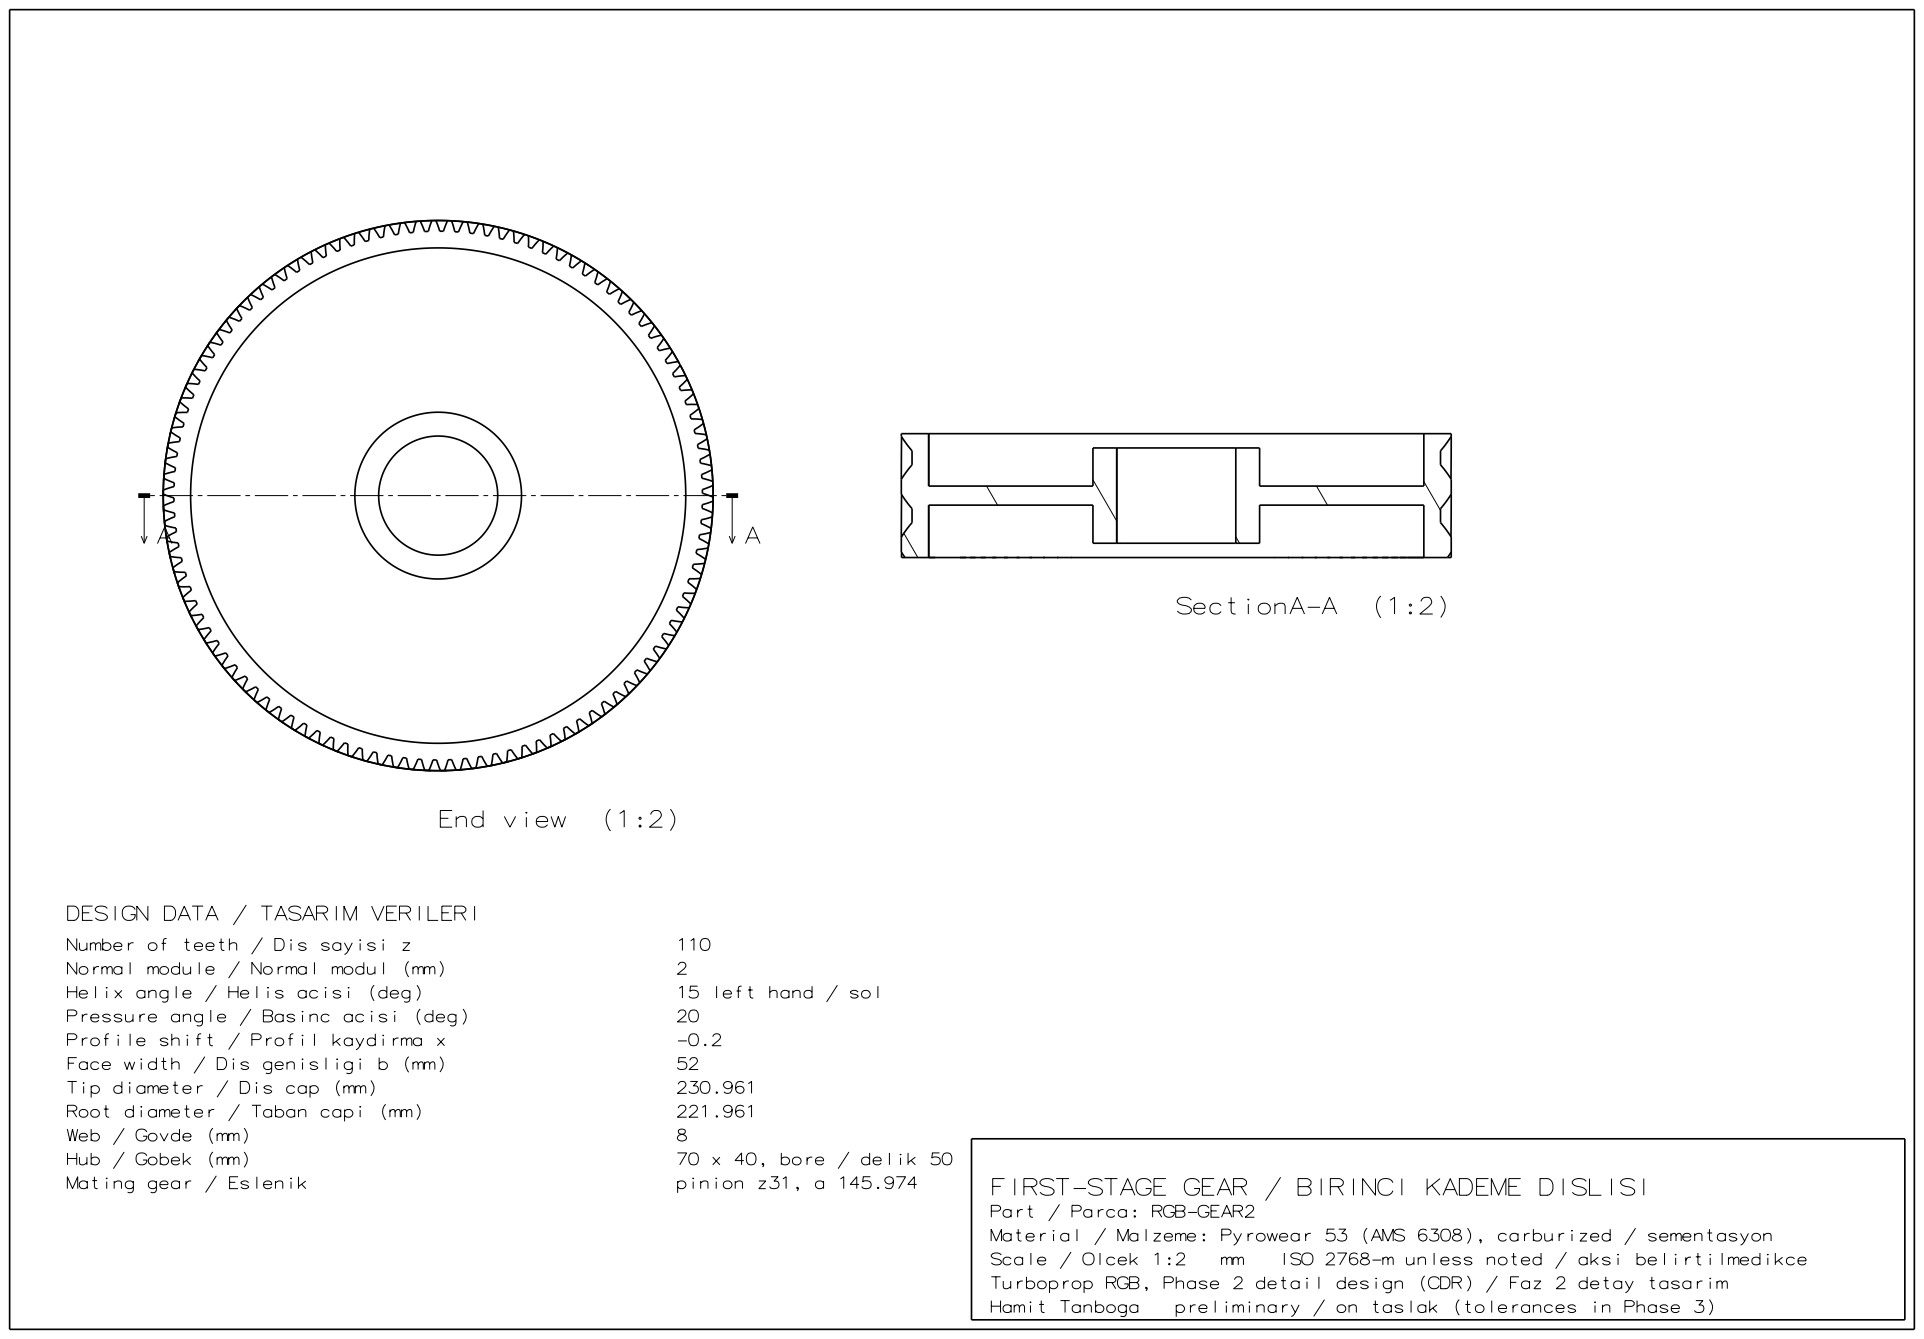
[picture p282: page 1]
