tanboga20/turboprop-from-turboshaft/cad/drawings/planet.pdf

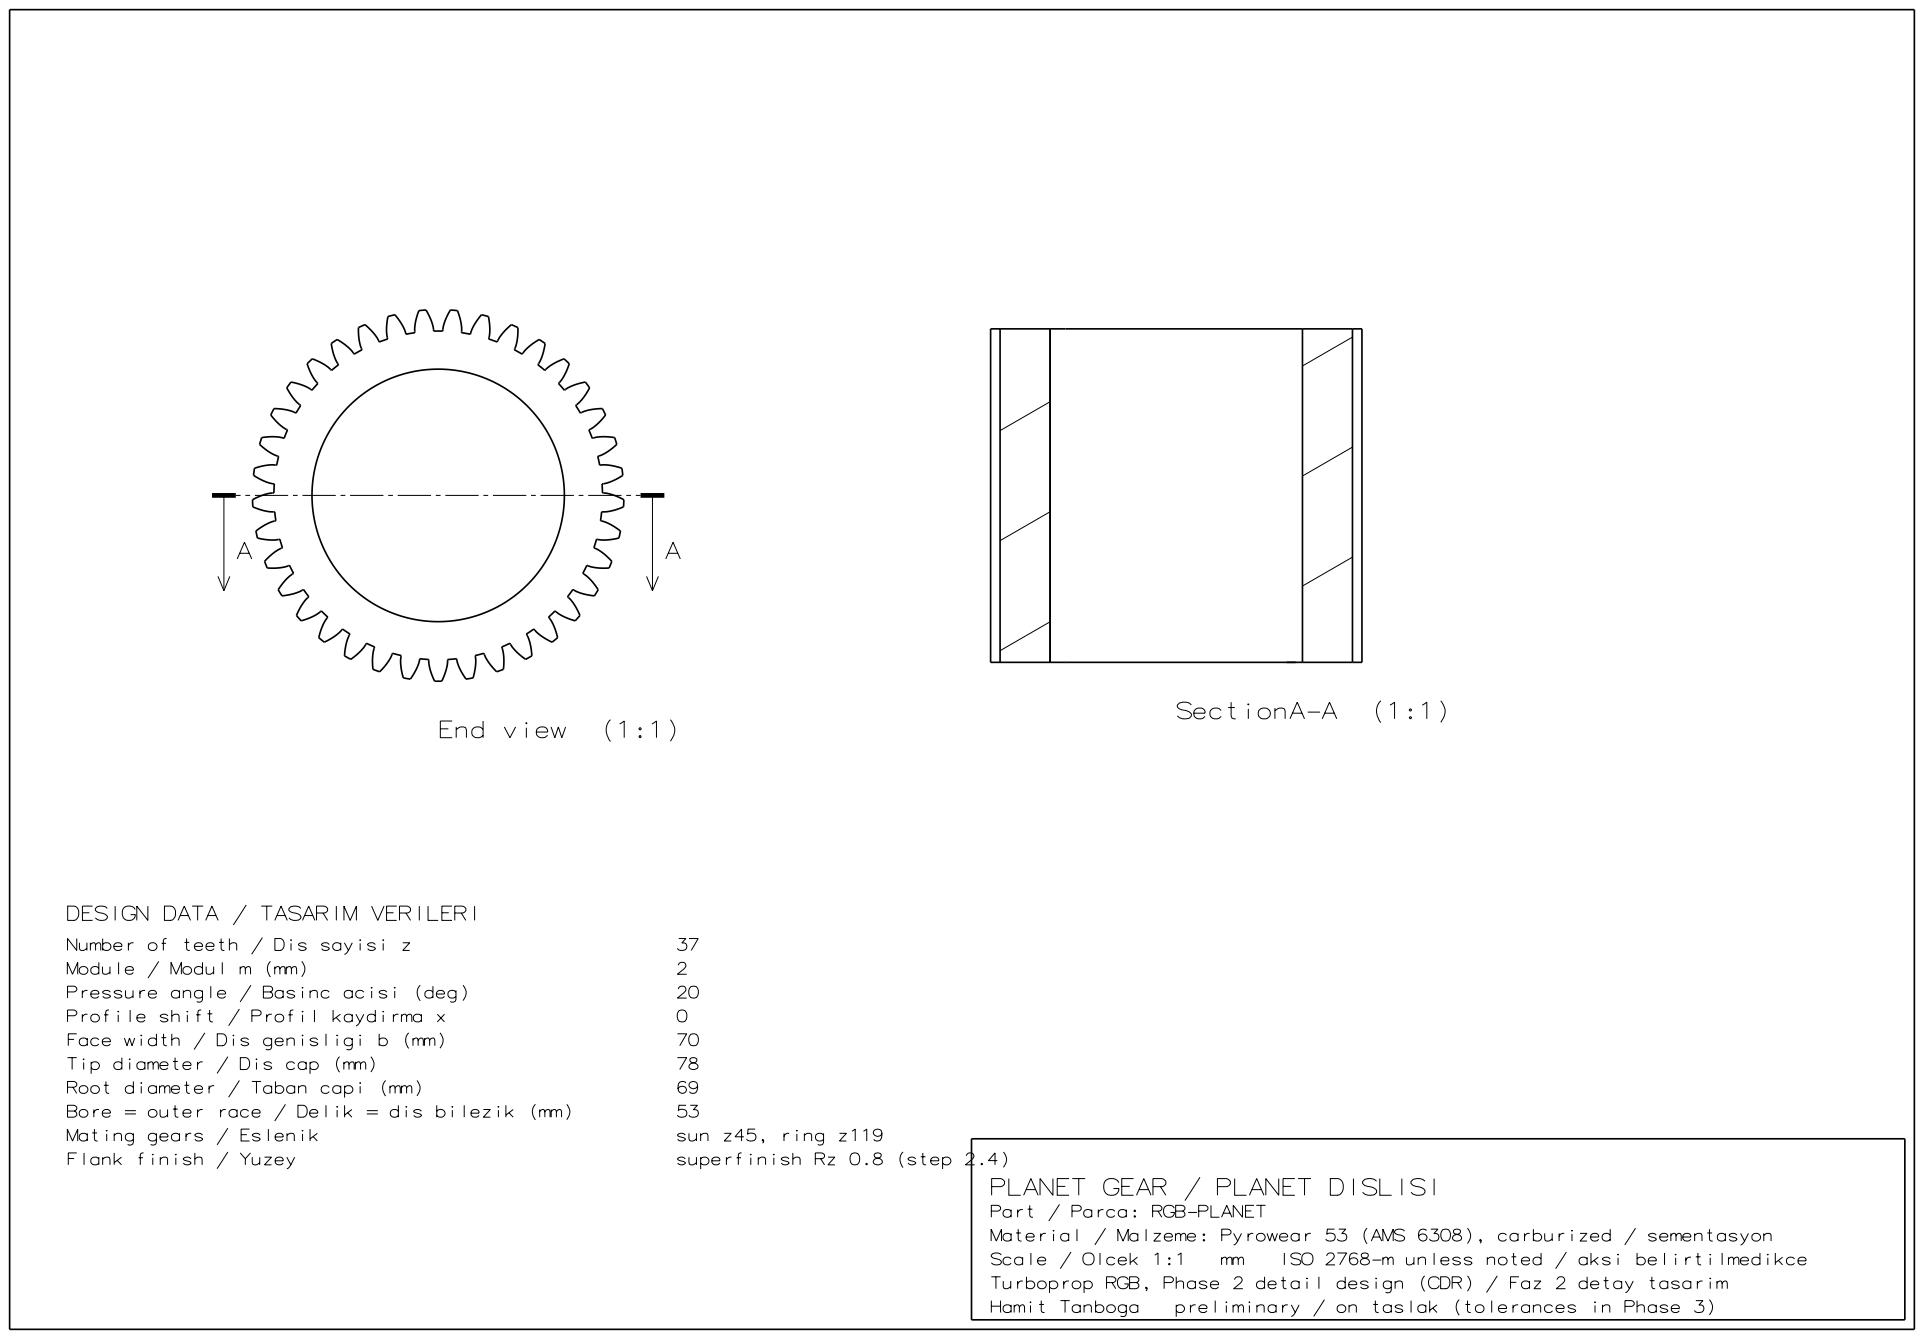
[picture p283: page 1]
