tanboga20/turboprop-from-turboshaft/cad/drawings/planet_39.pdf

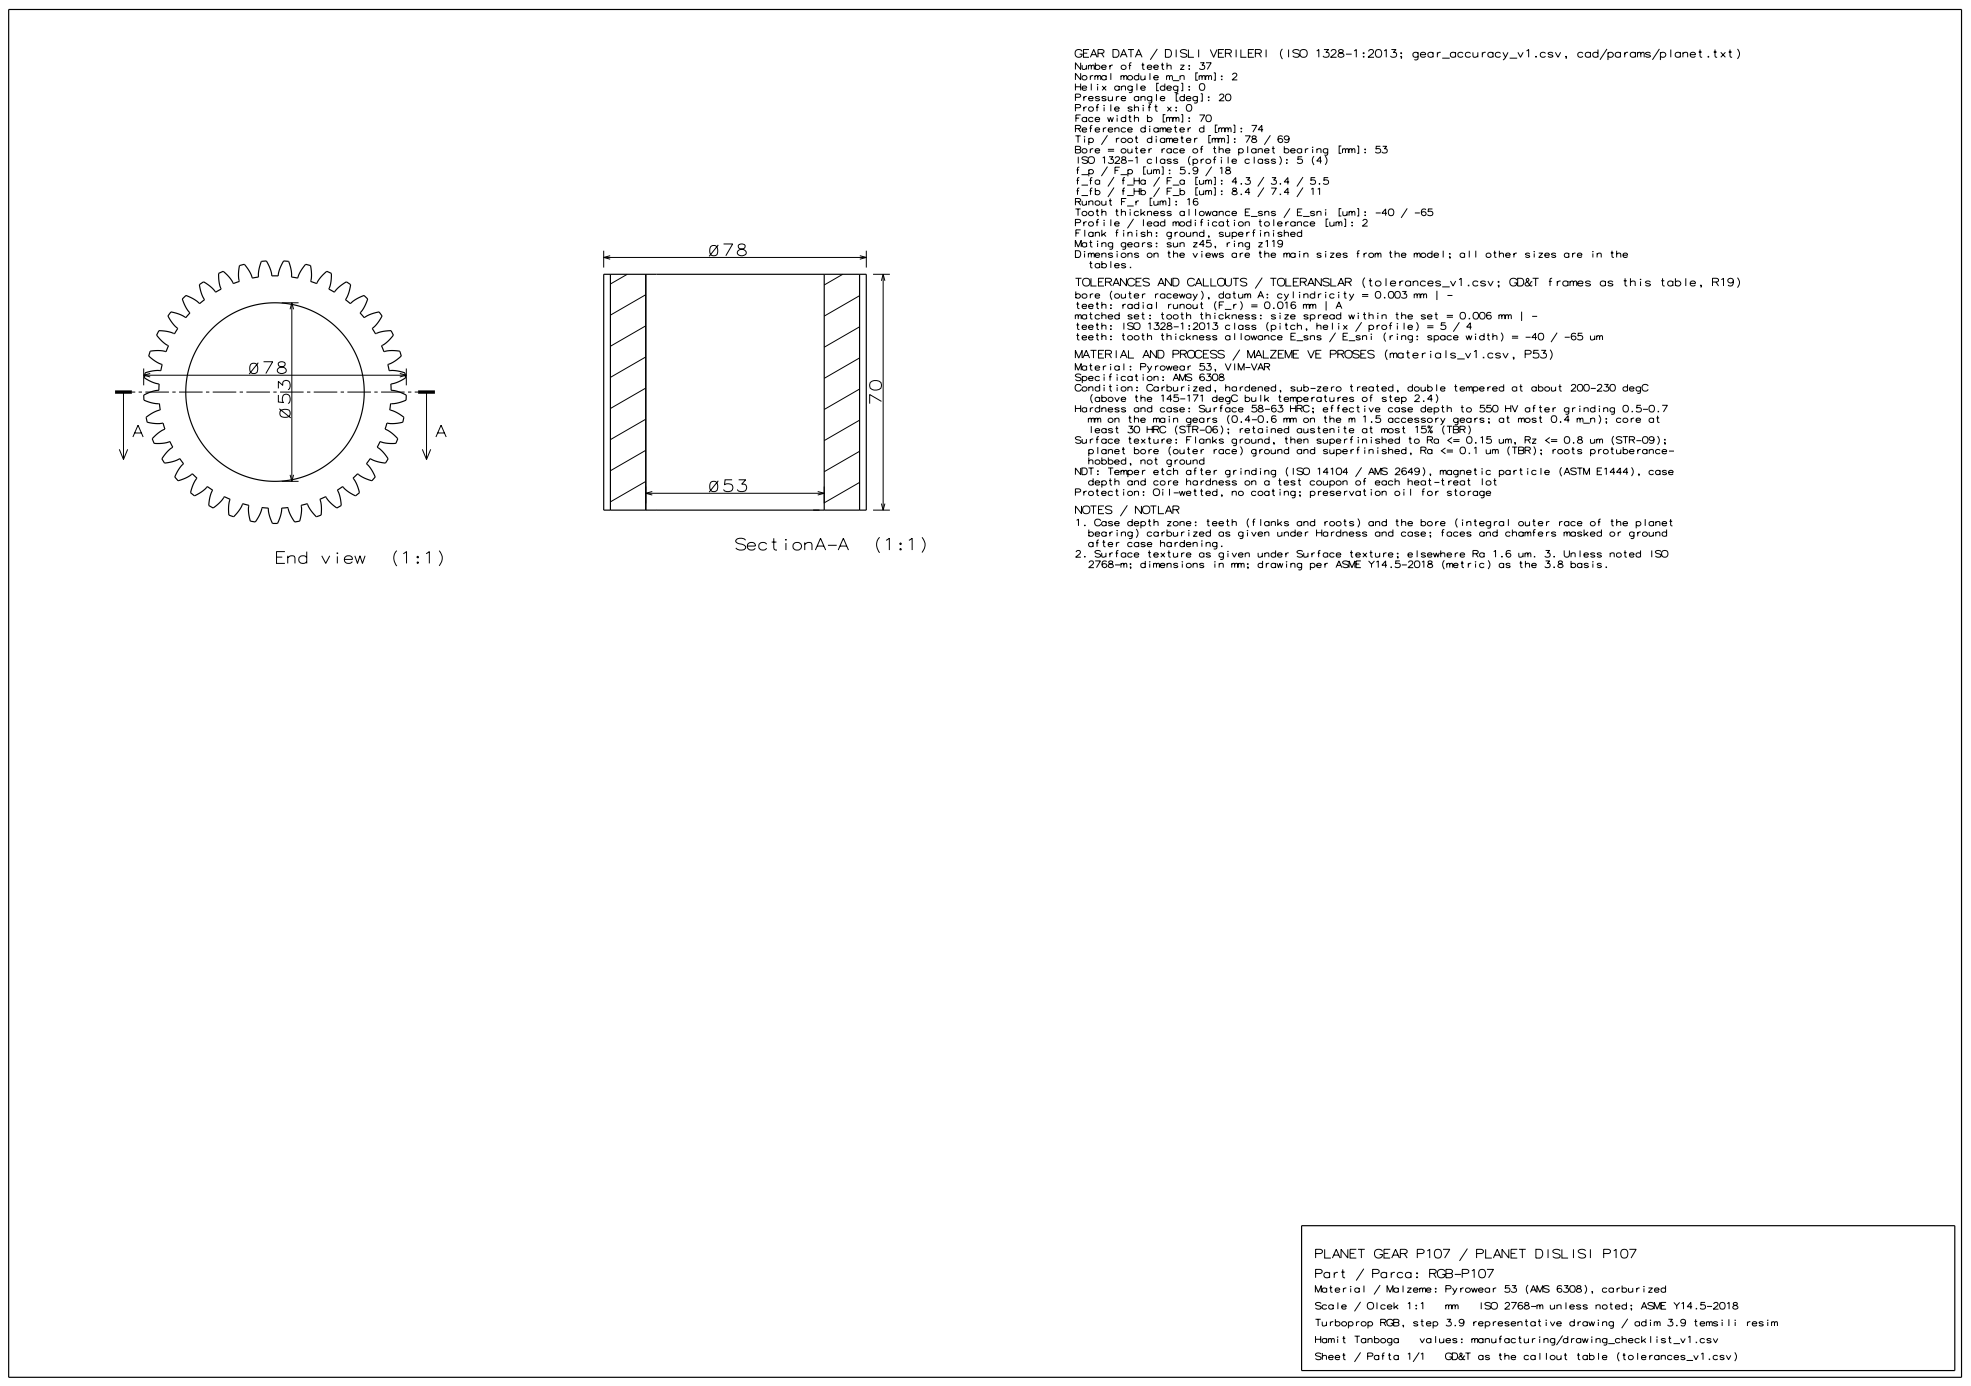
[picture p284: page 1]
