tanboga20/turboprop-from-turboshaft/cad/drawings/ring.pdf

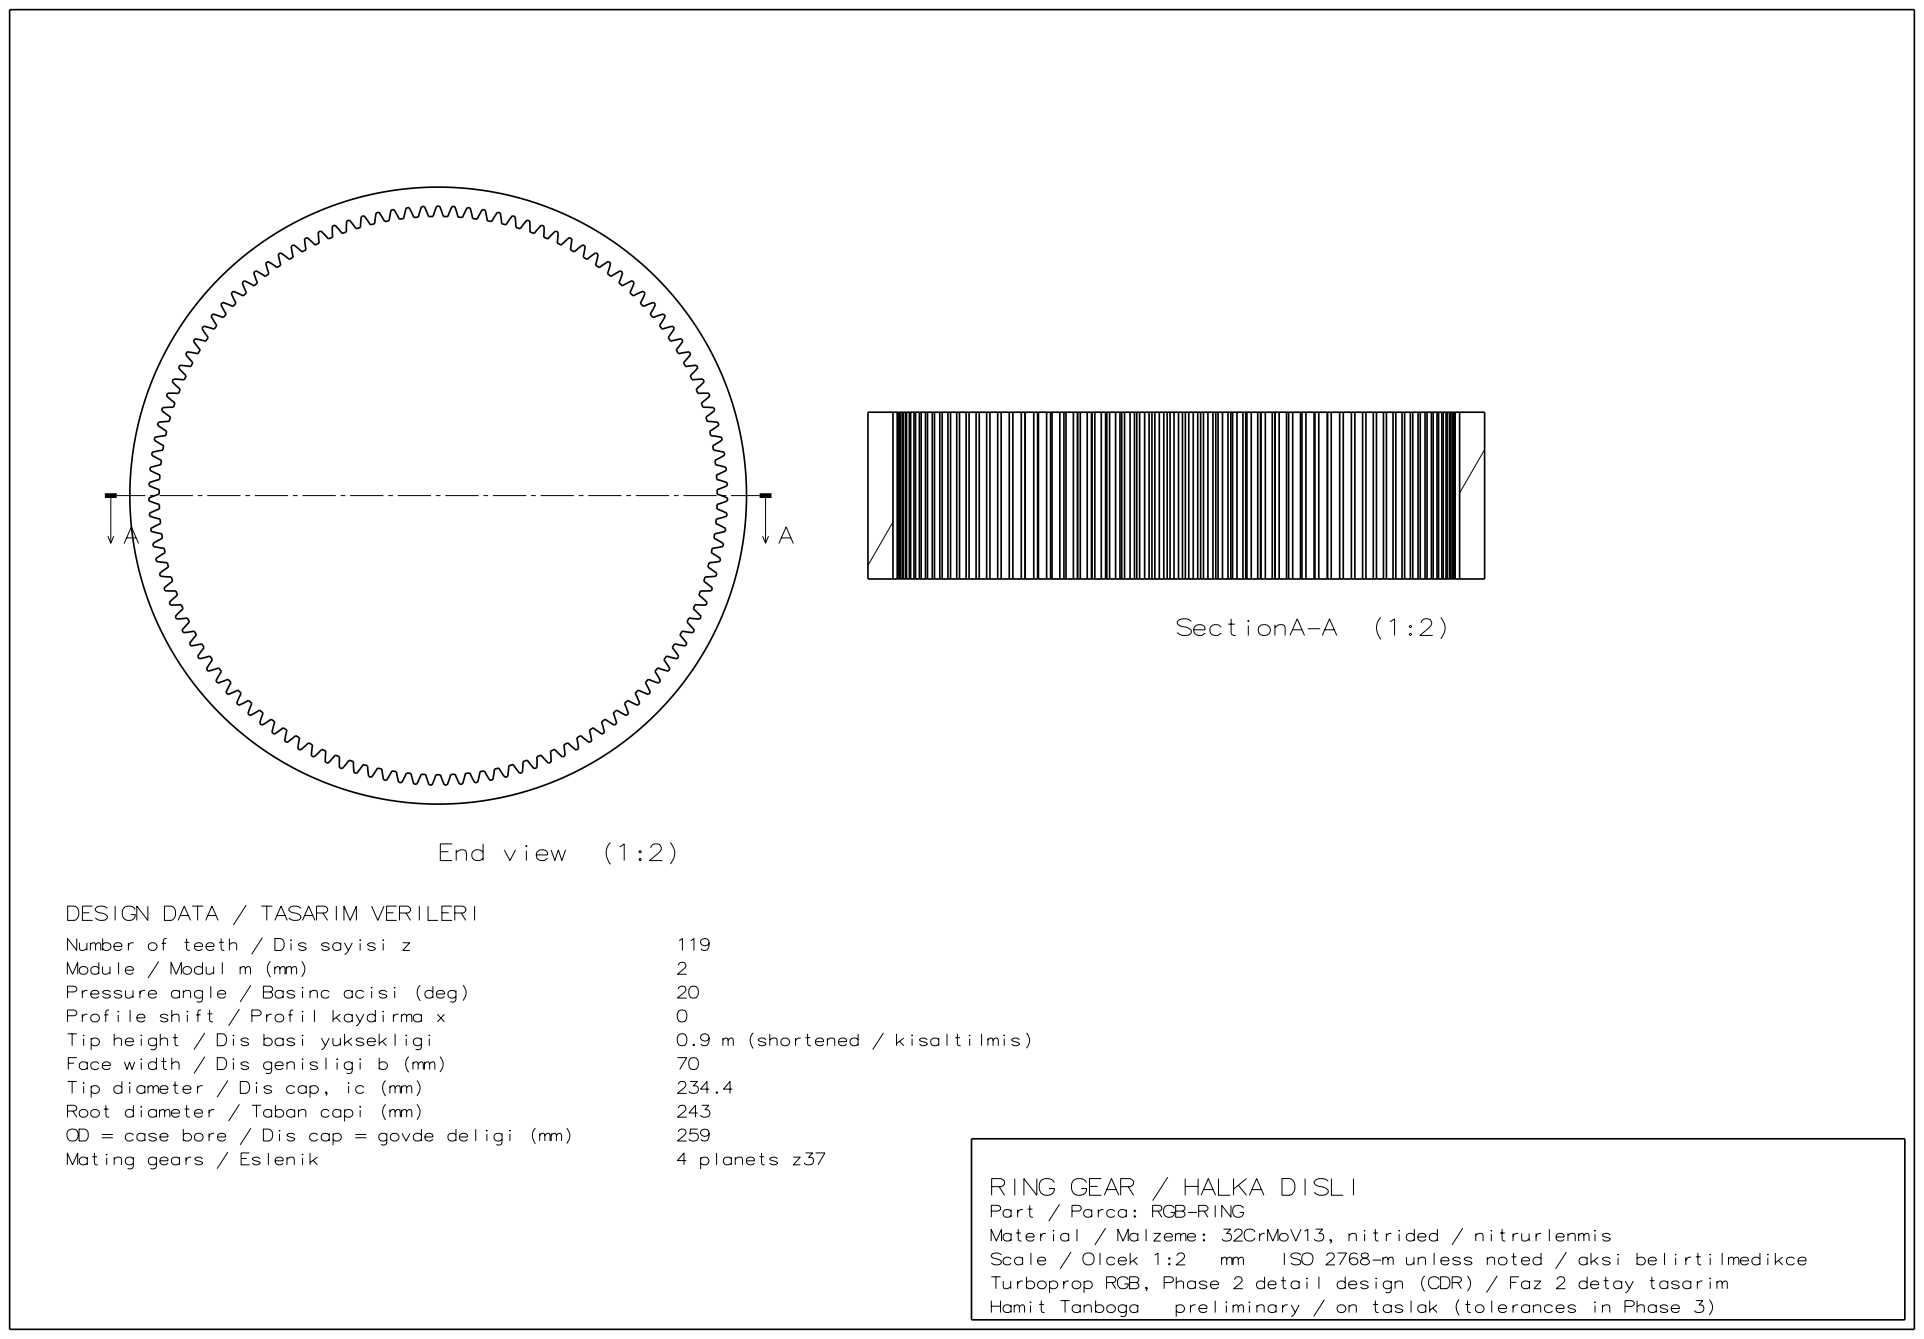
[picture p285: page 1]
