tanboga20/turboprop-from-turboshaft/cad/drawings/sun.pdf

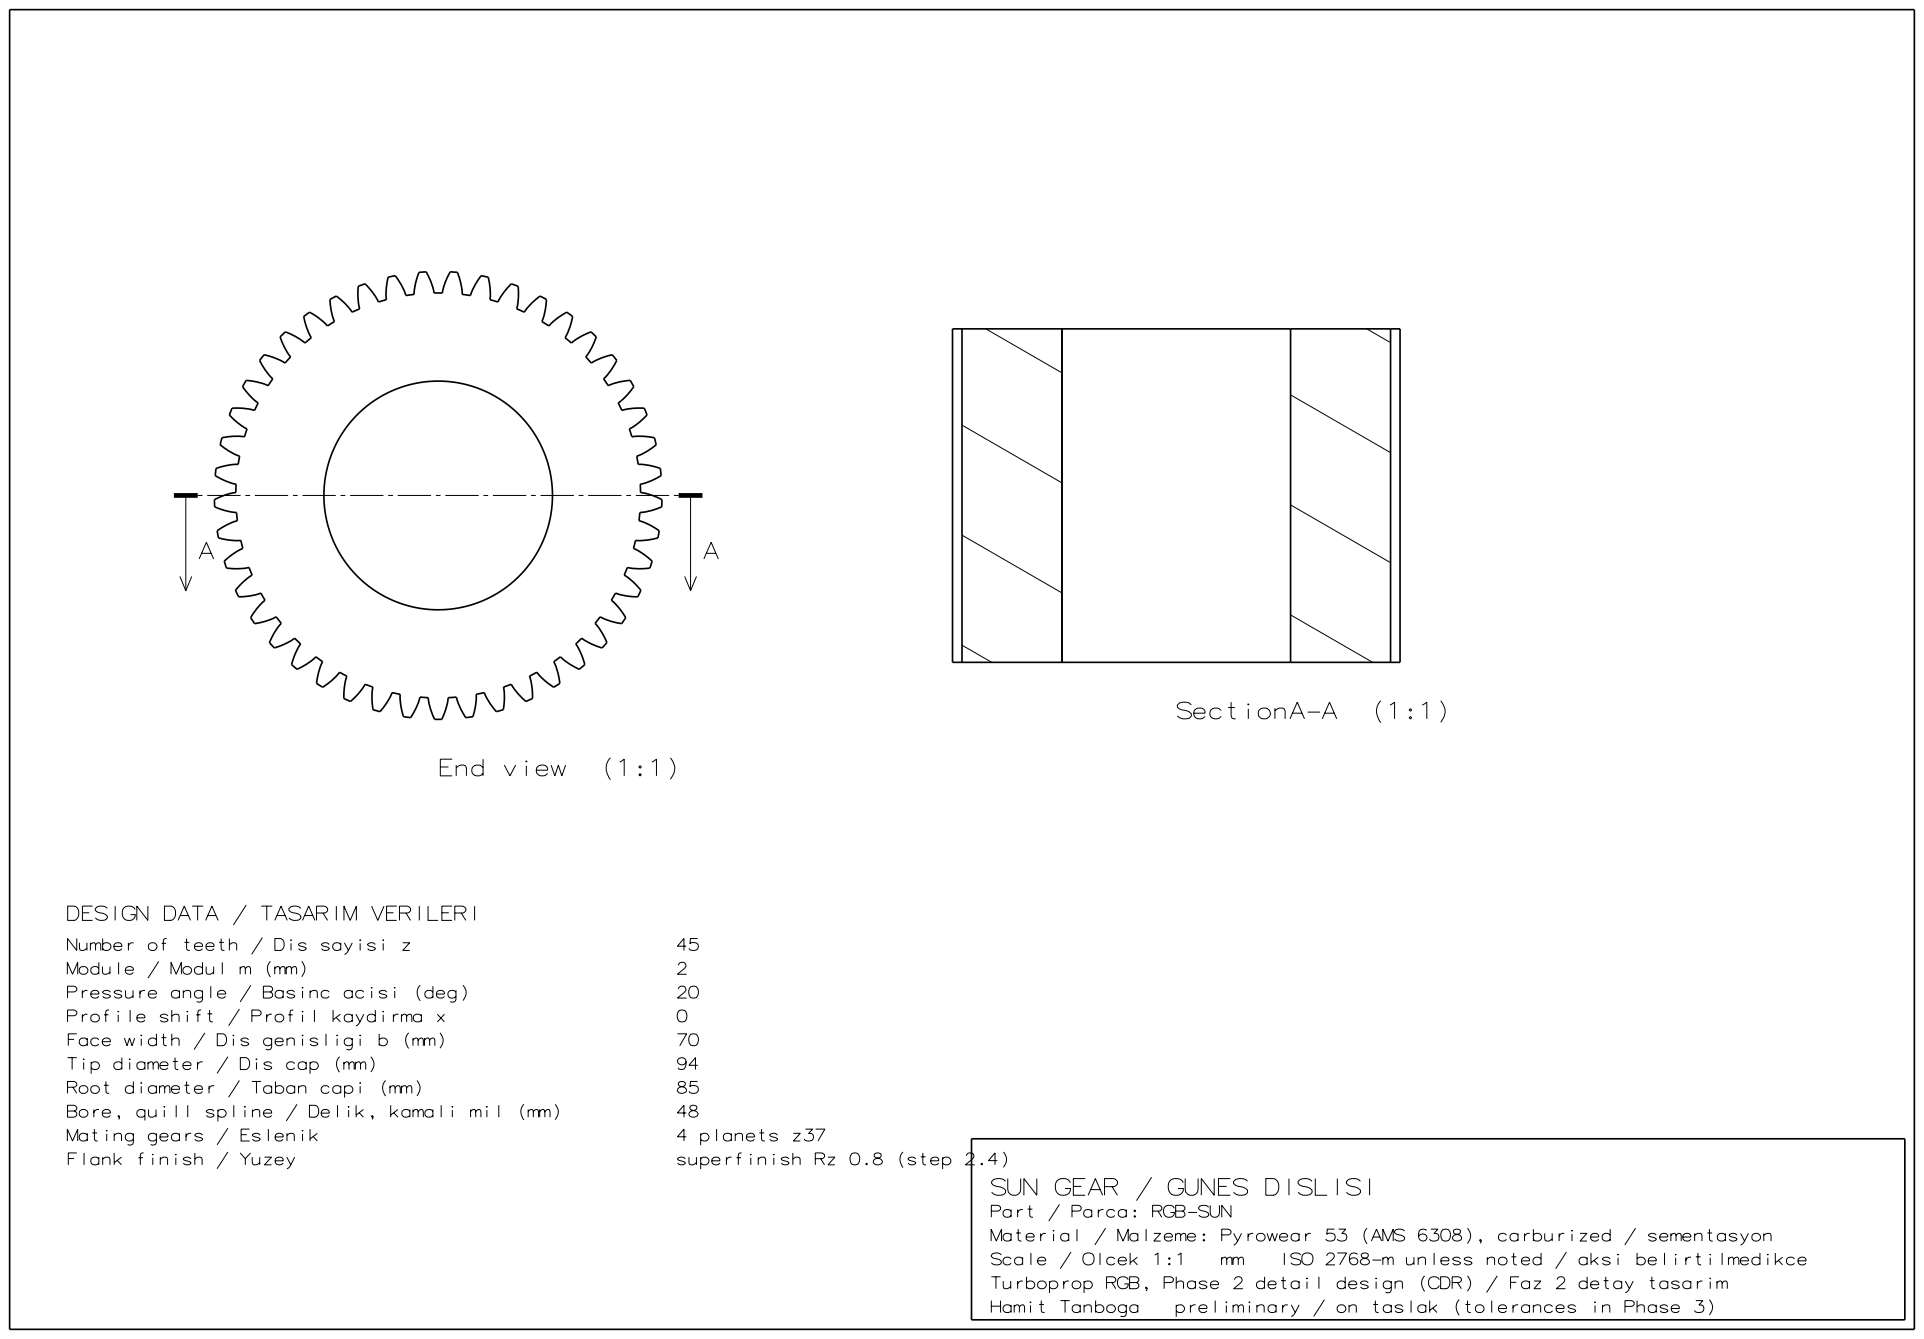
[picture p286: page 1]
