tanboga20/turboprop-from-turboshaft/maintenance/hums_thresholds_v1.csv

indicator | definition_en | definition_tr | target_fault | base_mean | base_sd | caution | alarm | crack_a_caution | crack_a_alarm | spall_b_caution | spall_b_alarm | basis
FM4 | kurtosis of the TSA difference signal (TSA minus shaft orders 1-2, mesh harmonics and their first sidebands) | TSA fark sinyalinin basıklığı (TSA eksi mil mertebeleri 1-2, kavrama harmonikleri ve ilk yan bantları) | sun tooth crack | 2.981 | 0.158 | 3.504 | 3.826 | 0.05 | 0.05 |  |  | synthetic baseline (calc/hums/run_step310, 50 records); replaced by the engine test baselines of 3.11 per torque and speed bin (TBR)
NA4 | kurtosis of the TSA residual signal (TSA minus shaft orders 1-2 and mesh harmonics), normalised by the baseline residual variance | TSA artık sinyalinin basıklığı (TSA eksi mil mertebeleri 1-2 ve kavrama harmonikleri), temel artık varyansıyla normalize | sun tooth crack, planet bore spall | 3.014 | 0.359 | 4.292 | 5.211 | 0.05 | 0.05 | 1.00 | 2.00 | synthetic baseline (calc/hums/run_step310, 50 records); replaced by the engine test baselines of 3.11 per torque and speed bin (TBR)
SER | sum of the TSA amplitudes at mesh order 45 +- 1..6 over the TSA rms | kavrama mertebesi 45 +- 1..6 TSA genliklerinin toplamı bölü TSA rms | sun tooth crack | 6.970 | 3.028 | 21.917 | 42.403 | 0.20 |  | 4.00 |  | synthetic baseline (calc/hums/run_step310, 50 records); replaced by the engine test baselines of 3.11 per torque and speed bin (TBR)
ENV | envelope spectrum (7.4-9.4 kHz band) line at the planet bore defect frequency over the local median | zarf spektrumunda (7,4-9,4 kHz bandı) planet iç bilezik hata frekansındaki çizgi bölü yerel medyan | planet bore spall | 2.533 | 0.369 | 3.886 | 4.920 |  |  | 0.25 | 0.50 | synthetic baseline (calc/hums/run_step310, 50 records); replaced by the engine test baselines of 3.11 per torque and speed bin (TBR)
